tepmehatop/Lathe-cnc-controller-stm32/src/README.md

# src

Точка входа прошивки STM32 — `setup()` и `loop()` в `Core/e2/e2_core.cpp`
(основной скетч 7e2). Состав сборки задан в `platformio.ini` (`build_src_filter`).
