tepmehatop/Lathe-cnc-controller-stm32/hardware/shield/README.md

# Шилд ELS под STM32F4DISCOVERY

**Rev 2 — компактный, как Shield3.0 под Mega.** Плата 96×126 мм. Discovery вставляется сверху в гнёзда лицом
вверх (USB ST-LINK — к верхнему краю): кнопки, светодиоды и оба USB остаются видны и доступны. Мелочь — SMD 0805
и SOT-23 — под Discovery (зазор ≈ 8 мм), разъёмы — штыревые 2.54 мм с защёлкой (KF2510 / Molex KK-254) по всем
четырём краям (сверху — сброс и резервные), переключатель режимов — коробка IDC 2×5 (подписи M1…M8, как на экране). На шелкографии у мелочи — номинал
(«1k», «10k», «3904»), у разъёмов — назначение каждого вывода. Схемотехника — как у шилда автора 7e2, с поправками
на 3.3-вольтовый STM32 (см. `design.py`).

Плата, вид сверху

## Состояние

| Что | Готово |
|---|---|
| Схема KiCad (`els_shield.kicad_sch`, PDF — `els_shield_schematic.pdf`) | да, ERC — 0 ошибок |
| Список деталей (`bom.md`, `bom.csv`) | да |
| Плата: 96×126 мм, размещение, земля с двух сторон, подписи | да |
| Дорожки | да — KiCad MCP (`autoroute`, Freerouting 2.1.0, GND тоже дорожками), полигоны земли + переходы |
| Проверка | DRC — **0 нарушений, 0 неразведённых**; сверка со схемой — цепи 1:1; поштырьково — [CHECK.md](CHECK.md), 0 замечаний |
| Gerber-файлы для заказа | `els_shield_gerbers.zip` (медь, маска, шелкография с двух сторон, контур, сверловка) |

Перед заказом обязательно:
1. Сверить расстояние между гнёздами J1/J2 с вашей платой Discovery (по чертежу UM1472 — 53.34 мм между
   крайними рядами), лучше всего — распечатать слой F.Cu в масштабе 1:1 и приложить плату.
2. Проверить снизу Discovery: под ней на шилде — SMD-детали высотой до 1.5 мм (C8 1206 — до 1.8 мм).

## Как собрать и развести

Всё генерируется из `design.py` — единого описания деталей и цепей. Цепи выводов STM32 берутся из
`Core/e2/e2_pins.h`, поэтому шилд всегда совпадает с прошивкой.

1. Схема, BOM, размещение (KiCad 10, macOS: `/Applications/KiCad`): `bash hardware/shield/build.sh`.
2. Трассировка — KiCad MCP: `open_project` → `autoroute` (Freerouting 2.1.0 под Java 21; 3–5 попыток, берётся
   лучшая; если какая-то цепь осталась — `autoroute` ещё раз поверх, он доведёт только недостающее).
3. `$KPY hardware/shield/fix_zones.py` — полигоны земли с двух сторон, связность земли, дубликаты и хвосты
   дорожек, заливка (`$KPY` — Python KiCad: `/Applications/KiCad/KiCad.app/Contents/Frameworks/Python.framework/Versions/Current/bin/python3`).
4. MCP `add_gnd_stitching_vias` (сетка 6 мм) → `save_board` → `fix_zones.py` ещё раз (переходы с малым зазором
   и на выводах разъёмов — прочь).
5. `$KPY hardware/shield/widen_power.py` — дорожки +5V до 1.0 мм там, где позволяет DRC.
   Затем `$KPY hardware/shield/fix_holes.py` — у крепёжных отверстий только земля (ручная перекладка трёх дорожек,
   см. «Что проверено»); после новой трассировки координаты в нём нужно сверить заново.
6. Проверка: MCP `run_drc` (и со сверкой схемы), `$KPY hardware/shield/verify.py` → CHECK.md; файлы —
   MCP `export_gerbers` + `export_drill` в `gerbers/`, архив `els_shield_gerbers.zip`.

Размещение генерируется заново из `design.py` — после него трассировку нужно повторить.

**Разъёмы верхнего края (J24–J27) добавлены 2026-11-12 в уже разведённую плату, старая разводка не менялась:**
`$KPY add_reserve.py` (детали и подписи из `design.py`) → `$KPY route_reserve.py prep <снимок платы до добавления>`
(старые дорожки закреплены, полигоны сняты, `build/res2.dsn`) → Freerouting 2.1
(`java -jar freerouting.jar -de build/res2.dsn -do build/res2.ses -mp 100 -mt 1`) → `$KPY merge_ses.py build/res2.ses`
(в плату — только новые дорожки, без земли) → `$KPY fix_reserve.py`, `route_grid.py` + `add_path.py` (что Freerouting
не довёл), `$KPY fix_reserve2.py`, `$KPY fix_silk_top.py`. Новые цепи — класс Reserve (дорожка 0.2 мм, переход 0.6/0.3).
При полной перегенерации платы из `design.py` эти шаги нужно повторить заново.

## Что проверено и что знать при сборке

Резервные разъёмы (2026-11-12): исходные 1425 дорожек и переходов на месте (сверка по геометрии со снимком до
добавления), ни одна старая деталь не сдвинута, у старых площадок цепь появилась только у 6 ранее пустых выводов J1;
новые цепи прослежены от площадки до площадки; DRC — 0 нарушений, 0 неразведённых; ERC — 0; сверка со схемой — без
цепи только неиспользуемые выводы Discovery; CHECK.md — 0 замечаний. PD12 и PD14 не выведены: внутренний ряд P1, путь
к ним — около 150 мм с 9–10 переходами через плотную середину платы.

Проверено вручную перед заказом (2026-11-12), по первоисточникам — не по отчётам скриптов:
- Гнёзда J1/J2 — по рис. 10 UM1472: все 100 выводов P1/P2 по именам, 53.34 мм между крайними рядами, ряды выровнены,
  нечётные выводы — левый столбец, Discovery лицом вверх без зеркаления.
- Каждый вывод гнёзд → цепь → функция прошивки (e2_pins.h) и логика входов — по коду автора 7e2 (Menu.ino: шаблоны
  Mode/Submode/Joy/Buttons/Limit/Hand) и схеме ELS_V7: совпадает, включая порядок M1…M8 и подрежимов (у автора на
  схеме A13/A15 подписаны наоборот — верно по коду).
- Каждая деталь: номинал, корпус, обе площадки и куда они идут (33 подтяжки, 7 ключей с 1k/10k, 4 × 220, 100, 6 × 470,
  C1–C8, D1 — катод к Discovery). Цоколёвка MMBT3904 SOT-23: 1 Б, 2 Э, 3 К.
- Медь каждой цепи — путь от площадки до каждой другой площадки по дорожкам и переходам: все 87 цепей замкнуты,
  земля — все 50 площадок даже без полигонов. Шелкография — каждая из 87 подписей против своей площадки и цепи.
- Ключ вилки J7 — к краю платы, со стороны ряда 1-3-5-7-9; жила шлейфа N = вывод N = режим M N.
- Механика: разъёмы и вилка J7 не попадают под Discovery (она занимает x 15…81, y 11…108 мм).
- Найдено и исправлено: у отверстия H3 дорожка и переход DRO_RX были в 2.4 мм от центра (под головкой винта —
  металлическая стойка могла замкнуть линию на корпус), у H2 — LED_LEFT_K/LED_RIGHT_K в 3.3–3.9 мм (под шайбой).
  Переложены (fix_holes.py): ближайшая сигнальная медь теперь в 4.8 мм и дальше; рядом с отверстиями — только земля.

Проверено ранее (2026-11-08):
- Каждый контакт каждого разъёма: подпись на плате → медь → деталь → гнездо Discovery → вывод STM32 → функция
  прошивки ([CHECK.md](CHECK.md), из разведённой платы). Все выводы прошивки выведены, лишних нет.
- Таблица гнёзд P1/P2 — по UM1472 (табл. 5): все 81 сигнальный вывод совпадают; геометрия — по рис. 10:
  53.34 мм между крайними рядами, вывод 1 — сверху слева, нечётные — левый столбец.
- Что висит на выводах на самой Discovery (UM1472, схемы): PA4, PC7, PC10, PC12, PB6 — аудио-ЦАП (держится в
  сбросе, PD4 = 0); PC4 — к микрофону через R49, **не установлен**; PE3 — выбор акселерометра (PA5–PA7 не
  используются); PB9 — подтяжка 4.7 кОм; PA0 — кнопка USER. Мешающих нет.

Знать:
- **Питание.** Блок 5 В — на J3 «ПИТАНИЕ 5В», от 2 А (с дисплеем 10.1" — 3 А). Discovery питается от него через
  диод D1: USB ST-LINK без блока питания питает только Discovery, но не дисплей и не остальное (выводы 5V/3V
  Discovery — не больше 100 мА наружу, UM1472 п. 4.3). +3V шилда — от Discovery: подтяжки и светодиоды — до 60 мА.
- **Светодиоды упоров** — красные, жёлтые или зелёные (от 3.3 В через 220 Ом). Синие и белые светить не будут.
- **Драйверы моторов** — «+» входов на +5 В (контакты PUL+/DIR+/ENA+), «−» — на ключи. В прошивке
  `DRIVER_SIGNALS_DIRECT 0` (по умолчанию).
- **Блок DRO** — выход TTL (как у автора 7e2). Если у блока RS-232 (±12 В) — нужен преобразователь (MAX3232).
- **LCD2004 по I2C** — у модуля свои подтяжки к 5 В; работает, но лучше снять их с модуля (на Discovery есть
  свои к 3 В).
- **Отладочный порт J21:** TX (PA9) на Discovery соединён с VBUS micro-USB и конденсатором 4.7 мкФ (C49) —
  передача от STM32 на 115200 не работает, приём (PA10) работает. Для работы станка порт не нужен.
- **Пайка земли:** выводы GND разъёмов подключены к полигонам сплошь — паяльник от 40 Вт.

## Что на плате

Схемы подключения каждого разъёма (провод → клемма модуля), список покупок и порядок пайки —
[docs/assembly](../../docs/assembly/README.md).

| Разъём | Что подключать |
|---|---|
| J3 ПИТАНИЕ 5В | блок питания 5 В (от 2 А, с дисплеем 10.1" — 3 А) — питает всё; Discovery — через диод D1 |
| J4 ЭНКОДЕР | энкодер шпинделя: +5 В, GND, A, B (подтяжка 1k к 3V и 1 нФ — на плате) |
| J5 / J6 ДРАЙВЕР Z / X | входы драйверов PUL±, DIR±, ENA± (NPN-ключи 2N3904 на плате) |
| J7 РЕЖИМ | галетный переключатель 8 положений: вывод N коробки IDC 2×5 — режим M N (1 = M1 … 8 = M8), 9 и 10 — общий GND |
| J8 ПОДРЕЖИМ | Внутренний / Ручной / Наружный, общий — GND |
| J9 КНОПКИ | Влево, Вправо, Вверх, Вниз, Выбор, общий — GND |
| J10 ДЖОЙСТИК | 4 направления + ускоренный ход, общий — GND |
| J11 УПОРЫ, J12 СВЕТОДИОДЫ | кнопки упоров; светодиоды — анод на +3V, катод на клемму (220 Ом на плате) |
| J13 РГИ, J14 РГИ ПЕРЕКЛ. | маховичок (+5 В, GND, A, B; 10 нФ на плате) и переключатели оси и масштаба |
| J15 ЗУММЕР | активный зуммер 5 В: «+» на +5V, «−» на клемму «−» |
| J16 ТАХОМЕТР | выход импульса на оборот (3.3 В через 100 Ом) |
| J17 ПОДАЧА | переменный резистор 10k: крайние — +3V и GND, средний — СР |
| J18 LCD2004 | I2C-модуль LCD: GND, +5V, SDA, SCL |
| J19 ДИСПЛЕЙ | сенсорный дисплей ESP32: GND, +5V, TX (к RX дисплея), RX (к TX дисплея) |
| J20 DRO | блок DRO HS800-2: GND, RX (к TX блока) |
| J21 ОТЛАДКА | USB-UART для монитора порта: GND, TX, RX |
| J22 / J23 ЛИНЕЙКА Z / X | линейки напрямую: +5V, GND, A, B, REQ (470 Ом последовательно); схемы сопряжения — `docs/scales` |
| J24 СБРОС | кнопка сброса на панель: RST (NRST, P1-6) и GND — параллельно RESET Discovery. Не на аварийный «грибок» |
| J25 ДАТЧИК (РЕЗЕРВ) | на будущее — щуп / датчик привязки: +5V, GND, ВХ (PA2, подтяжка 1k к 3V и 10 нФ). Прошивка пока не использует |
| J26 РЕЗЕРВ ВЫХОДЫ PD13 PD15 | +5V, GND, D13, D15 — выходы 3.3 В через 220 Ом (модули реле); на Discovery — LD3, LD6 |
| J27 РЕЗЕРВ PA5 PA7 | +3V, GND, A5, A7 — вход/выход через 470 Ом (АЦП; на PA5 — ЦАП) |

Настройки прошивки под этот шилд — значения по умолчанию в `Core/els_config.h`:
`DRIVER_SIGNALS_DIRECT 0`, `BEEPER_ON_LEVEL 1`.

## Особенности

- Под гнёзда J1/J2 взято посадочное место **штыревого** разъёма 2×25: у гнезда из библиотеки KiCad ряды
  зеркальные (вывод 2 слева от вывода 1), а Discovery вставляется лицом вверх, и её вывод 2 справа.
  Паяется обычное гнездо 2×25.
- Вывод PD4 (сброс аудиочипа платы) наружу не выводится. PA2 — вход датчика J25: блок DRO читается только на
  приём, прошивка после запуска USART2 возвращает PA2 во вход (`Drivers/drv_dro.cpp`).
- Синяя кнопка USER на Discovery сидит на том же PA0, что «Упор задний», но упор она не ставит: USER подаёт на
  PA0 «1» (через 330 Ом к 3 В), а кнопка упора срабатывает от «0». Нажатие USER ничего не делает и ничему не мешает.
