tepmehatop/Lathe-cnc-controller-stm32/hardware/shield/CHECK.md

# Проверка шилда по контактам

Сгенерировано `verify.py` из разведённой платы `els_shield.kicad_pcb`: подпись — текст шелкографии у контакта,
путь — по меди через детали шилда, вывод Discovery — по таблице UM1472 (табл. 5, рис. 10).

**Замечаний: 0**

## Разъёмы

| Разъём | Конт. | Подпись | Цепь | Через | Discovery | STM32 | Прошивка |
|---|---|---|---|---|---|---|---|
| J3 ПИТАНИЕ 5В | 1 | +5V | +5V | питание / земля |  |  |  |
|  | 2 | GND | GND | питание / земля |  |  |  |
| J4 ЭНКОДЕР | 1 | +5V | +5V | питание / земля |  |  |  |
|  | 2 | GND | GND | питание / земля |  |  |  |
|  | 3 | A | ENC_A | напрямую | P1-11 | PA1 | ENC_A: (21, INT0 + T5/47) канал A — прерывание по обоим фронтам |
|  | 4 | B | ENC_B | напрямую | P2-43 | PA8 | ENC_B: (20) канал B |
| J5 ДРАЙВЕР Z | 1 | PUL+ | +5V | питание / земля |  |  |  |
|  | 2 | PUL- | Z_PUL_N | Q1 (3904) → R2 (1k) | P1-27 | PE9 | Z_STEP: (49) |
|  | 3 | DIR+ | +5V | питание / земля |  |  |  |
|  | 4 | DIR- | Z_DIR_N | Q2 (3904) → R4 (1k) | P1-28 | PE10 | Z_DIR: (43) |
|  | 5 | ENA+ | +5V | питание / земля |  |  |  |
|  | 6 | ENA- | Z_ENA_N | Q3 (3904) → R6 (1k) | P1-29 | PE11 | Z_ENA: (45) |
| J6 ДРАЙВЕР X | 1 | PUL+ | +5V | питание / земля |  |  |  |
|  | 2 | PUL- | X_PUL_N | Q4 (3904) → R8 (1k) | P1-31 | PE13 | X_STEP: (48) |
|  | 3 | DIR+ | +5V | питание / земля |  |  |  |
|  | 4 | DIR- | X_DIR_N | Q5 (3904) → R10 (1k) | P1-32 | PE14 | X_DIR: (44) |
|  | 5 | ENA+ | +5V | питание / земля |  |  |  |
|  | 6 | ENA- | X_ENA_N | Q6 (3904) → R12 (1k) | P1-33 | PE15 | X_ENA: (46) |
| J7 РЕЖИМ | 1 | M1 | MODE_FEED | напрямую | P2-36 | PD0 | MODE_FEED: (30) Синхронная подача |
|  | 2 | M2 | MODE_AFEED | напрямую | P2-33 | PD1 | MODE_AFEED: (31) Асинхронная подача |
|  | 3 | M3 | MODE_THREAD | напрямую | P2-30 | PD6 | MODE_THREAD: (34) Резьба |
|  | 4 | M4 | MODE_CONE_L | напрямую | P2-34 | PD2 | MODE_CONE_L: (32) Конус < |
|  | 5 | M5 | MODE_CONE_R | напрямую | P2-31 | PD3 | MODE_CONE_R: (33) Конус > |
|  | 6 | M6 | MODE_SPHERE | напрямую | P2-27 | PD7 | MODE_SPHERE: (35) Шар |
|  | 7 | M7 | MODE_DIVIDER | напрямую | P1-42 | PD10 | MODE_DIVIDER: (36) Делилка |
|  | 8 | M8 | MODE_RESERVE | напрямую | P1-43 | PD11 | MODE_RESERVE: (37) Резерв |
|  | 9 | GND | GND | питание / земля |  |  |  |
|  | 10 | GND | GND | питание / земля |  |  |  |
| J8 ПОДРЕЖИМ | 1 | ВНУТ | SUB_INT | напрямую | P2-45 | PC8 | SUB_INT: (A13) Внутренний |
|  | 2 | РУЧ | SUB_MAN | напрямую | P2-46 | PC9 | SUB_MAN: (A14) Ручной |
|  | 3 | НАР | SUB_EXT | напрямую | P2-38 | PC11 | SUB_EXT: (A15) Наружный |
|  | 4 | GND | GND | питание / земля |  |  |  |
| J9 КНОПКИ | 1 | ЛЕВ | BTN_LEFT | напрямую | P1-37 | PB13 | BTN_LEFT: (A0) |
|  | 2 | ПРАВ | BTN_RIGHT | напрямую | P1-38 | PB14 | BTN_RIGHT: (A1) |
|  | 3 | ВВЕРХ | BTN_UP | напрямую | P1-36 | PB12 | BTN_UP: (A2) |
|  | 4 | ВНИЗ | BTN_DOWN | напрямую | P1-41 | PD9 | BTN_DOWN: (A3) |
|  | 5 | ВЫБ | BTN_SELECT | напрямую | P1-39 | PB15 | BTN_SELECT: (A4) |
|  | 6 | GND | GND | питание / земля |  |  |  |
| J10 ДЖОЙСТИК | 1 | ЛЕВ | JOY_LEFT | напрямую | P1-22 | PB0 | JOY_LEFT: (A8) |
|  | 2 | ПРАВ | JOY_RIGHT | напрямую | P1-21 | PB1 | JOY_RIGHT: (A9) |
|  | 3 | ВВЕРХ | JOY_UP | напрямую | P2-16 | PE3 | JOY_UP: (A10) не PB2: это BOOT1, на плате стянут к GND — читался «нажат» |
|  | 4 | ВНИЗ | JOY_DOWN | напрямую | P2-20 | PB9 | JOY_DOWN: (A11) на плате подтяжка 4.7 кОм к 3.3 В — не мешает |
|  | 5 | БЫСТР | JOY_RAPID | напрямую | P2-19 | PB8 | JOY_RAPID: (A12) кнопка ускоренного хода |
|  | 6 | GND | GND | питание / земля |  |  |  |
| J11 УПОРЫ | 1 | ЛЕВ | LIM_LEFT | напрямую | P1-19 | PC5 | LIM_LEFT: (28) |
|  | 2 | ПРАВ | LIM_RIGHT | напрямую | P1-20 | PC4 | LIM_RIGHT: (26) |
|  | 3 | ПЕРЕД | LIM_FRONT | напрямую | P1-10 | PC2 | LIM_FRONT: (24) |
|  | 4 | ЗАД | LIM_REAR | напрямую | P1-12 | PA0 | LIM_REAR: (22) на плате — кнопка USER с RC-фильтром: для кнопки упора годится |
|  | 5 | GND | GND | питание / земля |  |  |  |
| J12 СВЕТОДИОДЫ | 1 | +3V | +3V | питание / земля |  |  |  |
|  | 2 | ЛЕВ | LED_LEFT_K | R16 (220) | P2-11 | PE6 | LED_LEFT: (29) светодиод горит при низком уровне |
|  | 3 | ПРАВ | LED_RIGHT_K | R17 (220) | P2-14 | PE5 | LED_RIGHT: (27) |
|  | 4 | ПЕРЕД | LED_FRONT_K | R18 (220) | P2-13 | PE4 | LED_FRONT: (25) |
|  | 5 | ЗАД | LED_REAR_K | R19 (220) | P2-15 | PE2 | LED_REAR: (23) |
| J13 РГИ | 1 | +5V | +5V | питание / земля |  |  |  |
|  | 2 | GND | GND | питание / земля |  |  |  |
|  | 3 | A | HAND_A | напрямую | P1-25 | PE7 | HAND_A: (19, INT2) канал A — прерывание по обоим фронтам |
|  | 4 | B | HAND_B | напрямую | P2-12 | PC13 | HAND_B: (18) канал B |
| J14 РГИ ПЕРЕКЛ. | 1 | Z | HAND_AXIS_Z | напрямую | P2-37 | PC10 | HAND_AXIS_Z: (2)  переключатель оси РГИ: Z |
|  | 2 | X | HAND_AXIS_X | напрямую | P2-35 | PC12 | HAND_AXIS_X: (3)  переключатель оси РГИ: X |
|  | 3 | x1 | HAND_X1 | напрямую | P1-16 | PA4 | HAND_X1: (14) масштаб x1 |
|  | 4 | x10 | HAND_X10 | напрямую | P1-40 | PD8 | HAND_X10: (15) масштаб x10 |
|  | 5 | GND | GND | питание / земля |  |  |  |
| J15 ЗУММЕР | 1 | +5V | +5V | питание / земля |  |  |  |
|  | 2 | - | BEEP_N | Q7 (3904) → R14 (1k) | P1-30 | PE12 | BEEPER: (16) зуммер; уровень звука — BEEPER_ON_LEVEL (на шилде NPN-ключ: звук при 1) |
| J16 ТАХОМЕТР | 1 | +5V | +5V | питание / земля |  |  |  |
|  | 2 | GND | GND | питание / земля |  |  |  |
|  | 3 | ИМП | TACHO_OUT | R20 (100) | P1-26 | PE8 | TACHO: (42) импульс на оборот шпинделя |
| J17 ПОДАЧА | 1 | +3V | +3V | питание / земля |  |  |  |
|  | 2 | СР | FEED_POT | напрямую | P1-7 | PC1 | FEED_POT: (A7) ADC123_IN11 |
|  | 3 | GND | GND | питание / земля |  |  |  |
| J18 LCD2004 | 1 | GND | GND | питание / земля |  |  |  |
|  | 2 | +5V | +5V | питание / земля |  |  |  |
|  | 3 | SDA | LCD_SDA | напрямую | P2-24 | PB7 | LCD_SDA: I2C1 SDA |
|  | 4 | SCL | LCD_SCL | напрямую | P2-23 | PB6 | LCD_SCL: I2C1 SCL — LCD2004 по I2C (запасной дисплей) |
| J19 ДИСПЛЕЙ | 1 | GND | GND | питание / земля |  |  |  |
|  | 2 | +5V | +5V | питание / земля |  |  |  |
|  | 3 | TX | DISP_TX | напрямую | P1-34 | PB10 | DISP_TX: USART3 TX → дисплей ESP32 (RX) |
|  | 4 | RX | DISP_RX | напрямую | P1-35 | PB11 | DISP_RX: USART3 RX ← дисплей ESP32 (TX) |
| J20 DRO | 1 | GND | GND | питание / земля |  |  |  |
|  | 2 | RX | DRO_RX | напрямую | P1-13 | PA3 | DRO_RX: USART2 RX ← блок DRO HS800-2 (TX) |
| J21 ОТЛАДКА | 1 | GND | GND | питание / земля |  |  |  |
|  | 2 | TX | DBG_TX | напрямую | P2-44 | PA9 | DBG_TX: USART1 TX — отладочный порт (Serial) |
|  | 3 | RX | DBG_RX | напрямую | P2-41 | PA10 | DBG_RX: USART1 RX |
| J22 ЛИНЕЙКА Z | 1 | +5V | +5V | питание / земля |  |  |  |
|  | 2 | GND | GND | питание / земля |  |  |  |
|  | 3 | A | SCALE_Z_A_T | R21 (470) | P2-40 | PA15 | SCALE_Z_A: линейка напрямую (els_config.h) |
|  | 4 | B | SCALE_Z_B_T | R22 (470) | P2-28 | PB3 | SCALE_Z_B: линейка напрямую (els_config.h) |
|  | 5 | REQ | SCALE_Z_REQ_T | R23 (470) | P2-47 | PC6 | SCALE_Z_REQ: линейка напрямую (els_config.h) |
| J23 ЛИНЕЙКА X | 1 | +5V | +5V | питание / земля |  |  |  |
|  | 2 | GND | GND | питание / земля |  |  |  |
|  | 3 | A | SCALE_X_A_T | R24 (470) | P2-25 | PB4 | SCALE_X_A: линейка напрямую (els_config.h) |
|  | 4 | B | SCALE_X_B_T | R25 (470) | P2-26 | PB5 | SCALE_X_B: линейка напрямую (els_config.h) |
|  | 5 | REQ | SCALE_X_REQ_T | R26 (470) | P2-48 | PC7 | SCALE_X_REQ: линейка напрямую (els_config.h) |
| J24 СБРОС | 1 | RST | NRST | напрямую | P1-6 | NRST | сброс платы (кнопка на панель, параллельно RESET Discovery) |
|  | 2 | GND | GND | питание / земля |  |  |  |
| J25 ДАТЧИК (РЕЗЕРВ) | 1 | +5V | +5V | питание / земля |  |  |  |
|  | 2 | GND | GND | питание / земля |  |  |  |
|  | 3 | ВХ | PROBE | напрямую | P1-14 | PA2 | PROBE: J25 «ДАТЧИК (РЕЗЕРВ)»: щуп / датчик привязки, подтяжка 1k к 3V. |
| J26 РЕЗЕРВ ВЫХОДЫ PD13 PD15 | 1 | +5V | +5V | питание / земля |  |  |  |
|  | 2 | GND | GND | питание / земля |  |  |  |
|  | 3 | D13 | RES_OUT2_T | R28 (220) | P1-45 | PD13 | RES_OUT2: J26 «РЕЗЕРВ ВЫХОДЫ» D13 через 220 Ом; на Discovery — LD3 оранжевый (TIM4 CH2 — ШИМ) |
|  | 4 | D15 | RES_OUT4_T | R30 (220) | P1-47 | PD15 | RES_OUT4: J26 D15 через 220 Ом; на Discovery — LD6 синий (TIM4 CH4 — ШИМ) |
| J27 РЕЗЕРВ PA5 PA7 | 1 | +3V | +3V | питание / земля |  |  |  |
|  | 2 | GND | GND | питание / земля |  |  |  |
|  | 3 | A5 | RES_IO1_T | R31 (470) | P1-15 | PA5 | RES_IO1: J27 «РЕЗЕРВ ВХ/ВЫХ» через 470 Ом; АЦП, ЦАП2; на плате — SCK акселерометра |
|  | 4 | A7 | RES_IO2_T | R32 (470) | P1-17 | PA7 | RES_IO2: ... АЦП; на плате — MOSI акселерометра (оба — входы акселерометра, не мешают) |

## Питание

| Цепь | Дорожек | Ширина мин–макс, мм | Подключено |
|---|---|---|---|
| GND | 136 | 0.60–0.60 | C1, C2, C3, C4, C5, C6, C7, C8, C9, J1, J2, J3, J4, J7, J8, J9, J10, J11, J13, J14, J16, J17, J18, J19, J20, J21, J22, J23, J24, J25, J26, J27, Q1, Q2, Q3, Q4, Q5, Q6, Q7, R3, R5, R7, R9, R11, R13, R15 |
| +5V | 70 | 0.60–1.00 | C6, C8, D1, J3, J4, J5, J6, J13, J15, J16, J18, J19, J22, J23, J25, J26 |
| +3V | 115 | 0.60–0.60 | C7, J2, J12, J17, J27, R101, R102, R103, R104, R105, R106, R107, R108, R109, R110, R111, R112, R113, R114, R115, R116, R117, R118, R119, R120, R121, R122, R123, R124, R125, R126, R127, R128, R129, R130, R131, R132, R133, R134 |
| +5V_DISCO | 3 | 0.60–1.00 | D1, J2 |
