tepmehatop/Lathe-cnc-controller-stm32/BACKLOG.md

# Беклог — ELS STM32 7e2 V4.0

Список запланированных функций и задач, не вошедших в текущую миграцию.

---

## [BACKLOG-001] GCode: Токарный станок как ЧПУ через WiFi — СДЕЛАНО на новом ядре (2026-11-07)
**Сделано:** исполнитель на STM32 (`Core/e2/e2_gcode.inc`): режим M8 «G-КОД», G0/G1/G2/G3(I K / R)/G7/G8/G20/G21/
G28/G90/G91/G94; X — диаметр по умолчанию; координаты — экранные (нули оператора), цели — по шагам от опорной
точки; X и Z одновременно (Брезенхэм), разгон/торможение, компенсация люфта, упоры, стоп — джойстик или <GCODE:STOP>.
Дисплей: M8 — «G-КОД» (строка, процент, позиции), ожидание ответа 10 мин, «Стоп» шлёт STOP. Пользователю —
docs/GCODE.md. Симуляция test_gcode; стенд tools/gcode_hil.py — G0/G1/G91/G2/G3/G28 в цель до микрона, стоп.
По ходу найдено: окно приёма СТОП было из нулей (короткая команда не находилась); направление линейки портилось
скачком DRO на стоящей оси (ложное «не совпадает», стало вечным) — исправлено.
2026-11-07: G98/G99/G95 (подача на оборот — по оборотам), G50 S/G96/G97, O-номер; страница обращалась на :8080 —
исправлено; «G-КОД» на экране — квадратики (шрифт основного поля без кириллицы) — исправлено. Стенд: файл владельца
history.nc через Wi-Fi целиком (загрузка, старт, 15 строк) — каретка точно в последнем кадре. Примеры — gcode_sample/.
2026-11-08: опорная точка заново в начале каждой программы («%») и при смене режима — все расширения подряд
OK; ошибка на экране — окно по размеру текста, висит до OK; ячейка «ВЫПОЛНЕНО» (процент / номер строки ошибки).
2026-11-08: циклы G71/G70 (разворачивает дисплей, gcode_cycles.cpp), G28 U0 W0 — на месте, U/W — приращения;
шахматная пешка (pawn.nc, pawn_g71.nc) — стенд «Готово», каретка в точке старта; страница рисует все проходы.
Не сделано: G32/G76 (резьба), компенсация радиуса резца; визуализация на экране дисплея и подсказка резцов — идея
владельца (веб-страница уже рисует траекторию с курсором строки).

**Приоритет:** Высокий  
**Компонент:** ESP32-S3 (JC4827W543) + STM32F407

### Описание

Реализовать работу токарного станка с GCode-программами по аналогии с 3D-принтером.
Пользователь с компьютера в локальной сети заходит на веб-страницу ESP32, управляет файлами GCode и запускает резку.

### Ссылки для изучения

- Пример реализации (WiFi + веб-интерфейс + GCode): https://github.com/kachurovskiy/nanoels/blob/main/h5/h5.ino
- Генератор GCode для токарного станка: https://github.com/kachurovskiy/lathecode

### Что нужно изучить в nanoels/h5.ino

1. Подключение к WiFi (STA режим, точка доступа или клиент)
2. Веб-сервер внутри ESP32 — локальная страница в браузере
3. Файловая система (SPIFFS/LittleFS) для хранения GCode файлов
4. Парсер GCode (G0/G1 линейное перемещение, G2/G3 дуга, M-команды)
5. Как ESP32 передаёт команды движения в основной контроллер

### Требования к веб-интерфейсу (ESP32 HTTP-сервер)

- **Список файлов** — отображение всех загруженных `.gcode` файлов
- **Загрузка** — upload файла с компьютера (multipart POST)
- **Просмотр** — отображение содержимого GCode в браузере
- **Редактирование** — встроенный текстовый редактор GCode
- **Визуализация** — 2D-траектория резца (SVG или Canvas)
- **Удаление** — удаление файла
- **Запуск** — старт выполнения GCode программы
- **Стоп/Пауза** — аварийная остановка

### Требования к выполнению GCode (ESP32 → STM32)

- ESP32 парсит GCode построчно
- Каждая строка преобразуется в команду перемещения (ось X/Y, скорость)
- Команда передаётся в STM32 по UART (USART3, протокол `<CMD:value>`)
- STM32 выполняет перемещение через шаговые двигатели
- ESP32 ждёт подтверждения (`<OK>`) перед следующей строкой
- Учёт нуля (G54 Work Coordinate System) — пользователь задаёт нулевую точку

### Поддерживаемые GCode команды (минимум)

| Команда | Описание |
|---|---|
| G0 Xn Zn | Быстрое перемещение |
| G1 Xn Zn Fn | Рабочая подача |
| G4 Pn | Пауза (мс) |
| G28 | Переход в домашнюю позицию |
| M0 | Программная остановка |
| M2/M30 | Конец программы |

### Расширение протокола ESP32 ↔ STM32

Новые команды для STM32 (дополнение к существующему протоколу):

```
<GCODE:G1 X10.5 Z-25.0 F100>   — выполнить строку GCode
<GCODE_STOP>                    — аварийная остановка
<GCODE_PAUSE>                   — пауза
<GCODE_RESUME>                  — продолжить
```

Новые ответы STM32 → ESP32:
```
<OK>           — строка выполнена, готов к следующей
<ERR:reason>   — ошибка выполнения
<POS:x,z>      — текущая позиция (периодически)
```

### Этапы реализации

1. **ESP32:** Изучить h5.ino — WiFi + AsyncWebServer + SPIFFS
2. **ESP32:** Файловый менеджер GCode (upload/list/delete/view)
3. **ESP32:** Парсер GCode (G0, G1, G4, M0, M2, M30)
4. **ESP32:** Веб-визуализатор траектории (Canvas 2D)
5. **STM32:** Обработка команды `<GCODE:...>` в drv_display.cpp
6. **STM32:** Прямое управление степперами из GCode (минуя ELS логику)
7. **Интеграция:** Handshake OK/ERR между ESP32 и STM32
8. **Тест:** Простая программа (проточка цилиндра) от начала до конца

### Зависимости

- Завершение миграции STM32 (этапы 1-9 из MIGRATION_PLAN.md)
- Протокол ESP32↔STM32 (этап 23-24 из MIGRATION_PLAN.md)
- WiFi SSID/пароль — хранить в SPIFFS (config.json), настройка через AP-mode при первом запуске

---

*Добавлено: 2026-04-10*

---

# Дорожная карта: дисплеи, DRO, конфигурация сборки

*Добавлено: 2026-10-26*

## [BACKLOG-010] Поддержка трёх дисплеев

**Приоритет:** Высокий
**Компонент:** ESP32 (прошивки дисплеев) + STM32 (конфиг)

Итоговая система должна работать с тремя вариантами дисплея с **одинаковым функционалом**
(разная только раскладка/масштаб UI):

| Дисплей | Размер | Модуль | Статус |
|---|---|---|---|
| JC4827W543 (ESP32-S3) | 4.3" 480×272 | есть | работает, нужны доработки ([BACKLOG-012]) |
| JC8012P4A1C (ESP32-P4) | 10.1" 1280×800 | есть | **в работе** ([BACKLOG-011]) |
| 7" (модель не выбрана) | 7" | нет на руках | **не делаем**, только закладываем архитектуру |

- Общий код UI/UART/GCode/WiFi — один (`ELS_Display/src/`), дисплей-специфичное — в драйверах и
  в описании раскладки (layout) под каждое разрешение.
- Архитектура должна позволять добавить 7" новым env в `platformio.ini` + layout-файлом,
  без правок общего кода.

## [BACKLOG-011] 10.1" JC8012P4A1C — довести до рабочего состояния (ТЕКУЩАЯ ЗАДАЧА)

**Приоритет:** Наивысший
**Ветка:** `feat/jc8012p4a1c`

Сделано: MIPI-DSI (JD9365) + тач GSL3680, нативный LVGL 1280×800 с поворотом CCW в flush,
подсветка PWM, скриншот по USB CDC, WiFi-инфо по тапу.

Сделано 2026-10-31 (подробно — history.md):
- [x] Пропорциональный UI 1280×800 (UX/UY/US + шрифты ×8/3), все экраны/оверлеи/барабаны
- [x] UART до STM32 — CN2 = GPIO38/37, данные идут
- [x] Скорость: частичная перерисовка, 10–40 мс на кадр (было ~860 мс)
- [x] Зависание: память LVGL в PSRAM; WiFi/HTTP в отдельной задаче (не блокирует UI)
- [x] Прогоны: run_all_tests (326), TEST_CASES.md (215), UI-сценарии касаниями — со скриншотами

Осталось:
- [~] WiFi через ESP32-C6: слейв esp_hosted 2.1.10 (C6) vs хост 2.12.3 (P4) — первая попытка STA после старта почти всегда
      «пустая»; обход 2026-11-07: поиск сетей перед подключением и повтор через 10 с — 5/5 перезагрузок подключается (26 с).
      Обновить C6 до версии под хост (2.12.x) через esp_hosted_slave_ota — владелец разрешил; отдельной задачей, с откатом
      2026-11-08: владелец — обновление C6 и проверку Wi-Fi 4.3" (5 перезагрузок) отложить в самый конец.
- [~] Точность тача по всей площади экрана (углы, края) — проверить пальцем. 2026-11-12: экран проверки
      `<TOUCHTEST:1>` по USB — 9 мишеней, каждое касание: промах dx/dy в пикселях и «сырые» координаты драйвера
      в лог ([TOUCHTEST]). Ждём касаний владельца; по промахам — поправка в my_touchpad_read, если нужна.
- [~] Отдельная раскладка под большой экран (больше информации). 2026-11-12, первый шаг: на 10.1" и 7" в M1/M2
      (подэкран 1) на свободной плитке — «УПОРЫ»: координаты упоров Z и X (запоминаются в момент установки) и длина
      между упорами Z. Что ещё показывать на большом экране — решение владельца.
- [ ] Обновить устаревшие ожидания в TEST_CASES.md (M8 → «РЕЗЕРВ», «К-ТРУБ» латиницей,
      «8/?», поле `pass` → `row4_val`); дописать команды в 14 кейсов без ввода
      (TC-053, 183, 192–201, 205, 215); предусловия текстом → команды
- [x] AFEED/afeed_mm int16 → при >32767 показывался −32768: на дисплее поле int32 (2026-11-12)
- [ ] Регресс на реальном 4.3" (подключить, прогнать те же раннеры)

## [BACKLOG-012] 4.3" JC4827W543 — доработки

**Приоритет:** Средний (после 10.1")

- [ ] Собрать список текущих недочётов на 4.3" (уточнить у пользователя / по скриншотам)
- [ ] Регресс-проверка 4.3" после каждой правки общего кода UI под 10.1"

## [BACKLOG-013] Выбор дисплея в конфиге STM32 + варианты прошивки дисплея — СДЕЛАНО (2026-11-01)

- [x] `ELS_DISPLAY_TYPE` в `Core/els_config.h`: `DISPLAY_TYPE_NONE` / `_4_3` / `_10_1`
      (`_7_0` зарезервирован, при выборе — ошибка сборки)
- [x] Прошивка дисплея — свой env на размер: `jc4827w543`, `jc8012p4a1c`
- [x] Дисплей при старте шлёт `<DISP:43|101>`, STM32 при включении шлёт `<PING>`;
      при несовпадении — строка в отладочный порт и алерт на дисплее
- [ ] 7" — когда появится дисплей: env + шрифты (масштабирование UI уже универсальное)

## [BACKLOG-014] Источник координат: блок DRO / линейки напрямую / шаги мотора

Документация для пользователей: `docs/scales/README.md` (типы линеек, схемы, настройка).

Сделано (2026-11-01):
- [x] `ELS_POS_SOURCE`: `POS_SOURCE_DRO_UART` / `POS_SOURCE_SCALES` / `POS_SOURCE_STEPS`
      (режим «по шагам» раньше только заявлялся — давал 0)
- [x] Линейки по осям (`SCALE_Z_*`, `SCALE_X_*`): квадратура TTL/RS-422 (стекло, магнит) —
      аппаратно TIM2/TIM3; Sylvac 48 бит, BIN6, iGaging 21 бит, Mitutoyo Digimatic;
      ось без линейки — по шагам мотора
- [x] Разбор протоколов — `Drivers/scale_protocols.*`, юнит-тесты на ПК (`tools/run_unit_tests.sh`)
- [x] Схемы сопряжения (SVG) для каждого типа, распиновка PA15/PB3, PB4/PB5, PE4/PE5
- [x] Симулятор Mega эмулирует все типы линеек (команды по USB), HIL-тест `tools/scales_hil_test.py`
- [x] Матрица сборок всех вариантов конфига — `tools/build_matrix.sh`
- [x] Команда `SCALES` в отладочном порту — диагностика для отчётов с форума

Осталось:
- [ ] Проверить квадратуру на реальной магнитной линейке (у автора)
- [ ] HIL квадратуры/протоколов на симуляторе — нужна проводка Mega → STM32 (см. шапку симулятора)
- [ ] Ёмкостные 1.5 В: схема с «+» на корпусе — проверка сообществом
- [ ] Разные разрешения: 1 мкм и 10 мкм проверить на линейках пользователей

## [BACKLOG-015] Физические кнопки дублируют тачскрин — ТАБЛИЦА И ДУБЛИ СДЕЛАНЫ (2026-11-07)
`docs/CONTROLS.md` — что делается на экране и чем на станке. Добавлены дубли: категория резьбы — ▲/▼ с кнопкой
ускоренного хода (e2_thread_cat_step); ввод диаметра ◀/▶ в «Ввод * Сброс осей» — теперь и при линейках напрямую
(e2_diam_from_keys). Ноль осей — «Сброс» автора (работает при любом источнике с 2026-11-06). Без физического
аналога (решение): ввод числа в ось Y/X (у 7e2 нет ввода чисел) и раздел НАСТРОЙКИ (разовая настройка).
Симуляция: test_physical_dupes.

**Приоритет:** Высокий (постоянное требование)

Физические кнопки, джойстик, переключатели режимов/подрежимов и ручной энкодер остаются.
Каждое действие на тачскрине должно иметь физический аналог, и наоборот; состояние
синхронизируется в обе стороны (кнопка на станке → обновление экрана, тап → STM32).

- [x] Таблица соответствия «кнопка тачскрина ↔ физическая кнопка» для всех экранов — docs/CONTROLS.md
- [x] THR_CAT (смена категории резьбы) реализован на STM32 для тача — нужен физический аналог: ▲ ▼ с кнопкой ускоренного хода
- [x] Проверить на 10.1" и 4.3", что новые экранные элементы не появились без физического дубля (новые с 2026-11-08 —
      только отображение: ОСТАЛОСЬ, подсказка о нуле). Ввод ⌀ в G-КОД — только с экрана: подэкрана «Ввод * Сброс
      осей» в M8 нет; кнопками ноль ставится в другом режиме, он общий

## [BACKLOG-016] Защита персональных данных в репозитории

**Приоритет:** Постоянное правило

- Перед каждым коммитом: `tools/check_pii.sh` (staged-файлы, бинарники, прошивки, скрытые файлы)
- `wifi_config.h`, `CLAUDE.md`, `.claude/`, результаты тестов со скриншотами — в `.gitignore`;
  для WiFi — шаблон `ELS_Display/include/wifi_config.example.h`
- [x] **Закрыто владельцем (2026-11-06): не делаем.** В истории git остались ранее закоммиченные `wifi_config.h` (SSID/пароли) и
      `CLAUDE.md` (локальный путь). Нужна очистка истории (`git filter-repo`) + force-push —
      только с подтверждения владельца. Пароль WiFi сменить.

---

## [BACKLOG-017] Ядро 7e2 дословно на STM32 — СДЕЛАНО в коде (2026-11-02), ждёт проверки на железе
- Прежний порт был упрощённой переделкой (см. `docs/PORT_AUDIT.md`); ядро 7e2 перенесено дословно,
  аппаратный слой `Core/e2/e2_hal.*`, симуляция `tools/run_e2_sim.sh` (172 проверки).
- Осталось: прошить и проверить на плате (тесты дисплея `run_all_tests.py`, `run_test_cases.py`,
  `ui_tap_tests.py`, HIL с эмулятором), добавить в эмулятор Mega энкодер шпинделя для HIL резьб и подач.
- Решить: исправлять ли недобор синхронной подачи у 7e2 (6–10 %, `PORT_AUDIT.md` п. 6).
- GCode с дисплея на новом ядре не исполняется (ответ «не поддерживается») — переделать (BACKLOG-001).

## [BACKLOG-018] Документация по сборке и подключению — СДЕЛАНО (2026-11-02)
- `docs/index.html` (наглядно) и `docs/README.md` (кратко), схемы по блокам, карта разъёмов, макетка,
  эмулятор; генераторы `tools/docs_gen/`.

## [BACKLOG-019] Шилд под Discovery (KiCad) — rev 2 РАЗВЕДЁН (2026-11-08), ждёт примерки и заказа
2026-11-08: rev 2 по образцу Shield3.0 владельца — 96×126 мм, Discovery сверху, SMD 0805/SOT-23 под ней, разъёмы
KF2510 по краям, IDC под режимы; трассировка KiCad MCP + Freerouting 2.1.0; DRC 0, сверка со схемой 1:1; Gerber —
hardware/shield/els_shield_gerbers.zip. Перед заказом: распечатать F.Cu 1:1 и приложить Discovery.
- Сейчас в `hardware/shield/`: схема (ERC 0), BOM, черновое размещение 180×146 мм — **слишком большое**.
- Требование владельца: шилд компактный; схему и разводку делать в KiCad через MCP-сервер
  https://github.com/mixelpixx/KiCAD-MCP-Server (подключить, затем схема → размещение → трассировка).
- Freerouting не использовать (пробный запуск 2026-11-02 упал без результата).
- Перед заказом: DRC 0, 0 непроведённых, проверка ориентации клеммников по 3D, примерка гнёзд 1:1, Gerber.

## [BACKLOG-020] Синхронная подача в 7e2 на 6–10 % меньше заданной — ИСПРАВЛЕНО (2026-11-06)
**Решение владельца:** исправить. `FEED_EXACT 1` (els_config.h): из делителя вычитается лишний период таймера
(Feed.ino, Cone.ino). Симуляция: 0.25 мм/об — 100.000 шагов/об (было 90), 0.10 — 39.17 из 40 (округление
целого периода, было 37.5); матрица автоциклов 443/443. `FEED_EXACT 0` — как у автора.
**Что это.** В режиме «Синхронная подача» мотор каретки делает шаг через определённое число
импульсов энкодера шпинделя. Автор вычисляет это число как `Feed_Divisor = 1800 / (шагов на мм × подача) / 2 + 0.5`
(округление), а таймер Mega срабатывает не через `Feed_Divisor`, а через `Feed_Divisor + 1` импульсов
(так устроен режим CTC: счёт от 0 до значения включительно). Лишний импульс в каждом периоде делает
шаги реже, чем задано.

**Насколько.** При винте 2 мм, 800 шагов/об, энкодере 1800 линий:
| Задано, мм/об | Фактически, мм/об | Разница |
|---|---|---|
| 0.10 | 0.094 | −6 % |
| 0.20 | 0.18 | −10 % |
| 0.25 | 0.225 | −10 % |
Мелкие подачи страдают меньше, крупные — больше (там делитель маленький, и +1 весомее).

**На что влияет.** Только на скорость синхронной подачи (сколько мм проходит резец за оборот) — то есть
на шероховатость и время прохода. На размер детали **не влияет**: где остановиться, решают упоры и
координаты. На **резьбу не влияет** — резьба считается другим, точным способом (проверено симуляцией).
Асинхронная подача и ускоренные ходы считаются точно.

**Варианты.** а) оставить как у автора (так работает и Mega); б) исправить одной строкой
(`OCR5A = Feed_Divisor − 1` или формулу без «+1 периода») — подача станет равна заданной.
Перенос сейчас сделан «как у автора». Решение — за владельцем.

## [BACKLOG-021] Механика станка в конфиге — НЕ РЕШЕНО (решим при установке на станок)
- Сейчас в `Core/els_config.h` значения автора 7e2: энкодер 1800 линий, винт Z 2 мм, винт X 1 мм,
  200 шагов × микрошаг 4, синхронная подача 0.01–0.25 мм/об, асинхронная 10–400 мм/мин.
- В старом порту STM32 было иначе: винт X 1.25 мм, подача 0.05–2.00 мм/об и др. (`docs/PORT_AUDIT.md` п. 7).
- Сейчас сборка на столе без станка — значения не важны. При установке на станок: вписать реальные
  винты, микрошаг, энкодер; при другой механике пересчитать таблицы резьб/конусов
  (`python3 tools/gen_e2_tables.py --write`, прошивка сама напомнит).

## [BACKLOG-022] Упоры ставятся только при физическом переключателе подрежима в «Ручной» — СДЕЛАНО (2026-11-05)
**Решение владельца:** проверять выбранный подрежим. `LIMITS_BY_SELECTED_SUBMODE 1` (els_config.h): кнопка упора
работает, если «Ручной» на переключателе ИЛИ выбран на экране; во «Внутр./Наруж.» упор по-прежнему не
переставить. `0` — как у автора. Проверка в симуляции: test_limit_no_switch.

**Что это.** В прошивке 7e2 кнопка упора (Левый/Правый/Передний/Задний) срабатывает, только если
**физический** переключатель подрежимов стоит в положении «Ручной». Прошивка проверяет не выбранный
подрежим, а напряжение на трёх проводах переключателя: должно быть «Внутренний = 1, Ручной = 0,
Наружный = 1» (`Submode_Read == B10100000` в Menu.ino). Задумка автора — нельзя переставить упор,
пока станок в автоцикле.

**Почему это важно.** Если переключателя подрежимов нет (стенд на столе, управление только с экрана),
все три провода «висят» на подтяжке → «1, 1, 1» — прошивка считает, что переключатель не в «Ручном»,
и **упоры не ставятся вообще**: ни кнопками, ни с экрана (команды EMUL:STOP_* вызывают ту же функцию).
Подрежим, выбранный на экране, тут не помогает.

**Обход сейчас.** Соединить вывод «Ручной» (PC9) с GND — прошивка «увидит» переключатель в «Ручном».
При этом с экрана подрежимы «Внутренний»/«Наружный» всё равно включаются (они читаются отдельно).

**Варианты.** а) оставить как у автора + перемычка PC9–GND на стенде; б) проверять выбранный подрежим
(`Sub_Mode_* == Man`), а не провода — тогда работает и с экрана, и с переключателем; в) режим
«переключателя нет» в конфиге. Решение — за владельцем.

## [BACKLOG-023] Экранный джойстик нового дисплея — переработать — НЕ НАЧАТО
Замечено при съёмке руководства (2026-11-08): кнопки «UP / DOWN» на экранном джойстике — по-английски.
С 2026-11-06 открывается тапом по ⚡ в шапке (двойной тап по ПОЗИЦИИ X теперь обнуляет ось).
**Найдено на стенде 2026-11-12:** при механическом джойстике в нейтрали экранная стрелка сдвигает каретку
лишь на ~0.2 мм — `Menu()` каждый проход видит физическую нейтраль и вызывает `Joy_NoPressed()`. Экранный
джойстик держит движение, только пока его команды повторяются; переделать вместе с видом (см. BACKLOG-038).
Сейчас оверлей открывается двойным касанием плитки «ПОЗИЦИЯ X», выглядит и управляется неудобно
(замечание владельца 2026-11-03). Переработать вид и способ вызова. Он же — способ запустить автоцикл
с экрана (см. BACKLOG-024).

## [BACKLOG-024] Запуск автоцикла с экрана — РЕШЕНО: как у автора («пока держишь»), 2026-11-03
**Как в 7e2.** Подрежим «Внутренний»/«Наружный», упоры стоят, суппорт в исходной точке → цикл идёт, пока
**джойстик удерживается** в сторону реза (обычно «влево»); отпустили — движение остановилось
(«мёртвая рука», безопасность). Отдельной кнопки «Старт» у автора нет. С экрана то же делает экранный
джойстик (стрелка — пуск, «СТОП» — останов), но он неудобен (BACKLOG-023).
**Предложения владельца:** удержание «ОК» 5 с или три нажатия «ОК» (демо-режим с тройного «ОК» убран 2026-11-13 — жест свободен).
Решить вместе с переработкой джойстика: что считать «отпусканием» для экранного пуска.

## [BACKLOG-025] Линейки в автоциклах — СДЕЛАНО: люфт, доводка X, контроль пропуска шагов (2026-11-07)
`Core/e2/e2_scalefix.inc`, включено по умолчанию (SCALE_FIX_X 1, STEP_LOSS_CHECK 1, допуск 150 мкм), экран
«ЛИНЕЙКИ» — переключатели. Без линеек/DRO не действует.
- Доводка X: ноль цикла по линейке, после врезания X доезжает физическими шагами (счётчик ядра не меняется).
  Симуляция (DRO-заглушка = каретка с люфтом, 50 Гц): недорез 0.000–0.001 мм при люфте 0.1/0.2 мм без компенсации
  и любой стороне подвода. Стенд (Mega следует за моторами, люфт X 0.1): без доводки 200 из 300 мкм, с доводкой 299.
- Контроль шагов: на остановках шаги против линейки; разворот — по направлению выданных шагов; без заданного
  люфта отрезки с разворотом не сверяются (иначе ложные срабатывания). Стенд: Mega теряет 200 шагов (dx200) —
  «ПРОПУСК ШАГОВ X: 0.24 ММ», джойстик заблокирован до отпускания; в цикле с люфтом 0.1 без компенсации ложных нет.
- Найдено и исправлено по ходу: опорная точка до первого пакета DRO (масштаб ×2 → «линейка не совпадает»),
  чтение линейки после доводки прерывалось удерживаемым джойстиком (старое показание), малые поправки назад
  выбирали люфт и сбивали ход (доводка — только в сторону врезания), разворот по счётчику ловил округление ядра.
- Направление линейки — по ходу > 2 мм от любой остановки; до этого — «ДОВОДКА X НЕ ГОТОВА».
- Тесты: `test_steploss`, проверка в `backlash_case` (SIM_BACKLASH), `tools/fix_hil.py`; эмулятор Mega: dz/dx<N>.

**Сделано:** компенсация люфта `BACKLASH_Z_UM` / `BACKLASH_X_UM` (els_config.h, 0 — как у автора). На первом
шаге после смены направления позиция мотора сдвигается на люфт — ядро само делает лишние шаги со своим
разгоном (в резьбе — в такт шпинделю), счётчики = положение каретки. Проверено моделью люфта: недорез 0.000
при подводе к нулю с любой стороны; матрица 29 автоциклов с люфтом X 0.1 / Z 0.2 мм — 428/428.
Важно: значение должно быть измеренным — компенсация больше реального люфта = перерез на разницу; первое
движение оси после включения не компенсируется (сторона выбора люфта неизвестна).
**Дальше:** люфт с экрана (настройки), замер по линейке, контроль пропуска шагов, доводка по линейке.

**Как в 7e2.** Все движения и автоциклы — по счёту шагов моторов (`Motor_Z_Pos`, `Motor_X_Pos`).
Блок DRO / линейки только показываются на экране (`Size_*_mm`) и в управлении не участвуют.
Компенсации люфта нет; есть только отскок `REBOUND_X/Z` (больше люфта винта), чтобы резец гарантированно
отходил от детали. Внутри цикла каждый проход подаётся с одной стороны, поэтому люфт выбирается одинаково
и проходы между собой точны; абсолютный размер оператор подгоняет по замеру.
**Что можно добавить (новая функция, не 7e2):**
- замер люфта по линейке (шаги мотора против линейки при смене направления) и компенсация в конфиге;
- контроль пропуска шагов: расхождение «шаги ↔ линейка» больше допуска — останов и сообщение;
- врезание X по линейке (довести до координаты по факту) перед каждым проходом подачи/конуса.
Синхронизация резьбы со шпинделем остаётся по шагам: линейки слишком медленные (50 Гц, 5–10 мкм).
Решить с владельцем до установки на станок WM210F600.

**Проверено моделью люфта (SIM_BACKLASH=1, 2026-11-04).** Подача 3 × ⌀1.00 и резьба 1.25, люфт 0.10 и 0.20 мм:
ноль взят движением К детали — недорез 0.001 мм (шаг мотора), люфт внутри цикла взаимно вычитается
(каждое врезание — после отскока, в одну сторону); ноль взят движением ОТ детали — недорез ровно на люфт
(0.099 / 0.199 мм). Вывод: у автора точность держится на приёме «подводить к нулю со стороны резания»,
прошивка его не обеспечивает. Решения: (1) люфт BACKLASH_X/Z в конфиге/на экране, перед стартом цикла
прошивка сама выбирает люфт подводом со стороны резания; (2) замер люфта по линейке; (3) «запас» —
сколько не доезжать (задаёт пользователь); (4) с квадратурными линейками — контроль и доводка по факту.
**Скорость линеек:** квадратура напрямую в STM32 — аппаратный счётчик, читается в любой момент (мкс);
блок HS800 — пакеты 50 Гц (реальную частоту блока измерить на железе); Sylvac/BIN6/iGaging ~50 Гц,
Digimatic — единицы Гц. Для коррекции резьбы по факту (ошибка шага винта, пропуск шагов) годится
только квадратура.

## [BACKLOG-026] Стенд: эмулятор DRO следует за моторами — СДЕЛАНО, проверено на железе (2026-11-06)
`tools/follow_hil.py`: Mega насчитывает столько же шагов, сколько STM32 (±2 — ядро после остановки округляет
счётчик до полного шага без импульсов), DRO на STM32 = позиция Mega; люфт X 100 мкм на Mega — каретка отстаёт
на 100 мкм; компенсация 100 мкм с экрана (CFG_SET) — каретка точно там, где счётчик STM32.
Режим эмулятора `f1`, люфт `lz/lx<мкм>`, нм/шаг `kz/kx`, обнуление `o` (Simulator/dro_simulator).

Сейчас на стенде позиции Y/X на экране — от эмулятора Mega (качание или фиксированные), моторы ими
не управляют, поэтому во время цикла цифры не связаны с движением. Предложение: STEP/DIR STM32
(PE9/PE10 — Z, PE13/PE14 — X) завести на Mega (прерывания D2/D3 + D4/D5, через 1 кОм), эмулятор
считает шаги, добавляет заданный люфт и выдаёт DRO/линейки — экран показывает реальное движение,
а стенд проверяет люфт и BACKLOG-025.

## [BACKLOG-027] Без линеек по умолчанию; ноль и ввод осей без блока DRO — СДЕЛАНО, проверено на железе (2026-11-06)
Железо (10.1", прошивка без линеек): двойной тап — ноль Y и X, клавиатура — X −12.50, ⌀ 40.00, после ввода оси
считают дальше (X −4.49 → ⌀ −9.00); прошивка с DRO — подсказка «ОСИ ЗАДАЮТСЯ НА БЛОКЕ DRO»; ⚡ — джойстик.
**Решение владельца:** исходная 7e2 — для станков без линеек и DRO, поэтому по умолчанию сборка без них.
- `ELS_POS_SOURCE` по умолчанию `POS_SOURCE_STEPS`; env `stm32f407_dro` (блок DRO) и `stm32f407_scales`
  (линейки напрямую). Стенд с эмулятором Mega — `stm32f407_dro`. СДЕЛАНО.
- Найдено: при линейках напрямую «Сброс» автора (обнуляет счётчик шагов X_pos/Z_pos) на показания не
  влиял — ось не обнулялась. Теперь у линеек своё смещение; «Сброс» и команда экрана `AXIS:<Z|X|D>:<мкм>`
  работают при любом источнике, кроме блока DRO (там оси задаются на блоке, экрану шлётся `AXIS_EDIT:0`).
  Диаметр — отдельный ноль, как MX_pos у автора. Симуляция: test_axis_set во всех трёх вариантах. СДЕЛАНО.
- Экран: двойной тап по ПОЗИЦИИ Y / X — ноль, долгое нажатие на Y / X / ⌀ — клавиатура (знак, 0.001 мм).
  Жесты — там, где плитки показывают оси (rows_show_axes). Прежние скрытые двойные тапы убраны: категория
  резьбы — плиткой ТИП, категории конусов — барабаном, экранный джойстик — тап по ⚡ в шапке. Набор числа
  проверен на компьютере (11/11); на железе — когда платы вернутся. СДЕЛАНО, ждёт проверки на железе.

## [BACKLOG-028] Настройки станка во флеше, правятся с экрана — МЕХАНИКА СДЕЛАНА, проверено на железе (2026-11-06)
Железо: окно «МЕХАНИКА СТАНКА» — винт Z 1.50 сохранён, «ИЗ КОНФИГА» вернул els_config.h; настройки во флеше
переживают сброс STM32 и перепрошивку через ST-Link (pio upload); компенсация люфта с экрана работает (026).
**Другая механика — разобрано (2026-11-07).** «Упоры не ставятся» при энкодере 3600 / микрошаге 8 — тест: ядро ставит
левый упор не ближе тормозного пути ускоренного хода ((MIN_RAPID − MAX_RAPID) × REPEAt × 2 шагов = 3.8 мм), а
ускоренный ход ограничен частотой шагов — при микрошаге 8 вдвое медленнее в мм/с, и тест не доезжал. Тесты стали
учитывать механику (отъезд по расстоянию, допуски подачи от целого периода, РГИ — до полного шага, ход
многозаходной — по винту, тайм-аут × микрошаг). Найдена и исправлена ошибка ядра: сдвиг старта следующего захода
многозаходной резьбы считался через TENS — целое «шагов на 0.01 мм»; при винте 1.5 мм второй заход смещался на
1.41 мм вместо 1.50 (E2_THREAD_START_SHIFT, точно и до полного шага). С механикой автора (800/200 = 4) не видно.
Механики 1800/200×4/1.5/1.25 и 3600/200×8/2/1: симуляция 179/179, матрица 428/428 каждая.
Важно для настройки: при микрошаге 8 ускоренные ходы вдвое медленнее, чем при 4 (свойство ядра автора).
Сделано: e2_mech.h — имена из els_config.h переопределены на поля e2_mech (текст ядра не меняется);
e2_mech_apply() — проверки как static_assert автора + делители таблиц (byte, ≥ 1), пересчёт таблиц по
формулам gen_e2_tables.py (при механике автора — его таблицы байт в байт), разгон, люфт; флеш — сектор 11
(e2_store.cpp), метка/версия/контрольная сумма; экран: ⚠ двойной тап → «МЕХАНИКА СТАНКА», клавиатура,
СОХРАНИТЬ (CFG_SET; только на стоящем станке), ИЗ КОНФИГА (CFG_DEFAULT, держать). Симуляция: пересчёт =
таблицы автора, отказ на неверных значениях, флеш, протокол; на двух других механиках весь набор падает
ровно так же, как сборка с той же механикой в els_config.h (тесты рассчитаны под механику автора).
Источник координат и линейки — тоже настройки (2026-11-06): оба драйвера в прошивке всегда, ⚠ → НАСТРОЙКИ →
ЛИНЕЙКИ, сохранение POS_SET → флеш (запись v2, v1 читается) → перезапуск STM32. Железо: DRO → линейки (квадратура
от Mega) → DRO с экрана. Одна прошивка STM32 подходит для всех вариантов.
Дальше: проверить на железе — сохранение во флеш, переживает ли
перепрошивку; ядро автора на механике с энкодером 3600 / микрошагом 8 — в симуляции не ставятся упоры
и не идут автоциклы (так же и при сборке с этой механикой) — разобрать, тест это или ядро.
Шаг винтов, шагов на оборот, микрошаг, энкодер, люфт, тип линеек — сейчас задаются при сборке, поэтому
готовая прошивка подходит только станку с теми же параметрами. Перенести в настройки (флеш STM32), значения
из els_config.h — как исходные. Нужно для релизов (030) и калибровки (029). Таблицы резьб/конусов зависят
от механики (gen_e2_tables.py) — придётся считать на STM32.

## [BACKLOG-029] Калибровка шагов и люфта по линейкам — СДЕЛАНО, проверено на стенде (2026-11-06)
**По индикатору / штангенциркулю — СДЕЛАНО (2026-11-07):** вкладка «ПО ИНДИКАТОРУ», мастер: CAL_STEP фазы 1 (выбрать
люфт −1/+1 мм), 2 (вперёд на ход), 3 (назад); показания вводит оператор, шаг винта = винт × показание / ход, люфт =
показание после возврата. Стенд (Mega как индикатор, винт X 1.04, люфт 80): «винт 1.039 мм, люфт 80 мкм».
Симуляция: test_cal_step — фаза 2 ровно на ход, ось возвращается на место, счётчики не меняются.
e2_calib.inc: ось 3 раза +1 мм, +L, −L, −1 мм (возврат на место); шаг винта — по ходу без разворота, люфт — по
обоим разворотам; компенсация на время калибровки выключена; прервать — джойстиком или СТОП. Экран: «МЕХАНИКА
СТАНКА» → «КАЛИБРОВКА», ПРИМЕНИТЬ → CFG_SET. Стенд: Mega с «неточным» винтом и люфтом — Y задано 1.92 мм /
100 мкм → найдено 1.920 / 100; X 1.04 / 80 → 1.040 / 81. Ограничение: шаг винта в ядре — 0.01 мм, применяется
округлённый.
Идея владельца, как калибровка на 3D-принтере. Пользователь отводит суппорт в безопасное место и подтверждает
пробег (например, 50 мм по Z, 20 мм по X; размеры станка не нужны). Станок ездит туда-обратно, сравнивает
шаги с линейкой: реальный шаг винта (с ошибкой передачи), люфт (шаги на развороте до сдвига линейки),
направление и разрешение линейки. Без линеек — по индикатору/штангенциркулю (пользователь вводит замер).
Калибровка вибраций (input shaping) не нужна: тяжёлый суппорт, низкие скорости. Проверка — на стенде Mega
с заданным люфтом и «неточным винтом». Зависит от 028.

## [BACKLOG-030] Релизы на GitHub (Actions) — СДЕЛАНО, первый релиз v0.1.0 (2026-11-06)
`tools/make_release.sh` → dist/: `els-stm32-dro.bin`, `els-display-<env>.bin` (загрузчик + разделы +
программа, с 0x0), SHA256SUMS. `.github/workflows/release.yml`: тег v* — релиз с этими файлами и
docs/RELEASE.md; вручную — только сборка. В релизе Wi-Fi — только шаблон (ELS_RELEASE), локальный
wifi_config.h в файлы не попадает.
**Решение владельца:** пока под его станок (WM210F600, блок DRO HS800-2, линейки); другие пользователи
впишут свои параметры (els_config.h) или дождутся 028. По тегу: STM32 (без линеек / DRO / линейки),
дисплеи 4.3" и 10.1".

## [BACKLOG-031] Визуализация программы на экране дисплея и подсказка резцов — ИДЕЯ ВЛАДЕЛЬЦА (2026-11-07), В БЭКЛОГ
- На экране 10.1": контур детали, траектория, точка резца, двигается по ходу программы (линии — один раз, двигать
  только точку; память есть — PSRAM 32 МБ). На 4.3" — упрощённо.
- Подсказка резцов по признакам программы: наружная/внутренняя обработка, подрезка торца, врезания по X
  (канавка — по ширине), дуги и фаски, номера T и комментарии — вида «проходной упорный, отрезной ≥ 3 мм».
- Веб-страница уже рисует траекторию (переделана 2026-11-07: вид станка, размеры, курсор строки, код с подсветкой).

## [BACKLOG-032] Руководство пользователя (User Manual) — ПЕРВАЯ ВЕРСИЯ (2026-11-08)
Сделано: docs/manual/README.md — оси, пульт, экран (34 снимка с дисплея 10.1" со стрелками-номерами), ноль, упоры
и автоцикл, все режимы, примеры (проточка ⌀30→⌀28 на 50 мм, резьба M20×1.5 длиной 80 мм), настройки, все
сообщения и ошибки (снимки + что значит + что делать), частые вопросы. Снимки — tools/docs_gen/manual_shots.py
(стенд), стрелки и маски имени сети — annotate.py. Осталось: примеры для конуса и шара шаг за шагом, снимки
автоцикла в работе, 4.3". 2026-11-13: сделаны — пример конуса 1:10 и шара ⌀20 по шагам, снимки цикла с
стенда (tools/docs_gen/cycle_shots.py), заметка про 4.3" и 7".
Просьба владельца: чтобы понял школьник или любой, кто не в теме.
- По каждому разделу и режиму (M1–M8, подрежимы, упоры, джойстик, ввод осей, настройки, калибровка, Wi-Fi, G-код):
  что это, когда нужно, как пользоваться — по шагам, со снимками экрана и стрелками на снимках «куда жать».
- Примеры задач от начала до конца, например: «нужно нарезать резьбу длиной 80 мм с шагом 1.50 — для этого …»;
  проточка до диаметра, конус, торец, сфера, делилка, G-код (пешка).
- Все сообщения об ошибках — снимок каждого и FAQ: что значит, почему появилось, как исправить.
- Снимки — с реального дисплея (UIDUMP/скрин по USB), стрелки и подписи — поверх (генератор в tools/).
- Формат — HTML-страница в docs/ (как index.html) + краткий MD; ссылки из README.

## [BACKLOG-033] Наглядная схема подключения по каждому выводу и список покупок — ПЕРВАЯ ВЕРСИЯ (2026-11-08)
Сделано: docs/assembly/README.md — список покупок (электроника, шилд, разъёмы и провода, станок, пульт,
инструмент), заказ и пайка шилда по шагам с проверками, карта разъёмов шилда, схема на каждый разъём
(«вывод шилда → провод → клемма модуля», цвета, номера; генератор tools/docs_gen/shield_docs.py из design.py
и платы KiCad), первое включение по одному блоку. В docs/wiring/pins.md — колонка «Шилд».
Сделано (2026-11-12): docs/wiring.html — интерактивная схема на замену удалённым pinout.html/schematic.html
(генератор tools/docs_gen/wiring_html.py): Discovery со всеми 100 выводами, модули со значками «как выглядят»,
провод от каждой ноги к клемме, детали шилда на линии, подсветка цепи, поиск, масштаб; карта шилда; таблица.
Просьба владельца: сейчас скудно, нужно, чтобы понял школьник.
- Вернуть и улучшить визуальные страницы, как были docs/pinout.html и docs/schematic.html (коммиты 8ce1d85,
  9478be2). Удалены 2026-11-02 (a6f2c75): выводы портов F/G, которых нет у STM32F407VG на Discovery, — делать
  заново по актуальной карте Core/e2/e2_pins.h (генератор tools/docs_gen).
- Каждый модуль — картинкой (плата Discovery, драйверы, энкодер, джойстик, кнопки, переключатели, дисплеи,
  блок DRO / линейки, питание), провод от каждой ноги к каждому выводу, цвета, подписи, номера контактов.
- Список покупок (BOM): что нужно, сколько штук, модель/артикул, замены — «STM32F407 Discovery — 1 шт.,
  джойстик … — 1 шт.» и т. д.; что обязательно, что по желанию.
- Порядок сборки по шагам и проверка каждого шага (монитор входов, эмулятор на Mega).

## [BACKLOG-034] Резцы в G-коде: смена по T, подсказка, выбор резца — ПРЕДЛОЖЕНИЕ (2026-11-08)
Вопрос владельца: смена инструментов, рекомендация резца или пользователь сам выбирает, а программа подстраивается.
- Шаг 1 (просто, как M600 у 3D-принтера): T в программе сменился (T0101 → T0202) — пауза, на дисплее и странице
  «ПОСТАВЬТЕ РЕЗЕЦ T02 (комментарий из программы)», после смены — заново коснуться торца и диаметра (вылет резца
  другой), «Продолжить». Смены резца станок сам не делает.
- Шаг 2 (BACKLOG-031): разбор программы — подсказка резца: поднутрения под углом → пластина 80° (CNMG) / 55°
  (DNMG) / 35° (VBMT); канавки — отрезной/канавочный по ширине; внутренняя обработка — расточной; резьба — резьбовой.
  Пешка pawn.nc — один резец, пластина 35° (поднутрения 45°).
- Шаг 3 (большой): «пользователь выбирает резец — программа подстраивается» — это генератор траектории (CAM): на
  странице задаётся контур детали и резец, проходы строит станок (как lathecode). Тогда же — компенсация радиуса
  при вершине резца (G41/G42).

## [BACKLOG-035] Щуп для нуля: касание резцом — ПРЕДЛОЖЕНИЕ (2026-11-08)
Идея владельца: провод на резец, «ПОЛУЧИТЬ НОЛЬ ТОРЕЦ / ДИАМЕТР» — резец сам подъезжает до касания.
- Станок весь железный (резец, деталь, станина замкнуты) — прямое касание не ловится. Варианты из практики
  (LinuxCNC, hobby-machinist): изолированный резцедержатель (прокладка и втулка на шпильке из текстолита) и провод
  на него; или пластина-щуп — кусок фольгированного стеклотекстолита: медь к резцу (провод на вход), стеклотекстолит
  к детали; касание резца с медью замыкает вход на массу станка; толщину пластины вычесть.
- Z (торец): пластину прижать к торцу, резец в 2–5 мм правее, «НОЛЬ ТОРЕЦ» — медленно (≈20 мм/мин) к патрону до
  касания, Z = толщина пластины, отвод 1 мм. Полностью автоматически.
- X (диаметр): касание даёт положение поверхности, но не диаметр — его всё равно меряют штангенциркулем
  (с другой стороны оси резец не дотянется). Касание + ввод ⌀ — точнее «на глаз».
- Вход STM32: свободная нога с подтяжкой, RC-фильтр, масса — станина. Касание — как концевик у 3D-принтера
  (быстро до касания, отвод, второе касание медленно).
- «Прощупать по длине, как стол 3D-принтера» (конусность заготовки, биение) — можно тем же щупом, но для токарки
  обычно не нужно; позже, если будет смысл.
- 2026-11-12: на шилде под щуп уже есть разъём J25 «ДАТЧИК (РЕЗЕРВ)»: +5V, GND, вход PA2 (подтяжка 1k к 3V, 10 нФ;
  EXTI2, захват TIM2/TIM5). Прошивка его пока не использует (E2_PIN_PROBE).

## [BACKLOG-036] Резервные разъёмы шилда — проверить на стенде и дать функции — ОТКРЫТО (2026-11-12)
- [x] На стенде: блок DRO читается после правки `drv_dro.cpp` (PA2 после `DROSerial.begin()` — вход, не выход TX):
  `scales_hil_test.py --mode hs800` — 6/6 (2026-11-12).
- J26 РЕЗЕРВ ВЫХОДЫ (PD13, PD15): кандидаты — шпиндель M3/M5 и охлаждение M8/M9 из G-кода (модули реле 3.3 В).
- J27 РЕЗЕРВ (PA5 АЦП/ЦАП, PA7 АЦП) и J25 ДАТЧИК (PA2) — по задачам (BACKLOG-035 щуп).

## [BACKLOG-037] 7" JC1060P470 — прошивка по описаниям, ждём отзывов — ОТКРЫТО (2026-11-12)
У владельца дисплея нет (покупать не планирует), прошивку просят на форуме. Решение владельца 2026-11-12:
«как получится на основе 10.1», вылизывать по отзывам пользователей.
- [x] env `jc1060p470` (старая панель), `jc1060p470_v2` (метка «V2»), `jc1060p470_v3` (V2 + ESP32-P4 rev 3.x),
  все три — в релизе (`tools/make_release.sh`). Драйвер JD9165 (Espressif), таблицы панелей — из ESPHome,
  тач GT911 — опрос по I2C, шрифты ×32/15, картинка и тач перевёрнуты на 180° (`P7_ROT180`).
- [x] STM32: тип 70 разрешён; в релизной сборке несовпадение типа дисплея — только строка в порт, без алерта
  (OK алерта шлёт ALERT_OK → `Switch_Man()`).
- [ ] Отзывы: включается ли экран (V1/V2/V3), тач (адрес 0x5D/0x14, направление), UART на разъёме, Wi-Fi C6.
- [ ] 10.1": новые партии JC8012P4A1C тоже могут прийти с ESP32-P4 rev 3.x — тогда нужен env на `esp32-p4_r3`.

## [BACKLOG-038] Физические органы управления и экран — кто главный — СДЕЛАНО (2026-11-12)
Вопрос владельца: галетник в «5», на экране выбрали «2» — что верно? Разбор на стенде (2026-11-12):
- Галетники режима и подрежима у автора срабатывают **по повороту** (фронт), а не по положению. Экран тоже
  переключает сразу. Итог — «кто последний, тот и прав»: экран выбрал «2» → режим 2, пока галетник не повернут;
  повернули галетник → его положение. Галетник, стоящий на месте, экран не перебивает. Проверено: Конус > на
  галетнике → «2» с экрана → через 1.5 с режим всё ещё 2 → поворот на «Резьбу» → режим 3.
- [x] **Исправлено:** галетник при движении от джойстика не действует (у автора `!Joy_Z_flag && !Joy_X_flag`),
  а экран менял режим/подрежим и во время подачи. Теперь M1..M8/S1..S3 с экрана при движении — отказ (длинный
  сигнал), дисплею возвращается текущий режим (проверено: экран показал «АСИНХРОН», STM32 Mode=2).
- Упоры: кнопки и экран переключают один и тот же флаг, светодиоды по флагу — конфликта нет. Кнопки упоров
  разрешены при галетнике подрежима в «Ручной» или выбранном «Ручном» (LIMITS_BY_SELECTED_SUBMODE).
- Ось и множитель РГИ — только переключателями, на экране их нет — конфликта нет.
- Джойстик: механический главнее — его нейтраль останавливает экранное движение (BACKLOG-023).
- [x] Решение владельца (2026-11-12): оставить «кто последний». STM32 шлёт положение галетников `<SEL:режим,подрежим>`
  (0 — не подключён или между положениями), дисплей при расхождении показывает на месте подрежима янтарное
  «галетник: РЕЗЬБА» / «галетник: Наружная» (подрежим — только в M1–M6). Проверено на стенде 10.1": галетник
  Резьба/Ручной → экран M2 → «галетник: РЕЗЬБА»; M3 — надпись пропала; галетник в «Наружный» без упоров — ядро
  осталось в «Ручном», надпись «галетник: Наружная». Руководство — раздел 3 и частые вопросы.

## [BACKLOG-039] Инструкция под Windows: готовая прошивка и своя сборка — ПЕРВАЯ ВЕРСИЯ (2026-11-12)
`docs/windows/README.md` (запрос владельца: пользователи форума далеки от электроники). Подготовка Windows (кабели,
драйвер ST-Link через STM32CubeProgrammer, Диспетчер устройств), путь А — файлы с Releases, STM32CubeProgrammer и
esptool-js в браузере, настройки на экране и что без пересборки не поменять; путь Б — кириллица в имени
пользователя (PLATFORMIO_CORE_DIR), VS Code + PlatformIO, ZIP в C:\els, env, сборка/прошивка; 9 примеров настроек
els_config.h / wifi_config.h; раздел про три 7".
- Картинки — `tools/docs_gen/windows_shots.py`: окна Windows/VS Code/CubeProgrammer/GitHub нарисованы (снять на
  macOS нельзя, подписано на картинке), код — настоящие строки файлов, esptool-js — настоящие снимки страницы.
- Найдено и исправлено: из свежей копии исходников прошивка дисплея не собиралась — нет `wifi_config.h`
  (в .gitignore); теперь без него берётся шаблон.
- [ ] Заменить схемы окон настоящими снимками с Windows (если кто-то с форума пришлёт).
- [ ] Ссылка на репозиторий в тексте не указана (логин владельца — персональные данные): «ссылка — в теме на
  форуме» и относительная ссылка на Releases.
