tepmehatop/Lathe-cnc-controller-stm32/docs/PORT_AUDIT.md

# Аудит порта: оригинал 7e2 (Arduino Mega) → STM32F407

Эталон: проект `7e2_dro_integration` (Arduino Mega 2560, «Электронная гитара 7e2 V3.3»,
chipmaker.ru) + исходная схема автора `Diagram ELS_V7.jpg`.
Дата аудита: 2026-11-02.

## 1. Главный вывод

Порт STM32 до этого аудита **не являлся переносом ядра управления движением**, а был
упрощённой переделкой. Отметки «Готово» в `MIGRATION_PLAN.md` для этапов 12, 15–19 не
соответствовали действительности.

| Функция | Оригинал | Порт STM32 (до аудита) | Последствие |
|---|---|---|---|
| Резьба | шаги генерируются в прерывании от **каждого фронта энкодера** шпинделя (дробный делитель Ks/Km), старт прохода — по нулевой метке энкодера (Enc_Pos == 0) | частота шагов вычисляется по измеренным оборотам с гистерезисом 3 %, привязки к углу шпинделя нет | многопроходная резьба невозможна — каждый проход в другом месте |
| Синхронная подача | счётчик Timer5 тактируется энкодером (вход T5), разгон/торможение OCR5A±1 на шаг | частота по оборотам, без разгона | пропуск шагов на разгоне, подача «плывёт» с оборотами |
| Конус | X ведомая от Z (Cs/Cm) в тех же прерываниях, с разгоном | Bresenham в одном TIM1, без разгона | — |
| Две оси | независимые таймеры 2/3/4/5 + INT0 | один TIM1 на обе оси, общая частота | оси не могут одновременно идти с разной скоростью |
| Автоциклы Int/Ext (проходы, съём Ap, отскок, натяг, чистовые проходы) | Feed.ino, aFeed.ino, Thread.ino, Cone.ino, Sphere.ino | не перенесены (кроме упрощённого шара) | автоциклов нет |
| Упоры (лимиты) | торможение с замедлением до упора (Limit_Pos − разгон) | резкая остановка по позиции | удар/пропуск шагов |
| Ускоренные ходы | Timer2, разгон MIN→MAX_RAPID_MOTION | фиксированная частота | — |
| РГИ (ручной энкодер) | Timer3, разгон/торможение, масштаб x1/x10, обнуление | MoveSteps фиксированной частотой | — |
| Тахометр (выход) | импульс на оборот | не перенесён | — |
| Переменник подачи (АЦП) | работает | выключен | — |

## 2. Решение

Ядро перенесено **дословно**: файлы автора лежат в `Core/e2/orig/` и подключаются без
изменений; основной скетч (`e2_core.cpp`) — их копия, где заменено только то, что касается
железа AVR (каждое место помечено `[STM32]`). Аппаратный слой — `Core/e2/e2_hal.*`,
карта выводов — `Core/e2/e2_pins.h`, все настройки станка — `Core/els_config.h`.
Старый упрощённый порт (`els_control`, `els_menu`, `drv_stepper` и др.) удалён.
Новые возможности (дисплей ESP32, линейки напрямую, LCD2004 по I2C) подключены поверх ядра.

## 3. Соответствие аппаратуры

| Оригинал (AVR) | Назначение | STM32 |
|---|---|---|
| INT0 (pin 21, любой фронт канала A) | энкодер шпинделя ×2 → резьба | EXTI, оба фронта канала A |
| Timer5, внешний такт T5 (pin 47) | энкодер ×1 → синхронная подача | программный счётчик фронтов A в том же прерывании |
| Timer2, 500 кГц, CTC | ускоренные ходы | TIM6, 500 кГц, ARR = OCR2A |
| Timer3, 250 кГц, CTC | РГИ | TIM7, 250 кГц, ARR = OCR3A |
| Timer4, 250 кГц, CTC | асинхронная подача | TIM12, 250 кГц, ARR = OCR4A |
| Timer1, 40 мс | опрос клавиатуры (Menu) | micros() в loop, период 40.06 мс |
| INT2 (pin 19) | РГИ | EXTI на PE7 |

Запись в ARR действует сразу (предзагрузка ARPE выключена) — как запись OCRnA на AVR.

Все прерывания движения — **одного приоритета** (не вытесняют друг друга), как на AVR.

## 4. Что изменено относительно оригинала

| Место | Оригинал | STM32 | Почему |
|---|---|---|---|
| `Spindle()` (Spindle_On.ino) | «шпиндель стоит» — раз в 750 проходов `loop()` (~1 с) | раз в 1000 мс по `millis()` | `loop()` на STM32 в десятки раз быстрее |
| Timer1 → `Menu()` | флаг таймера каждые 40 мс | `micros()`, 40.06 мс | — |
| `TIMSK0 = 0` в `setup()` | выключал Timer0 (и `millis()`) | не выполняется | `millis()` нужен для дисплея и LCD |
| LCD2004 | библиотека LCDI2C_Multilingual, вывод сразу | теневой буфер, на I2C только изменения, ≤ 2 мс за проход `loop()` | `Print()` перерисовывает экран каждые 40 мс — прямой вывод занимал бы почти весь цикл |
| Дисплей ESP32 | SoftwareSerial, копия каждой строки в Serial | USART3, ожидание места в буфере ≤ 10 мс, копия в Serial выключена (`E2_DISP_TX_ECHO`) | полная отправка (~30 строк) тормозила цикл |
| Команды дисплея | — | добавлены `DISP` (сверка типа дисплея), `GCODE` (ответ «не поддерживается»), `RPM`, `LCD2004` (для автотестов) | в 7e2 этого не было |
| DRO HS800 | DRO_HS800.ino на Serial2 | `Drivers/drv_dro` (USART2, PA3); формулы пересчёта в `loop()` — авторские | — |
| Линейки напрямую | — | `Drivers/drv_scales` → те же `dro_pos_x/y` | новая возможность |
| Переменник подачи | всегда | `USE_FEED_POT` в `els_config.h`; без него стартовая подача — середина диапазона | неподключённый вход «плавает» — подача скакала бы сама |
| Импульс STEP | длительность паузы = время кода между снятием и установкой импульса в одном прерывании (на конусе 45° — несколько мкс на Mega) | уровень на STEP держится не меньше `STEP_PULSE_MIN_US` (3 мкс, счётчик тактов DWT) | STM32 в 10 раз быстрее: без защиты пауза 0.1 мкс — драйвер теряет шаги |
| Таблицы резьб/конусов | рассчитаны под энкодер 1800, винты 2 и 1 мм, 800 шаг/об | те же; при другой механике сборка останавливается, `tools/gen_e2_tables.py --write` пересчитывает | иначе смена винта в конфиге молча давала бы неверные резьбы |
| Сборка | AVR: `int` 16 бит, `char` со знаком, `double` = `float` | `-fsigned-char`, `-fsingle-precision-constant`; `int` 32 бит | значения в коде автора укладываются в 16 бит, переполнений не найдено |

## 5. Проверка без платы (симуляция)

`bash tools/run_e2_sim.sh` собирает на компьютере настоящие `e2_core.cpp` (скетч 7e2),
`e2_hal.cpp` и `e2_lcd.cpp`; регистры GPIO и таймеров — в памяти, время — виртуальное.
Симулятор крутит энкодер шпинделя (квадратура A/B, 1800 линий), РГИ, отсчитывает периоды
TIM6/TIM7/TIM12 и вызывает те же обработчики, что прерывания на плате. Шаги считаются по
фронтам на выводах STEP.

| Проверка | Результат |
|---|---|
| Резьбы 1.00 / 1.25 / 1.75 / 0.20 / 2.50 мм, 18 tpi | шагов на оборот ровно по делителю таблицы (400 / 500 / 700 / 80 / 1000 / 564.4) |
| Повторный проход резьбы | первый шаг на той же линии энкодера (14 и 14) — попадание в нитку |
| Синхронная подача | совпадает с расчётом 7e2 (см. п. 6) |
| Асинхронная подача 100 и 400 мм/мин | 668.5 и 2717.5 шаг/с — как у 7e2 |
| Ускоренный ход | разгон до 4902 шаг/с (735 мм/мин), остановка после отпускания |
| РГИ x1, 25 щелчков | +100 шагов и точный возврат |
| Упор слева | подача остановилась ровно на упоре |
| Режимы M1–M8 и подрежимы с дисплея | `Mode` и строка LCD2004 верные; «Внутр.» без упоров запрещён, как у автора |
| Автоцикл «Наружная резьба» 1.5 мм | 16 проходов (14 + 2 чистовых), все с одной линии энкодера, суппорт вернулся в исходную точку, на LCD «ОПЕРАЦИЯ ЗАВЕРШЕНА» |
| Автоцикл «Наружная подача» | 3 прохода, врезание ровно по 0.1 мм на радиус (80 шагов) |
| Ось X, обратное вращение шпинделя, РГИ x10 по X | движение, возврат, 10 щелчков = 400 шагов |
| Конусы 45°, 30°, 1:10, Морзе 0 | уклон X/Z по таблице (точность ±4 шага) |
| Шар R 5 мм | 21 врезание; профиль по окружности с авторской поправкой `Excess_Lag` (±2 шага) |
| Делилка | угол шпинделя и требуемый угол метки на дисплей |
| Импульс STEP | Z ≥ 27 мкс, X ≥ 3.02 мкс (без защиты — 0.1 мкс) |

## 6. Особенности оригинала (не ошибки переноса)

- **Синхронная подача меньше заданной на 6–10 %.** `Feed_Divisor = 225 / Feed_mm + 0.5`,
  а Timer5 в режиме CTC срабатывает раз в `OCR5A + 1` линий: 0.10 мм/об даёт 0.094,
  0.25 — 0.225 мм/об. Так же работает и Mega (вход T5 — перемычка с пина 21, канал A).
  **Исправлено по решению владельца (2026-11-06):** `FEED_EXACT 1` в els_config.h вычитает лишний
  период — подача равна заданной с точностью до округления периода (0.10 → 0.098, 0.25 → 0.250);
  `FEED_EXACT 0` — как у автора.
- Резьба, асинхронная подача и ускоренные ходы считаются точно.

## 7. Расхождения настроек со старым портом

Старый порт STM32 использовал другие значения, чем оригинал. Сейчас в `els_config.h` —
значения автора 7e2. Если станок отличается — поменять там:

| Параметр | 7e2 (сейчас) | старый порт |
|---|---|---|
| `SCREW_X` (шаг винта X) | 100 (1 мм) | 125 (1.25 мм) |
| `MIN_FEED` / `MAX_FEED` | 1 / 25 (0.01–0.25 мм/об) | 5 / 200 |
| `MIN_aFEED` / `MAX_aFEED` | 10 / 400 мм/мин | 15 / 300 (в других единицах) |
| `LIN_X` | 200 | 5 |

## 8. Ещё не проверено

- На плате: прошивка собрана, но STM32 и дисплеи в момент работы не были подключены.
- В симуляции добавлены (2026-11-02): автоциклы «Внутренний» (резьба, подача), асинхронный и конусный автоцикл,
  2-заходная резьба, тахометр — всего 172 проверки. Не симулированы: конусная резьба (CThr).
- Полная сверка по пунктам — [CHECKLIST_7e2.md](CHECKLIST_7e2.md).
- Упоры ставятся кнопками только когда переключатель подрежима стоит в «Ручной»
  (`Submode_Read == B10100000`, так у автора). Без физического переключателя вход «Ручной»
  (PC9) нужно соединить с GND, иначе упоры (и с дисплея — EMUL:STOP_*) не ставятся.
