tepmehatop/Lathe-cnc-controller-stm32/docs/CHECKLIST_7e2.md

# Чеклист: всё, что есть в прошивке 7e2, и что из этого есть на STM32

Эталон — прошивка 7e2 для Arduino Mega (`7e2_Mod_LCD4.3_v1.3`, ветки `main` и
`feature/hs800-dro-integration` репозитория 7e2_Mod_4.3-inch-LCD-TFT), её схема `Diagram ELS_V7.jpg` и
инструкция автора. Сверено 2026-11-02.

**Как проверено** (последний столбец):
- **код** — код автора подключён без изменений (`Core/e2/orig/*.ino`) или перенесён дословно в `e2_core.cpp`;
- **сим** — проверено симуляцией на компьютере (`bash tools/run_e2_sim.sh`, 172 проверки), там настоящий код
  ядра и аппаратного слоя, энкодер и таймеры в виртуальном времени;
- **авто** — автоматическая сверка исходников (функции, настройки, переменные, таблицы);
- **железо** — нужна проверка на плате (зависит от реальных проводов, кнопок, моторов).

## 0. Итог автоматической сверки исходников

| Что сверялось | Оригинал | На STM32 | Как |
|---|---|---|---|
| Ветки оригинала на GitHub | `main`, `feature/hs800-dro-integration` | логика во всех ветках одинакова; наша копия = ветка с DRO; в `main` нет пары команд дисплея, которые у нас есть | авто |
| Функции | 124 | 119 на месте; 5 функций `DRO_HS800.ino` заменены драйвером `Drivers/drv_dro` (то же: CRC16, проверка пакета, X/Y, кнопки) | авто (сборка без оптимизации, таблица символов) |
| Настройки `#define` | 152 | все: параметры — в `els_config.h`, макросы портов и таймеров — в `e2_hal.h`, флаги регистра GPIOR0 — переменные | авто |
| Глобальные переменные | 163 | все 163, начальные значения те же | авто |
| Таблица резьб | 67 (метрика 20, дюйм 27, G 10, K 10) | та же, без изменений | авто + сим (6 резьб) |
| Таблица конусов | 63 (углы, Морзе KM0–KM6, конусности 1:4…3:25) | та же | авто + сим (4 конуса) |
| Основной скетч | — | отличия только в обращениях к железу, каждое помечено `[STM32]` | авто (дифф) |

## 1. Режимы и подрежимы

| Режим (переключатель) | Ручной | Внутренний (автоцикл) | Наружный (автоцикл) | Проверено |
|---|---|---|---|---|
| 1 Синхронная подача | Feed_Left/Right/Front/Rear, ускоренно Rapid_Feed_* | Feed_Int_Left/Right/Front/Rear | Feed_Ext_Left/Right/Front/Rear | код; сим: подача Z/X, автоцикл наружный (3 прохода) и внутренний (2 прохода) |
| 2 Асинхронная подача | aFeed_Left/Right/Front/Rear | aFeed_Int_* | aFeed_Ext_* | код; сим: 100 и 400 мм/мин, автоцикл наружный |
| 3 Резьба | Thread_Left/Right/Front/Rear | Thread_Int_Left/Right | Thread_Ext_Left/Right | код; сим: 6 резьб, повтор прохода в нитку, внутренний и наружный автоцикл, 2 захода, обратное вращение |
| 4 Конус < | Cone_Left/Right (X ведомая), ускоренно Rapid_Cone_* | Cone_Int_* | Cone_Ext_* | код; сим: уклон 45°, 30°, 1:10, Морзе 0; автоцикл наружный |
| 5 Конус > | то же | то же | то же | код |
| 6 Шар | Feed_*, Rapid_Feed_* | — | Sphere_Ext_Left (Sphere_Ext_Right — пустая у автора) | код; сим: шар R 5 мм, 21 врезание, профиль по окружности |
| 7 Делилка | угол шпинделя, кнопка «Выбор» обнуляет угол | — | — | код; сим: угол и требуемый угол метки |
| 8 Резерв | пусто у автора | — | — | код |
| Подрежим: Внутренний / Ручной / Наружный | Switch_Int / Switch_Man / Switch_Ext, проверка упоров и исходной позиции | | | код; сим |
| Многозаходная резьба (Ph, до 90) | старт каждого захода сдвинут на шаг резьбы | | | сим: 2 захода — ход 2×шаг, старты по Z через 600 шагов |
| Конусная резьба (CThr, в режимах конуса, меню 2) | | | | код; железо |
| Чистовые проходы (PASS_FINISH + Pass_Fin, до 9) | | | | сим (14 + 2 прохода) |
| Добавка проходов к табличным (Thr_Pass_Summ) | | | | код |
| Глубина врезания резьбы — по 60° профилю, √-распределение | | | | код; сим (число проходов) |
| Отскок (REBOUND_X/Z), натяг (TENSION_Z), отскок Z вкл/выкл (OTSKOK_Z) | | | | код |
| Компенсация набегающих микрошагов в шаре (Excess_Lag) | | | | сим (профиль с поправкой ±2 шага) |

## 2. Расчёты и движение

| Что | У автора | На STM32 | Проверено |
|---|---|---|---|
| Резьба: шаг мотора по каждому фронту энкодера, дробный делитель Ks/Km | INT0, любой фронт канала A | EXTI на PA1 | сим: шагов на оборот ровно по таблице |
| Старт резьбы с нулевой метки энкодера (попадание в нитку) | Enc_Pos == 0 | то же | сим: повторный проход с той же линии |
| Разгон резьбы (THRD_ACCEL, REPEAt) | | код | сим |
| Синхронная подача: Timer5 от энкодера (вход T5), OCR5A ± 1 — разгон/торможение | Timer5 + перемычка 21–47 | программный счётчик фронтов в том же прерывании | сим: как у Mega (см. BACKLOG-020 про −6…10 %) |
| Асинхронная подача: Timer4, 250 кГц | | TIM12, 250 кГц | сим: 668.5 и 2717.5 шаг/с |
| Ускоренные ходы: Timer2, 500 кГц, разгон MIN→MAX_RAPID_MOTION | | TIM6, 500 кГц | сим: 4902 шаг/с, плавная остановка |
| РГИ: Timer3, 250 кГц, разгон/торможение, x1 / x10 | INT2 + Timer3 | EXTI PE7 + TIM7 | сим: x1 по Z (100 шагов), x10 по X (400 шагов), точный возврат |
| Упоры: торможение до упора (Limit_Pos − Brake_Compens) | | код | сим: остановка ровно на упоре |
| Конус: X ведомая от Z (Cs/Cm) в тех же прерываниях | | код | сим |
| Тахометр: импульс на оборот шпинделя | вывод 42 | PE8 | сим: 20 импульсов на 20 оборотов |
| Угол шпинделя, требуемый угол метки делилки | | код | сим |
| Пересчёт шагов в мм (без DRO) | | код | код |
| Координаты от блока DRO HS800-2, знаки как у автора | Serial2 | USART2 PA3, `drv_dro` | ранее HIL с эмулятором; железо |
| Переменник подачи (АЦП, 16 отсчётов, мёртвая зона ±4) | A7 | PC1; включается `USE_FEED_POT` | код; железо |
| Округление позиции до целого шага при остановке джойстика | | код | сим |
| Порядок прерываний: не вытесняют друг друга | AVR | одинаковый приоритет | код |
| Длительность импульса STEP | время кода прерывания | не меньше 3 мкс (защита добавлена) | сим: Z ≥ 27 мкс, X ≥ 3.02 мкс |

## 3. Органы управления

| Что | У автора | На STM32 | Проверено |
|---|---|---|---|
| Переключатель режимов, 8 положений, проверка каждые 40 мс, писк | выводы 30–37 | PD0–PD3, PD6, PD7, PD10, PD11 | сим; железо |
| Переключатель подрежимов, 3 положения | A13/A14/A15 (по коду) | PC8 / PC9 / PC11 | сим; железо |
| Джойстик 4 направления, запрет движения без нейтрали при старте | A8–A11 | PB0, PB1, PE3, PB9 | сим; железо |
| Кнопка ускоренного хода (и «быстрее» для кнопок меню) | A12 | PB8 | сим |
| Кнопки меню Влево/Вправо/Вверх/Вниз/Выбор, автоповтор (DELAY_ENTER_KEYCYCLE) | A0–A4 | PB13, PB14, PB12, PD9, PB15 | код; железо |
| Кнопки упоров (только в подрежиме «Ручной», BACKLOG-022) | 22, 24, 26, 28 | PA0, PC2, PC4, PC5 | сим; железо |
| Светодиоды упоров, мигание (BLINC_TIME) | 23, 25, 27, 29 | PE2, PE4, PE5, PE6 | код; железо |
| «Волна» светодиодов при включении (2.4 с) | | код | железо |
| РГИ: каналы A/B | 19, 18 | PE7, PC13 | сим |
| РГИ: переключатель оси Z / выкл / X | 2, 3 | PC10, PC12 | сим |
| РГИ: масштаб x1 / x10 | 14, 15 | PA4, PD8 | сим |
| Зуммер: короткий / двойной / длинный / «завершено» | 16 | PE12 (через NPN-ключ, `BEEPER_ON_LEVEL`) | код; железо |
| Тачскрин дублирует кнопки и переключатели | | протокол дисплея | ранее автотесты дисплея; повторить на железе |

## 4. Меню (кнопки по режимам)

Экран переключается кнопкой «Выбор» (SelectMenu 1 → 2 → 3). Все обработчики — код автора без изменений (`Menu.ino`).

| Режим | Меню 1 | Меню 2 | Меню 3 |
|---|---|---|---|
| Синхронная | ▲▼ съём Ap (±0.02, с ускоренным ±0.10), ◀▶ число проходов | ▲ обнулить X, ▼ обнулить Z, ◀▶ линейка диаметра | ▲▼ натяг Z, ◀▶ отскок Z вкл/выкл |
| Асинхронная | ▲▼ съём Ap (±0.01 / ±0.05), ◀▶ проходы | ▲▼ число делений, ◀▶ текущая метка | ▲▼ обнуление осей, ◀▶ линейка |
| Резьба | ▲▼ шаг резьбы (по таблице), ◀▶ число проходов | ▲▼ число заходов Ph, ◀▶ чистовые проходы | ▲▼ обнуление осей, ◀▶ линейка |
| Конус < / > | ▲▼ съём, ◀▶ проходы | ◀▶ угол/конусность, ▲▼ конусная резьба вкл/выкл | ▲▼ обнуление осей, ◀▶ линейка |
| Шар | ▲▼ радиус шара, ◀▶ радиус ножки | ▲▼ ширина резца, ◀▶ шаг по Z | ▲▼ обнуление осей, ◀▶ линейка |
| Делилка | «Выбор» — обнулить угол | | |

Проверено: код; сим — смена режимов, подрежимов, шага резьбы, радиуса шара, конуса, делений с дисплея.

## 5. Индикация

| Что | У автора | На STM32 | Проверено |
|---|---|---|---|
| LCD2004 по I2C, русские буквы, свои значки (стрелки, °, ⌀) | библиотека LCDI2C | свой драйвер с теневым буфером, на I2C — только изменения | сим (содержимое экрана); железо |
| Все экраны Print(): 74 строки текста в 6 режимах × 3 меню | | код | сим частично; железо |
| Сообщения: «Установите джойстик в нейтральное», «Установите упоры!», «Установите суппорт в исходную позицию», «Операция завершена!» | | код | сим (упоры, завершено) |
| Заставка «www.chipmaker.ru … 7e2 V3.3» | | код | сим |
| Подписи осей на LCD — «Y» (версия с DRO) | в `main`-ветке — «Z» | как в версии с DRO | — |

## 6. Связь

| Что | У автора | На STM32 | Проверено |
|---|---|---|---|
| Протокол дисплея ESP32: 33 команды STM32 → дисплей (+ ERR, добавлен) (MODE, SUBMODE, FEED, AFEED, THREAD…, POS_Z/X, PASS, ALERT, LIMITS, ANGLE и др.) | SoftwareSerial / Serial3 | USART3 PB10/PB11, отправка без блокировки | сим (начальное состояние, режимы); ранее автотесты дисплея |
| Протокол дисплея: 44 команды дисплей → STM32 (KEY, M1–M8, S1–S3, AP:, FEED:, THREAD_STEP:, CONE:, DIVN:, JOY:*, EMUL:* …) | | без изменений | сим (FEED, AFEED, THREAD_STEP, CONE, PH, DIVN, DIVM, SPHERE, BAR, M1–M8, S1–S3, ALERT_OK) |
| Периодически: позиция и угол каждые 250 мс, PING каждые 10 с | | код | сим |
| Добавлено: DISP (сверка типа дисплея), RPM, LCD2004 (строка для автотестов), GCODE → «не поддерживается» | — | `[STM32]` | сим (LCD2004) |
| Отладочный порт: 41 команда (JL…JN, BU…BS, RAP/RAN, M1–M8, S1–S3, LL…LB, HZ/HX/HN, SC1/SC10, INFO, HELP, SEND, DINIT, DPING, AL1–AL4) | Serial | USART1 PA9/PA10, без изменений | код |
| Тестовые пресеты PT:1…PT:55 | | без изменений | код |
| Блок DRO HS800-2 | Serial2, 57600 | USART2 PA3, 57600 | ранее HIL с эмулятором |

## 7. Настройки (все — в `Core/els_config.h`)

ENC_LINE_PER_REV, MOTOR_Z/X_STEP_PER_REV, SCREW_Z/X, McSTEP_Z/X, REBOUND_X/Z, THRD_ACCEL, FEED_ACCEL,
MIN/MAX_FEED, MIN/MAX_aFEED, Excess_Lag, PASS_FINISH, MAX/MIN_RAPID_MOTION, REPEAt, HC_SCALE_1/10,
HC_START_SPEED_1/10, HC_MAX_SPEED_1/10, HC_X_DIR, HC_Z_DIR, LIN_X, BT_X, BLINC_TIME, BLINC_ON_OFF —
**все 32 параметра автора, те же имена и значения**. Проверки корректности автора (static_assert для
подач) сохранены. Внутренние константы (DELAY_ENTER_KEYCYCLE, ENC_TICK, LINEIKA, TENS, Limit_Pos_Max/Min,
таблицы) — в `e2_core.cpp`, как у автора.

Добавлено: источник координат, тип дисплея, адрес LCD, линейки, скорости связи, способ подключения
драйверов, длительность импульса STEP, полярность зуммера, переменник подачи, монитор входов.

## 8. Что сделано иначе, чем у автора (и почему)

| Что | Почему |
|---|---|
| «Шпиндель вращается» — по таймеру 1 с, а не по счёту проходов `loop()` | `loop()` на STM32 в десятки раз быстрее |
| Опрос клавиатуры — по `micros()` (40.06 мс), а не флаг Timer1 | нет AVR-таймера; период тот же |
| `millis()` не выключается (у автора `TIMSK0 = 0`) | нужен дисплею и LCD |
| LCD через теневой буфер | прямой вывод занимал бы почти весь цикл |
| Защита длительности импульса STEP | на конусе 45° пауза была бы 0.1 мкс |
| Без переменника подачи (`USE_FEED_POT 0`) стартовая подача — середина диапазона | висящий вход АЦП менял бы подачу сам |
| Таблицы резьб привязаны к механике (сборка не пройдёт при другой) | иначе смена винта молча портила бы резьбы |
| Кнопки упоров работают и при «Ручном», выбранном на экране (`LIMITS_BY_SELECTED_SUBMODE`, BACKLOG-022) | у автора нужен физический переключатель подрежима; во «Внутр./Наруж.» упор по-прежнему не переставить |
| Компенсация люфта винтов `BACKLASH_Z_UM` / `BACKLASH_X_UM` (0 — как у автора, BACKLOG-025) | у автора нет: ноль, взятый движением от детали, давал недорез на величину люфта |
| Значения, которые автор шлёт дисплею только целиком, уходят по изменению (`Display_Watch`) | иначе после кнопок пульта новый дисплей показывал устаревшее |
| Сообщения на новом дисплее горят, пока поднят флаг ядра | как надписи на LCD2004 |

## 9. Не решено (в BACKLOG.md)

- BACKLOG-020 — синхронная подача на 6–10 % меньше заданной (так у автора).
- BACKLOG-021 — механика станка в конфиге.
- GCode с дисплея на новом ядре не исполняется (у автора его не было; был в старом порту STM32) — BACKLOG-001.
- Сохранение настроек во Flash: у автора нет, в старом порту STM32 было — сейчас нет.

## 10. Что проверить на железе (по порядку)

1. Каждый вход — монитором входов (`IO_MONITOR`, отладочный порт 115200): режимы, подрежимы, 5 кнопок,
   джойстик, ускоренный ход, 4 упора, РГИ (A/B, ось, масштаб).
2. «Волна» светодиодов при включении, мигание светодиодов упоров, зуммер.
3. LCD2004: заставка, экраны всех режимов и меню.
4. Дисплей: автотесты `tools/run_all_tests.py`, `tools/run_test_cases.py`, `tools/ui_tap_tests.py`.
5. Блок DRO через эмулятор Mega (`tools/scales_hil_test.py`).
6. Энкодер шпинделя рукой — направление, обороты; затем моторы без нагрузки: подача, резьба, ускоренный ход.
