tepmehatop/Lathe-cnc-controller-stm32/docs/shield_recommendations.md

# Рекомендации по шилду и компонентам
## ELS STM32F4DISCOVERY Shield

---

## 1. Общие принципы

### Уровни логики
- STM32F407 работает на **3.3В**
- Периферия (драйверы моторов, энкодеры) часто работает на **5В**
- **НЕЛЬЗЯ** подавать 5В на пины STM32 напрямую — выгорит
- Решение: резисторные делители или 5В-tolerant пины STM32 (помечены FT в datasheet)

### STM32F407 — FT (5V tolerant) пины
Пины PE, PD, PB (кроме PB3), PA (кроме PA5) — **5V tolerant**.
Остальные: только 3.3В!

---

## 2. Защитные резисторы на выходах (OUTPUT)

Устанавливать **последовательно** в каждую выходную линию.

| Применение | Номинал | Назначение |
|---|---|---|
| STEP/DIR/EN к драйверам моторов | **100 Ом** | Защита от КЗ, фильтрация EMI |
| UART TX к ESP32 | **33 Ом** | Согласование импеданса |
| Тахометр выход | **470 Ом** | Токоограничение |
| Beeper (зуммер) | **100 Ом** | Защита таймера |
| LED выходы | **470 Ом** | Токоограничение LED (15мА при 3.3В) |
| Общий выход GPIO | **33-100 Ом** | Минимальная защита |

**Размещение:** максимально близко к пину МК (до 5мм).

---

## 3. Подтягивающие резисторы (PULLUP) на входах (INPUT)

### I2C (LCD2004)
```
3.3V ──┬── 4.7кОм ──── SCL (PB6)
       └── 4.7кОм ──── SDA (PB7)
```
- Номинал: **4.7 кОм** при 400кГц, **2.2 кОм** при 1МГц
- К **3.3В** (не к 5В! LCD2004 работает от 5В но I2C на 3.3В через PCF8574)

### Энкодеры (шпиндель, ручной)
```
3.3V ── 4.7кОм ── PA0 (Enc A)
3.3V ── 4.7кОм ── PA1 (Enc B)
```
- Номинал: **4.7 кОм**
- Если энкодер с открытым коллектором: обязательно
- Если Push-Pull выход: можно не ставить (использовать внутренние STM32)

### Кнопки меню, лимиты, джойстик
```
3.3V ── 10кОм ── PGx (кнопка) ──── GND (кнопка)
```
- Номинал: **10 кОм** — медленные сигналы, можно большой номинал
- Или использовать внутренние PULLUP STM32 (40-50кОм встроенные)
- Рекомендуется внешние 10кОм для надёжности в условиях помех станка

### Переключатели Mode (8 позиций), Submode
```
3.3V ── 1кОм ── PGx ── SW ── GND
```
- Номинал: **1 кОм** (оригинальный код Arduino требовал именно 1кОм внешних)
- Критично: без этих резисторов при открытом SW пин "висит в воздухе"

---

## 4. Развязывающие конденсаторы (Decoupling)

### На питании шилда
Размещать максимально близко к разъёмам питания.

| Место | Ёмкость | Тип |
|---|---|---|
| 3.3В шина (основная) | **100 мкФ** электролит + **100 нФ** керамика | Bulk + HF filter |
| 5В шина (если есть) | **100 мкФ** + **100 нФ** | То же |
| Каждый IC на шилде | **100 нФ** керамика | Максимально близко к VCC пину |

### Типовая схема развязки для каждого разъёма питания
```
VCC ──┬── [100 мкФ/16В] ── GND    (электролит, bulk)
      └── [100 нФ/50В]  ── GND    (керамика X7R, высокочастотный)
```

---

## 5. Защита входов (ESD)

### TVS диоды на длинных кабелях (> 30см)
Для пинов к которым подключены длинные провода (лимиты, кнопки на станке):
- **PRTR5V0U2X** (SOT363) — двунаправленный TVS, 5.5В, 2 линии
- Или просто RC фильтр: **100 Ом** + **10 нФ** на каждую линию

### RC фильтр для подавления дребезга кнопок
```
Кнопка ── 100 Ом ── STM32 pin
                 └── 10 нФ ── GND
```
- Постоянная времени: 100Ом × 10нФ = 1 мкс (отлично для дребезга)
- Программный дебаунс в коде: дополнительно 5-20мс

---

## 6. Транзисторный ключ для зуммера

STM32 не может напрямую驱动ить зуммер 5В. Нужен ключ:

```
PD12 ── 1кОм ── база BC547 (NPN)
                коллектор ── зуммер ── 5В
                эмиттер  ── GND
```

Или использовать 3.3В зуммер напрямую через 100Ом.

---

## 7. Уровни сигналов — 5В → 3.3В конвертеры

### UART (DRO HS800-2)
HS800-2 работает на 3.3В (STM32F030 на плате).
**Конвертер не нужен.**

### ESP32-S3
ESP32-S3 работает на 3.3В.
**Конвертер не нужен.**

### Драйверы шаговых моторов (5В логика)
STEP/DIR/EN от STM32 (3.3В) → драйвер (5В вход).
- Большинство драйверов (A4988, DRV8825, TMC2208) принимают 3.3В сигналы
- Если нет: буфер **74HCT245** (3.3В вход, 5В выход)

### Энкодер шпинделя (5В питание)
Если энкодер с Push-Pull выходом на 5В → на пин STM32:
- STM32 пины PA0, PA1 — FT (5V tolerant), без конвертера
- Для других пинов: делитель **4.7кОм / 10кОм**

---

## 8. Питание шилда

### Схема питания
```
Внешнее 12В (блок питания станка)
    │
    ├── DC-DC 5В (LM2596 или 78M05): → питание драйверов, 5В периферии
    │       │
    └── DC-DC 3.3В (AMS1117-3.3 или LDO): → STM32F4DISCOVERY 3.3В вход
                                              → I2C pullups
                                              → логика входов
```

### Важно
- **Не запитывать STM32 от USB и от внешнего питания одновременно** без развязывающего диода
- STM32F4DISCOVERY потребляет до **500мА** в максимуме
- Общий GND для всех источников питания обязателен

---

## 9. Рекомендуемый BOM (Bill of Materials) для шилда

| Компонент | Номинал | Кол-во | Назначение |
|---|---|---|---|
| Резистор 33 Ом | 0805 | 4 | UART TX защита |
| Резистор 100 Ом | 0805 | 10 | Step/Dir/En, Beeper |
| Резистор 470 Ом | 0805 | 6 | LED лимиты, Tacho |
| Резистор 1 кОм | 0805 | 12 | Mode/Submode SW pullup |
| Резистор 4.7 кОм | 0805 | 6 | I2C pullup, Encoder |
| Резистор 10 кОм | 0805 | 12 | Кнопки pullup |
| Конденсатор 10 нФ | 0805 | 10 | RC фильтр кнопок |
| Конденсатор 100 нФ | 0805 | 15 | Развязка питания |
| Конденсатор 100 мкФ 16В | TS (сквозной) | 4 | Bulk питание |
| BC547 NPN транзистор | TO-92 | 1 | Зуммер |
| AMS1117-3.3 | SOT-223 | 1 | LDO 3.3В |
| DC-DC 5В модуль | LM2596 модуль | 1 | 5В питание |
| Разъёмы | 2.54мм, 2 ряда | по схеме | Подключение периферии |

---

## 10. Рекомендации по разводке PCB

1. **Полигон GND** под всей платой (copper pour GND)
2. Силовые линии (питание моторов): ширина дорожки ≥ **1мм**
3. Сигнальные линии: ширина ≥ **0.25мм**
4. **Звёздная топология GND** — силовой GND и сигнальный GND соединять в одной точке
5. Развязывающие конденсаторы: размещать **до 5мм** от VCC пина IC
6. Кварц (если будет внешний): защитный полигон GND вокруг
7. STEP/DIR линии: держать подальше от UART и I2C (помехи от ШИМ)
