tepmehatop/Lathe-cnc-controller-stm32/docs/pinout.html

# ELS — Электронная Гитара Токарного Станка STM32F4DISCOVERY (STM32F407VGT6) — Схема подключения v1.0

⚡ Полная схема (визуальная)

📦 Блок-диаграмма

🔲 Пины МК (Chip View)

📋 Таблица пинов

＋ Увеличить － Уменьшить ⌂ Сбросить 100% ⚠ Предварительная схема — пины уточняются при разводке шилда. Актуальные значения: Core/els_config.h

UART

I2C

Шаговые моторы

Энкодеры

Кнопки/Джойстик

Лимиты/LED

Прочее

UART

I2C

Шаговые моторы

Энкодеры

Кнопки / Джойстик

Лимиты / LED

Прочее

### 🔌 DRO HS800-2

Протокол: UART 57600/8N1
Пакет: 29 байт, CRC16/MODBUS
TX → PA3 (USART2 RX)
GND → GND
Уровни: 3.3В (совместим)

### 🖥 LCD2004 (старый дисплей)

Протокол: I2C @ 400кГц
Адрес: 0x27 (PCF8574)
SDA → PB7 (I2C1)
SCL → PB6 (I2C1)
VCC: 5В, GND: GND

### 🔄 Энкодер шпинделя

1800 линий/оборот
Ch A → PA0 (TIM5_CH1 / EXTI0)
Ch B → PA1 (TIM5_CH2 / EXTI1)
VCC: 5В, GND: GND
Режим: счётчик таймера или EXTI

### 🎛 Ручной энкодер (100 линий)

Ch A → PC2 (EXTI2)
Ch B → PC3 (EXTI3)
Ось Z/X → PD0, PD1
Шаг ×1/×10 → PD2, PD3
Подтяжка: внутренняя PULLUP

### 🕹 Джойстик + Rapid

Влево → PC4
Вправо → PC5
Вверх → PC6
Вниз → PC7
Rapid → PC8
Активный уровень: LOW (подтяжка PULLUP)

## STM32F407VGT6

STM32F4DISCOVERY

🔧 168 МГц Cortex-M4F
💾 1 MB Flash / 192 KB RAM
⚡ FPU (float без задержек)
📡 6× UART + DMA
🔗 2× I2C
⏱ 14× 16/32-bit Timers
🔌 2× CAN (запас)
📺 USB OTG FS/HS
─────────────────
🔴 Занято на плате:
PA0 — USER BTN ⚠
PD12-15 — LEDs ⚠
PB3 — SWO debug
PA13/PA14 — SWD

⚠ Пины могут быть переназначены
под разводку шилда

### 📺 ESP32-S3 JC4827W543 (новый дисплей)

Протокол: UART 115200/8N1
TX → PE0 (UART8 TX)
RX ← PE1 (UART8 RX)
ESP32 GPIO44 (RX) ← PE0
ESP32 GPIO43 (TX) → PE1
DMA: обновление без блокировки CPU

### ⚙ Мотор Y (продольная)

Драйвер: шаговый (Step/Dir/En)
STEP → PE9 (TIM1_CH1)
DIR → PE10
EN → PE11
Таймер TIM1, DMA для импульсов

### ⚙ Мотор X (поперечная)

Драйвер: шаговый (Step/Dir/En)
STEP → PE13 (TIM1_CH3)
DIR → PE14
EN → PE15
Таймер TIM1, общий с Y

### 🛑 Лимитные выключатели + LED

BTN Left → PF0 | LED Left → PF1
BTN Right → PF2 | LED Right → PF3
BTN Front → PF4 | LED Front → PF5
BTN Rear → PF6 | LED Rear → PF7
Кнопки: PULLUP, активный LOW
LED: открытый коллектор, 470Ом

### 🔘 Кнопки меню + Переключатели

BTN Left/Right/Up/Down → PG0-PG3
BTN Select → PG4
Submode SW (3 pos) → PG5, PG6, PG7
Mode SW (8 pos) → PG8-PG15
Tacho out → PE8
Beeper → PD12 (TIM4_CH1)

⚠ Примечание: Данная схема — предварительная. Пины будут уточнены при разработке шилда. Все назначения вынесены в Core/els_config.h — достаточно изменить один файл. | Питание 3.3В для сигналов. Для 5В-периферии (LCD2004, драйверы) — уровень питания через шилд.

Стиль STM32CubeMX: Показаны ключевые назначенные пины. Наведи мышь на пин для описания. Красные пины — занято онбордом DISCOVERY. Серые — не используются в проекте.

⚠ Предварительно: Пины будут уточнены. Все значения задаются в Core/els_config.h. Колонка "Mega" — исходный пин Arduino Mega для сравнения.

STM32 Пин ↕ | Функция ↕ | Описание | Направление | Mega (было) | Категория
PA3 | USART2_RX | DRO HS800-2 приём | INPUT | Pin17 RX2 | UART
PE0 | UART8_TX | ESP32-S3 отправка (DMA) | OUTPUT | Pin51 SW-TX | UART
PE1 | UART8_RX | ESP32-S3 приём (DMA) | INPUT | Pin52 SW-RX | UART
PA9 | USART1_TX | Debug / Serial Monitor | OUTPUT | Pin1 TX0 | UART
PA10 | USART1_RX | Debug / Serial Monitor | INPUT | Pin0 RX0 | UART
PB6 | I2C1_SCL | LCD2004 тактирование | OUTPUT OD | Pin21 SCL | I2C
PB7 | I2C1_SDA | LCD2004 данные | BIDIR OD | Pin20 SDA | I2C
PA0 | TIM5_CH1 | Энкодер шпинделя Ch A (1800 лин) | INPUT | Pin21 INT0 | Энкодер
PA1 | TIM5_CH2 | Энкодер шпинделя Ch B | INPUT | Pin20 INT1 | Энкодер
PC2 | EXTI2 | Ручной энкодер Ch A | INPUT PU | Pin19 PD2 | Энкодер
PC3 | EXTI3 | Ручной энкодер Ch B | INPUT PU | Pin18 PD3 | Энкодер
PD0 | GPIO_IN | Ручной энкодер: ось Z/X sw1 | INPUT PU | Pin58 PE4 | Энкодер
PD1 | GPIO_IN | Ручной энкодер: ось Z/X sw2 | INPUT PU | Pin59 PE5 | Энкодер
PD2 | GPIO_IN | Шаг ×1 (Scale Switch) | INPUT PU | Pin15 PJ0 | Энкодер
PD3 | GPIO_IN | Шаг ×10 (Scale Switch) | INPUT PU | Pin14 PJ1 | Энкодер
PE9 | TIM1_CH1 | Мотор Y (продольная) STEP | OUTPUT | Pin49 PL0 | Мотор
PE10 | GPIO_OUT | Мотор Y DIR (CW/CCW) | OUTPUT | Pin43 PL6 | Мотор
PE11 | GPIO_OUT | Мотор Y ENABLE | OUTPUT | Pin45 PL4 | Мотор
PE13 | TIM1_CH3 | Мотор X (поперечная) STEP | OUTPUT | Pin48 PL1 | Мотор
PE14 | GPIO_OUT | Мотор X DIR | OUTPUT | Pin44 PL5 | Мотор
PE15 | GPIO_OUT | Мотор X ENABLE | OUTPUT | Pin46 PL3 | Мотор
PC4 | GPIO_IN | Джойстик Влево | INPUT PU | A8 PK0 | Кнопки
PC5 | GPIO_IN | Джойстик Вправо | INPUT PU | A9 PK1 | Кнопки
PC6 | GPIO_IN | Джойстик Вверх | INPUT PU | A10 PK2 | Кнопки
PC7 | GPIO_IN | Джойстик Вниз | INPUT PU | A11 PK3 | Кнопки
PC8 | GPIO_IN | Кнопка Rapid | INPUT PU | A12 PK4 | Кнопки
PG0 | GPIO_IN | Кнопка меню Влево | INPUT PU | A0 PF0 | Кнопки
PG1 | GPIO_IN | Кнопка меню Вправо | INPUT PU | A1 PF1 | Кнопки
PG2 | GPIO_IN | Кнопка меню Вверх | INPUT PU | A2 PF2 | Кнопки
PG3 | GPIO_IN | Кнопка меню Вниз | INPUT PU | A3 PF3 | Кнопки
PG4 | GPIO_IN | Кнопка Select | INPUT PU | A4 PF4 | Кнопки
PG5 | GPIO_IN | Submode SW: Внутренний | INPUT PU | A13 PK5 | Кнопки
PG6 | GPIO_IN | Submode SW: Ручной | INPUT PU | A14 PK6 | Кнопки
PG7 | GPIO_IN | Submode SW: Наружный | INPUT PU | A15 PK7 | Кнопки
PG8 | GPIO_IN | Mode SW: бит 0 (Mode_Feed) | INPUT PU | PC0 Pin37 | Кнопки
PG9 | GPIO_IN | Mode SW: бит 1 | INPUT PU | PC1 Pin36 | Кнопки
PG10 | GPIO_IN | Mode SW: бит 2 | INPUT PU | PC2 Pin35 | Кнопки
PG11 | GPIO_IN | Mode SW: бит 3 | INPUT PU | PC3 Pin34 | Кнопки
PG12 | GPIO_IN | Mode SW: бит 4 | INPUT PU | PC4 Pin33 | Кнопки
PG13 | GPIO_IN | Mode SW: бит 5 | INPUT PU | PC5 Pin32 | Кнопки
PG14 | GPIO_IN | Mode SW: бит 6 | INPUT PU | PC6 Pin31 | Кнопки
PG15 | GPIO_IN | Mode SW: бит 7 | INPUT PU | PC7 Pin30 | Кнопки
PF0 | GPIO_IN | Лимит BTN Влево | INPUT PU | Pin22 PA0 | Лимиты
PF1 | GPIO_OUT | Лимит LED Влево | OUTPUT | Pin29 PA7 | Лимиты
PF2 | GPIO_IN | Лимит BTN Вправо | INPUT PU | Pin24 PA2 | Лимиты
PF3 | GPIO_OUT | Лимит LED Вправо | OUTPUT | Pin27 PA5 | Лимиты
PF4 | GPIO_IN | Лимит BTN Вперёд | INPUT PU | Pin26 PA4 | Лимиты
PF5 | GPIO_OUT | Лимит LED Вперёд | OUTPUT | Pin25 PA3 | Лимиты
PF6 | GPIO_IN | Лимит BTN Назад | INPUT PU | Pin28 PA6 | Лимиты
PF7 | GPIO_OUT | Лимит LED Назад | OUTPUT | Pin23 PA1 | Лимиты
PE8 | GPIO_OUT | Тахометр выход | OUTPUT | Pin42 PL7 | Прочее
PD12 | TIM4_CH1 | Зуммер (PWM тон) | OUTPUT | Pin16 PH1 | Прочее

Всего пинов: 45 | PU = Pull-Up | OD = Open-Drain
