tepmehatop/Lathe-cnc-controller-stm32/docs/img/screen_joystick.jpg

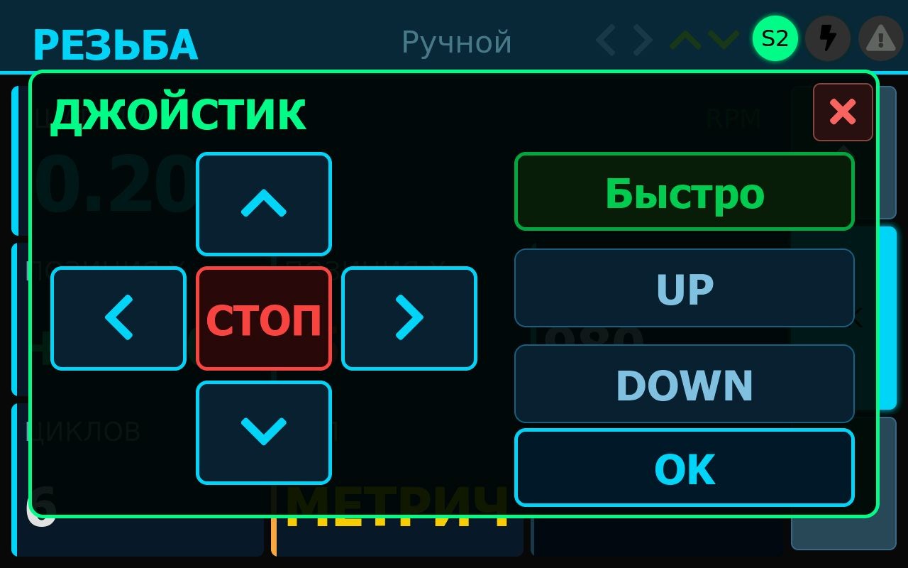
docs/img/screen_joystick.jpg
