tepmehatop/Lathe-cnc-controller-stm32/docs/img/screen_modes.jpg

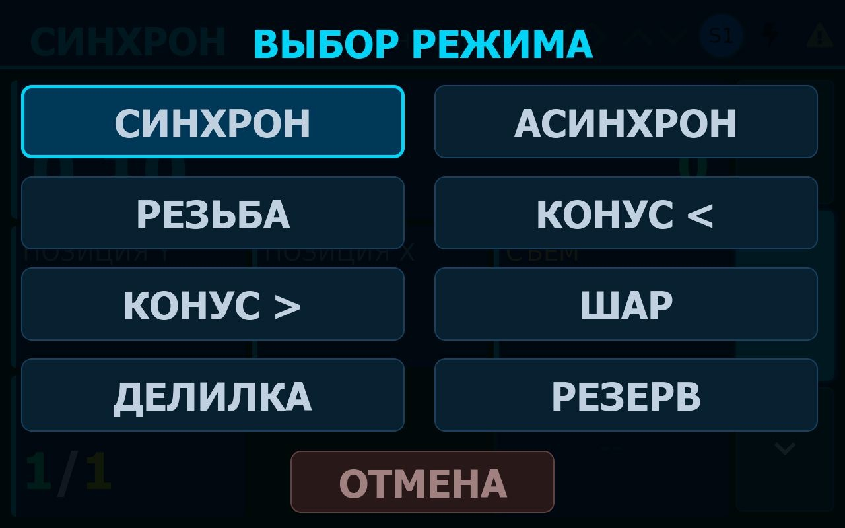
docs/img/screen_modes.jpg
