tepmehatop/Lathe-cnc-controller-stm32/hardware/shield/bom.md

# Список деталей шилда

Сгенерировано `gen_bom.py` из `design.py`.

| Кол-во | Деталь | Номинал | Позиции |
|---|---|---|---|
| 4 | Вилка 2 конт., шаг 2.54 мм, прямая, с защёлкой (KF2510-2P / Molex KK-254) + ответная часть |  | J3 J15 J20 J24 |
| 4 | Вилка 3 конт., шаг 2.54 мм, прямая, с защёлкой (KF2510-3P / Molex KK-254) + ответная часть |  | J16 J17 J21 J25 |
| 7 | Вилка 4 конт., шаг 2.54 мм, прямая, с защёлкой (KF2510-4P / Molex KK-254) + ответная часть |  | J4 J8 J13 J18 J19 J26 J27 |
| 5 | Вилка 5 конт., шаг 2.54 мм, прямая, с защёлкой (KF2510-5P / Molex KK-254) + ответная часть |  | J11 J12 J14 J22 J23 |
| 4 | Вилка 6 конт., шаг 2.54 мм, прямая, с защёлкой (KF2510-6P / Molex KK-254) + ответная часть |  | J5 J6 J9 J10 |
| 1 | Вилка IDC 2×5 в корпусе (box header), шаг 2.54 мм, прямая |  | J7 |
| 1 | Гнездо (female) 2×25, шаг 2.54 мм, прямое — под Discovery | Discovery P1 | J1 |
| 1 | Гнездо (female) 2×25, шаг 2.54 мм, прямое — под Discovery | Discovery P2 | J2 |
| 1 | Диод Шоттки SOD-123, 1 А 40 В (B5819W или 1N5819W); полоска на корпусе — катод | B5819W | D1 |
| 3 | Конденсатор керамический SMD 0805, X7R, 16 В и выше | 100nF | C5 C6 C7 |
| 3 | Конденсатор керамический SMD 0805, X7R, 16 В и выше | 10nF | C3 C4 C9 |
| 2 | Конденсатор керамический SMD 0805, X7R, 16 В и выше | 1nF | C1 C2 |
| 1 | Конденсатор керамический SMD 1206, X5R | 22uF 10V | C8 |
| 1 | Резистор SMD 0805, 5 % | 100 | R20 |
| 7 | Резистор SMD 0805, 5 % | 10k | R3 R5 R7 R9 R11 R13 R15 |
| 41 | Резистор SMD 0805, 5 % | 1k | R101 R102 R103 R104 R105 R106 R107 R108 R109 R110 R111 R112 R113 R114 R115 R116 R117 R118 R119 R120 R121 R122 R123 R124 R125 R126 R127 R128 R129 R130 R131 R132 R133 R2 R4 R6 R8 R10 R12 R14 R134 |
| 6 | Резистор SMD 0805, 5 % | 220 | R16 R17 R18 R19 R28 R30 |
| 8 | Резистор SMD 0805, 5 % | 470 | R21 R22 R23 R24 R25 R26 R31 R32 |
| 7 | Транзистор NPN SMD SOT-23 (MMBT3904, маркировка 1A; аналог MMBT2222A) | MMBT3904 | Q1 Q2 Q3 Q4 Q5 Q6 Q7 |
