tepmehatop/Lathe-cnc-controller-stm32/docs/wiring/pins.md

# Выводы STM32F4DISCOVERY — что куда подключать

Сгенерировано из `Core/e2/e2_pins.h` и `Core/els_config.h` скриптом `tools/docs_gen/wiring_svg.py`.
Карта разъёмов — [discovery_pinout.svg](discovery_pinout.svg). «Mega» — вывод в оригинальной схеме 7e2.

Колонка «Шилд» — разъём и вывод на шилде ([docs/assembly](../assembly/README.md)); PA2 и PD4 на шилде
наружу не выводятся.

| Что подключить | Вывод STM32 | Штырёк на плате | Шилд | Mega (7e2) | Как |
|---|---|---|---|---|---|
| Энкодер шпинделя, канал A | **PA1** | P1-11 | J4-3 A | 21, INT0 + T5/47 | подтяжка 1k к 3V; см. схему энкодера |
| Энкодер шпинделя, канал B | **PA8** | P2-43 | J4-4 B | 20 | подтяжка 1k к 3V; см. схему энкодера |
| Драйвер Z (каретка): STEP | **PE9** | P1-27 | J5-2 PUL- | 49 | через NPN-ключ, см. схему драйверов |
| Драйвер Z: DIR | **PE10** | P1-28 | J5-4 DIR- | 43 | через NPN-ключ, см. схему драйверов |
| Драйвер Z: ENA | **PE11** | P1-29 | J5-6 ENA- | 45 | через NPN-ключ, см. схему драйверов |
| Драйвер X (суппорт): STEP | **PE13** | P1-31 | J6-2 PUL- | 48 | через NPN-ключ, см. схему драйверов |
| Драйвер X: DIR | **PE14** | P1-32 | J6-4 DIR- | 44 | через NPN-ключ, см. схему драйверов |
| Драйвер X: ENA | **PE15** | P1-33 | J6-6 ENA- | 46 | через NPN-ключ, см. схему драйверов |
| РГИ, канал A | **PE7** | P1-25 | J13-3 A | 19, INT2 | подтяжка 1k к 3V (+10 нФ на A и B) |
| РГИ, канал B | **PC13** | P2-12 | J13-4 B | 18 | подтяжка 1k к 3V (+10 нФ на A и B) |
| РГИ: переключатель оси — Z | **PC10** | P2-37 | J14-1 Z | 2 | подтяжка 1k к 3V (+10 нФ на A и B) |
| РГИ: переключатель оси — X | **PC12** | P2-35 | J14-2 X | 3 | подтяжка 1k к 3V (+10 нФ на A и B) |
| РГИ: масштаб ×1 | **PA4** | P1-16 | J14-3 x1 | 14 | подтяжка 1k к 3V (+10 нФ на A и B) |
| РГИ: масштаб ×10 | **PD8** | P1-40 | J14-4 x10 | 15 | подтяжка 1k к 3V (+10 нФ на A и B) |
| Режим: Синхронная подача | **PD0** | P2-36 | J7-1 M1 | 30 | контакт переключателя на GND, подтяжка 1k к 3V |
| Режим: Асинхронная подача | **PD1** | P2-33 | J7-2 M2 | 31 | контакт переключателя на GND, подтяжка 1k к 3V |
| Режим: Конус < | **PD2** | P2-34 | J7-4 M4 | 32 | контакт переключателя на GND, подтяжка 1k к 3V |
| Режим: Конус > | **PD3** | P2-31 | J7-5 M5 | 33 | контакт переключателя на GND, подтяжка 1k к 3V |
| Режим: Резьба | **PD6** | P2-30 | J7-3 M3 | 34 | контакт переключателя на GND, подтяжка 1k к 3V |
| Режим: Шар | **PD7** | P2-27 | J7-6 M6 | 35 | контакт переключателя на GND, подтяжка 1k к 3V |
| Режим: Делилка | **PD10** | P1-42 | J7-7 M7 | 36 | контакт переключателя на GND, подтяжка 1k к 3V |
| Режим: Резерв | **PD11** | P1-43 | J7-8 M8 | 37 | контакт переключателя на GND, подтяжка 1k к 3V |
| Подрежим: Внутренний | **PC8** | P2-45 | J8-1 ВНУТ | A13 | контакт переключателя на GND, подтяжка 1k к 3V |
| Подрежим: Ручной | **PC9** | P2-46 | J8-2 РУЧ | A14 | контакт переключателя на GND, подтяжка 1k к 3V |
| Подрежим: Наружный | **PC11** | P2-38 | J8-3 НАР | A15 | контакт переключателя на GND, подтяжка 1k к 3V |
| Кнопка меню Влево | **PB13** | P1-37 | J9-1 ЛЕВ | A0 | кнопка на GND, подтяжка 1k к 3V |
| Кнопка меню Вправо | **PB14** | P1-38 | J9-2 ПРАВ | A1 | кнопка на GND, подтяжка 1k к 3V |
| Кнопка меню Вверх | **PB12** | P1-36 | J9-3 ВВЕРХ | A2 | кнопка на GND, подтяжка 1k к 3V |
| Кнопка меню Вниз | **PD9** | P1-41 | J9-4 ВНИЗ | A3 | кнопка на GND, подтяжка 1k к 3V |
| Кнопка меню Выбор | **PB15** | P1-39 | J9-5 ВЫБ | A4 | кнопка на GND, подтяжка 1k к 3V |
| Джойстик Влево | **PB0** | P1-22 | J10-1 ЛЕВ | A8 | контакт на GND, подтяжка 1k к 3V |
| Джойстик Вправо | **PB1** | P1-21 | J10-2 ПРАВ | A9 | контакт на GND, подтяжка 1k к 3V |
| Джойстик Вверх (на себя) | **PE3** | P2-16 | J10-3 ВВЕРХ | A10 | контакт на GND, подтяжка 1k к 3V |
| Джойстик Вниз (от себя) | **PB9** | P2-20 | J10-4 ВНИЗ | A11 | контакт на GND, подтяжка 1k к 3V |
| Кнопка ускоренного хода | **PB8** | P2-19 | J10-5 БЫСТР | A12 | контакт на GND, подтяжка 1k к 3V |
| Кнопка упора Левый | **PC5** | P1-19 | J11-1 ЛЕВ | 28 | кнопка на GND / светодиод от 3V через 220 Ом |
| Кнопка упора Правый | **PC4** | P1-20 | J11-2 ПРАВ | 26 | кнопка на GND / светодиод от 3V через 220 Ом |
| Кнопка упора Передний | **PC2** | P1-10 | J11-3 ПЕРЕД | 24 | кнопка на GND / светодиод от 3V через 220 Ом |
| Кнопка упора Задний | **PA0** | P1-12 | J11-4 ЗАД | 22 | кнопка на GND / светодиод от 3V через 220 Ом |
| Светодиод упора Левый | **PE6** | P2-11 | J12-2 ЛЕВ | 29 | кнопка на GND / светодиод от 3V через 220 Ом |
| Светодиод упора Правый | **PE5** | P2-14 | J12-3 ПРАВ | 27 | кнопка на GND / светодиод от 3V через 220 Ом |
| Светодиод упора Передний | **PE4** | P2-13 | J12-4 ПЕРЕД | 25 | кнопка на GND / светодиод от 3V через 220 Ом |
| Светодиод упора Задний | **PE2** | P2-15 | J12-5 ЗАД | 23 | кнопка на GND / светодиод от 3V через 220 Ом |
| Тахометр (выход: импульс на оборот) | **PE8** | P1-26 | J16-3 ИМП | 42 | см. схему |
| Зуммер | **PE12** | P1-30 | J15-2 - | 16 | см. схему |
| Переменный резистор подачи (средний вывод) | **PC1** | P1-7 | J17-2 СР | A7 | см. схему |
| LCD2004 (I2C): SCL | **PB6** | P2-23 | J18-4 SCL |  | см. схему связи |
| LCD2004 (I2C): SDA | **PB7** | P2-24 | J18-3 SDA |  | см. схему связи |
| Дисплей ESP32: TX STM32 → RX дисплея | **PB10** | P1-34 | J19-3 TX |  | см. схему связи |
| Дисплей ESP32: RX STM32 ← TX дисплея | **PB11** | P1-35 | J19-4 RX |  | см. схему связи |
| Блок DRO HS800-2: его TX → сюда | **PA3** | P1-13 | J20-2 RX |  | см. схему связи |
| Отладочный порт (USB-UART): TX | **PA9** | P2-44 | J21-2 TX |  | см. схему связи |
| Отладочный порт (USB-UART): RX | **PA10** | P2-41 | J21-3 RX |  | см. схему связи |
| — (служебный: держит аудиочип платы выключенным) | **PD4** | P2-32 | — |  | см. схему связи |
| Линейка Z: A / такт | **PA15** | P2-40 | J22-3 A |  | см. docs/scales |
| Линейка Z: B / данные | **PB3** | P2-28 | J22-4 B |  | см. docs/scales |
| Линейка Z: REQ (Digimatic) | **PC6** | P2-47 | J22-5 REQ |  | см. docs/scales |
| Линейка X: A / такт | **PB4** | P2-25 | J23-3 A |  | см. docs/scales |
| Линейка X: B / данные | **PB5** | P2-26 | J23-4 B |  | см. docs/scales |
| Линейка X: REQ (Digimatic) | **PC7** | P2-48 | J23-5 REQ |  | см. docs/scales |
| Датчик / щуп (резерв) | **PA2** | P1-14 | J25-3 ВХ |  | резерв: датчик — подтяжка 1k и 10 нФ, выходы — 220 Ом, вход/выход — 470 Ом |
| Резервный выход PD13 (на Discovery — LD3) | **PD13** | P1-45 | J26-3 D13 |  | резерв: датчик — подтяжка 1k и 10 нФ, выходы — 220 Ом, вход/выход — 470 Ом |
| Резервный выход PD15 (на Discovery — LD6) | **PD15** | P1-47 | J26-4 D15 |  | резерв: датчик — подтяжка 1k и 10 нФ, выходы — 220 Ом, вход/выход — 470 Ом |
| Резервный вход/выход 1 (АЦП, ЦАП) | **PA5** | P1-15 | J27-3 A5 |  | резерв: датчик — подтяжка 1k и 10 нФ, выходы — 220 Ом, вход/выход — 470 Ом |
| Резервный вход/выход 2 (АЦП) | **PA7** | P1-17 | J27-4 A7 |  | резерв: датчик — подтяжка 1k и 10 нФ, выходы — 220 Ом, вход/выход — 470 Ом |

Питание: **3V** (P2-5, P2-6) — для подтяжек и светодиодов (до 100 мА); **5V** (P2-3, P2-4) — вход 5 В
для платы, когда она не питается по USB; **GND** — P1-1, P1-2, P1-5, P1-23, P1-49, P1-50, P2-1, P2-2, P2-49, P2-50.
