tepmehatop/Lathe-cnc-controller-stm32/docs/wiring.html

# Схема подключения

STM32F4DISCOVERY · шилд rev 2 · данные из прошивки и платы KiCad

＋− ВписатьКолесо — масштаб, перетаскивание — сдвиг. Наведите на вывод, провод или клемму — подсветится вся цепь; клик — закрепить.

Плата — вид сверху, как стоит на шилде: P1 слева, P2 справа, вывод 1 — квадратный, вверху слева. На линии — детали, которые уже стоят на шилде («1k↑3V» — подтяжка 1 кОм к 3 В). Серые выводы — питание или свободные. Под клеммой модуля — разъём и вывод шилда.

Шилд сверху, Discovery снята. Наведите на вывод разъёма — куда он идёт на Discovery и к какой клемме модуля. Квадратный вывод — первый.

Сигнал | STM32 | Discovery | Шилд | Модуль: клемма | Детали на шилде | Mega (7e2)
Энкодер шпинделя, канал A | PA1 | P1-11 | J4-3 A | Энкодер шпинделя: A — чёрный | 1k↑3V · 1 нФ | 21, INT0 + T5/47
Энкодер шпинделя, канал B | PA8 | P2-43 | J4-4 B | Энкодер шпинделя: B — белый | 1k↑3V · 1 нФ | 20
Драйвер Z (каретка): STEP | PE9 | P1-27 | J5-2 PUL- | Драйвер мотора Z: PUL− | ключ NPN | 49
Драйвер Z: DIR | PE10 | P1-28 | J5-4 DIR- | Драйвер мотора Z: DIR− | ключ NPN | 43
Драйвер Z: ENA | PE11 | P1-29 | J5-6 ENA- | Драйвер мотора Z: ENA− | ключ NPN | 45
Драйвер X (суппорт): STEP | PE13 | P1-31 | J6-2 PUL- | Драйвер мотора X: PUL− | ключ NPN | 48
Драйвер X: DIR | PE14 | P1-32 | J6-4 DIR- | Драйвер мотора X: DIR− | ключ NPN | 44
Драйвер X: ENA | PE15 | P1-33 | J6-6 ENA- | Драйвер мотора X: ENA− | ключ NPN | 46
РГИ, канал A | PE7 | P1-25 | J13-3 A | Маховичок РГИ: A | 1k↑3V · 10 нФ | 19, INT2
РГИ, канал B | PC13 | P2-12 | J13-4 B | Маховичок РГИ: B | 1k↑3V · 10 нФ | 18
РГИ: переключатель оси — Z | PC10 | P2-37 | J14-1 Z | Переключатели РГИ: ось Z | 1k↑3V | 2
РГИ: переключатель оси — X | PC12 | P2-35 | J14-2 X | Переключатели РГИ: ось X | 1k↑3V | 3
РГИ: масштаб ×1 | PA4 | P1-16 | J14-3 x1 | Переключатели РГИ: ×1 | 1k↑3V | 14
РГИ: масштаб ×10 | PD8 | P1-40 | J14-4 x10 | Переключатели РГИ: ×10 | 1k↑3V | 15
Режим: Синхронная подача | PD0 | P2-36 | J7-1 M1 | Галетник режимов: M1 синхр. подача | 1k↑3V | 30
Режим: Асинхронная подача | PD1 | P2-33 | J7-2 M2 | Галетник режимов: M2 асинхр. подача | 1k↑3V | 31
Режим: Резьба | PD6 | P2-30 | J7-3 M3 | Галетник режимов: M3 резьба | 1k↑3V | 34
Режим: Конус < | PD2 | P2-34 | J7-4 M4 | Галетник режимов: M4 конус < | 1k↑3V | 32
Режим: Конус > | PD3 | P2-31 | J7-5 M5 | Галетник режимов: M5 конус > | 1k↑3V | 33
Режим: Шар | PD7 | P2-27 | J7-6 M6 | Галетник режимов: M6 шар | 1k↑3V | 35
Режим: Делилка | PD10 | P1-42 | J7-7 M7 | Галетник режимов: M7 делилка | 1k↑3V | 36
Режим: Резерв | PD11 | P1-43 | J7-8 M8 | Галетник режимов: M8 G-код | 1k↑3V | 37
Подрежим: Внутренний | PC8 | P2-45 | J8-1 ВНУТ | Переключатель подрежимов: Внутренний | 1k↑3V | A13
Подрежим: Ручной | PC9 | P2-46 | J8-2 РУЧ | Переключатель подрежимов: Ручной | 1k↑3V | A14
Подрежим: Наружный | PC11 | P2-38 | J8-3 НАР | Переключатель подрежимов: Наружный | 1k↑3V | A15
Кнопка меню Влево | PB13 | P1-37 | J9-1 ЛЕВ | Кнопки меню: Влево | 1k↑3V | A0
Кнопка меню Вправо | PB14 | P1-38 | J9-2 ПРАВ | Кнопки меню: Вправо | 1k↑3V | A1
Кнопка меню Вверх | PB12 | P1-36 | J9-3 ВВЕРХ | Кнопки меню: Вверх | 1k↑3V | A2
Кнопка меню Вниз | PD9 | P1-41 | J9-4 ВНИЗ | Кнопки меню: Вниз | 1k↑3V | A3
Кнопка меню Выбор | PB15 | P1-39 | J9-5 ВЫБ | Кнопки меню: Выбор | 1k↑3V | A4
Джойстик Влево | PB0 | P1-22 | J10-1 ЛЕВ | Джойстик: Влево (к патрону) | 1k↑3V | A8
Джойстик Вправо | PB1 | P1-21 | J10-2 ПРАВ | Джойстик: Вправо | 1k↑3V | A9
Джойстик Вверх (на себя) | PE3 | P2-16 | J10-3 ВВЕРХ | Джойстик: Вверх — на себя | 1k↑3V | A10
Джойстик Вниз (от себя) | PB9 | P2-20 | J10-4 ВНИЗ | Джойстик: Вниз — от себя | 1k↑3V | A11
Кнопка ускоренного хода | PB8 | P2-19 | J10-5 БЫСТР | Джойстик: Ускоренный ход | 1k↑3V | A12
Кнопка упора Левый | PC5 | P1-19 | J11-1 ЛЕВ | Кнопки упоров: Левый | 1k↑3V | 28
Кнопка упора Правый | PC4 | P1-20 | J11-2 ПРАВ | Кнопки упоров: Правый | 1k↑3V | 26
Кнопка упора Передний | PC2 | P1-10 | J11-3 ПЕРЕД | Кнопки упоров: Передний | 1k↑3V | 24
Кнопка упора Задний | PA0 | P1-12 | J11-4 ЗАД | Кнопки упоров: Задний | 1k↑3V | 22
Светодиод упора Левый | PE6 | P2-11 | J12-2 ЛЕВ | Светодиоды упоров: Левый — катод | 220 Ом | 29
Светодиод упора Правый | PE5 | P2-14 | J12-3 ПРАВ | Светодиоды упоров: Правый — катод | 220 Ом | 27
Светодиод упора Передний | PE4 | P2-13 | J12-4 ПЕРЕД | Светодиоды упоров: Передний — катод | 220 Ом | 25
Светодиод упора Задний | PE2 | P2-15 | J12-5 ЗАД | Светодиоды упоров: Задний — катод | 220 Ом | 23
Зуммер | PE12 | P1-30 | J15-2 - | Зуммер: «−» | ключ NPN | 16
Тахометр (выход: импульс на оборот) | PE8 | P1-26 | J16-3 ИМП | Тахометр: вход импульса | 100 Ом | 42
Переменный резистор подачи (средний вывод) | PC1 | P1-7 | J17-2 СР | Переменник подачи: средний вывод | 100 нФ | A7
— (служебный: держит аудиочип платы выключенным) | PD4 | P2-32 | —
LCD2004 (I2C): SDA | PB7 | P2-24 | J18-3 SDA | LCD2004 + I2C: SDA
LCD2004 (I2C): SCL | PB6 | P2-23 | J18-4 SCL | LCD2004 + I2C: SCL
Дисплей ESP32: TX STM32 → RX дисплея | PB10 | P1-34 | J19-3 TX | Сенсорный дисплей: RXD (CN2-3)
Дисплей ESP32: RX STM32 ← TX дисплея | PB11 | P1-35 | J19-4 RX | Сенсорный дисплей: TXD (CN2-2)
Блок DRO HS800-2: его TX → сюда | PA3 | P1-13 | J20-2 RX | Блок DRO HS800-2: TX блока
Отладочный порт (USB-UART): TX | PA9 | P2-44 | J21-2 TX | USB-UART: RXD адаптера
Отладочный порт (USB-UART): RX | PA10 | P2-41 | J21-3 RX | USB-UART: TXD адаптера
Линейка Z: A / такт | PA15 | P2-40 | J22-3 A | Линейка Z: A / CLK | 470 Ом
Линейка Z: B / данные | PB3 | P2-28 | J22-4 B | Линейка Z: B / DATA | 470 Ом
Линейка Z: REQ (Digimatic) | PC6 | P2-47 | J22-5 REQ | Линейка Z: REQ (Digimatic) | 470 Ом
Линейка X: A / такт | PB4 | P2-25 | J23-3 A | Линейка X: A / CLK | 470 Ом
Линейка X: B / данные | PB5 | P2-26 | J23-4 B | Линейка X: B / DATA | 470 Ом
Линейка X: REQ (Digimatic) | PC7 | P2-48 | J23-5 REQ | Линейка X: REQ (Digimatic) | 470 Ом
Датчик / щуп (резерв) | PA2 | P1-14 | J25-3 ВХ | Датчик / щуп (РЕЗЕРВ): вход (контакт или NPN на GND) | 1k↑3V · 10 нФ
Резервный выход PD13 (на Discovery — LD3) | PD13 | P1-45 | J26-3 D13 | РЕЗЕРВ: выходы: D13 | 220 Ом
Резервный выход PD15 (на Discovery — LD6) | PD15 | P1-47 | J26-4 D15 | РЕЗЕРВ: выходы: D15 | 220 Ом
Резервный вход/выход 1 (АЦП, ЦАП) | PA5 | P1-15 | J27-3 A5 | РЕЗЕРВ: вход/выход: A5 | 470 Ом
Резервный вход/выход 2 (АЦП) | PA7 | P1-17 | J27-4 A7 | РЕЗЕРВ: вход/выход: A7 | 470 Ом
