tepmehatop/Lathe-cnc-controller-stm32/docs/manual/img/joystick.jpg

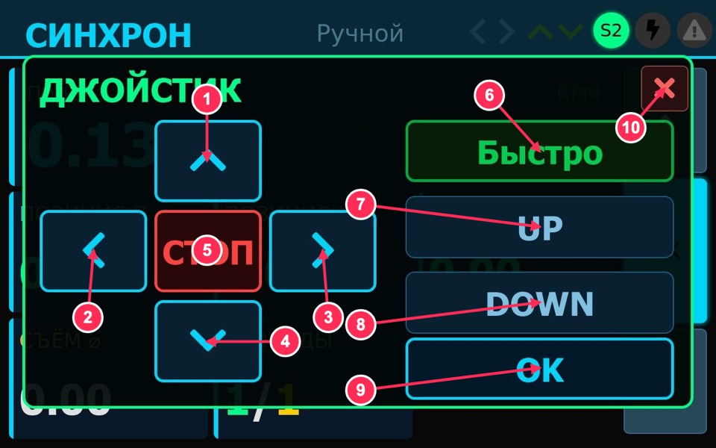
docs/manual/img/joystick.jpg
