tepmehatop/Lathe-cnc-controller-stm32/docs/img/calibration_run.jpg

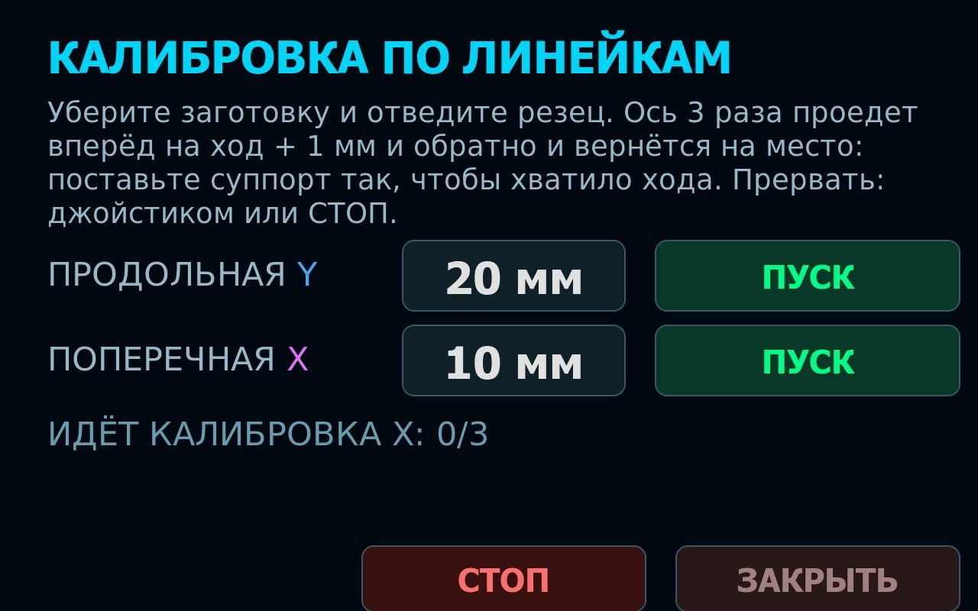
docs/img/calibration_run.jpg
