tepmehatop/Lathe-cnc-controller-stm32/history.md

# История разработки

Журнал ведётся перед и после каждой сессии разработки: что сделано, что дальше, какие проблемы.
Задачи и требования — в [BACKLOG.md](BACKLOG.md).

---

## 2026-10-26 — Аудит проекта, дорожная карта

### Состояние на начало
- Ветка `feat/jc8012p4a1c`. STM32F407: режимы ELS, UART-протокол с ESP32, DRO HS800-2 по UART,
  LCD2004, GCode через WiFi дисплея — работает (тесты категории C: 100/100, апрель 2026).
- 4.3" JC4827W543 — работает, нужны доработки.
- 10.1" JC8012P4A1C — дисплей, тач, подсветка, поворот, скриншоты по USB работают; UI — это
  растянутая раскладка 4.3" (мелкие шрифты, пустые области, иконки статуса не на месте);
  UART-пины до STM32 не подтверждены по схеме.

### Сделано
- В `BACKLOG.md` добавлены задачи BACKLOG-010…016: три дисплея, доводка 10.1", выбор дисплея
  и источника координат (DRO UART / линейки напрямую) в конфиге, дублирование тача физическими
  кнопками, правило защиты ПД.
- Найдено: `wifi_config.h` (SSID и пароли WiFi) и `CLAUDE.md` были закоммичены и запушены.
  Убраны из отслеживания (локальные копии остались), добавлены в `.gitignore`;
  создан шаблон `wifi_config.example.h`.
- Добавлен `tools/check_pii.sh` — проверка staged-изменений на персональные данные.

### Проблемы / ждёт решения
- Очистка истории git от старых `wifi_config.h`/`CLAUDE.md` требует force-push — ждёт
  подтверждения владельца. Рекомендуется сменить пароль WiFi.
- Платы (STM32, дисплеи) в момент сессии не были подключены по USB.

### Дальше
- BACKLOG-011: собственный layout 1280×800, проверка всех экранов на железе со скриншотами.

---

## 2026-10-31 — 10.1" JC8012P4A1C: скорость, связь со STM32, пропорциональный UI, тесты

### Состояние на начало
- 10.1" «очень тормозит»: каждое нажатие — секунды до реакции.
- Данные от STM32 (симулятор DRO) на 10.1" не приходят.
- Периодически всплывает и пропадает окно WiFi.
- UI 10.1" — растянутая раскладка 4.3" с мелкими шрифтами; масштаб SCALE_* испортил и 4.3".

### Сделано
- **UART до STM32**: разъём CN2 модуля = UART0 → RX GPIO38 / TX GPIO37 (было 16/17 —
  это линии SDIO до WiFi-чипа ESP32-C6). Данные POS_Z/POS_X пошли.
- **Скорость**: вместо full_refresh 1280×800 в PSRAM + поворот всего кадра + копии 2 МБ —
  частичная перерисовка (буфер 64 строки во внутренней SRAM), поворот области сразу
  во framebuffer панели. Кадр: 864 мс → 10–40 мс.
- **WiFi-окно**: алерт только при смене IP (раньше — каждые ~90 с в цикле STA→AP),
  убран блокирующий delay(2000) из цикла UI.
- **Пропорциональный UI**: единая база 480×272, макросы UX/UY/US (на 4.3" тождественны —
  эталон не меняется). Все экраны, оверлеи, барабаны, джойстик, меню — пропорционально.
  Шрифты 10.1" сгенерированы ×8/3 под теми же именами (tools/gen_p4_fonts.sh).
- **Зависание экрана** во время длинного прогона: пул памяти LVGL 48 КБ (свободно ~11 КБ)
  исчерпывался на больших полупрозрачных слоях 10.1" → LV_ASSERT → `while(1)`.
  Память LVGL на P4 перенесена в PSRAM; assert теперь паникует с backtrace и перезагрузкой.
- **Тест-инфраструктура в прошивке дисплея** (общая для 4.3"/10.1"): [STATE], [LCD2004],
  `<BTN:x>`, `<TAP:x,y>`, `<UIDUMP>`, `<RXMUTE:0|1>`, инъекция `<CMD:v>`; скриншот одной
  операцией (раньше JPEG ломали вклинивающиеся логи).
- Новые раннеры: `tools/run_test_cases.py` (TEST_CASES.md, 215 кейсов, сверка текстов
  виджетов + скриншоты), `tools/ui_tap_tests.py` (UI-сценарии касаниями).
- Протокольные тесты `run_all_tests.py` на 10.1": 322/326 с первого раза, 4 упавших
  при повторе прошли (тайминг живых данных STM32) → 326/326.

- **WiFi не блокирует UI**: WiFi/HTTP в отдельной задаче FreeRTOS (переход STA→AP с
  неработающим C6 останавливал loop на секунды, терялись команды и касания); запросы
  run/stop/pause и алерт передаются в loop(). USB RX-буфер 4 КБ.
- **Ошибки, найденные тестами и исправленные** (общий код — касается и 4.3"):
  THR_CAT не обрабатывался на STM32 (смена категории резьбы двойным тапом не работала);
  стрелки джойстика и ✕ рисовались пустыми квадратами (символы в Tahoma);
  двойной тап в M3 открывал барабан вместо меню типа резьбы; выбор типа резьбы открывал
  барабан на старом шаге; дубли значений на краях барабана; «ОТМЕНА» наезжала на «K-труб»;
  алерт «Режим невозможен» не снимался при смене подрежима/режима;
  алерт про джойстик обрезался (третья строка).
- **Итоговая регрессия на 10.1"**: A/B/C 326/326; TEST_CASES.md — 95 PASS, 110 VISUAL
  (все просмотрены по скриншотам), 10 FAIL — устаревшие ожидания спецификации или
  предусловия текстом (THR_CAT, TC-055, TC-078 проверены вручную — работают);
  UI-сценарии касаниями 21/21; зависаний и паник — 0.

### Проблемы / открыто
- WiFi через ESP32-C6: связь P4↔C6 есть (C6 отвечает, ~12 мс после старта), сеть роутера видна
  (RSSI ≈ −48), но после WiFi.begin C6 не делает ни одной попытки подключения. Версии:
  хост esp_hosted 2.12.3 (P4), слейв 2.1.10 (C6, заводской) — вероятная несовместимость RPC
  настройки STA. Решение: обновить C6 до 2.12.x через esp_hosted_slave_ota (ждёт согласия).
  Диагностика в лог: версии, скан, причина отключения.
- AFEED > 32767 показывается как −32768 (int16) — на практике aFeed ≤ ~400, низкий приоритет.
- 14 кейсов TEST_CASES.md без команд во вводе (только текст) — дописать команды в спецификацию.
- В TEST_CASES.md устаревшие ожидания (M8 → «РЕЗЕРВ», «К-ТРУБ» кириллицей и т.п.) —
  обновить спецификацию.
- 4.3" не подключён — регресс 4.3" проверен только сборкой (макросы тождественны).

---

## 2026-11-01 — BACKLOG-013 (выбор дисплея в конфиге) и BACKLOG-014 (линейки напрямую)

### План
- BACKLOG-013: `ELS_DISPLAY_TYPE` в els_config.h (нет / 4.3" / 10.1", 7" — зарезервирован);
  дисплей при старте сообщает свой тип, STM32 предупреждает о несовпадении.
- BACKLOG-014: источник координат `ELS_POS_SOURCE` (DRO по UART / линейки напрямую / шаги
  мотора); типы линеек по каждой оси: квадратура TTL/RS422 (стекло, магнит), ёмкостные
  Sylvac 48 бит, BIN6 24 бит, iGaging 21 бит, Mitutoyo Digimatic. Декодеры протоколов —
  отдельный модуль с юнит-тестами на ПК; симулятор Arduino Mega — эмуляция всех типов
  линеек; документация со схемами сопряжения для форума.

### Сделано
- BACKLOG-013: `ELS_DISPLAY_TYPE`, сверка типа дисплея (`<DISP:…>`), проверено на железе:
  конфиг 4.3" + дисплей 10.1" → алерт; конфиг 10.1" → алерта нет.
- BACKLOG-014: `ELS_POS_SOURCE`, драйвер `drv_scales` (5 типов линеек), режим по шагам,
  `scale_protocols` + 38 юнит-проверок, симулятор с эмуляцией линеек, HIL-тест,
  `docs/scales/README.md` со схемами (исследование: TouchDRO, ShumaTech, Caliper2PC, Digimatic).
- Найдена и исправлена давняя ошибка: `Serial` (отладка) на Discovery по умолчанию — USART2,
  тот же порт, что у блока DRO. Любая печать в Serial роняла STM32 в HardFault (вызов
  нулевого tx_callback) — проявилось при перезагрузке дисплея. Serial перенесён на USART1
  (PA9/PA10), как и задумано в els_config.h. Диагностика — через ST-Link/openocd (PC, CFSR).
- Исправлено: без ESP32-дисплея прошивка STM32 не линковалась (нет заглушки SendGCodeAck).
- Матрица сборок (11 вариантов) — без ошибок и предупреждений; HIL HS800 — 6/6.

### Проблемы / открыто
- Квадратура и протоколы проверены юнит-тестами и сборкой; на железе — ждут проводки
  симулятора к STM32 и реальных линеек (магнитные у автора).

---

## 2026-11-02 — Сверка с оригиналом 7e2, перенос ядра дословно

### План
- Сравнить порт с исходным проектом 7e2 (код, схема `Diagram ELS_V7.jpg`, документ автора):
  режимы, расчёты, управление, кнопки. Все настройки — в конфиг. Схемы подключения, макетка
  без шилда, шилд под заказ. Документация (HTML + MD) для неподготовленного читателя.

### Сделано
- Аудит (`docs/PORT_AUDIT.md`): прежний порт был упрощённой переделкой — резьба без привязки
  к углу шпинделя, подачи без разгона, одна частота шагов на обе оси, нет автоциклов,
  ускоренных ходов, РГИ с разгоном, плавной остановки у упоров, тахометра, переменника.
- Ядро 7e2 перенесено дословно: `Core/e2/orig/*.ino` подключаются без изменений,
  основной скетч — копия с заменой только AVR-специфики (`[STM32]`). Аппаратный слой
  `e2_hal`: INT0/Timer5 → EXTI на PA1 + программный счётчик фронтов, Timer2/3/4 → TIM6/7/12,
  INT2 → EXTI PE7, равные приоритеты прерываний. LCD2004 остаётся на I2C (теневой буфер).
- Карта выводов `Core/e2/e2_pins.h` — только свободные пины Discovery (у LQFP100 нет
  портов F/G, на которых были кнопки и упоры в старом конфиге); собранные на стенде линии
  (дисплей PB10/PB11, LCD PB6/PB7, отладка PA9/PA10, DRO PA3, линейки) не тронуты.
- `Core/els_config.h` — единый файл настроек: что подключено, механика (имена и значения 7e2),
  подачи, РГИ, линейки, связь, переменник. Старый порт удалён.
- Симуляция на компьютере (`tools/run_e2_sim.sh`): настоящие ядро и аппаратный слой,
  энкодер, таймеры — 69 проверок OK (резьбы точно по таблице, повторный проход в ту же
  нитку, подачи, ускоренный ход, РГИ, упор, режимы с дисплея).
- Эмулятор DRO на Mega: знаки приведены к оригиналу (дисплей показывает то же, что блок DRO).

### Проблемы / открыто
- Платы не были подключены по USB — прошивка нового ядра на STM32 и тесты на железе впереди.
- Синхронная подача у 7e2 на 6–10 % меньше заданной (особенность формулы автора) — ждёт
  решения владельца.
- Значения `SCREW_X`, диапазоны подач в конфиге — авторские; старый порт имел другие.
- Дальше: симуляция конусов, шара, делилки, автоциклов; схемы подключения, макетка, шилд,
  документация.

### Сделано (продолжение 2026-11-02)
- Защита длительности импульса STEP (≥ 3 мкс, DWT): в 7e2 на конусе импульс X снимается и ставится
  в одном прерывании — на STM32 пауза была бы 0.1 мкс. Подтверждено симуляцией.
- Таблицы резьб/конусов привязаны к механике (static_assert), `tools/gen_e2_tables.py` пересчитывает
  (воспроизводит все 67 резьб автора точно).
- Настройки `DRIVER_SIGNALS_DIRECT` (драйверы через ключ или напрямую), `BEEPER_ON_LEVEL`,
  `IO_MONITOR` (монитор входов для макетки), `USE_FEED_POT`. Аудиочип Discovery держится в сбросе.
- Симуляция: автоциклы резьбы и подачи, ось X, конусы, шар, делилка, РГИ x10, обратное вращение —
  106 проверок OK; исправлен откат виртуального времени после delay() внутри loop().
- REQ Digimatic перенесён на PC6/PC7 (PA3 занят блоком DRO и эмулятором).
- Документация: `docs/index.html` + `docs/README.md`, схемы по блокам, карта разъёмов P1/P2, макетка,
  эмулятор; удалены устаревшие pinout/schematic (порты F/G, которых нет у LQFP100).
- Шилд в KiCad: схема (ERC 0, цепи 1:1 с описанием), BOM, размещение. Найдено: у гнезда 2×25 из
  библиотеки KiCad ряды зеркальны относительно Discovery — взято посадочное место штыревого разъёма.

### Проблемы / открыто
- Запуск автотрассировщика Freerouting (скачанный .jar) не разрешён правилами — нужно согласие владельца
  или ручная трассировка.
- Платы по USB не подключены — прошивка нового ядра на железе не проверялась.

---

## 2026-11-02 (вечер) — PR #1 слит в main, сверка с оригиналом по чеклисту

### Сделано
- PR #1 (`feat/jc8012p4a1c`) слит в main; коммит с README перенесён в main; работа продолжается в main.
- Скачаны ветки оригинала с GitHub (`main`, `feature/hs800-dro-integration`): логика одинакова, наша копия =
  ветка с DRO.
- Автосверка: 119 из 124 функций на месте (5 — DRO_HS800.ino, заменён `drv_dro`), все 152 `#define`, все 163
  глобальные переменные с теми же начальными значениями, таблицы резьб (67) и конусов (63) без изменений.
- Симуляция расширена: внутренние автоциклы резьбы и подачи, асинхронный и конусный автоциклы, 2-заходная
  резьба (ход и сдвиг старта на шаг), тахометр — 172 проверки, все OK.
- `docs/CHECKLIST_7e2.md` — полный перечень: режимы, расчёты, органы управления, меню, индикация, связь,
  настройки, отличия, открытые вопросы, порядок проверки на железе.
- BACKLOG-019 (шилд компактный, через KiCad MCP, в конце), 020 (подача), 021 (механика), 022 (упоры).

### Дальше
- Прошивка STM32, Mega (эмулятор), дисплея; проверка на железе по разделу 10 чеклиста.

---

## 2026-11-02 (ночь) — первая прошивка на железе

### Сделано
- Прошиты STM32 (ST-Link), Mega-эмулятор, дисплей 10.1" (ESP32-P4). Связь STM32 ↔ дисплей и Mega → STM32 работает.
- STM32 не отвечал на `<READY>` после загрузки дисплея: ESP32-P4 печатает лог ROM в тот же UART0 (GPIO37/38),
  мусор приклеивался к команде. Исправлено: `'<'` начинает новую команду, буфер ограничен.
- «Джойстик в нейтраль» горел постоянно: PB2 — это BOOT1, на Discovery стянут к GND, вход читался «нажат».
  JOY_UP перенесён на PE3 (P2-16); документация и черновик шилда перегенерированы. Пока ядро считало джойстик
  нажатым, цикл тормозил, и позиция на дисплее обновлялась ~9 раз/с рывками; после исправления — ~53 раза/с.
- Эмулятор DRO качает позицию через ноль (Z −50..+50 мм, X −5..+5 мм) — видны оба знака.
- Мелкие шрифты на 10.1": дисплей был собран из `ELS_Display/platformio.ini` (старое окружение без шрифтов ×8/3).
  Правильная сборка — из корня: `pio run -e jc8012p4a1c`. Перешито, шрифты крупные.
- Проверено через SWD: пакеты DRO 49/с без ошибок, входы в покое читаются правильно.

### Дальше
- Автотесты дисплея на живой связке, проверка органов управления и моторов по разделу 10 чеклиста.

---

## 2026-11-02 (ночь, продолжение) — диаметр, раскладка, стенд сверки дисплеев

### Сделано
- Диаметр (Ø LCD2004) на новом дисплее: STM32 шлёт `DIAM_X` при каждом изменении позиции.
- Раскладка K: в одном ряду ПОЗИЦИЯ Y / ПОЗИЦИЯ X / ДИАМЕТР; параметр режима, счётчик и тип — второй ряд;
  буквы осей окрашены (Y синий, X сиреневый), слово ДИАМЕТР — цветом X.
- `tools/compare_displays.py` — стенд сверки: старый экран читается из памяти STM32 по ST-Link (теневой буфер
  LCD2004), новый — `<UIDUMP>`; касания через дисплей, физические входы — перевод вывода в выход через SWD;
  позиции эмулятора фиксируются (w0/z/x). Первый прогон: 155 из 164 состояний без расхождений.
- Найдено и исправлено (собрано, на железе ещё не проверено):
  - Шар: «Заходов» на новом дисплее +2 вместо +1 и не обновлялся при смене диаметра/ширины резца
    (STM32 теперь шлёт `PASS_SPHR` при изменении).
  - M2 экран меню 3: подпись «УГОЛ °» оставалась от экрана 2 (общий `apply_sm_layout`).
  - «Съём R» (аПодача) / «Съём Ø» (подача, конусы) — на новом было просто «СЪЁМ»: теперь СЪЁМ РАД / СЪЁМ ДИАМ.
  - Конус, экран 2: подсказка LCD «В режиме резьба» при включённой конической резьбе.
- `<UIDUMP>` дополнен плиткой диаметра.

### Дальше
- Прошить STM32 и дисплей, прогнать расширенный сценарий (упоры при удержании SUB_MAN, Внутр./Наруж. во всех
  режимах, сообщение «джойстик в нейтраль»), разобрать отчёт.
- Раскладка I: места под диаметр нет — решить с владельцем.

---

## 2026-11-03 — синхронизация дисплеев, стенд сверки по подписям, матрица автоциклов

### Сделано
- Новый дисплей синхронен с LCD2004: сообщения-флаги ядра гаснут вместе (ALERT по изменению флагов),
  подача после перезапуска STM32, значения из Display_Send_All уходят по изменению (Display_Watch:
  натяг, отскок, заходы шара, угол делилки, проходы, упоры…).
- Экран «Ввод/Сброс осей»: ОСЬ Y / ОСЬ X / ⌀ ДИАМЕТР в ряд без дубля; раскладка I удалена.
- Знак ⌀ в шрифтах (tools/gen_p4_fonts.sh, новый tools/gen_43_fonts.sh): НОЖКА ⌀, ШАР ⌀, СЪЁМ ⌀,
  СЪЁМ R (аподача — на радиус), ⌀ ДИАМЕТР, ВВОД ⌀; опечатка «РЕСЦА»; ОСЛАБЛ. НАТЯГА Y; подсказка делилки
  «СБРОС КНОПКОЙ СЕЛЕКТ»; «Режим невозможен!» шара держится, как на LCD.
- Счётчик проходов как на LCD2004: «осталось/всего» (убывает в цикле).
- tools/compare_displays.py: сверка по подписям (таблица правил LCD → ячейка нового дисплея со значением),
  дубли, строки без правила; упоры ставятся с отгоном кареток и проверкой флагов ядра; Внутр./Наруж. во
  всех режимах. На железе: 305/305 состояний без расхождений.
- Симуляция: матрица 29 автоциклов (SIM_CYCLES=1) — подача, аподача, конусы, резьба (шаги 0.5–3 мм,
  18 tpi, 70 мм, внутренняя, 2 захода, +чистовой): число проходов, врезание по формулам 7e2, выход за
  упоры, доход до упора, счётчик LCD = новый дисплей, «ОПЕРАЦИЯ ЗАВЕРШЕНА», возврат. Все проходят.
  Уточнено по коду автора: аподача — съём на радиус, X в ноль; подача/конус — X остаётся на глубине;
  внутренняя резьба — профиль 0.601·P (наружная 0.613·P).

### Дальше
- Полная сверка на железе после всех правок; автоциклы на железе с «шпинделем» от таймера.
- Барабан шага резьбы открывается не на выбранной категории (замечание владельца).
- Скриншоты 10.1" для README; BACKLOG-023/024 (джойстик, запуск цикла с экрана).

- Барабан шага резьбы листает только текущую категорию (метрич./дюйм./G/K).
- tools/hil_cycles.py — автоциклы на железе: «шпиндель» — TIM5 CH2 на PA1 (вход энкодера) по SWD,
  упоры с отгоном, запуск джойстиком до «ОПЕРАЦИЯ ЗАВЕРШЕНА», каждые 0.5 с — счётчик «осталось» LCD2004 и
  нового дисплея, выход за упоры, возврат. 10/10 циклов без замечаний (подача, аподача, резьба 1.5/1.0,
  2 захода, конусы, шар). «ОПЕРАЦИЯ ЗАВЕРШЕНА» на обоих экранах появляется через 1.7 с после флага —
  BeepComplete() автора играет сигнал через _delay_ms.
- Полная сверка экранов на железе после всех правок: 305/305.
- README: 6 скриншотов 10.1" во время автоциклов вместо прежних трёх.
- Источники координат на железе (tools/scales_hil_test.py, Mega-эмулятор → STM32 → новый дисплей):
  HS800, квадратура, Sylvac 48, BIN6, iGaging 21, Digimatic — 6/6 позиций каждый (±, 0.001, 250 мм).
  Найдено и исправлено в эмуляторе/стенде (STM32 не менялся): квадратура выдавалась с опережением B
  (знак наоборот), стенд не ждал «доезда» квадратуры; iGaging — эмулятор не успевал за тактом 20 мкс
  (опрос digitalRead, 64-битный расчёт кадра на фронте) → приём кадра целиком на прямом чтении порта.

---

## 2026-11-05 — люфт, упоры без переключателя, эмулятор следует за моторами

### Сделано
- BACKLOG-022: кнопки упоров работают при «Ручном», выбранном на экране (LIMITS_BY_SELECTED_SUBMODE 1).
- BACKLOG-025: компенсация люфта BACKLASH_Z_UM / BACKLASH_X_UM — сдвиг позиции на первом шаге после смены
  направления (сдвиг при установке DIR терялся: ядро запоминает ноль стоя на месте). Модель люфта в
  симуляции считает гайку по импульсам STEP; недорез 0.000 при подходе с любой стороны; матрица 29 циклов
  с люфтом X 0.1 / Z 0.2 мм и компенсацией — 428/428; без компенсации — как раньше.
- Эмулятор Mega: режим следования за моторами (f1, люфт lz/lx, нм/шаг kz/kx) — ждёт проводов STEP/DIR.
- Пост для форума (что сделано, отличия от стока, планы).

### Дальше
- Подключить STEP/DIR к Mega, проверить люфт и компенсацию на железе; «ПРОХОДЫ» на железе.

---

## 2026-11-06 — без линеек по умолчанию, ноль и ввод осей

### Решения владельца
- Исходная 7e2 — без линеек и DRO, поэтому по умолчанию сборка без них; варианты с DRO и линейками —
  отдельными env, пользователь выбирает сам.
- Ноль/ввод осей без блока DRO: двойной тап — ноль, долгое нажатие — клавиатура (BACKLOG-027).
- Дальше: настройки станка во флеше с экрана (028), калибровка шагов и люфта по линейкам (029),
  релизы на GitHub — пока под станок владельца (030).

### Сделано
- `ELS_POS_SOURCE` по умолчанию `POS_SOURCE_STEPS`; env `stm32f407_dro`, `stm32f407_scales`. Стенд сверки
  дисплеев читает прошивку из `stm32f407_dro` (ELS_ENV — другой env).
- Найдено: при линейках напрямую «Сброс» осей автора не обнулял показания (обнулял только счётчик шагов).
  Добавлены смещения линеек и `e2_axis_set()`; команда экрана `AXIS:<Z|X|D>:<мкм>`, флаг `AXIS_EDIT`.
- Симуляция: test_axis_set — по шагам 177/177, линейки 177/177, DRO 175/175 (с DRO оси с экрана не меняются).
- Экран: двойной тап по ПОЗИЦИИ Y / X — ноль, долгое нажатие на Y / X / ⌀ — клавиатура (команда AXIS:).
  С блоком DRO (AXIS_EDIT:0) — подсказка «ОСИ ЗАДАЮТСЯ НА БЛОКЕ DRO». Экранный джойстик — тап по ⚡.
  Обе прошивки дисплеев собираются; разбор набора числа проверен на компьютере 11/11. На железе не
  проверено — платы не подключены.
- Релизы: tools/make_release.sh (STM32 с DRO + оба дисплея одним файлом с 0x0, SHA256SUMS), workflow
  .github/workflows/release.yml (тег v* — релиз; вручную — только сборка), docs/RELEASE.md — что внутри и
  как прошить. Wi-Fi в релизе — только шаблон (ELS_RELEASE). Локально собирается.
- CI: ststm32 закреплена на 19.5.0 — свежая 20.0.0 (STM32duino 3.0, ArduinoCore-API) ядро 7e2 не собирает
  («Print is ambiguous», HardwareSerial(int,int)). Переход на 3.0 — отдельной задачей, если понадобится.
- BACKLOG-028: механика станка во флеше STM32 и с экрана. e2_mech.h переопределяет ENC_LINE_PER_REV, SCREW_*,
  McSTEP_*, MOTOR_*_STEP_PER_REV, BACKLASH_*_UM на поля e2_mech — текст ядра автора не меняется. Таблицы резьб
  и конусов пересчитываются при старте (при механике автора — его таблицы), проверки — как static_assert автора
  плюс делители таблиц. Флеш — сектор 11. Экран: ⚠ двойной тап → «МЕХАНИКА СТАНКА», общая клавиатура.
  Симуляция: 192/192; матрица автоциклов 443/443 (и с компенсацией люфта); люфт — недорез 0.000.
  Сверка с эталоном: механики 1800/200×4/1.5/1.25 и 3600/200×8/2/1 — провалы тестов те же, что у сборки с
  этой механикой в els_config.h (тесты под механику автора). На железе не проверено.
- CI релиза зелёный (артефакт els-main ~2 МБ).
- Железо (провода STEP/DIR → Mega подключены): tools/follow_hil.py — шаги Z/X совпадают (±2 — округление ядра
  до полного шага), люфт 100 мкм на Mega виден, компенсация с экрана его убирает. Настройки во флеше переживают
  сброс и перепрошивку. Экран 10.1": двойной тап — ноль, клавиатура (X, ⌀), окно «МЕХАНИКА СТАНКА», ⚡ — джойстик;
  с прошивкой DRO — подсказка. Исправлено: подсказка Wi-Fi от первого тапа по ⚠ висела поверх настроек, фон
  окна настроек просвечивал. <TAP:x,y,мс> — долгое нажатие в тестах (по Y база = px × 272/800).
- Регресс на железе после всех правок (прошивка DRO): сверка экранов 305/305; автоциклы 9/10 — «подача внутр.»
  в полном прогоне не пошла (упоры встали на 8.0 мм вместо 11.5, проходы не начались за 240 с); отдельно — 2/2
  без замечаний. Похоже на сбой расстановки упоров в hil_cycles.py после предыдущего цикла — следить.
- BACKLOG-029 калибровка по линейкам: на стенде найдены заданные на Mega винт и люфт (Y 1.920/100, X 1.040/81),
  ПРИМЕНИТЬ и СТОП работают. Исправлено по замечаниям владельца: «—», «…», «≤» нет в шрифтах экрана (квадратики)
  — заменены; нижние кнопки окон настроек и калибровки подрезала рамка — подняты. Скриншоты в docs/img.
- Первый релиз v0.1.0 (по решению владельца): STM32 с блоком DRO + дисплеи 4.3"/10.1", собран GitHub Actions.

---

## 2026-11-06 (продолжение) — подача, меню настроек, линейки в циклах, G-код

### Решения владельца
- BACKLOG-016 (старые пароли в истории git) — не делаем.
- BACKLOG-020 — исправить недобор синхронной подачи.
- Меню: ⚠ → общий раздел настроек (Wi-Fi к роутеру, механика, калибровка, …), IP точки доступа внизу крупно.
- Делаем: 025 (линейки в циклах), хвосты 028, 029 без линеек, 015, 001 (G-код).

### Сделано
- BACKLOG-020: FEED_EXACT 1 — подача равна заданной (0.25 → 100.000 шагов/об, было 90); 194/194, матрица 443/443.
- Меню: тап по ⚠ → «НАСТРОЙКИ» (МЕХАНИКА, КАЛИБРОВКА, WI-FI, ЛИНЕЙКИ; внизу крупно адрес точки доступа/роутера).
  WI-FI: сеть роутера в NVS дисплея (главнее wifi_config.h), поиск сетей (в режиме точки доступа — AP+STA),
  «забыть». В шаблоне wifi_config сеть роутера пустая — сразу точка доступа.
- BACKLOG-028: источник координат и линейки — настройки STM32 (запись v2), выбор на экране, перезапуск. На железе:
  DRO → линейки (квадратура от Mega) → DRO. Найдено и исправлено: в tahoma 40 нет букв (адрес — 28), «ЗАБЫТЬ»
  поверх клавиатуры. Скриншот экрана Wi-Fi со списком сетей в репозиторий не кладу (названия сетей владельца).
- BACKLOG-025 (начато): e2_scalefix.inc — доводка X по линейке перед проходом и контроль пропуска шагов; код
  собран, по умолчанию выключен, не проверен (регресс без изменений: 197/195, матрица 446).

### Пауза (по просьбе владельца) — дальше по порядку
1. 025: модель в симуляторе, переключатели на экране «ЛИНЕЙКИ», стенд Mega, затем включить по умолчанию.
2. 028 хвост: энкодер 3600 / микрошаг 8 — в симуляции не ставятся упоры: тест или ядро.
3. 029: калибровка без линеек (индикатор / штангенциркуль, ввод замера).
4. 015: таблица «экран ↔ физическая кнопка», дубли для новых экранных функций.
5. 001: G-код через Wi-Fi на новом ядре.
6. Перед следующим релизом: сверка экранов и автоциклы на железе.

---

## 2026-11-07 — линейки в автоциклах (BACKLOG-025)

### Сделано
- Симулятор: DRO-заглушка показывает каретку (люфт, пропущенные шаги), 50 Гц; время идёт в delayMicroseconds
  блокирующих ходов. Доводка X: недорез 0.000–0.001 мм без компенсации люфта; пропуск шагов ловится.
- Стенд: доводка 299 из 300 мкм (без неё 200 — люфт 0.1); пропуск 200 шагов (новая команда эмулятора dx200)
  ловится, блок снимается отпусканием джойстика; ложных срабатываний в цикле нет.
- Экран «ЛИНЕЙКИ»: переключатели ДОВОДКА X / КОНТРОЛЬ ШАГОВ (POS — 12 чисел). Включено по умолчанию.
- Регресс: симуляция 197/197/199 (шаги/линейки/DRO), матрица 446 ×3, сборки 11/11.
- BACKLOG-028 хвост: «упоры не ставятся при микрошаге 8» — тест (ускоренный ход вдвое медленнее в мм/с, ядро
  требует тормозной путь 3.8 мм между упорами). Тесты учитывают механику. Найдена ошибка ядра: сдвиг второго
  захода резьбы через целое TENS (винт 1.5 мм — 1.41 вместо 1.50 мм) — исправлено. Две другие механики: 179/179,
  матрица 428/428.
- BACKLOG-029 по индикатору: вкладка «ПО ИНДИКАТОРУ», мастер (люфт → обнулить → ход → показание → возврат →
  показание). Стенд: винт 1.039 / люфт 80 при заданных 1.04 / 80. Симуляция 202/204 (шаги/DRO).
- BACKLOG-028 хвост и 015: docs/CONTROLS.md; физические дубли — категория резьбы (▲/▼ + ускоренный ход), ввод
  диаметра кнопками при линейках напрямую. Симуляция: шаги 203, линейки 204.
- Железо: категория резьбы кнопками — у автора удержанная кнопка повторяется (0.25 с — три категории);
  категория не чаще раза в 0.6 с. Стенд: 20 → 47 → 20 → 0, без ускоренного ▲ — 1.
- BACKLOG-001 G-код: исполнитель на STM32 (M8 «G-КОД»), стенд — цели до микрона, стоп; docs/GCODE.md.
  Найдено и исправлено: окно приёма СТОП из нулей; скачок DRO портил направление линейки (ложное «не совпадает»).
  Регресс: симуляция 212/205/206, матрица 446 ×2, сборки 11/11, стенд follow/fix/gcode — OK.
- Регресс на железе перед релизом: сверка экранов 305/305; автоциклы — сначала 2/10: Mega после теста G-кода
  осталась в «качании», DRO не связан с моторами — контроль шагов справедливо останавливал циклы. hil_cycles.py
  теперь ставит Mega «следует за моторами» (как настоящий DRO) — 10/10 без замечаний.
- По замечаниям владельца: веб-страница G-кода обращалась на :8080 (сервер на 80) — относительные адреса; «G-КОД»
  — квадратики (tahoma 40 без кириллицы) — 28 в M8; ошибка в ячейке «СТРОКА» не помещалась — в сообщение;
  Fanuc-кадры (G99/G98/G50 S/G96/G97/O). Wi-Fi 10.1": после перезагрузки к роутеру не подключался — первая
  попытка через C6 «пустая»; поиск сетей перед подключением + повтор через 10 с: 5/5 перезагрузок, 26 с.
  Стенд: history.nc через Wi-Fi целиком — каретка точно в последнем кадре (Z100, ⌀100). Примеры gcode_sample/.

### Пауза 2026-11-07 (вечер) — итоги дня
**Сделано (всё в git, проверено на стенде, если не сказано иначе):**
- 025 линейки в автоциклах: доводка X 299/300 мкм при люфте 0.1; пропуск шагов ловится; включено по умолчанию.
- 028: другая механика — тесты учитывают механику; ошибка ядра со сдвигом захода многозаходной резьбы исправлена.
- 029: калибровка по индикатору (стенд: винт 1.039 / люфт 80 при заданных 1.04 / 80).
- 015: CONTROLS.md, категория резьбы ▲/▼ + ускоренный ход, диаметр кнопками при линейках.
- 001 G-код: исполнитель на STM32 (M8 «G-КОД»), Fanuc-кадры (G99/G98/G50 S/G96/G97/O); файл владельца history.nc
  через Wi-Fi целиком — каретка точно в последнем кадре; примеры gcode_sample/; веб-страница переделана.
- Регресс на железе: сверка экранов 305/305, автоциклы 10/10 (Mega «следует за моторами»).

**Замечания владельца (сегодня) и что с ними:**
- Квадратики в M8 — шрифт основного поля без кириллицы → исправлено.
- Ошибка сети на странице G-кода (:8080) → исправлено (адреса относительные).
- Wi-Fi нестабилен на 10.1" и 4.3" («рандом») → 10.1": поиск сетей + повтор через 10 с, 5/5 перезагрузок. 4.3" — не
  проверено (не подключён).
- Длинное непонятное сообщение про шпиндель (fanuc_g99 без вращения) → «Строка 7: ШПИНДЕЛЬ СТОИТ: G99/G95 - ПОДАЧА НА
  ОБОРОТ, ВКЛЮЧИТЕ ШПИНДЕЛЬ»; буфер ошибки 80 → 200 байт (кириллица обрезалась). Скрин экрана при ошибке и при 100 % —
  СДЕЛАТЬ (просьба владельца).
- Веб-визуализация нечитаема → страница переделана (вид станка, размеры, легенда, дуги, курсор, код с подсветкой);
  на железе страница прошита, снимок с реального дисплея — СДЕЛАТЬ.
- «Проверить все расширения» → .nc прошёл через Wi-Fi; .gcode/.ngc/.tap/.txt — загрузка и «Готово» есть, но каретка не
  двинулась: повторные прогоны подряд — РАЗОБРАТЬ (тест или исполнитель: опорная точка G-кода / M8 / «Готово» прошлой
  программы).
- Обновление ESP32-C6 — разрешено владельцем; целевая версия под хост 2.12.x; отдельной задачей.
- Визуализация на экране и подсказка резцов — BACKLOG-031.

**Найдено мной по ходу (исправлено):** окно приёма СТОП из нулей; скачок DRO портил направление линейки (ложное
«не совпадает»); чтение линейки после доводки прерывалось джойстиком; разворот по округлению счётчика; повтор
удержанной кнопки проскакивал категории резьбы; тест автоциклов не включал Mega «следует за моторами».

**Дальше:** разобрать прогоны расширений подряд; снимки экрана при «Готово» и при ошибке; снимок страницы с дисплея;
Wi-Fi на 4.3" (5 перезагрузок); затем релиз v0.2.0 (по согласию владельца).

## 2026-11-08 — G-код: экран в конце программы и при ошибке, все расширения

### Сделано
- Прогоны расширений подряд: причина — опорная точка G-кода не сбрасывалась между программами (выход из M8, подвод,
  обнуление на DRO — новая программа шла со сдвигом). Дисплей шлёт «%» перед первой строкой, смена режима сбрасывает
  точку. Стенд: .nc .gcode .ngc .tap .txt подряд через Wi-Fi — каретка точно в цели (коммит 1113d24).
- Снимки в конце программы и при ошибке (просьба владельца). По ним найдено и исправлено:
  - окно ошибки — фиксированной высоты, длинный текст обрезался и наезжал на OK → высота по тексту;
  - окно ошибки закрывалось само через 5 с (и могло — по ALERT:0 от STM32) → ошибка G-кода висит до OK
    (снимается и сменой режима);
  - «ОШИБКА» и «10 100%» не помещались в ячейку → в ячейке «ВЫПОЛНЕНО» — процент, при ошибке — номер строки «N7»;
  - сообщение про шпиндель короче: «ВКЛЮЧИТЕ ШПИНДЕЛЬ (G99 - ПОДАЧА НА ОБОРОТ)».
- Веб-страница при ошибке и при «Готово» — читается (причина ошибки полностью, строка подсвечена, путь выполненного).
- tools/gcode_wifi_hil.py: --shot / --web — снимки дисплея и страницы в конце; --rpm 0 — шпиндель стоит.
- Стенд: chamfer_arc.nc и fanuc_g99.nc (600 об/мин) — «Готово», каретка точно в последнем кадре; fanuc_g99.nc без
  шпинделя — ошибка в строке 7, окно держится. Снимки — docs/img/gcode_done.jpg, gcode_error.jpg (в GCODE.md).
- Предупреждение компилятора в main.cpp (enum | enum) — убрано.

### Дальше
Wi-Fi на 4.3" (5 перезагрузок, когда подключат); обновление ESP32-C6; релиз v0.2.0 — по согласию владельца.

## 2026-11-08 (продолжение) — шахматная пешка: циклы G71/G70

### Сделано
- Владелец: Wi-Fi 4.3" (5 перезагрузок) и обновление ESP32-C6 — отложены в самый конец.
- В бэклог: BACKLOG-032 — руководство пользователя (каждый режим со снимками и стрелками, примеры задач, все ошибки
  со снимками и FAQ); BACKLOG-033 — наглядная схема подключения по каждому выводу и список покупок. Старые
  docs/pinout.html и schematic.html удалены 2026-11-02 (a6f2c75): там были выводы портов F/G, которых нет у
  STM32F407VG на Discovery, — делать заново по e2_pins.h.
- Программа пешки от владельца (Fanuc, G71/G70, G28 U0 W0) — у нас этого не было. Сделано:
  - ELS_Display/src/gcode_cycles.cpp — разворот G71 (черновая слоями + получистовой с припуском, возврат в точку
    старта; шейки и поднутрения — резец заходит сверху) и G70 (чистовой по контуру) в G0/G1/G2/G3. Разворачивает
    дисплей: STM32 видит строки по одной, а циклу нужен весь контур. Исполнитель пишет копию /.run.nc
    («номер строки<TAB>кадр») — экран и страница показывают строку исходной программы.
  - Веб-страница: /api/plan — рисует все проходы, как их выполнит станок; закраска и резец — по кадру
    развёрнутой программы (step в /api/exec); ошибка цикла видна до запуска.
  - STM32: G28 U0 W0 — на месте (референтной точки у станка нет; ехать в ноль детали опасно); U/W — приращения.
  - Примеры: gcode_sample/pawn_g71.nc (программа владельца как есть), pawn.nc (моя: шар, шейка, воротник,
    расширение, основание — заготовка ⌀28).
  - tests/gcode_cycles/run.sh: все примеры, проверка «резец не заходит в деталь» (и что она ловит врезание),
    развёрнутые программы — через симулятор STM32: 124 и 78 строк, 0 ошибок. Регресс симуляции 213/213.
- Стенд (Wi-Fi, Mega следует за моторами, шпиндель 600 об/мин): pawn.nc и pawn_g71.nc — «Готово», каретка точно в
  точке старта (Z2, ⌀30 / ⌀32); страница закрашивает пройденные проходы и показывает резец по ходу обдирки.

## 2026-11-08 (вечер) — ноль детали, оси Z/X, время программы

### Замечания владельца
1. Непонятно, куда подводить резец для нуля — показать перед стартом.
2. Путаница осей: на странице Z, на дисплее Y — привести к одному, нарисовать оси станка.
3. Показывать оставшееся время и расчётное время программы после загрузки. Резцы — смена/подсказка/выбор?
4. Щуп для нуля (касание резцом, как концевик у ЧПУ и 3D-принтера) — узнать, как делают.

### Сделано
- Оси: продольная — **Z** везде на дисплее (было Y, как у автора 7e2 и на блоке DRO), X — поперечная; так в G-коде
  и по ISO 841. docs/img/lathe_zero.svg — рисунок станка с осями и точками касания; разделы «Оси» (CONTROLS.md)
  и «Ноль детали» (GCODE.md). LCD2004 автора не трогали (там Y); сверка экранов сопоставляет LCD «Y» с экраном «Z».
- M8: ячейка X — **диаметр** («⌀ ДИАМЕТР X», как X в программе; раньше показывала радиус: ⌀40 → «20.00»), долгое
  нажатие — ввод диаметра заготовки. Подсказка на экране: «НОЛЬ Z: ТОРЕЦ / ⌀ X: КАСАНИЕ И ВВОД ⌀».
- Веб-страница: «Старт» открывает окно «Перед стартом» — рисунок, шаги с числами программы (⌀ точки старта, вылет
  из патрона, точка старта, резцы T, шпиндель), «Всё сделано — Старт». Ссылка …/#start=файл открывает окно сразу.
- Время: модель исполнителя STM32 (gcode_cycles.cpp GCodeTime_Lines: ускоренный ход, подача/на оборот, дуги
  отрезками, разгон, обмен строками) по механике из настроек STM32 и текущим оборотам (стоит — 600). Страница —
  «Время ≈ 6 мин 22 с» сразу после выбора файла (/api/info), во время работы «осталось ≈ …» (eta в /api/exec),
  дисплей — ячейка «ОСТАЛОСЬ м:сс»; процент — по времени, а не по байтам файла. Прогноз поправляется по факту.
  Стенд: chamfer_arc — расчёт 27 с, факт 27 с; pawn.nc — 383 / 384 с, прогноз на 25/50/75 % — ошибка ≤ 3 с.
- Найдено и исправлено: разгон в G-коде растягивался на каждый короткий отрезок дуги (0.1 мм = 80 шагов < 400
  шагов разгона) — дуги шли в 3–4 раза медленнее подачи. Разгон теперь только выше 1000 шагов/с: подача и дуги — с
  заданной скоростью. Симуляция 213/213, циклы — OK.
- Найдено: оценка брала «последние ненулевые» обороты — после остановки шпинделя бывает выброс (1500) → берутся
  текущие.
- В бэклог: BACKLOG-034 (резцы: пауза на смену по T, подсказка по контуру, выбор резца → генератор траектории) и
  BACKLOG-035 (щуп для нуля: изолированный резцедержатель или пластина из фольгированного стеклотекстолита).
- M8: имя файла без «G-КОД:» и с многоточием — длинное наезжало на подсказку о нуле.
- Регресс: сверка экранов 305/305 (шаблоны ячеек Y → Z), симуляция 213/213, tests/gcode_cycles OK, сборки
  10.1" и 4.3" — OK. Снимки docs/img: gcode_done.jpg, gcode_error.jpg (новые подписи), gcode_prestart.jpg.

## 2026-11-08 (ночь) — G-КОД с теми же ячейками, что везде

- По просьбе владельца M8 приведён к общему виду: ПОЗИЦИЯ Z, ПОЗИЦИЯ X, плитка «⌀ ДИАМЕТР» на обычном месте,
  ВЫПОЛНЕНО, ОСТАЛОСЬ. X программы берётся из плитки «⌀ ДИАМЕТР» (STM32: e2_gc_disp_mm — половина DIAM_X),
  «ПОЗИЦИЯ X» на программу не влияет. Ноль — как в обычной работе: Z у торца, касание диаметра и ввод ⌀.
  Окно «Перед стартом», подсказка на экране и GCODE.md — под это.
- Симуляция 215/215 (новая проверка: X = 7, ⌀ = 20 → G0 X20 на месте, G0 X30 — +5 по радиусу), стенд —
  chamfer_arc в цель, 26 с при расчёте 27.
- PlatformIO не мог доставить Python-пакеты (сеть теряла пакеты) — прошивка с PLATFORMIO_OFFLINE=1.
- Владелец ставит KiCad 10 (KiCad MCP требует 9+); обновление ESP32-C6 — делаем (решение владельца).

## 2026-11-08 (ночь) — шилд rev 2 (BACKLOG-019), KiCad MCP

- Установлены KiCad 10.0.8 (владелец) и KiCad MCP-сервер (.tools/, в git не попадает; подключён к проекту локально).
- По образцу Shield3.0 владельца (Mega, 100×53 мм, штыревые разъёмы 2.54 с защёлкой): rev 2 — плата 96×126 мм
  (было 180×146), Discovery сверху в гнёздах (видны кнопки, светодиоды, оба USB), мелочь SMD 0805 и MMBT3904
  (SOT-23) под Discovery — каждая деталь ближе к своим выводам, разъёмы KK-254/KF2510 по трём краям со стороны
  «своих» выводов P1/P2, режимы — IDC 2×5 с подписями M1…M8; на шелкографии — номиналы мелочи и назначение
  каждого вывода. BOM — понятные названия «что покупать». ERC 0, DRC 0 (кроме неразведённых связей).
- Трассировка: в KiCad нет своего автотрассировщика, autoroute MCP — это Freerouting; скачивание jar
  заблокировано защитой — ждёт решения владельца.
- Владелец разрешил Freerouting: v2.1.0 (под Java 21; 2.2+ требует Java 25) в .tools/. Трассировка через KiCad MCP
  autoroute (3 попытки, лучшая — 86 цепей), переходы к земле — add_gnd_stitching_vias. Земля доведена скриптом
  fix_zones.py: расстановщик MCP проверяет зазор не по всем формам (переходы ближе 0.25 мм — удалить), тепловые
  связки у тесных разъёмов «голодали» (подключение сплошное), оторванные куски верхней земли — переход в каждый
  (у C3 — переход 0.6 с короткой дорожкой). Нашёл и исправил ошибку в своей проверке: путь дорожки верхнего
  слоя сверялся и с нижним слоем. Обход SWIG KiCad 10: GetEffectiveShape() портит обёртки — своя геометрия.
- Итог: DRC 0 нарушений и 0 неразведённых; сверка со схемой — цепи 1:1 (предупреждения — только префикс «/» и
  сокращённые номиналы на шелкографии). Gerber + сверловка — hardware/shield/els_shield_gerbers.zip.

## 2026-11-08 (вечер) — шилд: полная перепроверка перед заказом

Просьба владельца: досконально проверить каждую ножку, каждый модуль, сравнить со старым Shield3.0, ничего не
забыть — после заказа не исправить.
- Старый Shield3.0 (Gerber владельца): 100×53, разъёмы 2.54 с защёлкой, IDC под режимы, RESET, перемычка,
  компаратор LM2903, подстроечники контраста (параллельный LCD). Нам из этого нужно: аналог перемычки питания
  (см. ниже); RESET — на Discovery; контраст — на I2C-модуле LCD; компаратор прошивкой не используется.
- UM1472 (руководство ST, копия с GitHub — сайт ST недоступен): таблица P1/P2 — все 81 сигнал совпадают с design.py;
  рис. 10 — геометрия гнёзд совпадает; схемы платы — что висит на наших выводах: PC4 → микрофон через R49 —
  не установлен; аудио-ЦАП в сбросе; PE3 — CS акселерометра (PA5–7 не используем) — мешающих нет.
- Найдено и исправлено:
  - Питание: +5V шилда было соединено с выводом 5V Discovery напрямую — от USB ST-LINK без блока питания дисплей,
    LCD и энкодеры питались бы через диод Discovery (наружу — до 100 мА). Добавлен D1 (Шоттки B5819W):
    блок → Discovery, но не наоборот.
  - J7 режимы: выводы шли в порядке пинов Mega (3 = конус, 5 = резьба) — теперь вывод N = режим M N, легенда
    «1 M1 … 8 M8 9 GND 10 GND».
  - +5V (дисплей до 1.5 А): дорожки 1.0 мм где помещается (widen_power.py), остальное 0.6.
  - Земля: полигоны оставляли эмиттеры ключей на оторванных кусках — GND теперь разводится дорожками, полигоны
    после; fix_zones.py — граф связности земли, дубликаты и хвосты Freerouting, переходы на выводах разъёмов.
  - Корпус D1 (SOD-123) заходил на гнездо J2 — зона у гнёзд шире.
- Найдено, на плату не влияет: отладочный TX PA9 на Discovery сидит на VBUS с 4.7 мкФ (C49) — передача на 115200
  не работает (приём работает); в README шилда.
- verify.py → CHECK.md: каждый контакт — подпись на плате, медь, детали, гнездо, STM32, функция прошивки:
  0 замечаний. DRC 0, сверка со схемой — цепи 1:1. Gerber — els_shield_gerbers.zip.

## 2026-11-08 (поздний вечер) — руководство пользователя (BACKLOG-032)

- docs/manual/README.md: оси, пульт, экран, ноль, упоры и автоцикл, все режимы, примеры (проточка ⌀30→⌀28,
  резьба M20×1.5 длиной 80 мм — порядок по коду автора и тестам автоциклов), настройки, все сообщения с FAQ.
- Снимки — с дисплея 10.1" на стенде (tools/docs_gen/manual_shots.py: режимы и подэкраны командами дисплея,
  проверка по переменным STM32, сообщения тем же протоколом), стрелки-номера и маски имени сети — annotate.py.
  Исходники снимков (с именем сети) — не в git.
- Найдено при съёмке и исправлено: окно сообщения из 3 строк — третья уходила под OK (высота по переносу строк).
  Замечено: «UP/DOWN» на экранном джойстике (в BACKLOG-023).
- Урок: экраны настроек — закрывать известными кнопками (экран «ЛИНЕЙКИ» не отмечен в UIDUMP; случайные касания
  попадали в «ПУСК» калибровки — спас шпиндель, который крутился). Ничего не сохранилось (STM32 не перезагружался).

## 2026-11-08 (ночь) — руководство: G-код по шагам, калибровка по шагам; начало BACKLOG-033

- Замечания владельца к руководству: нет инструкции с веб-снимками по запуску G-кода; калибровка без пошаговой
  инструкции для линеек, блока DRO и без них.
- M8 в руководстве — от файла до детали в 6 шагов: страница с выбранным файлом, окно «Перед стартом», ход
  программы (страница и экран), готово/ошибка. Снимки страницы — tools/docs_gen/web_shots.py (headless Chrome,
  ход — прогон pawn_g71.nc на стенде через gcode_wifi_hil.py), имя сети в шапке — маска.
- Калибровка — три способа по шагам (А линейки, Б блок DRO: X в радиусе, мм; В индикатор: натяг, ход меньше хода
  индикатора, пример расчёта). Снимки сняты на стенде по-настоящему: Mega следует за моторами с люфтом 80 мкм —
  калибровка показала винт 2.000, люфт 80 мкм. «ПРИМЕНИТЬ» не нажималось.
- Дисплей: веб-ссылка `#file=имя` — открыть файл без окна старта; окно калибровки писало ось «Y» — теперь «Z».
- annotate.py: снимки любого размера (PNG веб-страницы), ширина результата до 960.
- BACKLOG-033, первая версия: docs/assembly/README.md — что купить (по группам, с тем, что искать), заказ шилда на
  JLCPCB, пайка по порядку и проверки мультиметром, карта разъёмов (по координатам из els_shield.kicad_pcb),
  11 схем «разъём шилда → провод → модуль» (tools/docs_gen/shield_docs.py, подписи — из design.TERMINALS),
  первое включение по блокам. Кабель дисплея 10.1" — по схеме CN2 (1 VIN, 2 TXD, 3 RXD, 4 GND): TX/RX
  перекрёстные. pins.md — колонка «Шилд»; раздел шилда в docs/index.html обновлён (был про rev 1).
- Заметка: docs/README.md, раздел 7 советует «монитор входов» через USB-UART на PA9 — на Discovery TX PA9 сидит на
  VBUS с 4.7 мкФ; проверить на стенде, работает ли передача, и поправить текст.

## 2026-11-08 — релиз v0.2.0 (по решению владельца)

- docs/RELEASE.md — «Что нового в v0.2.0»: G-код по Wi-Fi, НАСТРОЙКИ и калибровка, линейки в автоциклах,
  исправления ядра, документация (руководство, сборка), шилд rev 2. Локальная сборка make_release.sh — успешно,
  в файлах дисплея нет данных Wi-Fi. Тег v0.2.0 → GitHub Actions собирает и публикует релиз.
- Дальше: BACKLOG-011 (касания у краёв, раскладка 10.1", TEST_CASES.md, aFeed > 32767, двойной тап), проверка TX PA9
  для монитора входов; в конце — Wi-Fi 4.3" 5 перезагрузок и обновление ESP32-C6.

## 2026-11-12 — интерактивная схема подключения docs/wiring.html (BACKLOG-033)

- Просьба владельца: вернуть удалённую HTML-схему (pinout.html/schematic.html, удалены 2026-11-02 в a6f2c75 — там были
  выводы портов F/G, которых нет у STM32F407VG на Discovery). Изучены старые страницы: canvas, плата в центре,
  модули по бокам, детали на линиях, pan/zoom, вкладки (блок-схема, выводы МК, таблица).
- Сделано заново, из настоящих данных: tools/docs_gen/wiring_html.py → docs/wiring.html (одна страница, без интернета):
  «Полная схема» — Discovery сверху со всеми 100 выводами P1/P2, 20 модулей со значками «как выглядят», провод от
  каждой ноги к клемме, детали шилда на линии (из design.PARTS), подпись разъёма шилда у клеммы; наведение/клик —
  подсветка цепи и подсказка (STM32, Discovery, шилд, модуль, детали, вывод у автора на Mega); поиск; масштаб
  колесом и пальцами. «Шилд» — плата с разъёмами по KiCad, подписи выводов, наведение — куда идёт.
  «Таблица» — 61 сигнал, клик — показать на схеме. Проверено headless Chrome: подсветка, поиск, масштаб, без ошибок JS.
- Ссылки: README, docs/README, docs/index.html (раздел 5), docs/assembly. build_docs.py собирает страницу.

## 2026-11-12 — ручная перепроверка шилда перед заказом

- Просьба владельца: без доверия к своим скриптам проверки — по каждому выводу, детали, дорожке, сверить со старым
  Shield3.0, схемой автора ELS_V7, кодом 7e2 и проектом 7e2_Mod.
- По первоисточникам: UM1472 рис. 10 (все 100 выводов P1/P2, 53.34 мм, без зеркаления) и схемы рис. 13–16 (что
  висит на выводах на самой Discovery); код автора Menu.ino — битовые шаблоны режимов, подрежимов, кнопок,
  джойстика, упоров, РГИ → совпадают с e2_hal.h и порядком на разъёмах; каждая деталь и её площадки; путь меди
  каждой цепи от площадки до площадки (87 цепей, земля — 50 площадок без полигонов); шелкография — 87 подписей;
  ключ J7; механика (разъёмы не под Discovery).
- Найдено и исправлено: медь у крепёжных отверстий — DRO_RX (дорожка и открытый переход в 2.4 мм от центра H3,
  под головкой винта) и LED_LEFT_K/LED_RIGHT_K (3.3–3.9 мм от H2, под шайбой). Переложены (fix_holes.py, две попытки
  отклонил DRC — зазор 0.10 мм и замыкание с LED_FRONT_K — третья чистая): сигнальная медь теперь ≥ 4.8 мм от
  центров. DRC — 0 нарушений, 0 неразведённых; Gerber и сверловка пересобраны.
- Документация: USER на Discovery не ставит задний упор (подаёт «1», упор — от «0»); ENA драйвера — у автора ток =
  «включено», у многих DM542/TB6600 наоборот (проверка при первом включении); комментарий зуммера в e2_pins.h.

## 2026-11-12 — шилд: сброс и резервные разъёмы (J24–J27), не трогая разводку

- Вопрос владельца про LM293 старого шилда: по документу автора («Эл._гитара.docx», «Принтерный диск», «Формирователь
  сигнала») — компаратор для самодельного энкодера шпинделя на диске от принтера, не датчик резца. В схеме ELS_V7 —
  на входах энкодера 20/21.
- Добавлено по просьбе: верхний край — J24 СБРОС (NRST, P1-6), J25 ДАТЧИК (РЕЗЕРВ) (PA2 + подтяжка + 10 нФ),
  J26 РЕЗЕРВ ВЫХОДЫ PD13 PD15 (220 Ом), J27 РЕЗЕРВ PA5 PA7 (470 Ом). Свободные выводы Discovery выбраны по UM1472:
  PC14/15, PH0/1 не подведены к P2 без перепайки; PE0/1, PA6 — выходы акселерометра; PC3 — микрофон; PC0, PD5 — OTG.
- Как, не трогая проверенную плату: детали — в разведённую плату (add_reserve.py), старые 1425 дорожек закреплены,
  Freerouting 2.1 (класс Reserve: 0.2 мм, переход 0.6/0.3; через MCP зависал — запуск вручную, 100 проходов, 1 поток),
  в плату — только новые дорожки (merge_ses.py, без земли — иначе трассировщик соединял сшивающие переходы), оставшееся —
  своим волновым трассировщиком по картам меди (route_grid.py). PD12/PD14 (внутренний ряд P1) — путь ~150 мм с 9–10
  переходами: не выведены, J26 — 4 контакта. Прошивка: PA2 после старта USART2 — вход (drv_dro.cpp), E2_PIN_DRO_TX
  убран, резервные выводы описаны в e2_pins.h.
- Проверки: старые дорожки, детали и цепи площадок — без изменений (сверка со снимком); DRC 0 / 0 неразведённых; ERC 0;
  сверка со схемой — без цепи только неиспользуемые выводы; CHECK.md — 0 замечаний (verify.py: суффиксы _T/_OUT только
  в конце имени, NRST — сброс). Шелкография: «РЕЗЕРВ» на резервных разъёмах, подписи выводов узким шрифтом 0.6×0.8.
- Не проверено на стенде (отключён): чтение блока DRO после правки PA2 — BACKLOG-036.

## 2026-11-12 — DRO на стенде, 7" JC1060P470, режим с экрана во время движения
- Стенд: блок DRO после правки PA2 читается 6/6 (BACKLOG-036).
- 7" Guition JC1060P470 (по решению владельца — «как получится на основе 10.1», без железа): три прошивки —
  старая панель / «V2» / «V2» на ESP32-P4 rev 3; драйвер JD9165, таблицы панелей из ESPHome, тач GT911,
  поворот 180°, шрифты ×32/15 (`ELS_Display_P7/`, gen_p4_fonts.sh с NUM/DEN). В релизе пять файлов дисплеев.
  STM32 принимает тип 70; в релизе несовпадение типа — без алерта. Сборки 4.3"/10.1"/7"×3 и релиз — собираются.
- Конфликты галетник ↔ экран (вопрос владельца, BACKLOG-038): «кто последний, тот и прав»; найдено и исправлено —
  экран менял режим во время подачи (галетник в это время не действует). Найдено: экранный джойстик при
  механическом в нейтрали сдвигает лишь ~0.2 мм (BACKLOG-023).
- Инструкция под Windows `docs/windows/README.md` (BACKLOG-039): готовая прошивка (STM32CubeProgrammer, esptool-js)
  и своя сборка (VS Code + PlatformIO), 9 примеров настроек, 7". Картинки — windows_shots.py. Исправлено: сборка
  дисплея без локального wifi_config.h.

## 2026-11-12 — галетник и экран: подсказка о расхождении; подача M2 больше 32767
- BACKLOG-038, решение владельца — «кто последний, тот и прав». STM32 шлёт положение галетников `<SEL:m,s>`
  (Display_Watch и Display_Send_All), дисплей показывает на месте подрежима янтарное «галетник: …», если галетник
  стоит не там, где режим/подрежим. Проверено на стенде 10.1" (OpenOCD замыкает входы галетника): 8 шагов, снимки.
  Руководство: раздел 3 и частые вопросы.
- AFEED на дисплее — int32 (было int16: свыше 32767 показывалось −32768).
- Монитор входов через ST-Link `tools/io_monitor.py`: на Discovery TX PA9 сидит на VBUS USB OTG с 4.7 мкФ (C49),
  строки [IO] через USB-UART могут не доходить. Скрипт читает IDR входов по SWD (список и названия — из e2_core.cpp
  и e2_pins.h), щелчки РГИ и обороты/угол/направление шпинделя — по символам firmware.elf. Проверено на стенде:
  замыкание PD6 «Режим: Резьба» и отпускание, шпиндель 120 об/мин (эмуляция TIM5). docs/README §7 и index.html.
- 10.1" (BACKLOG-011):
  - TEST_CASES.md: прогон всех 215 кейсов на стенде — 36 падений, почти все устаревшие ожидания (проходы теперь
    «осталось/всего», как «Циклов» на LCD2004; «--» вместо «--/--»; подэкран 3 — ось Z в первой плитке; M8 «G-КОД»;
    K латиницей; AFEED 33024 — исправлено). 14 кейсов без команд переписаны на команды (TC-053, 183, 192–201, 205, 215).
    Раннер: `<TAP:x,y>`, `<WAIT:мс>`, `--only` списком, `<UIRESET>` перед каждым кейсом. Перепрогон 51 кейса — все PASS.
  - Найдено и исправлено: правка по таймауту 5 с при открытом барабане снимала подсветку, а барабан оставался висеть
    поверх экрана; теперь таймаут ждёт закрытия барабана. Поиск шага резьбы по имени — без учёта пробелов.
  - Проверка тача `<TOUCHTEST:1>`: 9 мишеней, промах и «сырые» координаты в лог — нужен палец владельца.
  - Большой экран (10.1", 7"): плитка «УПОРЫ» в M1/M2 — координаты упоров и длина между ними. Снимок на стенде.

## 2026-11-13 — руководство: конус и шар по шагам, снимки автоцикла
- docs/manual: пример наружного конуса 1:10 (M5, 8 проходов по 0.50) и шара ⌀20 с ножкой ⌀8 — по коду автора
  (Cone.ino: старт на правом упоре, врезание Съём/2, в «Конус >» резец на проходе влево уходит от оси;
  Sphere.ino: старт на правом и заднем упорах, врезания со сдвигом по Z, левая/правая кромка резца до/после
  экватора). Снимки цикла в работе — tools/docs_gen/cycle_shots.py на стенде. Заметка про 4.3" и 7".
  «Проходы» в описании экрана — «осталось / всего» (было «текущий / всего»).
- Стенд: шар вставал на 2-м проходе с «ПРОПУСК ШАГОВ Z: 1.00 ММ» — знак линейки Z ядро выучило неверным, пока
  эмулятор после перезапуска Mega «качался» (не связан с моторами); знак учится раз за включение. После сброса
  STM32 с Mega в режиме «следует за моторами» — цикл идёт. На станке знак — от настоящей линейки.

## 2026-11-13 — релиз v0.3.0 (по решению владельца)
- Перед тегом: автоциклы на стенде 10/10 (Mega «следует за моторами»), локальная сборка релиза — 6 прошивок
  (STM32 DRO, 4.3", 10.1", 7" ×3). docs/RELEASE.md — «Что нового в v0.3.0».
- Инструкция под Windows (вопрос владельца): «Чем готовая прошивка может не подойти» — явно, что механика, калибровка
  и источник координат задаются на экране и сохраняются во флеше STM32 (переживают выключение и перепрошивку,
  проверено в BACKLOG-028); в шагах STM32CubeProgrammer — не ставить Full chip erase.

## 2026-11-13 — демо-режим дисплея убран (по просьбе владельца)
- Тройное нажатие «ОК» запускало 30-секундное демо с выдуманными значениями и алертами — работало плохо и могло
  включиться случайно при быстрых нажатиях «ОК» (например, в делилке). Код демо удалён из `main.cpp`
  (вызов, функции, переменные). Собраны 10.1", 4.3", 7"; на 10.1" тройной «ОК» — экран остаётся в режиме, «DEMO» в
  логе нет. Тест-режим со сценариями (5× «▲» вне правки) пока оставлен.
