tepmehatop/Lathe-cnc-controller-stm32/hardware/shield/els_shield_schematic.pdf

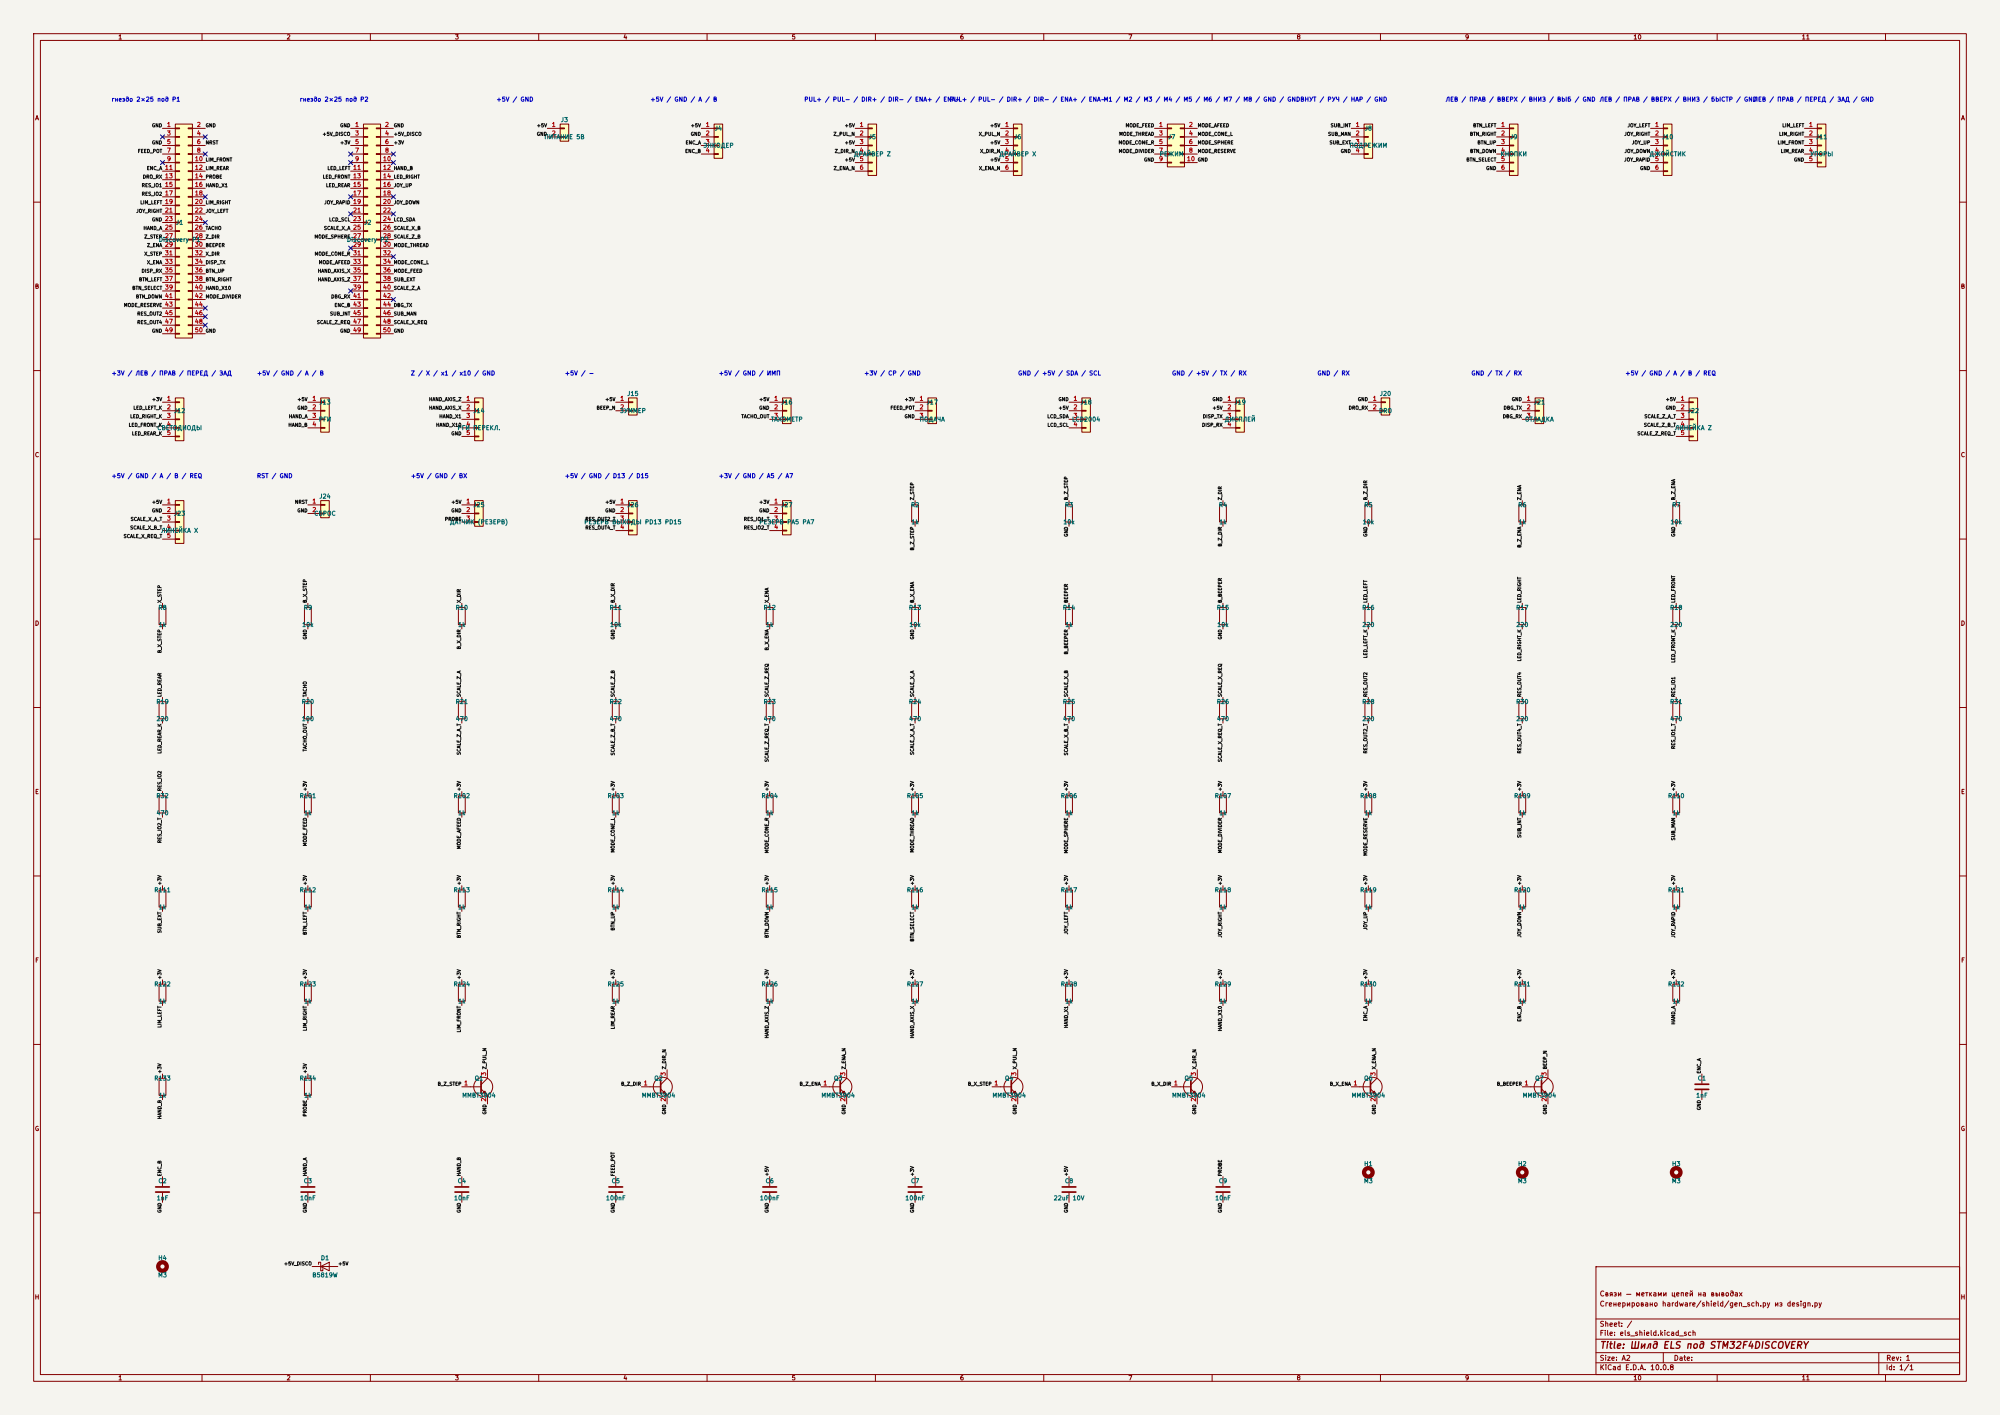
[picture p61: page 1]

гнездо 2×25 под P1 +3V / ЛЕВ / ПРАВ / ПЕРЕД / ЗАД +5V / GND / A / B / REQ

Связи — метками цепей на выводах
Сгенерировано hardware/shield/gen_sch.py из design.py

Sheet: /
File: els_shield.kicad_sch
Title: Шилд ELS под STM32F4DISCOVERY

Size: A2 | Rev: 1
KiCad E.D.A. 10.0.8 | Id: 1/1
