tepmehatop/Lathe-cnc-controller-stm32/hardware/shield/els_shield.kicad_pcb

## KiCad design hardware/shield/els_shield.kicad_pcb (2026-11-12)

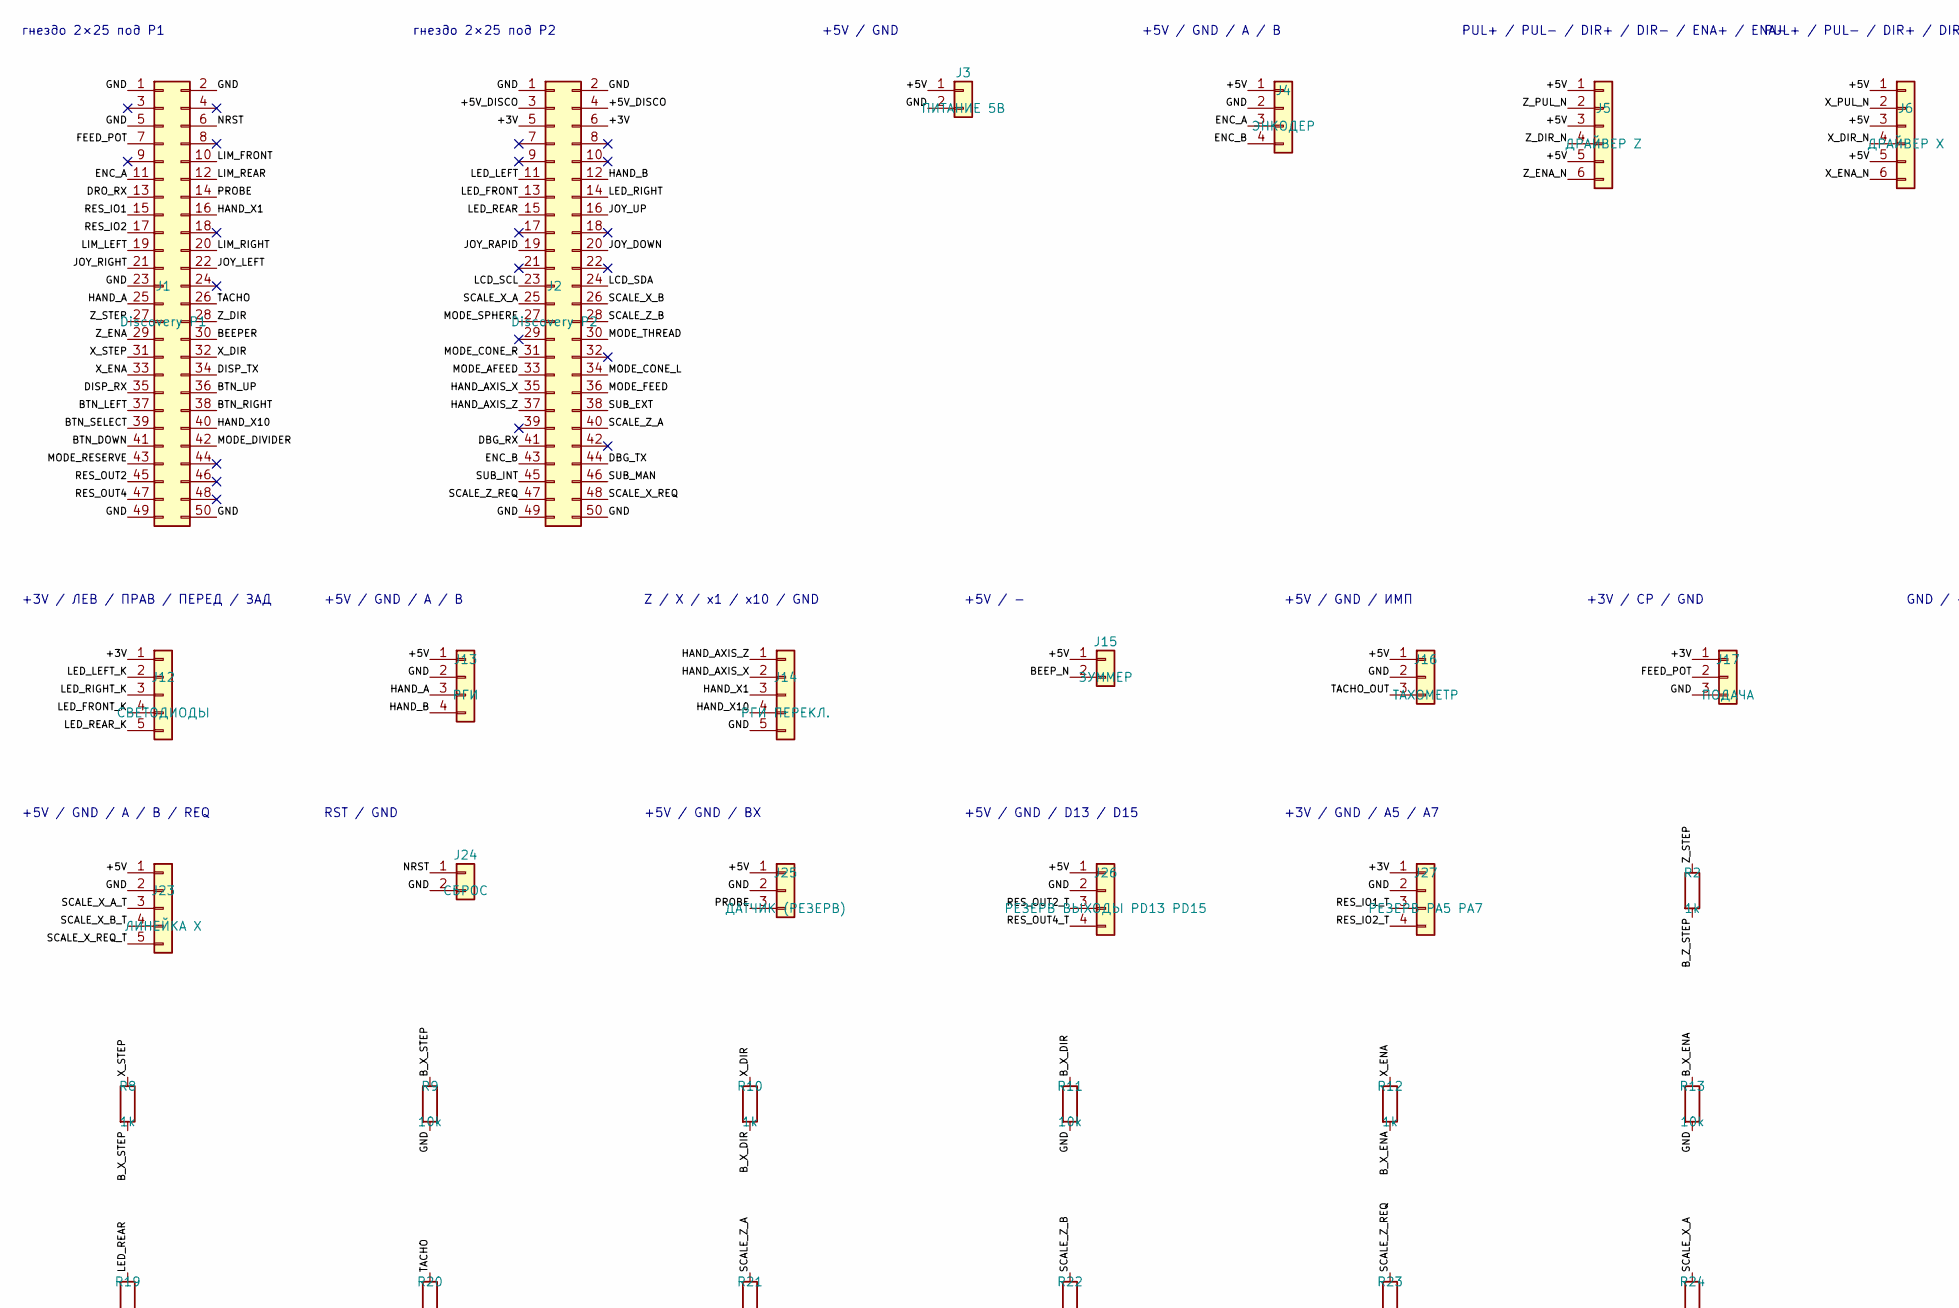
[picture p62: schematic els_shield.kicad_sch, Шилд ELS под STM32F4DISCOVERY, part in row 1, column 1]

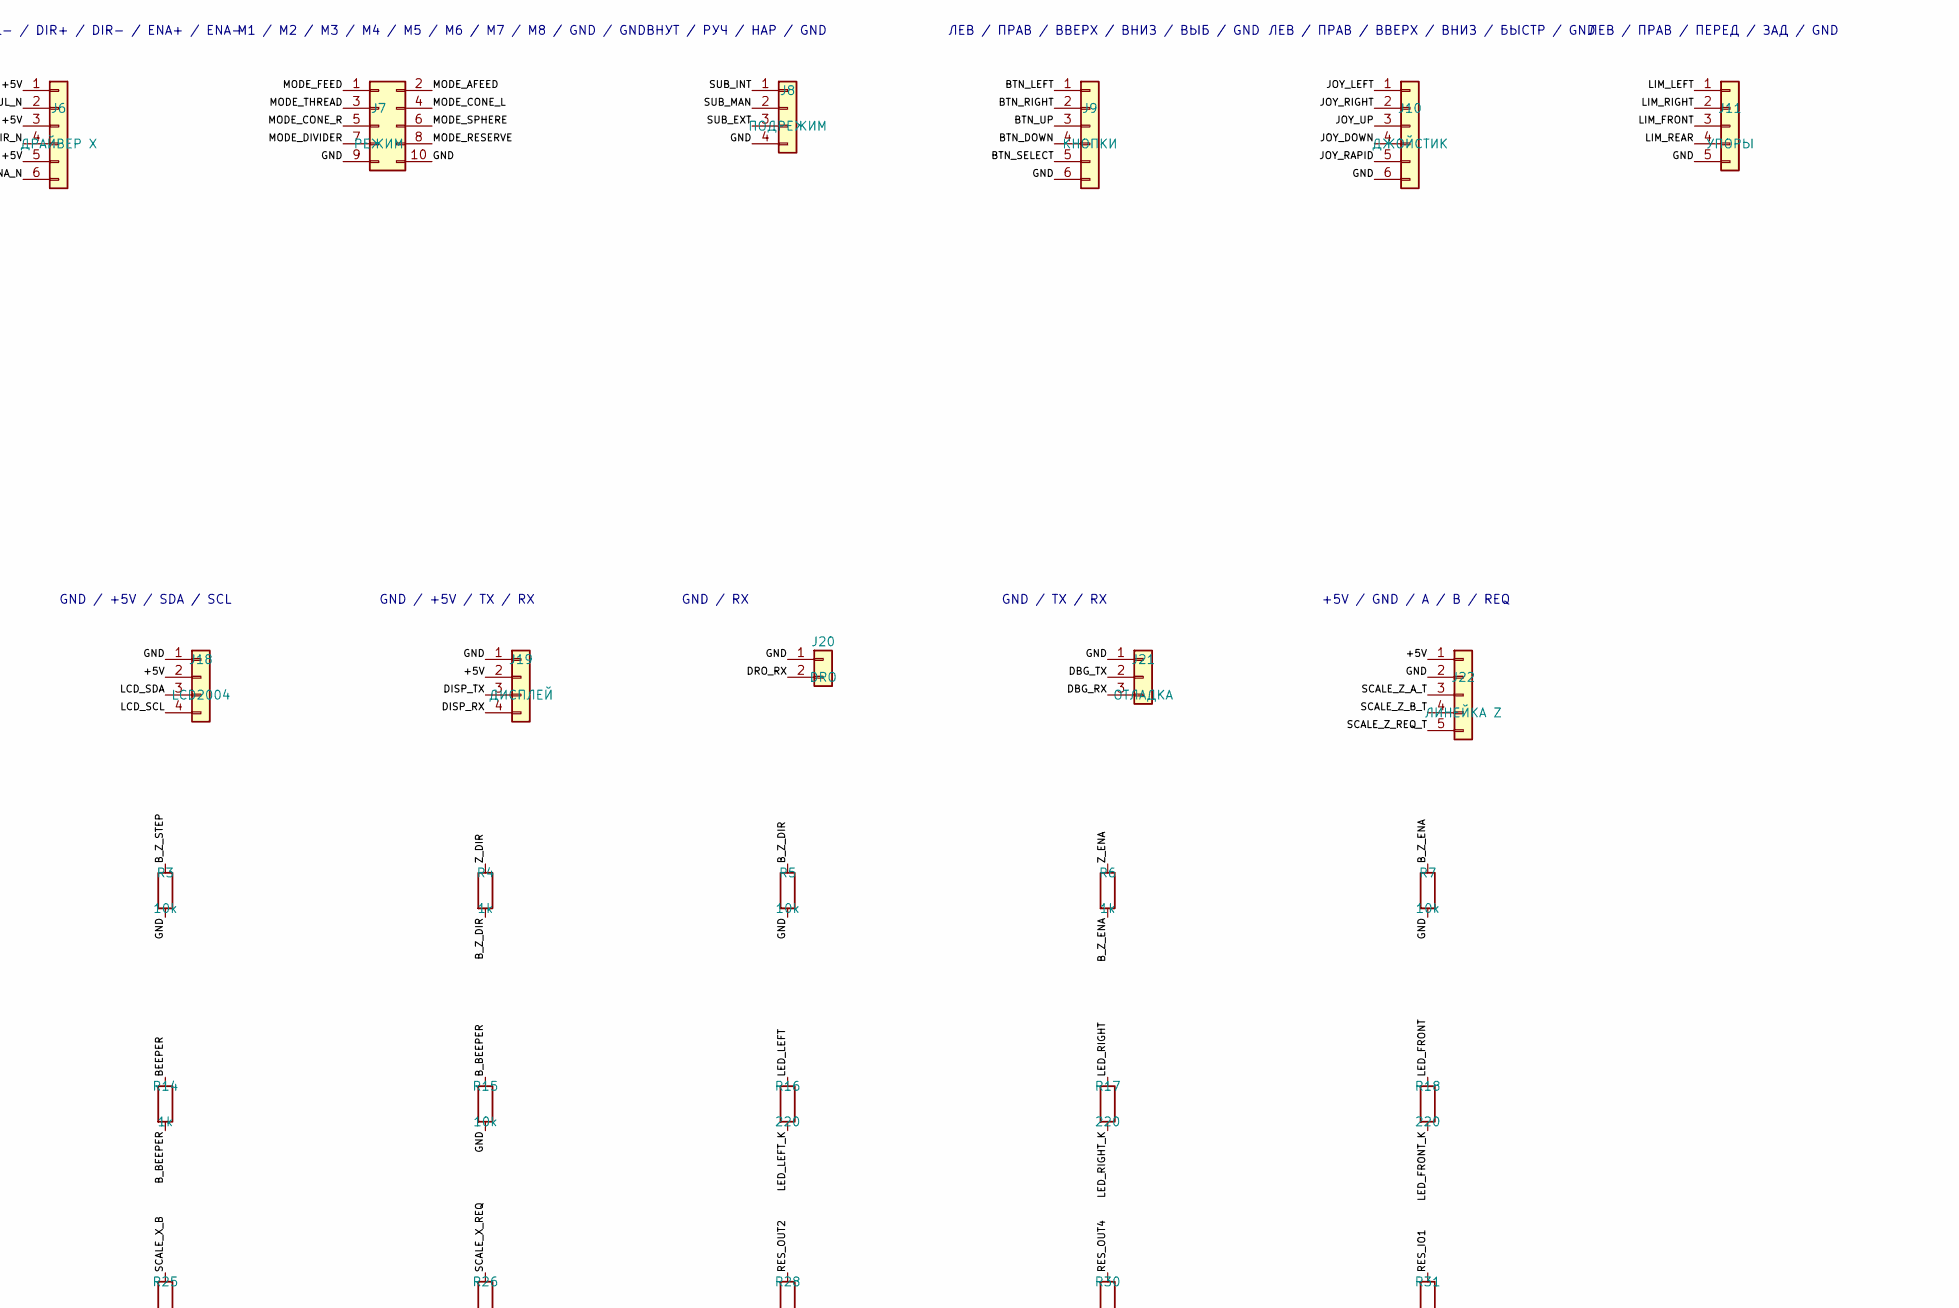
[picture p63: schematic els_shield.kicad_sch, Шилд ELS под STM32F4DISCOVERY, part in row 1, column 2]

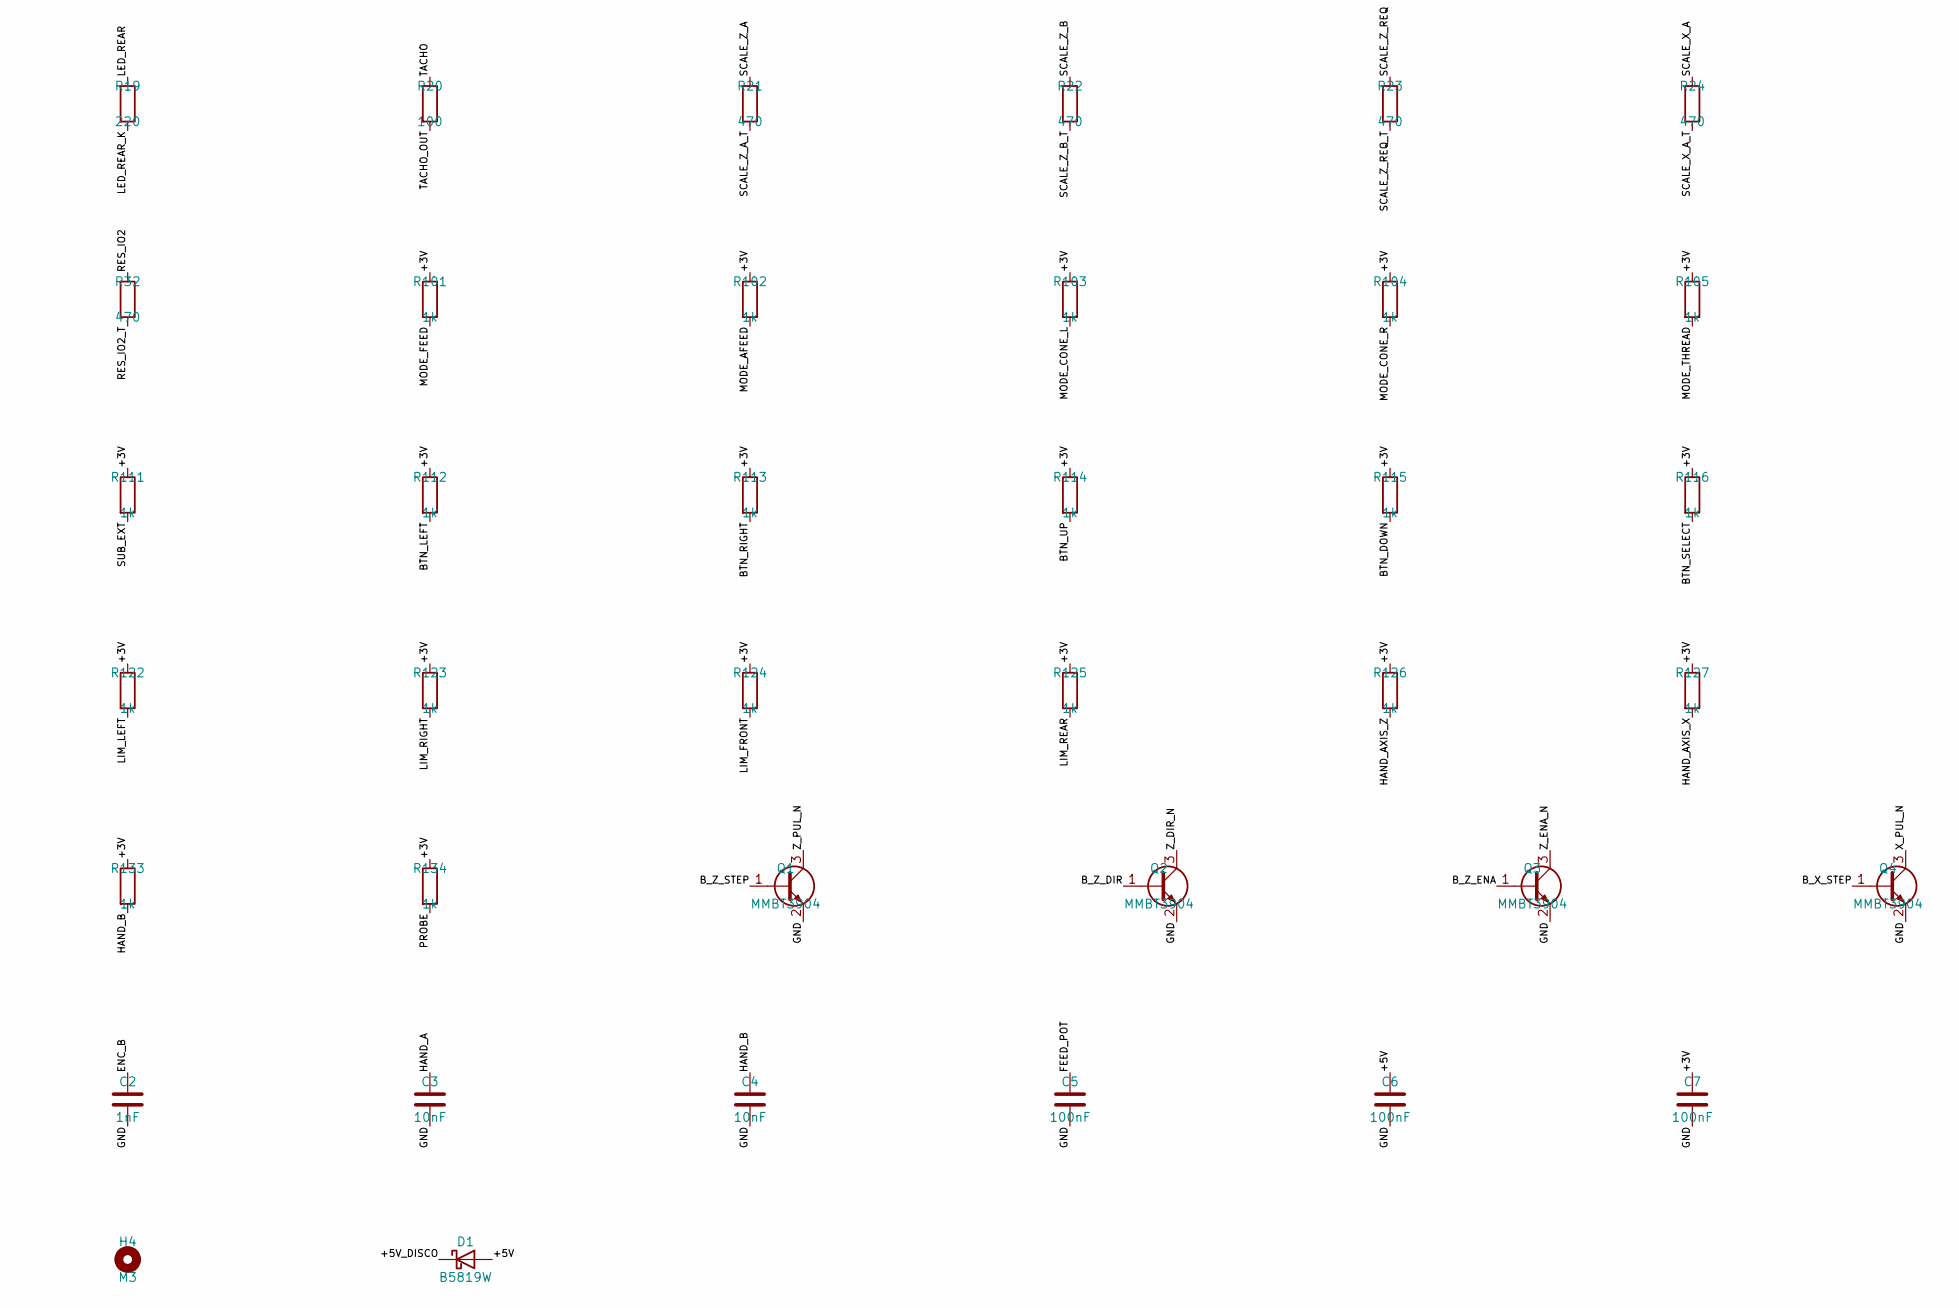
[picture p64: schematic els_shield.kicad_sch, Шилд ELS под STM32F4DISCOVERY, part in row 2, column 1]

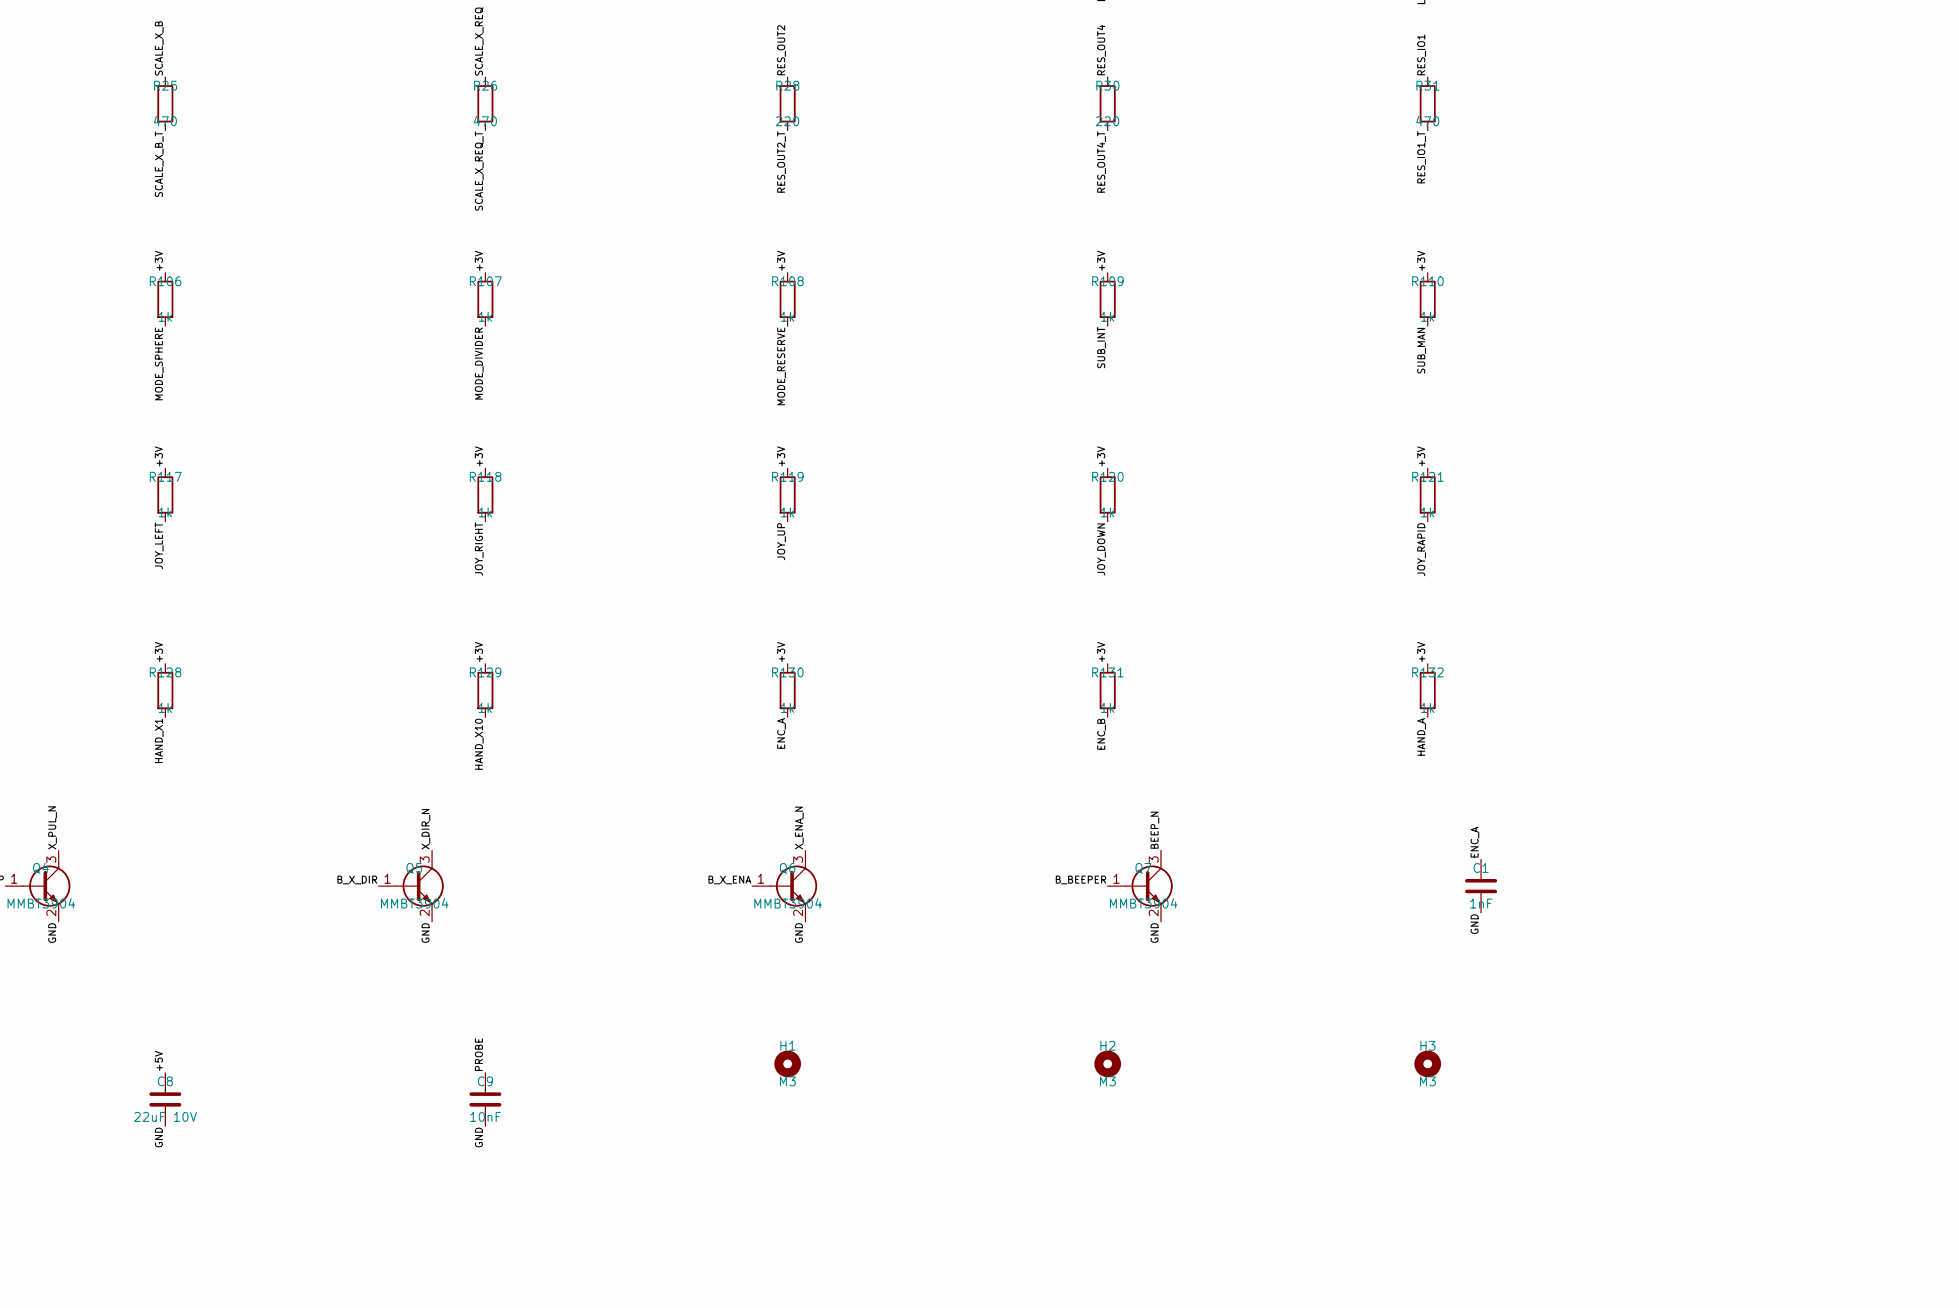
[picture p65: schematic els_shield.kicad_sch, Шилд ELS под STM32F4DISCOVERY, part in row 2, column 2]

Parts:
C1, C2: 1nF; C_0805_2012Metric
C3, C4, C9: 10nF; C_0805_2012Metric
C5, C6, C7: 100nF; C_0805_2012Metric
C8: 22uF 10V; C_1206_3216Metric
D1: B5819W; D_SOD-123
H1, H2, H3, H4: M3; MountingHole_3.2mm_M3
J1: Discovery P1; PinHeader_2x25_P2.54mm_Vertical
J2: Discovery P2; PinHeader_2x25_P2.54mm_Vertical
J3: ПИТАНИЕ 5В; Molex_KK-254_AE-6410-02A_1x02_P2.54mm_Vertical
J4: ЭНКОДЕР; Molex_KK-254_AE-6410-04A_1x04_P2.54mm_Vertical
J5: ДРАЙВЕР Z; Molex_KK-254_AE-6410-06A_1x06_P2.54mm_Vertical
J6: ДРАЙВЕР X; Molex_KK-254_AE-6410-06A_1x06_P2.54mm_Vertical
J7: РЕЖИМ; IDC-Header_2x05_P2.54mm_Vertical
J8: ПОДРЕЖИМ; Molex_KK-254_AE-6410-04A_1x04_P2.54mm_Vertical
J9: КНОПКИ; Molex_KK-254_AE-6410-06A_1x06_P2.54mm_Vertical
J10: ДЖОЙСТИК; Molex_KK-254_AE-6410-06A_1x06_P2.54mm_Vertical
J11: УПОРЫ; Molex_KK-254_AE-6410-05A_1x05_P2.54mm_Vertical
J12: СВЕТОДИОДЫ; Molex_KK-254_AE-6410-05A_1x05_P2.54mm_Vertical
J13: РГИ; Molex_KK-254_AE-6410-04A_1x04_P2.54mm_Vertical
J14: РГИ ПЕРЕКЛ.; Molex_KK-254_AE-6410-05A_1x05_P2.54mm_Vertical
J15: ЗУММЕР; Molex_KK-254_AE-6410-02A_1x02_P2.54mm_Vertical
J16: ТАХОМЕТР; Molex_KK-254_AE-6410-03A_1x03_P2.54mm_Vertical
J17: ПОДАЧА; Molex_KK-254_AE-6410-03A_1x03_P2.54mm_Vertical
J18: LCD2004; Molex_KK-254_AE-6410-04A_1x04_P2.54mm_Vertical
J19: ДИСПЛЕЙ; Molex_KK-254_AE-6410-04A_1x04_P2.54mm_Vertical
J20: DRO; Molex_KK-254_AE-6410-02A_1x02_P2.54mm_Vertical
J21: ОТЛАДКА; Molex_KK-254_AE-6410-03A_1x03_P2.54mm_Vertical
J22: ЛИНЕЙКА Z; Molex_KK-254_AE-6410-05A_1x05_P2.54mm_Vertical
J23: ЛИНЕЙКА X; Molex_KK-254_AE-6410-05A_1x05_P2.54mm_Vertical
J24: СБРОС; Molex_KK-254_AE-6410-02A_1x02_P2.54mm_Vertical
J25: ДАТЧИК (РЕЗЕРВ); Molex_KK-254_AE-6410-03A_1x03_P2.54mm_Vertical
J26: РЕЗЕРВ ВЫХОДЫ PD13 PD15; Molex_KK-254_AE-6410-04A_1x04_P2.54mm_Vertical
J27: РЕЗЕРВ PA5 PA7; Molex_KK-254_AE-6410-04A_1x04_P2.54mm_Vertical
Q1, Q2, Q3, Q4, Q5, Q6, Q7: MMBT3904; SOT-23
R2, R4, R6, R8, R10, R12, R14, R101, R102, R103, R104, R105, R106, R107, R108, R109, R110, R111, R112, R113, R114, R115, R116, R117, R118, R119, R120, R121, R122, R123, R124, R125, R126, R127, R128, R129, R130, R131, R132, R133, R134: 1k; R_0805_2012Metric
R3, R5, R7, R9, R11, R13, R15: 10k; R_0805_2012Metric
R16, R17, R18, R19, R28, R30: 220; R_0805_2012Metric
R20: 100; R_0805_2012Metric
R21, R22, R23, R24, R25, R26, R31, R32: 470; R_0805_2012Metric

Connections:
+3V: C7.1, J2.5, J2.6, J12.1, J17.1, J27.1, R101.1, R102.1, R103.1, R104.1, R105.1, R106.1, R107.1, R108.1, R109.1, R110.1, R111.1, R112.1, R113.1, R114.1, R115.1, R116.1, R117.1, R118.1, R119.1, R120.1, R121.1, R122.1, R123.1, R124.1, R125.1, R126.1, R127.1, R128.1, R129.1, R130.1, R131.1, R132.1, R133.1, R134.1
+5V: C6.1, C8.1, D1.2 (A), J3.1, J4.1, J5.1, J5.3, J5.5, J6.1, J6.3, J6.5, J13.1, J15.1, J16.1, J18.2, J19.2, J22.1, J23.1, J25.1, J26.1
+5V_DISCO: D1.1 (K), J2.3, J2.4
BEEPER: J1.30, R14.1
BEEP_N: J15.2, Q7.3 (C)
BTN_DOWN: J1.41, J9.4, R115.2
BTN_LEFT: J1.37, J9.1, R112.2
BTN_RIGHT: J1.38, J9.2, R113.2
BTN_SELECT: J1.39, J9.5, R116.2
BTN_UP: J1.36, J9.3, R114.2
B_BEEPER: Q7.1 (B), R14.2, R15.1
B_X_DIR: Q5.1 (B), R10.2, R11.1
B_X_ENA: Q6.1 (B), R12.2, R13.1
B_X_STEP: Q4.1 (B), R8.2, R9.1
B_Z_DIR: Q2.1 (B), R4.2, R5.1
B_Z_ENA: Q3.1 (B), R6.2, R7.1
B_Z_STEP: Q1.1 (B), R2.2, R3.1
DBG_RX: J2.41, J21.3
DBG_TX: J2.44, J21.2
DISP_RX: J1.35, J19.4
DISP_TX: J1.34, J19.3
DRO_RX: J1.13, J20.2
ENC_A: C1.1, J1.11, J4.3, R130.2
ENC_B: C2.1, J2.43, J4.4, R131.2
FEED_POT: C5.1, J1.7, J17.2
GND: C1.2, C2.2, C3.2, C4.2, C5.2, C6.2, C7.2, C8.2, C9.2, J1.1, J1.2, J1.5, J1.23, J1.49, J1.50, J2.1, J2.2, J2.49, J2.50, J3.2, J4.2, J7.9, J7.10, J8.4, J9.6, J10.6, J11.5, J13.2, J14.5, J16.2, J17.3, J18.1, J19.1, J20.1, J21.1, J22.2, J23.2, J24.2, J25.2, J26.2, J27.2, Q1.2 (E), Q2.2 (E), Q3.2 (E), Q4.2 (E), Q5.2 (E), Q6.2 (E), Q7.2 (E), R3.2, R5.2, R7.2, R9.2, R11.2, R13.2, R15.2
HAND_A: C3.1, J1.25, J13.3, R132.2
HAND_AXIS_X: J2.35, J14.2, R127.2
HAND_AXIS_Z: J2.37, J14.1, R126.2
HAND_B: C4.1, J2.12, J13.4, R133.2
HAND_X1: J1.16, J14.3, R128.2
HAND_X10: J1.40, J14.4, R129.2
JOY_DOWN: J2.20, J10.4, R120.2
JOY_LEFT: J1.22, J10.1, R117.2
JOY_RAPID: J2.19, J10.5, R121.2
JOY_RIGHT: J1.21, J10.2, R118.2
JOY_UP: J2.16, J10.3, R119.2
LCD_SCL: J2.23, J18.4
LCD_SDA: J2.24, J18.3
LED_FRONT: J2.13, R18.1
LED_FRONT_K: J12.4, R18.2
LED_LEFT: J2.11, R16.1
LED_LEFT_K: J12.2, R16.2
LED_REAR: J2.15, R19.1
LED_REAR_K: J12.5, R19.2
LED_RIGHT: J2.14, R17.1
LED_RIGHT_K: J12.3, R17.2
LIM_FRONT: J1.10, J11.3, R124.2
LIM_LEFT: J1.19, J11.1, R122.2
LIM_REAR: J1.12, J11.4, R125.2
LIM_RIGHT: J1.20, J11.2, R123.2
MODE_AFEED: J2.33, J7.2, R102.2
MODE_CONE_L: J2.34, J7.4, R103.2
MODE_CONE_R: J2.31, J7.5, R104.2
MODE_DIVIDER: J1.42, J7.7, R107.2
MODE_FEED: J2.36, J7.1, R101.2
MODE_RESERVE: J1.43, J7.8, R108.2
MODE_SPHERE: J2.27, J7.6, R106.2
MODE_THREAD: J2.30, J7.3, R105.2
NRST: J1.6, J24.1
PROBE: C9.1, J1.14, J25.3, R134.2
RES_IO1: J1.15, R31.1
RES_IO1_T: J27.3, R31.2
RES_IO2: J1.17, R32.1
RES_IO2_T: J27.4, R32.2
RES_OUT2: J1.45, R28.1
RES_OUT2_T: J26.3, R28.2
RES_OUT4: J1.47, R30.1
RES_OUT4_T: J26.4, R30.2
SCALE_X_A: J2.25, R24.1
SCALE_X_A_T: J23.3, R24.2
SCALE_X_B: J2.26, R25.1
SCALE_X_B_T: J23.4, R25.2
SCALE_X_REQ: J2.48, R26.1
SCALE_X_REQ_T: J23.5, R26.2
SCALE_Z_A: J2.40, R21.1
SCALE_Z_A_T: J22.3, R21.2
SCALE_Z_B: J2.28, R22.1
SCALE_Z_B_T: J22.4, R22.2
SCALE_Z_REQ: J2.47, R23.1
SCALE_Z_REQ_T: J22.5, R23.2
SUB_EXT: J2.38, J8.3, R111.2
SUB_INT: J2.45, J8.1, R109.2
SUB_MAN: J2.46, J8.2, R110.2
TACHO: J1.26, R20.1
TACHO_OUT: J16.3, R20.2
X_DIR: J1.32, R10.1
X_DIR_N: J6.4, Q5.3 (C)
X_ENA: J1.33, R12.1
X_ENA_N: J6.6, Q6.3 (C)
X_PUL_N: J6.2, Q4.3 (C)
X_STEP: J1.31, R8.1
Z_DIR: J1.28, R4.1
Z_DIR_N: J5.4, Q2.3 (C)
Z_ENA: J1.29, R6.1
Z_ENA_N: J5.6, Q3.3 (C)
Z_PUL_N: J5.2, Q1.3 (C)
Z_STEP: J1.27, R2.1

Notes on the sheet:
гнездо 2×25 под P1
гнездо 2×25 под P2
+5V / GND
+5V / GND / A / B
PUL+ / PUL- / DIR+ / DIR- / ENA+ / ENA-
M1 / M2 / M3 / M4 / M5 / M6 / M7 / M8 / GND / GND
ВНУТ / РУЧ / НАР / GND
ЛЕВ / ПРАВ / ВВЕРХ / ВНИЗ / ВЫБ / GND
ЛЕВ / ПРАВ / ВВЕРХ / ВНИЗ / БЫСТР / GND
ЛЕВ / ПРАВ / ПЕРЕД / ЗАД / GND
+3V / ЛЕВ / ПРАВ / ПЕРЕД / ЗАД
Z / X / x1 / x10 / GND
+5V / -
+5V / GND / ИМП
+3V / СР / GND
GND / +5V / SDA / SCL
GND / +5V / TX / RX
GND / RX
GND / TX / RX
+5V / GND / A / B / REQ
RST / GND
+5V / GND / ВХ
+5V / GND / D13 / D15
+3V / GND / A5 / A7

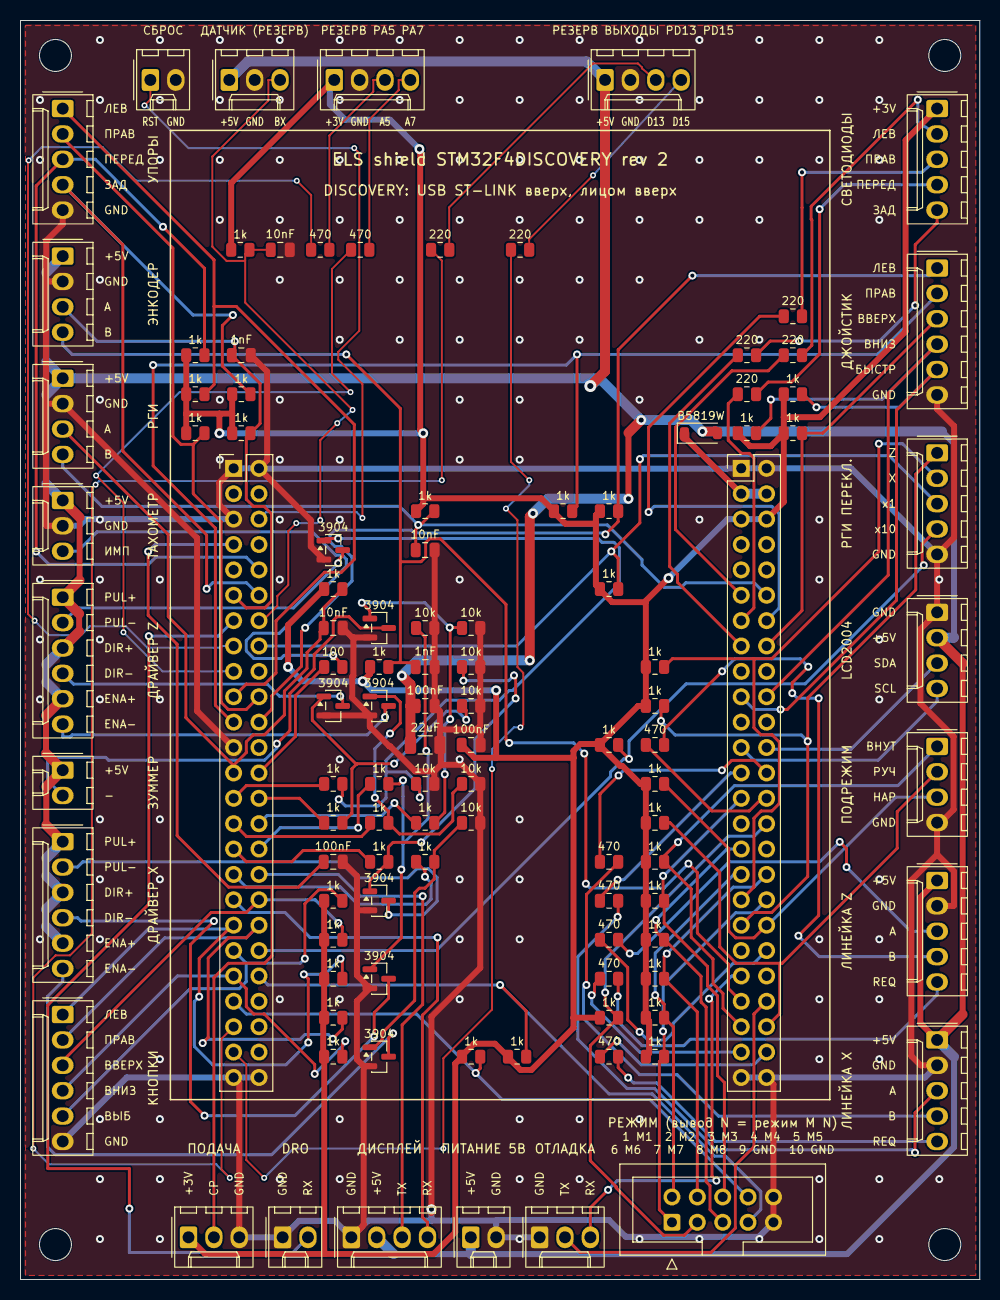
[picture p66: board els_shield.kicad_pcb from above]

Board: 2 copper layers, 96.0 x 126.0 mm, 111 parts (0 on the bottom side), 98 nets.
