tepmehatop/Lathe-cnc-controller-stm32/ELS_Display/src/main.cpp

/**
 * @file main.cpp
 * @brief ELS Display - Main firmware for ESP32/ESP32-S3/ESP32-P4
 *
 * Supports:
 * - ESP32-2432S024 (2.4" 320x240)   - ILI9341 via TFT_eSPI
 * - JC4827W543     (4.3" 480x272)   - NV3041A via Arduino_GFX, ESP32-S3
 * - JC8012P4A1C    (10.1" 800x1280) - JD9365 via MIPI-DSI, ESP32-P4
 * - JC1060P470     (7" 1024x600)    - JD9165 via MIPI-DSI + GT911, ESP32-P4 (ELS_Display_P7)
 *
 * Выбор дисплея: -DJC4827W543_DISPLAY=1 или -DJC8012P4A1C_DISPLAY=1 в platformio.ini
 */

#include <Arduino.h>
#include <lvgl.h>
#include "display_config.h"
#include "uart_protocol.h"
#include "gcode_wifi.h"
#include "gcode_exec.h"

// ============================================================================
// USB CDC Screenshot — общий код для jc4827w543 и jc8012p4a1c
// ============================================================================
#ifdef DISPLAY_JC1060P470
#include "display_config_p7.h"
#endif
#if defined(DISPLAY_JC4827W543) || defined(DISPLAY_JC8012P4A1C) || defined(DISPLAY_JC1060P470)

// stb JPEG encoder (single-header)
#define STBI_WRITE_NO_STDIO
#define STB_IMAGE_WRITE_IMPLEMENTATION
#include "stb_image_write.h"

// PSRAM framebuffer — RGB565 (заполняется в my_disp_flush)
static uint16_t* screen_fb = nullptr;

// JPEG буфер в PSRAM
static uint8_t*  jpeg_buf  = nullptr;
static uint32_t  jpeg_size = 0;
static uint32_t  jpeg_cap  = 0;

// Семафоры: capture task ↔ loop() task
static SemaphoreHandle_t sem_requested = nullptr;
static SemaphoreHandle_t sem_done      = nullptr;

// stb callback — дописывает данные в jpeg_buf
static void jpeg_write_cb(void* /*ctx*/, void* data, int size) {
    if (!jpeg_buf || jpeg_size + (uint32_t)size > jpeg_cap) return;
    memcpy(jpeg_buf + jpeg_size, data, (size_t)size);
    jpeg_size += (uint32_t)size;
}

// Конвертирует screen_fb RGB565 → JPEG в jpeg_buf
static void do_capture() {
    if (!screen_fb || !jpeg_buf) { jpeg_size = 0; return; }
#ifdef DISPLAY_JC8012P4A1C
    const int W = 800;   // физ. ширина (flush после sw_rotate даёт физ. координаты 800×1280)
    const int H = 1280;  // физ. высота
#elif defined(DISPLAY_JC1060P470)
    const int W = P7_LCD_H_RES, H = P7_LCD_V_RES;   // 1024×600; при P7_ROT180 кадр в fb перевёрнут
#else
    const int W = SCREEN_WIDTH, H = SCREEN_HEIGHT;
#endif
    uint8_t* rgb = (uint8_t*)heap_caps_malloc((size_t)W * H * 3, MALLOC_CAP_SPIRAM);
    if (!rgb) { jpeg_size = 0; Serial.println("JPEG: ps_malloc rgb failed"); return; }
    for (int y = 0; y < H; y++) {
        const uint16_t* src = screen_fb + y * W;
        uint8_t*        dst = rgb + y * W * 3;
        for (int x = 0; x < W; x++) {
#if defined(DISPLAY_JC1060P470) && P7_ROT180
            uint16_t px = screen_fb[(uint32_t)(H - 1 - y) * W + (W - 1 - x)];   // скриншот — как видно на экране
            (void)src;
#else
            uint16_t px = src[x];
#endif
            dst[x*3+0] = (uint8_t)(((px >> 11) & 0x1F) << 3);
            dst[x*3+1] = (uint8_t)(((px >>  5) & 0x3F) << 2);
            dst[x*3+2] = (uint8_t)( (px        & 0x1F) << 3);
        }
    }
    jpeg_size = 0;
    stbi_write_jpg_to_func(jpeg_write_cb, nullptr, W, H, 3, rgb, 80);
    free(rgb);
    Serial.printf("JPEG ready: %u bytes\n", jpeg_size);
}

// FreeRTOS задача с большим стеком (32KB) — ждёт запрос, кодирует JPEG
static void capture_task_fn(void* /*pvParameters*/) {
    while (true) {
        if (sem_requested && xSemaphoreTake(sem_requested, portMAX_DELAY) == pdTRUE) {
            do_capture();
            if (sem_done) xSemaphoreGive(sem_done);
        }
    }
}

#endif // DISPLAY_JC4827W543 || DISPLAY_JC8012P4A1C

// ============================================================================
// jc4827w543 only: WiFi + HTTP screenshot server
// ============================================================================
#ifdef DISPLAY_JC4827W543
#include <WiFi.h>
#include <esp_http_server.h>

static esp_err_t screenshot_handler(httpd_req_t* req) {
    if (!screen_fb || !jpeg_buf || !sem_requested || !sem_done) {
        httpd_resp_send_err(req, HTTPD_500_INTERNAL_SERVER_ERROR, "Not ready");
        return ESP_FAIL;
    }
    xSemaphoreGive(sem_requested);
    if (xSemaphoreTake(sem_done, pdMS_TO_TICKS(5000)) != pdTRUE) {
        httpd_resp_send_err(req, HTTPD_500_INTERNAL_SERVER_ERROR, "Capture timeout");
        return ESP_FAIL;
    }
    if (jpeg_size == 0) {
        httpd_resp_send_err(req, HTTPD_500_INTERNAL_SERVER_ERROR, "Capture failed");
        return ESP_FAIL;
    }
    httpd_resp_set_type(req, "image/jpeg");
    httpd_resp_set_hdr(req, "Cache-Control", "no-cache");
    const size_t CHUNK = 4096;
    esp_err_t ret = ESP_OK;
    size_t sent = 0;
    while (sent < jpeg_size && ret == ESP_OK) {
        size_t chunk = jpeg_size - sent;
        if (chunk > CHUNK) chunk = CHUNK;
        ret = httpd_resp_send_chunk(req, (const char*)jpeg_buf + sent, (ssize_t)chunk);
        if (ret == ESP_OK) sent += chunk;
    }
    if (ret == ESP_OK) httpd_resp_send_chunk(req, nullptr, 0);
    return ret;
}

static void handle_screenshot_server() { }
#endif // DISPLAY_JC4827W543

// Шрифты DejaVu с кириллицей
LV_FONT_DECLARE(font_dejavu_12);
LV_FONT_DECLARE(font_dejavu_14);
LV_FONT_DECLARE(font_dejavu_16);
LV_FONT_DECLARE(font_dejavu_22);
LV_FONT_DECLARE(font_dejavu_36);
LV_FONT_DECLARE(font_dejavu_48);

// Tahoma Bold — основной шрифт UI
LV_FONT_DECLARE(font_tahoma_bold_16);  // кириллица+latin, для row6 SM-индикатора
LV_FONT_DECLARE(font_tahoma_bold_22);  // кириллица+latin, для заголовков и подписей
LV_FONT_DECLARE(font_tahoma_bold_28);  // цифры (digit range only, 0x2B..0x3A)
LV_FONT_DECLARE(font_tahoma_bold_40);  // цифры + latin G,K,t,p,i — для тега типа резьбы и rpm_val
LV_FONT_DECLARE(font_tahoma_bold_48);  // цифры, для rpm_val (=дизайн: secondary 48px)
LV_FONT_DECLARE(font_tahoma_bold_50);  // цифры, tight glow-слой для "1650" (+2px)
LV_FONT_DECLARE(font_tahoma_bold_56);  // цифры (запасной)
LV_FONT_DECLARE(font_tahoma_bold_64);  // цифры (запасной)
LV_FONT_DECLARE(font_tahoma_bold_72);  // цифры, основной шрифт "1.50" (=дизайн: 72px)
LV_FONT_DECLARE(font_tahoma_bold_74);  // цифры, tight glow-слой для "1.50" (+2px)
LV_FONT_DECLARE(font_tahoma_bold_84);  // цифры (запасной)
// Остальные жирные (для демо-экрана)
LV_FONT_DECLARE(font_arial_bold_40);
LV_FONT_DECLARE(font_arial_bold_56);
LV_FONT_DECLARE(font_din_alt_40);
LV_FONT_DECLARE(font_din_alt_56);
LV_FONT_DECLARE(font_din_cond_40);
LV_FONT_DECLARE(font_din_cond_56);

// ============================================================================
// Display-specific includes
// ============================================================================

#ifdef DISPLAY_JC4827W543
    // JC4827W543: ESP32-S3 + NV3041A (QSPI) + GT911 Touch
    #include <Arduino_GFX_Library.h>
    #include <TouchLib.h>

    Arduino_DataBus *bus = new Arduino_ESP32QSPI(
        45 /* CS */, 47 /* SCK */, 21 /* D0 */, 48 /* D1 */, 40 /* D2 */, 39 /* D3 */
    );
    Arduino_GFX *gfx = new Arduino_NV3041A(bus, GFX_NOT_DEFINED, 0, true /* IPS */);
    TouchLib touch(Wire, TOUCH_SDA, TOUCH_SCL, GT911_SLAVE_ADDRESS1, TOUCH_RST);

#elif defined(DISPLAY_JC8012P4A1C)
    // JC8012P4A1C: ESP32-P4 + JD9365 (MIPI-DSI 2-lane) + GSL3680 Touch
    // Физически 800x1280 (портрет), логически 1280x800 через LVGL поворот 90°
    #include "display_config_p4.h"
    #include "jd9365_lcd.h"
    #include "gsl3680_touch.h"

    static jd9365_lcd   p4_lcd(P4_LCD_RST);
    static gsl3680_touch p4_touch(P4_TP_SDA, P4_TP_SCL, P4_TP_RST, P4_TP_INT);
    // Буфер частичной отрисовки LVGL (P4_DRAW_BUF_LINES строк, внутренняя SRAM)
    static lv_color_t* p4_buf0 = nullptr;

#elif defined(DISPLAY_JC1060P470)
    // JC1060P470: ESP32-P4 + JD9165 (MIPI-DSI 2-lane) 1024×600 + GT911 Touch — логика как у 10.1",
    // но панель уже ландшафтная (только переворот на 180°, P7_ROT180)
    #include "display_config_p7.h"
    #include "jd9165_lcd.h"
    #include "gt911_touch.h"

    static jd9165_lcd  p7_lcd(P7_LCD_RST, P7_LCD_BL);
    static gt911_touch p7_touch(P7_TP_SDA, P7_TP_SCL, P7_TP_RST, P7_TP_INT);
    static lv_color_t* p4_buf0 = nullptr;   // буфер частичной отрисовки (имя общее с 10.1")

#else
    // ESP32-2432S024: ESP32 + ILI9341 (SPI) + XPT2046 Touch
    #include <TFT_eSPI.h>
    TFT_eSPI tft = TFT_eSPI();
#endif

// ============================================================================
// Global objects
// ============================================================================

UartProtocol uart_protocol;

static lv_disp_draw_buf_t draw_buf;
static lv_color_t buf1[SCREEN_WIDTH * 32];

// Current design (3 or 8)
uint8_t current_design = 8;  // Dark Theme Pro

// ============================================================================
// LVGL Display Driver
// ============================================================================

void IRAM_ATTR my_disp_flush(lv_disp_drv_t *disp, const lv_area_t *area, lv_color_t *color_p)
{
    uint32_t w = (area->x2 - area->x1 + 1);
    uint32_t h = (area->y2 - area->y1 + 1);

#ifdef DISPLAY_JC4827W543
    gfx->draw16bitRGBBitmap(area->x1, area->y1, (uint16_t *)&color_p->full, w, h);
    if (screen_fb) {
        uint16_t* src = (uint16_t*)&color_p->full;
        for (uint32_t row = 0; row < h; row++) {
            uint16_t* dst = screen_fb + (area->y1 + row) * SCREEN_WIDTH + area->x1;
            memcpy(dst, src + row * w, w * 2);
        }
    }
#elif defined(DISPLAY_JC8012P4A1C)
    // P4: частичная перерисовка. LVGL-область (1280×800) поворачивается прямо во
    // framebuffer панели (800×1280): fb[row=1279-lx][col=ly] = LVGL(lx,ly).
    // Колонки x1..x2 ложатся в непрерывный блок строк fb → один cache writeback,
    // lcd_draw_bitmap с указателем внутрь fb ничего не копирует.
    if (screen_fb) {
        const uint16_t* src = (const uint16_t*)&color_p->full;
        for (int lx = area->x1; lx <= area->x2; lx++) {
            uint16_t* dst = screen_fb + (uint32_t)(P4_LCD_V_RES - 1 - lx) * P4_LCD_H_RES + area->y1;
            const uint16_t* s = src + (lx - area->x1);
            for (uint32_t j = 0; j < h; j++) dst[j] = s[j * w];
        }
        int row0 = P4_LCD_V_RES - 1 - area->x2;
        int row1 = P4_LCD_V_RES - 1 - area->x1;
        p4_lcd.lcd_draw_bitmap(0, row0, P4_LCD_H_RES, row1 + 1,
                               screen_fb + (uint32_t)row0 * P4_LCD_H_RES);
    }
#elif defined(DISPLAY_JC1060P470)
    // 7": область LVGL → framebuffer панели (1024×600), при P7_ROT180 — с переворотом на 180°
    if (screen_fb) {
        const uint16_t* src = (const uint16_t*)&color_p->full;
#if P7_ROT180
        for (uint32_t j = 0; j < h; j++) {
            uint16_t* dst = screen_fb + (uint32_t)(P7_LCD_V_RES - 1 - (area->y1 + j)) * P7_LCD_H_RES
                          + (P7_LCD_H_RES - 1 - area->x1);
            const uint16_t* s = src + j * w;
            for (uint32_t i = 0; i < w; i++) *(dst - i) = s[i];
        }
        int row0 = P7_LCD_V_RES - 1 - area->y2;
        int row1 = P7_LCD_V_RES - 1 - area->y1;
#else
        for (uint32_t j = 0; j < h; j++)
            memcpy(screen_fb + (uint32_t)(area->y1 + j) * P7_LCD_H_RES + area->x1, src + j * w, w * 2);
        int row0 = area->y1, row1 = area->y2;
#endif
        p7_lcd.lcd_draw_bitmap(0, row0, P7_LCD_H_RES, row1 + 1, screen_fb + (uint32_t)row0 * P7_LCD_H_RES);
    }
#else
    tft.startWrite();
    tft.setAddrWindow(area->x1, area->y1, w, h);
    tft.pushColors((uint16_t *)&color_p->full, w * h, true);
    tft.endWrite();
#endif

    lv_disp_flush_ready(disp);
}

// ============================================================================
// LVGL Touch Driver
// ============================================================================

// Имитация касания для автотестов (<TAP:x,y> или <TAP:x,y,мс> по USB): нажатие держится 120 мс
// или заданное время (долгое нажатие — от 400 мс)
static struct { bool active; lv_coord_t x, y; uint32_t until_ms; } g_sim_tap = {};
static int g_touch_raw_x = -1, g_touch_raw_y = -1;   // последнее «сырое» касание драйвера (проверка тача)
static void sim_tap(int x, int y, int ms = 120)
{
    g_sim_tap.x = (lv_coord_t)x;
    g_sim_tap.y = (lv_coord_t)y;
    g_sim_tap.until_ms = millis() + ms;
    g_sim_tap.active = true;
}

void my_touchpad_read(lv_indev_drv_t *indev_driver, lv_indev_data_t *data)
{
    if (g_sim_tap.active) {
        data->point.x = g_sim_tap.x;
        data->point.y = g_sim_tap.y;
        if ((int32_t)(millis() - g_sim_tap.until_ms) < 0) {
            data->state = LV_INDEV_STATE_PR;
        } else {
            data->state = LV_INDEV_STATE_REL;
            g_sim_tap.active = false;
        }
        return;
    }
#ifdef DISPLAY_JC4827W543
    if (touch.read()) {
        TP_Point p = touch.getPoint(0);
        g_touch_raw_x = p.x; g_touch_raw_y = p.y;
        data->point.x = p.x;
        data->point.y = p.y;
        data->state = LV_INDEV_STATE_PR;
    } else {
        data->state = LV_INDEV_STATE_REL;
    }
#elif defined(DISPLAY_JC8012P4A1C)
    // GSL3680 Touch: mirror_x/y в конфиге → tx=799-raw_x, ty=1279-raw_y
    // Flush=rotation270CW: LVGL(lx,ly) → физ.(1279-lx, ly); обратно: lx=raw_y, ly=raw_x
    // С mirror: lx=1279-ty=raw_y, ly=799-tx=raw_x
    uint16_t tx = 0, ty = 0;
    bool pressed = p4_touch.getTouch(&tx, &ty);
    if (pressed) {
        g_touch_raw_x = tx; g_touch_raw_y = ty;
        data->state = LV_INDEV_STATE_PR;
        data->point.x = (lv_coord_t)(P4_LCD_V_RES - 1 - ty);
        data->point.y = (lv_coord_t)(P4_LCD_H_RES - 1 - tx);
    } else {
        data->state = LV_INDEV_STATE_REL;
    }
#elif defined(DISPLAY_JC1060P470)
    uint16_t tx = 0, ty = 0;
    if (p7_touch.getTouch(&tx, &ty)) {
        g_touch_raw_x = tx; g_touch_raw_y = ty;
        data->state = LV_INDEV_STATE_PR;
#if P7_ROT180
        data->point.x = (lv_coord_t)(P7_LCD_H_RES - 1 - tx);
        data->point.y = (lv_coord_t)(P7_LCD_V_RES - 1 - ty);
#else
        data->point.x = (lv_coord_t)tx;
        data->point.y = (lv_coord_t)ty;
#endif
    } else {
        data->state = LV_INDEV_STATE_REL;
    }
#else
    data->state = LV_INDEV_STATE_REL;
#endif
}

// ============================================================================
// FONT DEMO SCREEN — показывает 4 жирных шрифта для выбора
// Строки: 1=Arial Bold, 2=DIN Alternate, 3=DIN Condensed, 4=Tahoma Bold
// ============================================================================

#if !defined(DISPLAY_JC8012P4A1C) && !defined(DISPLAY_JC1060P470)  // демо-шрифты (Arial/DIN/Tahoma 56) для 10.1" не генерируются
lv_obj_t* create_font_demo_screen()
{
    struct FontRow { const char* name; const lv_font_t* font56; const lv_font_t* font40; };
    static const FontRow rows[] = {
        {"1. Arial\nBold",    &font_arial_bold_56, &font_arial_bold_40},
        {"2. DIN Alt\nBold",  &font_din_alt_56,    &font_din_alt_40},
        {"3. DIN Cond\nBold", &font_din_cond_56,   &font_din_cond_40},
        {"4. Tahoma\nBold",   &font_tahoma_bold_56,&font_tahoma_bold_40},
    };

    lv_obj_t* screen = lv_obj_create(NULL);
    lv_obj_set_style_bg_color(screen, lv_color_hex(0x050508), 0);
    lv_obj_clear_flag(screen, LV_OBJ_FLAG_SCROLLABLE);

    // Заголовок
    lv_obj_t* hdr = lv_label_create(screen);
    lv_obj_set_pos(hdr, UX(8), UY(3));
    lv_obj_set_style_text_color(hdr, lv_color_hex(0x00d4ff), 0);
    lv_obj_set_style_text_font(hdr, &font_dejavu_12, 0);
    lv_label_set_text(hdr, "FONT DEMO  [cyan=1.50 @ 56px]  [green=1650 @ 40px]");

    uint32_t bg_clr[] = {0x0d1a2a, 0x080e18, 0x0d1a2a, 0x080e18};
    int row_h = 62;

    for (int i = 0; i < 4; i++) {
        int y = 19 + i * row_h;

        // Фон строки
        lv_obj_t* row_bg = lv_obj_create(screen);
        lv_obj_set_size(row_bg, SCREEN_WIDTH, row_h);
        lv_obj_set_pos(row_bg, 0, y);
        lv_obj_set_style_bg_color(row_bg, lv_color_hex(bg_clr[i]), 0);
        lv_obj_set_style_radius(row_bg, 0, 0);
        lv_obj_set_style_border_side(row_bg, LV_BORDER_SIDE_BOTTOM, 0);
        lv_obj_set_style_border_color(row_bg, lv_color_hex(0x1a3040), 0);
        lv_obj_set_style_border_width(row_bg, US(1), 0);
        lv_obj_set_style_pad_all(row_bg, 0, 0);
        lv_obj_clear_flag(row_bg, LV_OBJ_FLAG_SCROLLABLE);

        // Название шрифта
        lv_obj_t* name_lbl = lv_label_create(row_bg);
        lv_obj_set_pos(name_lbl, UX(5), UY(8));
        lv_obj_set_style_text_color(name_lbl, lv_color_hex(0x5a8a9a), 0);
        lv_obj_set_style_text_font(name_lbl, &font_dejavu_12, 0);
        lv_label_set_text(name_lbl, rows[i].name);

        // "1.50" — большой шрифт 56px
        lv_obj_t* val_56 = lv_label_create(row_bg);
        lv_obj_set_pos(val_56, UX(115), UY(2));
        lv_obj_set_style_text_color(val_56, lv_color_hex(0x00d4ff), 0);
        lv_obj_set_style_text_font(val_56, rows[i].font56, 0);
        lv_label_set_text(val_56, "1.50");

        // "1650" — средний шрифт 40px
        lv_obj_t* val_40 = lv_label_create(row_bg);
        lv_obj_set_pos(val_40, UX(310), UY(10));
        lv_obj_set_style_text_color(val_40, lv_color_hex(0x00ff88), 0);
        lv_obj_set_style_text_font(val_40, rows[i].font40, 0);
        lv_label_set_text(val_40, "1650");
    }

    lv_scr_load(screen);
    return screen;
}
#endif  // !DISPLAY_JC8012P4A1C

// ============================================================================
// Хранит указатели на все динамически обновляемые виджеты UI
// Заполняется в create_dark_pro_ui(), используется в update_ui_values()
// ============================================================================
struct UIHandles {
    // Левая панель — основные значения
    lv_obj_t* primary_val;        // Большое значение cyan ("1.50")
    lv_obj_t* primary_val_glow;   // Glow-слой под primary_val
    lv_obj_t* primary_unit;       // Подпись ("ШАГ ММ") — тап в M3 → THR_CAT
    lv_obj_t* thread_tag;         // Тег типа резьбы рядом с числом ("tpi","G","K")
    lv_obj_t* secondary_val;      // Большое значение green ("1650")
    lv_obj_t* secondary_val_glow; // Glow-слой под secondary_val
    lv_obj_t* secondary_unit;     // Подпись ("RPM")
    lv_obj_t* diam_unit;          // Подпись "ДИАМЕТР" (Ø на LCD2004)
    lv_obj_t* diam_val;           // Диаметр заготовки, мм
    lv_obj_t* diam_box;           // Ячейка ДИАМЕТР (скрыта в делилке/резерве)
    lv_obj_t* rpm_bar;            // Прогресс-бар оборотов

    // Statusbar
    lv_obj_t* mode_lbl;           // "M3 - РЕЗЬБА"
    lv_obj_t* submode_lbl;        // "Наружная" / "Внутренняя" / "Ручная"
    lv_obj_t* sel_lbl;            // «галетник: РЕЗЬБА» — галетник стоит не там, где режим (BACKLOG-038)
    lv_obj_t* thr_cat_lbl;        // Индикатор категории резьбы ("ДЮЙМ"/"G-ТРУБ") вверху

    // Правая панель — 3 строки (title + value)
    lv_obj_t* row1_title;
    lv_obj_t* row1_val;
    lv_obj_t* row2_title;
    lv_obj_t* row2_val;
    lv_obj_t* row3_title;
    lv_obj_t* row3_val;

    // Редактирование параметра (tap на primary value)
    lv_obj_t* edit_arrow_left;    // ▲ слева от большого значения — виден в edit mode
    lv_obj_t* edit_arrow_right;   // ▼ справа от большого значения — виден в edit mode

    // Меню выбора режима (overlay, скрыт по умолчанию)
    lv_obj_t* mode_menu;          // Контейнер-оверлей
    lv_obj_t* mode_btns[8];       // Кнопки M1..M8 (индекс 0=M1..7=M8)

    // Меню быстрого выбора типа резьбы (M3, double-tap, скрыт по умолчанию)
    lv_obj_t* thr_type_menu;

    // Индикаторы лимитов в statusbar — 4 стрелки (← → ↑ ↓)
    lv_obj_t* lim_L;  // Левый (Z-)  ←
    lv_obj_t* lim_R;  // Правый (Z+) →
    lv_obj_t* lim_F;  // Передний (X+) ↑
    lv_obj_t* lim_B;  // Задний (X-)   ↓

    // Статусные иконки-кружки (правый угол statusbar)
    lv_obj_t* s2_bg;    // фон кружка подрежима (S1/S2/S3)
    lv_obj_t* s2_lbl;   // текст внутри ("S1"/"S2"/"S3")
    lv_obj_t* pwr_bg;   // фон кружка мотора Z
    lv_obj_t* warn_bg;  // фон кружка алерта

    // Алерт-оверлей — всплывающее уведомление поверх экрана
    lv_obj_t* alert_box;          // Контейнер алерта (hidden по умолчанию)
    lv_obj_t* alert_msg;          // Текст алерта

    // Phase-2 тестовый режим — полоска вверху экрана (hidden по умолчанию)
    lv_obj_t* test_bar;           // Фоновый прямоугольник (красный)
    lv_obj_t* test_lbl;           // Текст "[N/23] M1/S1 описание"

    // Контейнеры строк правой панели (для подсветки при sub-edit)
    lv_obj_t* row1_box;
    lv_obj_t* row2_box;
    lv_obj_t* row3_box;

    // Строка 4 правой панели (ПРОХОДЫ/ЗАХОДОВ/ЦИКЛОВ — read-only)
    lv_obj_t* row4_title;
    lv_obj_t* row4_val;
    lv_obj_t* row4_box;

    // Ячейка типа резьбы (Layout K: spare1 в M3; Layout I: nullptr)
    lv_obj_t* thr_type_box;
    lv_obj_t* thr_type_title;
    lv_obj_t* thr_type_val;

    // Spare2 (col2 bottom): индикатор текущего SelectMenu (SM)
    lv_obj_t* sm_row6;

    // Джойстик-оверлей (US-013) — управление осями через тачскрин
    lv_obj_t* joystick_overlay;    // Контейнер-оверлей
    lv_obj_t* joy_rapid_btn;       // Кнопка БЫСТРО (подсвечивается когда активна)
    lv_obj_t* joy_rapid_lbl;       // Текст кнопки БЫСТРО

    // Контейнеры для двух вариантов компоновки (K и I)
    lv_obj_t* k_content;           // Панель компоновки K

    // Настройки
    lv_obj_t* settings_menu;       // Меню настроек (оверлей)

    // Блок для жёлтой рамки в режиме редактирования primary value
    // В K — featured cell box; в I — cell[0] box; nullptr → border на самом label (compat)
    lv_obj_t* primary_edit_box;
};

static UIHandles g_ui = {};
static bool s_sphere_alert = false;   // показан алерт "Режим невозможен!" (M6 + внутренний подрежим)

// ============================================================================
// Виджеты компоновки K; apply_layout_widgets() копирует их в поля g_ui.*
// ============================================================================
struct LayoutWidgets {
    lv_obj_t* primary_val;
    lv_obj_t* primary_val_glow;
    lv_obj_t* primary_unit;
    lv_obj_t* thread_tag;
    lv_obj_t* secondary_val;
    lv_obj_t* secondary_val_glow;
    lv_obj_t* secondary_unit;
    lv_obj_t* diam_unit; lv_obj_t* diam_val; lv_obj_t* diam_box;
    lv_obj_t* rpm_bar;
    lv_obj_t* row1_title; lv_obj_t* row1_val; lv_obj_t* row1_box;
    lv_obj_t* row2_title; lv_obj_t* row2_val; lv_obj_t* row2_box;
    lv_obj_t* row3_title; lv_obj_t* row3_val; lv_obj_t* row3_box;
    lv_obj_t* row4_title; lv_obj_t* row4_val; lv_obj_t* row4_box;
    lv_obj_t* thr_type_box; lv_obj_t* thr_type_title; lv_obj_t* thr_type_val;
    lv_obj_t* edit_arrow_left;
    lv_obj_t* edit_arrow_right;
    lv_obj_t* primary_edit_box;  // box to highlight on primary-value edit
};
// Цвета осей в заголовках (recolor LVGL): Y — каретка (по ГОСТ это Z, синий), X — поперечная.
// Красный/зелёный не берём — ими показан знак значения.
#define AXIS_Z      "#4da6ff Z#"   // продольная (вдоль оси шпинделя) — Z, как в G-коде и ISO; на LCD2004 автора и блоке DRO — Y
#define AXIS_X      "#e070ff X#"
#define DIAM_SIGN   "\xE2\x8C\x80"   // ⌀ (U+2300, есть в шрифтах подписей: tools/gen_p4_fonts.sh, gen_43_fonts.sh)
#define TITLE_DIAM  "#e070ff " DIAM_SIGN " \xD0\x94\xD0\x98\xD0\x90\xD0\x9C\xD0\x95\xD0\xA2\xD0\xA0#"   // ⌀ ДИАМЕТР — цветом оси X
static LayoutWidgets g_wk = {};   // K layout widgets

// Копирует виджеты из src в поля g_ui.*
static void apply_layout_widgets(const LayoutWidgets& w) {
    g_ui.primary_val       = w.primary_val;
    g_ui.primary_val_glow  = w.primary_val_glow;
    g_ui.primary_unit      = w.primary_unit;
    g_ui.thread_tag        = w.thread_tag;
    g_ui.secondary_val     = w.secondary_val;
    g_ui.secondary_val_glow= w.secondary_val_glow;
    g_ui.secondary_unit    = w.secondary_unit;
    g_ui.diam_unit         = w.diam_unit;
    g_ui.diam_val          = w.diam_val;
    g_ui.diam_box          = w.diam_box;
    g_ui.rpm_bar           = w.rpm_bar;
    g_ui.row1_title        = w.row1_title;
    g_ui.row1_val          = w.row1_val;
    g_ui.row1_box          = w.row1_box;
    g_ui.row2_title        = w.row2_title;
    g_ui.row2_val          = w.row2_val;
    g_ui.row2_box          = w.row2_box;
    g_ui.row3_title        = w.row3_title;
    g_ui.row3_val          = w.row3_val;
    g_ui.row3_box          = w.row3_box;
    g_ui.row4_title        = w.row4_title;
    g_ui.row4_val          = w.row4_val;
    g_ui.row4_box          = w.row4_box;
    g_ui.thr_type_box      = w.thr_type_box;
    g_ui.thr_type_title    = w.thr_type_title;
    g_ui.thr_type_val      = w.thr_type_val;
    g_ui.edit_arrow_left   = w.edit_arrow_left;
    g_ui.edit_arrow_right  = w.edit_arrow_right;
    g_ui.primary_edit_box  = w.primary_edit_box;
}

// ============================================================================
// Свечение текста: рендерим тот же текст glow_font-ом (на 2px крупнее main font)
// с высокой прозрачностью ЗА основным текстом. glow_font=nullptr → без свечения.
//
// ДИНАМИЧЕСКИЕ ОБНОВЛЕНИЯ: при смене значения нужно обновлять ОБЕ метки:
//   lv_label_set_text(main_lbl, new_val);
//   if (glow_lbl) lv_label_set_text(glow_lbl, new_val);
// Для этого glow_out != nullptr возвращает указатель на glow-слой.
// ============================================================================
static lv_obj_t* make_glow_label(lv_obj_t* parent,
                                  const lv_font_t* font,
                                  const lv_font_t* glow_font,
                                  lv_color_t color,
                                  const char* text,
                                  lv_align_t align,
                                  lv_coord_t x, lv_coord_t y,
                                  lv_coord_t glow_y_adj = 0,
                                  lv_opa_t glow_opa = LV_OPA_80,
                                  lv_obj_t** glow_out = nullptr)
{
    if (glow_font) {
        lv_obj_t* glow = lv_label_create(parent);
        lv_obj_set_style_text_color(glow, color, 0);
        lv_obj_set_style_text_font(glow, glow_font, 0);
        lv_obj_set_style_opa(glow, glow_opa, 0);
        lv_label_set_text(glow, text);
        lv_obj_align(glow, align, x, y - glow_y_adj);
        if (glow_out) *glow_out = glow;
    }
    lv_obj_t* lbl = lv_label_create(parent);
    lv_obj_set_style_text_color(lbl, color, 0);
    lv_obj_set_style_text_font(lbl, font, 0);
    lv_label_set_text(lbl, text);
    lv_obj_align(lbl, align, x, y);
    return lbl;
}

// UTF-8 строки режимов и подрежимов — file scope, видны во всём файле
static const char* const MODE_STRS[] = {
    "",
    "\xD0\xA1\xD0\x98\xD0\x9D\xD0\xA5\xD0\xA0\xD0\x9E\xD0\x9D",          // СИНХРОН
    "\xD0\x90\xD0\xA1\xD0\x98\xD0\x9D\xD0\xA5\xD0\xA0\xD0\x9E\xD0\x9D", // АСИНХРОН
    "\xD0\xA0\xD0\x95\xD0\x97\xD0\xAC\xD0\x91\xD0\x90",                  // РЕЗЬБА
    "\xD0\x9A\xD0\x9E\xD0\x9D\xD0\xA3\xD0\xA1 <",                        // КОНУС <
    "\xD0\x9A\xD0\x9E\xD0\x9D\xD0\xA3\xD0\xA1 >",                        // КОНУС >
    "\xD0\xA8\xD0\x90\xD0\xA0",                                            // ШАР
    "\xD0\x94\xD0\x95\xD0\x9B\xD0\x98\xD0\x9B\xD0\x9A\xD0\x90",          // ДЕЛИЛКА
    "G-\xD0\x9A\xD0\x9E\xD0\x94",                                  // G-КОД (M8; у автора — «Резерв», BACKLOG-001)
};

static const char* const SUBMODE_STRS[] = {
    "",
    "\xD0\x92\xD0\xBD\xD1\x83\xD1\x82\xD1\x80\xD0\xB5\xD0\xBD\xD0\xBD\xD1\x8F\xD1\x8F",  // Внутренняя
    "\xD0\xA0\xD1\x83\xD1\x87\xD0\xBD\xD0\xBE\xD0\xB9",                                    // Ручной
    "\xD0\x9D\xD0\xB0\xD1\x80\xD1\x83\xD0\xB6\xD0\xBD\xD0\xB0\xD1\x8F",                  // Наружная
};

// ============================================================================
// Таблица конусов — индексы должны совпадать с массивом в прошивке Arduino!
// ============================================================================
// Зеркало Cone_Info[].Cone_Print из Arduino (63 записи, \5 заменён на °)
// [0]=45°, [1]=30°, [2..44]=1°..44° (без 30°), [45..51]=KM0..KM6, [52..62]=1:4..3:25
static const char* const CONE_NAMES[] = {
    "45\xC2\xB0",  // [0]  45°
    "30\xC2\xB0",  // [1]  30°
    " 1\xC2\xB0",  // [2]   1°
    " 2\xC2\xB0",  // [3]   2°
    " 3\xC2\xB0",  // [4]   3°
    " 4\xC2\xB0",  // [5]   4°
    " 5\xC2\xB0",  // [6]   5°
    " 6\xC2\xB0",  // [7]   6°
    " 7\xC2\xB0",  // [8]   7°
    " 8\xC2\xB0",  // [9]   8°
    " 9\xC2\xB0",  // [10]  9°
    "10\xC2\xB0",  // [11] 10°
    "11\xC2\xB0",  // [12] 11°
    "12\xC2\xB0",  // [13] 12°
    "13\xC2\xB0",  // [14] 13°
    "14\xC2\xB0",  // [15] 14°
    "15\xC2\xB0",  // [16] 15°
    "16\xC2\xB0",  // [17] 16°
    "17\xC2\xB0",  // [18] 17°
    "18\xC2\xB0",  // [19] 18°
    "19\xC2\xB0",  // [20] 19°
    "20\xC2\xB0",  // [21] 20°
    "21\xC2\xB0",  // [22] 21°
    "22\xC2\xB0",  // [23] 22°
    "23\xC2\xB0",  // [24] 23°
    "24\xC2\xB0",  // [25] 24°
    "25\xC2\xB0",  // [26] 25°
    "26\xC2\xB0",  // [27] 26°
    "27\xC2\xB0",  // [28] 27°
    "28\xC2\xB0",  // [29] 28°
    "29\xC2\xB0",  // [30] 29°
    "31\xC2\xB0",  // [31] 31°
    "32\xC2\xB0",  // [32] 32°
    "33\xC2\xB0",  // [33] 33°
    "34\xC2\xB0",  // [34] 34°
    "35\xC2\xB0",  // [35] 35°
    "36\xC2\xB0",  // [36] 36°
    "37\xC2\xB0",  // [37] 37°
    "38\xC2\xB0",  // [38] 38°
    "39\xC2\xB0",  // [39] 39°
    "40\xC2\xB0",  // [40] 40°
    "41\xC2\xB0",  // [41] 41°
    "42\xC2\xB0",  // [42] 42°
    "43\xC2\xB0",  // [43] 43°
    "44\xC2\xB0",  // [44] 44°
    "KM0",          // [45] Конус Морзе 0
    "KM1",          // [46] Конус Морзе 1
    "KM2",          // [47] Конус Морзе 2
    "KM3",          // [48] Конус Морзе 3
    "KM4",          // [49] Конус Морзе 4
    "KM5",          // [50] Конус Морзе 5
    "KM6",          // [51] Конус Морзе 6
    "1:4",          // [52]
    "1:5",          // [53]
    "1:7",          // [54]
    "1:10",         // [55]
    "1:16",         // [56]
    "1:20",         // [57]
    "1:24",         // [58]
    "1:30",         // [59]
    "1:50",         // [60]
    "7:64",         // [61]
    "3:25",         // [62]
};
static const int CONE_COUNT = (int)(sizeof(CONE_NAMES) / sizeof(CONE_NAMES[0]));

// ============================================================================
// Таблица шагов резьбы — зеркало Thread_Info[] из Arduino-прошивки
// Используется для локальной навигации в edit mode (без ожидания ответа Arduino)
// mm_x100 = Step * 100 (округлённо), label = Thread_Print[7]
// ============================================================================
struct ThreadEntry { int16_t mm_x100; const char* label; };
static const ThreadEntry s_thread_table[] = {
    // Метрическая
    {  20, "0.20mm" }, {  25, "0.25mm" }, {  30, "0.30mm" }, {  35, "0.35mm" },
    {  40, "0.40mm" }, {  45, "0.45mm" }, {  50, "0.50mm" }, {  60, "0.60mm" },
    {  70, "0.70mm" }, {  75, "0.75mm" }, {  80, "0.80mm" }, { 100, "1.00mm" },
    { 125, "1.25mm" }, { 150, "1.50mm" }, { 175, "1.75mm" }, { 200, "2.00mm" },
    { 250, "2.50mm" }, { 300, "3.00mm" }, { 400, "4.00mm" }, { 450, "4.50mm" },
    // Дюймовая
    { 423, " 6tpi " }, { 363, " 7tpi " }, { 318, " 8tpi " }, { 282, " 9tpi " },
    { 254, "10tpi " }, { 231, "11tpi " }, { 212, "12tpi " }, { 195, "13tpi " },
    { 181, "14tpi " }, { 159, "16tpi " }, { 141, "18tpi " }, { 134, "19tpi " },
    { 127, "20tpi " }, { 116, "22tpi " }, { 106, "24tpi " }, {  98, "26tpi " },
    {  94, "27tpi " }, {  91, "28tpi " }, {  79, "32tpi " }, {  64, "40tpi " },
    {  58, "44tpi " }, {  53, "48tpi " }, {  45, "56tpi " }, {  42, "60tpi " },
    {  40, "64tpi " }, {  35, "72tpi " }, {  32, "80tpi " },
    // Трубная G 55°
    {  91, "G 1/16" }, {  91, "G  1/8" }, { 134, "G  1/4" }, { 134, "G  3/8" },
    { 181, "G  1/2" }, { 181, "G  3/4" }, { 231, "G 1   " }, { 231, "G1 1/4" },
    { 231, "G1 1/2" }, { 231, "G 2   " },
    // Трубная K 60°
    {  94, "K 1/16" }, {  94, "K  1/8" }, { 141, "K  1/4" }, { 141, "K  3/8" },
    { 181, "K  1/2" }, { 181, "K  3/4" }, { 221, "K 1   " }, { 221, "K1 1/4" },
    { 221, "K1 1/2" }, { 221, "K 2   " },
};
static const int THREAD_TABLE_SIZE = (int)(sizeof(s_thread_table) / sizeof(s_thread_table[0]));
// Индексы первых записей каждой категории резьбы
static const int THREAD_IDX_METRIC = 0;   // Метрическая: entries 0-19
static const int THREAD_IDX_INCH   = 20;  // Дюймовая: entries 20-46
static const int THREAD_IDX_GPIPE  = 47;  // G-труб: entries 47-56
static const int THREAD_IDX_KPIPE  = 57;  // K-труб: entries 57-66

// Диапазон категории (метрич./дюйм./G/K), в которую входит idx: барабан и ▲/▼ листают только её,
// чтобы после смены типа не попадать на резьбы соседней категории
static void thread_cat_range(int idx, int& lo, int& hi)
{
    if      (idx < THREAD_IDX_INCH)  { lo = THREAD_IDX_METRIC; hi = THREAD_IDX_INCH - 1; }
    else if (idx < THREAD_IDX_GPIPE) { lo = THREAD_IDX_INCH;   hi = THREAD_IDX_GPIPE - 1; }
    else if (idx < THREAD_IDX_KPIPE) { lo = THREAD_IDX_GPIPE;  hi = THREAD_IDX_KPIPE - 1; }
    else                             { lo = THREAD_IDX_KPIPE;  hi = THREAD_TABLE_SIZE - 1; }
}

// ============================================================================
// Состояние режима редактирования основного параметра (тап на большое значение)
// В режиме edit: UP/DOWN → локальная навигация по таблице + <TOUCH:PARAM_UP/DN>
// ============================================================================
struct EditParam {
    bool     active;
    uint32_t last_ms;    // millis() последнего действия → auto-exit через 5с
    int      local_step; // индекс в s_thread_table (для MODE_THREAD)
    int32_t  local_val;  // текущее значение (нативные единицы) для остальных режимов
};
static EditParam g_edit_param = {false, 0, 13, 0};

// ============================================================================
// Состояние редактирования параметра в правой панели (тап на строку)
// Варианты: M1/M2→Ap, M3→Ph, M4/M5→Cone_Step, M7→Total_Tooth/Current_Tooth
// ============================================================================
struct SubEdit {
    bool     active;
    int      row;           // 0=row1, 1=row2, 2=row3, 3=thr_type_box
    uint32_t last_ms;
    // Локальные копии параметров — обновляются при входе + навигации
    int16_t  ap;            // Съём (мм*100, 0..990)
    uint8_t  ph;            // Заходы резьбы (1..8)
    uint8_t  cone_idx;      // Индекс конуса
    uint16_t total_tooth;   // Делилка: делений (1..255)
    uint16_t current_tooth; // Делилка: текущая метка (1..total_tooth)
    int16_t  bar_r;         // ШАР: ножка радиус (мм*100, 0..9900)
    int16_t  sphere_r;      // ШАР: радиус шара (мм*100) — редактируется в thr_type_box
    uint16_t pass_total;    // M1/M2/M4/M5: всего проходов (KEY:LEFT/RIGHT)
    lv_timer_t* exit_timer; // Таймер отложенного выхода из sub_edit (grace period после confirm)
};
static SubEdit g_sub_edit = {false, -1, 0, 0, 1, 0, 1, 1, 0, 1000, 1, nullptr};

// ============================================================================
// Состояние алерта — всплывающее уведомление от Arduino
// ============================================================================
struct AlertState {
    bool     active;
    uint32_t show_ms;  // millis() когда показан → авто-скрытие через 5с
    bool     sticky;   // флаг ошибки ядра: без авто-скрытия, закрывает ALERT:0 от STM32
};
static AlertState g_alert = {false, 0, false};
static bool s_gcode_alert = false;   // ошибка G-кода: закрывает только OK, не ALERT:0 и не таймер

// ============================================================================
// Состояние джойстик-оверлея (US-013)
// ============================================================================
struct JoystickOverlayState {
    bool     active;
    uint32_t last_ms;  // millis() последней активности → авто-скрытие через 30с
    bool     rapid;    // Режим БЫСТРО активен
};
static JoystickOverlayState g_joystick = {false, 0, false};

// ============================================================================
// Универсальный барабан выбора параметра
// 5 меток + swipe + инерция. UART только при OK. Правые кнопки всегда доступны.
// ============================================================================
enum RollerTarget : uint8_t {
    RT_FEED, RT_AFEED, RT_THREAD,        // primary edit (g_edit_param)
    RT_AP, RT_CONE, RT_SPH_R, RT_BAR_R,  // sub-edit (g_sub_edit)
    RT_TOOTH_TOTAL, RT_TOOTH_CUR,         // divider sub-edit
};
struct RollerCfg {
    RollerTarget target;
    int32_t      val_min, val_max, val_step;
    const char*  title;
};
struct RollerState {
    bool        active;
    RollerCfg   cfg;
    lv_obj_t*   backdrop;
    lv_obj_t*   panel;
    lv_obj_t*   labels[5];
    int32_t     pending_val;
    int32_t     entry_val;
    int32_t     touch_accum;
    lv_timer_t* inertia_timer;
    float       velocity;
    float       vel_accum;
};
static RollerState g_roller = {};

// Phase-2: тест-режим (5× быстрый DN вне edit → список сценариев)
static const int TEST_SCENARIO_COUNT = 60;
static bool     g_test_active    = false;
static int      g_test_idx       = 0;
static uint8_t  s_dn_rapid_cnt   = 0;
static uint32_t s_dn_rapid_ms    = 0;

// Forward declarations — нужны lambda-callbacks внутри create_dark_pro_ui
static void create_k_content(lv_obj_t* screen);
static void create_settings_menu(lv_obj_t* screen);
static void handle_up_btn_click();
static void handle_dn_btn_click();
static void handle_ok_btn_click();
static void apply_mode_layout(LatheMode mode);
static void update_ui_values(const LatheData& data);
static void update_thread_type_indicators(const char* label);
static void enter_edit_mode();
static void exit_edit_mode();
static void show_thr_type_menu();
static void jump_to_thread_type(int first_idx);
static void show_alert(const char* message);
static void dismiss_alert();
static void show_joystick_overlay();
static void hide_joystick_overlay();
static void update_limit_indicators(const LimitStatus& lim);
// Большие экраны (10.1", 7"): плитка «УПОРЫ» на свободном месте в M1/M2 — где стоят упоры и длина между ними
#define BIG_SCREEN (SCREEN_WIDTH >= 1024)
static lv_obj_t* s_lim_box = nullptr;
static lv_obj_t* s_lim_val = nullptr;
static void big_limits_update(const LatheData& data);
static void enter_sub_edit(int row);
static void exit_sub_edit();
static void highlight_sub_edit_row(int row, bool on);
static void open_roller(int32_t cur_val, const RollerCfg& cfg);
static void close_roller(bool confirm);
static void roller_update_labels();
static void sub_edit_step(bool up);
static uint8_t get_editable_rows(LatheMode mode);
static void apply_afeed_sm2_layout();
static void apply_feed_sm2_layout();
static void apply_feed_sm3_layout();
static void apply_thread_sm2_layout();
static void apply_cone_sm2_layout();
static void test_start();
static void test_stop();
static void test_apply(int idx);
static LatheMode s_last_mode = (LatheMode)0;
static uint8_t   s_last_select_menu = 0;  // tracks last SelectMenu for M2 layout changes

// ============================================================================
// Обработчики кнопок UP / OK / DN — общие для обоих вариантов компоновки
// ============================================================================

static void handle_up_btn_click()
{
    if (g_test_active) {
        g_test_idx = (g_test_idx + 1) % TEST_SCENARIO_COUNT;
        test_apply(g_test_idx);
        return;
    }
    // Idle: 5× подряд → тест-режим
    if (!g_sub_edit.active && !g_edit_param.active) {
        uint32_t now = millis();
        if (now - s_dn_rapid_ms > 2000) s_dn_rapid_cnt = 0;
        s_dn_rapid_ms = now;
        if (++s_dn_rapid_cnt >= 5) { s_dn_rapid_cnt = 0; test_start(); return; }
    }
    // Roller активен — UP двигает барабан (все режимы и sub-edit)
    if (g_roller.active) {
        if (g_roller.inertia_timer) { lv_timer_del(g_roller.inertia_timer); g_roller.inertia_timer = nullptr; }
        g_roller.velocity    = 0.0f;
        g_roller.pending_val = constrain(g_roller.pending_val + g_roller.cfg.val_step,
                                          g_roller.cfg.val_min, g_roller.cfg.val_max);
        roller_update_labels();
        return;
    }
    if (g_sub_edit.active) {
        sub_edit_step(true);
    } else if (g_edit_param.active) {
        g_edit_param.last_ms = millis();
        char buf[32];
        if (s_last_mode == MODE_THREAD) {
            { int lo, hi; thread_cat_range(g_edit_param.local_step, lo, hi);
              if (g_edit_param.local_step < hi) g_edit_param.local_step++; }
            const char* lbl = s_thread_table[g_edit_param.local_step].label;
            char fbuf[32]; char* fdst = fbuf;
            for (const char* fsrc = lbl; *fsrc && fdst < fbuf + sizeof(fbuf) - 1; fsrc++) {
                uint8_t fc = (uint8_t)*fsrc;
                if (fc == 0x2B || (fc >= 0x2D && fc <= 0x3A)) *fdst++ = *fsrc;
            }
            *fdst = '\0';
            if (fbuf[0] == '\0') snprintf(fbuf, sizeof(fbuf), "--");
            lv_label_set_text(g_ui.primary_val, fbuf);
            if (g_ui.primary_val_glow) lv_label_set_text(g_ui.primary_val_glow, fbuf);
            if (strstr(lbl, "tpi"))
                lv_label_set_text(g_ui.primary_unit, "\xD0\x94\xD0\xAE\xD0\x99\xD0\x9C");
            else if (lbl[0] == 'G')
                lv_label_set_text(g_ui.primary_unit, "G-\xD0\xA2\xD0\xA0\xD0\xA3\xD0\x91");
            else if (lbl[0] == 'K')
                lv_label_set_text(g_ui.primary_unit, "K-\xD0\xA2\xD0\xA0\xD0\xA3\xD0\x91");
            else
                lv_label_set_text(g_ui.primary_unit, "\xD0\xA8\xD0\x90\xD0\x93 \xD0\x9C\xD0\x9C");
            update_thread_type_indicators(lbl);
        } else if (s_last_mode == MODE_AFEED) {
            g_edit_param.local_val = constrain(g_edit_param.local_val + 5, 1, 9999);
            snprintf(buf, sizeof(buf), "%ld", g_edit_param.local_val);
            lv_label_set_text(g_ui.primary_val, buf);
            if (g_ui.primary_val_glow) lv_label_set_text(g_ui.primary_val_glow, buf);
        } else if (s_last_mode == MODE_FEED ||
                   s_last_mode == MODE_CONE_L || s_last_mode == MODE_CONE_R ||
                   s_last_mode == MODE_SPHERE) {
            g_edit_param.local_val = constrain(g_edit_param.local_val + 5, 5, 9999);
            snprintf(buf, sizeof(buf), "%ld.%02ld",
                     g_edit_param.local_val / 100, g_edit_param.local_val % 100);
            lv_label_set_text(g_ui.primary_val, buf);
            if (g_ui.primary_val_glow) lv_label_set_text(g_ui.primary_val_glow, buf);
        }
        if (s_last_mode == MODE_THREAD) {
            char ts[24]; snprintf(ts, sizeof(ts), "THREAD_STEP:%d", (int)g_edit_param.local_step);
            uart_protocol.sendButtonPress(ts);
        } else if (s_last_mode == MODE_FEED || s_last_mode == MODE_SPHERE ||
                   s_last_mode == MODE_CONE_L || s_last_mode == MODE_CONE_R) {
            char fs[24]; snprintf(fs, sizeof(fs), "FEED:%d", (int)g_edit_param.local_val);
            uart_protocol.sendButtonPress(fs);
        } else if (s_last_mode == MODE_AFEED) {
            char fs[24]; snprintf(fs, sizeof(fs), "AFEED:%d", (int)g_edit_param.local_val);
            uart_protocol.sendButtonPress(fs);
        } else {
            uart_protocol.sendButtonPress("KEY:UP");
        }
    }
}

static void handle_dn_btn_click()
{
    if (g_test_active) {
        g_test_idx = (g_test_idx - 1 + TEST_SCENARIO_COUNT) % TEST_SCENARIO_COUNT;
        test_apply(g_test_idx);
        return;
    }
    // Roller активен — DN двигает барабан
    if (g_roller.active) {
        if (g_roller.inertia_timer) { lv_timer_del(g_roller.inertia_timer); g_roller.inertia_timer = nullptr; }
        g_roller.velocity    = 0.0f;
        g_roller.pending_val = constrain(g_roller.pending_val - g_roller.cfg.val_step,
                                          g_roller.cfg.val_min, g_roller.cfg.val_max);
        roller_update_labels();
        return;
    }
    if (g_sub_edit.active) {
        sub_edit_step(false);
    } else if (g_edit_param.active) {
        g_edit_param.last_ms = millis();
        char buf[32];
        if (s_last_mode == MODE_THREAD) {
            { int lo, hi; thread_cat_range(g_edit_param.local_step, lo, hi);
              if (g_edit_param.local_step > lo) g_edit_param.local_step--; }
            const char* lbl = s_thread_table[g_edit_param.local_step].label;
            char fbuf[32]; char* fdst = fbuf;
            for (const char* fsrc = lbl; *fsrc && fdst < fbuf + sizeof(fbuf) - 1; fsrc++) {
                uint8_t fc = (uint8_t)*fsrc;
                if (fc == 0x2B || (fc >= 0x2D && fc <= 0x3A)) *fdst++ = *fsrc;
            }
            *fdst = '\0';
            if (fbuf[0] == '\0') snprintf(fbuf, sizeof(fbuf), "--");
            lv_label_set_text(g_ui.primary_val, fbuf);
            if (g_ui.primary_val_glow) lv_label_set_text(g_ui.primary_val_glow, fbuf);
            if (strstr(lbl, "tpi"))
                lv_label_set_text(g_ui.primary_unit, "\xD0\x94\xD0\xAE\xD0\x99\xD0\x9C");
            else if (lbl[0] == 'G')
                lv_label_set_text(g_ui.primary_unit, "G-\xD0\xA2\xD0\xA0\xD0\xA3\xD0\x91");
            else if (lbl[0] == 'K')
                lv_label_set_text(g_ui.primary_unit, "K-\xD0\xA2\xD0\xA0\xD0\xA3\xD0\x91");
            else
                lv_label_set_text(g_ui.primary_unit, "\xD0\xA8\xD0\x90\xD0\x93 \xD0\x9C\xD0\x9C");
            update_thread_type_indicators(lbl);
        } else if (s_last_mode == MODE_AFEED) {
            g_edit_param.local_val = constrain(g_edit_param.local_val - 5, 1, 9999);
            snprintf(buf, sizeof(buf), "%ld", g_edit_param.local_val);
            lv_label_set_text(g_ui.primary_val, buf);
            if (g_ui.primary_val_glow) lv_label_set_text(g_ui.primary_val_glow, buf);
        } else if (s_last_mode == MODE_FEED ||
                   s_last_mode == MODE_CONE_L || s_last_mode == MODE_CONE_R ||
                   s_last_mode == MODE_SPHERE) {
            g_edit_param.local_val = constrain(g_edit_param.local_val - 5, 5, 9999);
            snprintf(buf, sizeof(buf), "%ld.%02ld",
                     g_edit_param.local_val / 100, g_edit_param.local_val % 100);
            lv_label_set_text(g_ui.primary_val, buf);
            if (g_ui.primary_val_glow) lv_label_set_text(g_ui.primary_val_glow, buf);
        }
        if (s_last_mode == MODE_THREAD) {
            char ts[24]; snprintf(ts, sizeof(ts), "THREAD_STEP:%d", (int)g_edit_param.local_step);
            uart_protocol.sendButtonPress(ts);
        } else if (s_last_mode == MODE_FEED || s_last_mode == MODE_SPHERE ||
                   s_last_mode == MODE_CONE_L || s_last_mode == MODE_CONE_R) {
            char fs[24]; snprintf(fs, sizeof(fs), "FEED:%d", (int)g_edit_param.local_val);
            uart_protocol.sendButtonPress(fs);
        } else if (s_last_mode == MODE_AFEED) {
            char fs[24]; snprintf(fs, sizeof(fs), "AFEED:%d", (int)g_edit_param.local_val);
            uart_protocol.sendButtonPress(fs);
        } else {
            uart_protocol.sendButtonPress("KEY:DN");
        }
    }
}

static void handle_ok_btn_click()
{
    if (g_test_active) { test_stop(); return; }

    if (g_roller.active) {
        RollerTarget tgt = g_roller.cfg.target;
        close_roller(true);  // sub_edit grace period / cleanup handled inside close_roller
        bool is_primary = (tgt == RT_FEED || tgt == RT_AFEED || tgt == RT_THREAD);
        if (is_primary) exit_edit_mode();
        return;
    }
    if (g_sub_edit.active) {
        exit_sub_edit();
    } else if (g_edit_param.active) {
        exit_edit_mode();
    } else if (s_last_mode == MODE_DIVIDER) {
        uart_protocol.sendButtonPress("PARAM_OK");
    }
}

// ============================================================================
// Тап по основному значению (K и I): вход/выход из редактирования.
// В M3 двойной тап открывает меню типа резьбы. Редактирование (барабан) открывается
// с задержкой окна двойного тапа — иначе барабан перекрывает экран и второй тап
// попадает в него, а не в основное значение.
// ============================================================================
static lv_timer_t* s_primary_tap_timer = nullptr;

static void primary_value_tap()
{
    if (s_last_mode == MODE_THREAD && !g_edit_param.active) {
        if (s_primary_tap_timer) {          // второй тап в окне 400 мс
            lv_timer_del(s_primary_tap_timer);
            s_primary_tap_timer = nullptr;
            show_thr_type_menu();
            return;
        }
        s_primary_tap_timer = lv_timer_create([](lv_timer_t* t) {
            s_primary_tap_timer = nullptr;
            lv_timer_del(t);
            enter_edit_mode();
        }, 400, nullptr);
        return;
    }
    if (g_edit_param.active) exit_edit_mode(); else enter_edit_mode();
}

// ============================================================================
// Вспомогательная функция создания ячейки параметра (общий стиль для K и I)
// ============================================================================
struct CellRefs { lv_obj_t* box; lv_obj_t* title; lv_obj_t* val; };

static CellRefs make_param_cell(lv_obj_t* parent, int x, int y, int w, int h,
                                 const char* title_text, bool editable = false,
                                 bool use_recolor = false)
{
    lv_obj_t* box = lv_obj_create(parent);
    lv_obj_set_size(box, w, h);
    lv_obj_set_pos(box, x, y);
    lv_obj_set_style_bg_color(box, lv_color_hex(editable ? 0x120a00 : 0x0a1828), 0);
    lv_obj_set_style_bg_opa(box, LV_OPA_COVER, 0);
    lv_obj_set_style_border_side(box, LV_BORDER_SIDE_LEFT, 0);
    lv_obj_set_style_border_color(box, lv_color_hex(editable ? 0xffaa44 : 0x00d4ff), 0);
    lv_obj_set_style_border_width(box, US(3), 0);
    lv_obj_set_style_radius(box, US(4), 0);
    lv_obj_set_style_pad_all(box, US(4), 0);
    lv_obj_clear_flag(box, LV_OBJ_FLAG_SCROLLABLE);

    // title: small label at top
    lv_obj_t* title = lv_label_create(box);
    lv_obj_set_pos(title, 0, 0);
    lv_obj_set_style_text_font(title, &font_dejavu_14, 0);
    lv_obj_set_style_text_color(title, lv_color_hex(editable ? 0xffaa44 : 0x6a9fb5), 0);
    lv_label_set_recolor(title, true);   // цвет букв осей (AXIS_X / AXIS_Z)
    lv_label_set_text(title, title_text);

    // val: vertically centered in remaining space below title
    // title_h≈16, val_h≈30, content=(h-8), remaining=(h-8-16-30)/2 (метрики шрифтов → US)
    int val_y = US(16) + ((h - US(8) - US(16) - US(30)) >> 1);
    if (val_y < US(16)) val_y = US(16);
    lv_obj_t* val = lv_label_create(box);
    lv_obj_set_pos(val, 0, val_y);
    lv_obj_set_style_text_font(val, &font_tahoma_bold_28, 0);
    lv_obj_set_style_text_color(val, lv_color_hex(0xe0e0e0), 0);
    lv_label_set_text(val, "--");
    if (use_recolor) lv_label_set_recolor(val, true);

    return {box, title, val};
}

// ============================================================================
// Ввод и сброс осей с экрана (BACKLOG-027): двойной тап по ПОЗИЦИИ Y / X — ноль,
// долгое нажатие на Y / X / ⌀ — клавиатура. С блоком DRO STM32 шлёт AXIS_EDIT:0 —
// оси задаются на самом блоке, экран их только показывает.
// ============================================================================
// row1/row2 показывают оси (ПОЗИЦИЯ или ОСЬ Y/X) — по раскладкам apply_*_layout
static bool rows_show_axes()
{
    switch (uart_protocol.getData().select_menu) {
        case 1:  return s_last_mode != MODE_DIVIDER;                 // M8 (G-код) — тоже: ноль перед программой
        case 2:  return s_last_mode == MODE_FEED;
        case 3:  return s_last_mode != MODE_FEED && s_last_mode != MODE_RESERVE;
    }
    return false;
}

static bool axis_edit_allowed()
{
    if (uart_protocol.getData().axis_edit) return true;
    show_alert("\xD0\x9E\xD0\xA1\xD0\x98 \xD0\x97\xD0\x90\xD0\x94\xD0\x90\xD0\xAE\xD0\xA2\xD0\xA1\xD0\xAF "
               "\xD0\x9D\xD0\x90 \xD0\x91\xD0\x9B\xD0\x9E\xD0\x9A\xD0\x95 DRO");   // ОСИ ЗАДАЮТСЯ НА БЛОКЕ DRO
    return false;
}

static void axis_send(char axis, int32_t um)
{
    char cmd[32];
    snprintf(cmd, sizeof(cmd), "AXIS:%c:%ld", axis, (long)um);
    uart_protocol.sendButtonPress(cmd);
}

// Цифровая клавиатура (оси, настройки): значение — целое в единицах 10^-dec
// (мкм при dec = 3, 0.01 мм при dec = 2). Текущее значение видно сразу; первая цифра его заменяет.
typedef void (*NumpadDone)(int32_t v, intptr_t tag);
struct Numpad {
    lv_obj_t* back;       // затемнение на весь экран (nullptr — закрыта)
    lv_obj_t* val;        // набираемое значение
    const char* unit;
    uint8_t dec;          // знаков после точки
    uint8_t int_digits;   // цифр до точки
    bool sign;            // можно минус
    bool fresh;           // показано исходное значение — первая цифра его заменяет
    NumpadDone done;
    intptr_t tag;
    char buf[12];         // "-1234.567"
};
static Numpad g_numpad = {};

static void numpad_close()
{
    if (g_numpad.back) { lv_obj_del(g_numpad.back); g_numpad.back = nullptr; }
}

static void numpad_refresh()
{
    char t[24];
    snprintf(t, sizeof(t), "%s %s", g_numpad.buf[0] ? g_numpad.buf : "0", g_numpad.unit);
    lv_label_set_text(g_numpad.val, t);
    lv_obj_set_style_text_color(g_numpad.val, lv_color_hex(g_numpad.fresh ? 0x6a9fb5 : 0x00ff88), 0);
}

// "-12.3456" → целое в единицах 10^-dec (набор ограничивает число цифр)
static int32_t numpad_value()
{
    const char* p = g_numpad.buf;
    bool neg = (*p == '-'); if (neg) p++;
    int32_t ip = 0, frac = 0; int nf = 0;
    for (; *p && *p != '.'; p++) ip = ip * 10 + (*p - '0');
    if (*p == '.') for (p++; *p && nf < g_numpad.dec; p++, nf++) frac = frac * 10 + (*p - '0');
    for (; nf < g_numpad.dec; nf++) frac *= 10;
    int32_t scale = 1;
    for (int i = 0; i < g_numpad.dec; i++) scale *= 10;
    int32_t v = ip * scale + frac;
    return neg ? -v : v;
}

static void numpad_key(const char* k)
{
    char* b = g_numpad.buf;
    bool edit = !strcmp(k, "<") || !strcmp(k, ".") || (k[0] >= '0' && k[0] <= '9' && !k[1]);
    if (edit && g_numpad.fresh) b[0] = 0;          // первая цифра заменяет исходное значение
    if (edit || !strcmp(k, "+/-")) g_numpad.fresh = false;
    size_t n = strlen(b);
    const char* dot = strchr(b, '.');
    if (!strcmp(k, "<")) { if (n) b[n - 1] = 0; }
    else if (!strcmp(k, "+/-")) {
        if (!g_numpad.sign) return;
        if (b[0] == '-') memmove(b, b + 1, n);
        else if (n + 1 < sizeof(g_numpad.buf)) { memmove(b + 1, b, n + 1); b[0] = '-'; }
    }
    else if (!strcmp(k, ".")) { if (g_numpad.dec && !dot && n + 1 < sizeof(g_numpad.buf)) strcat(b, "."); }
    else if (k[0] >= '0' && k[0] <= '9' && !k[1]) {
        size_t digits = dot ? strlen(dot + 1) : n - (b[0] == '-');
        if (digits < (dot ? g_numpad.dec : g_numpad.int_digits) && n + 1 < sizeof(g_numpad.buf)) { b[n] = k[0]; b[n + 1] = 0; }
    }
    else if (k[0] == '\xD0' && k[1] == '\x92') {   // ВВОД
        bool has_digit = strpbrk(b, "0123456789") != nullptr;
        NumpadDone done = g_numpad.done; intptr_t tag = g_numpad.tag;
        int32_t v = numpad_value();
        numpad_close();
        if (has_digit && done) done(v, tag);
        return;
    }
    else { numpad_close(); return; }               // ОТМЕНА
    numpad_refresh();
}

// init — исходное значение текстом (nullptr — пусто, «0»)
static void numpad_show(const char* title, const char* unit, uint8_t dec, uint8_t int_digits, bool sign,
                        const char* init, NumpadDone done, intptr_t tag)
{
    numpad_close();
    g_numpad.unit = unit; g_numpad.dec = dec; g_numpad.int_digits = int_digits; g_numpad.sign = sign;
    g_numpad.done = done; g_numpad.tag = tag;
    g_numpad.fresh = init != nullptr;
    snprintf(g_numpad.buf, sizeof(g_numpad.buf), "%s", init ? init : "");

    lv_obj_t* back = lv_obj_create(lv_layer_top());
    g_numpad.back = back;
    lv_obj_set_size(back, SCREEN_WIDTH, SCREEN_HEIGHT);
    lv_obj_set_pos(back, 0, 0);
    lv_obj_set_style_bg_color(back, lv_color_hex(0x000000), 0);
    lv_obj_set_style_bg_opa(back, LV_OPA_70, 0);
    lv_obj_set_style_border_width(back, 0, 0);
    lv_obj_set_style_radius(back, 0, 0);
    lv_obj_clear_flag(back, LV_OBJ_FLAG_SCROLLABLE);

    lv_obj_t* panel = lv_obj_create(back);
    lv_obj_set_size(panel, UX(320), UY(256));
    lv_obj_center(panel);
    lv_obj_set_style_bg_color(panel, lv_color_hex(0x0a1622), 0);
    lv_obj_set_style_border_color(panel, lv_color_hex(0x00d4ff), 0);
    lv_obj_set_style_border_width(panel, US(2), 0);
    lv_obj_set_style_radius(panel, US(8), 0);
    lv_obj_set_style_pad_all(panel, US(6), 0);
    lv_obj_clear_flag(panel, LV_OBJ_FLAG_SCROLLABLE);

    lv_obj_t* t = lv_label_create(panel);
    lv_obj_set_style_text_font(t, &font_tahoma_bold_22, 0);
    lv_obj_set_style_text_color(t, lv_color_hex(0x6a9fb5), 0);
    lv_label_set_recolor(t, true);
    lv_label_set_text(t, title);
    lv_obj_align(t, LV_ALIGN_TOP_LEFT, 0, 0);

    g_numpad.val = lv_label_create(panel);
    lv_obj_set_style_text_font(g_numpad.val, &font_tahoma_bold_28, 0);
    lv_obj_align(g_numpad.val, LV_ALIGN_TOP_RIGHT, 0, UY(26));
    numpad_refresh();

    static const char* map[] = {
        "7", "8", "9", "<", "\n",
        "4", "5", "6", "+/-", "\n",
        "1", "2", "3", "0", "\n",
        ".", "\xD0\x9E\xD0\xA2\xD0\x9C\xD0\x95\xD0\x9D\xD0\x90", "\xD0\x92\xD0\x92\xD0\x9E\xD0\x94", ""   // ОТМЕНА, ВВОД
    };
    lv_obj_t* m = lv_btnmatrix_create(panel);
    lv_btnmatrix_set_map(m, map);
    lv_btnmatrix_set_btn_width(m, 13, 2);              // ОТМЕНА
    lv_btnmatrix_set_btn_width(m, 14, 2);              // ВВОД
    if (!sign) lv_btnmatrix_set_btn_ctrl(m, 7, LV_BTNMATRIX_CTRL_DISABLED);    // +/-
    if (!dec)  lv_btnmatrix_set_btn_ctrl(m, 12, LV_BTNMATRIX_CTRL_DISABLED);   // .
    lv_obj_set_size(m, UX(306), UY(184));
    lv_obj_align(m, LV_ALIGN_BOTTOM_MID, 0, 0);
    lv_obj_set_style_text_font(m, &font_tahoma_bold_22, 0);
    lv_obj_set_style_bg_opa(m, LV_OPA_TRANSP, 0);
    lv_obj_set_style_border_width(m, 0, 0);
    lv_obj_set_style_pad_all(m, US(2), 0);
    lv_obj_set_style_pad_gap(m, US(4), 0);
    lv_obj_set_style_bg_color(m, lv_color_hex(0x1a2a3a), LV_PART_ITEMS);
    lv_obj_set_style_text_color(m, lv_color_hex(0xe0e0e0), LV_PART_ITEMS);
    lv_obj_set_style_text_color(m, lv_color_hex(0x3a4a5a), (lv_style_selector_t)LV_PART_ITEMS | LV_STATE_DISABLED);
    lv_obj_add_event_cb(m, [](lv_event_t* e) {
        lv_obj_t* o = lv_event_get_target(e);
        const char* k = lv_btnmatrix_get_btn_text(o, lv_btnmatrix_get_selected_btn(o));
        if (k) numpad_key(k);
    }, LV_EVENT_VALUE_CHANGED, nullptr);
}

static void axis_kb_show(char axis)
{
    numpad_show(axis == 'D' ? TITLE_DIAM
              : axis == 'Z' ? "\xD0\x9F\xD0\x9E\xD0\x97\xD0\x98\xD0\xA6\xD0\x98\xD0\xAF " AXIS_Z
                            : "\xD0\x9F\xD0\x9E\xD0\x97\xD0\x98\xD0\xA6\xD0\x98\xD0\xAF " AXIS_X,
                "\xD0\xBC\xD0\xBC", 3, 4, true, nullptr,                     // мм
                [](int32_t um, intptr_t a) { axis_send((char)a, um); }, axis);
}

// ============================================================================
// Создание панели ВАРИАНТ K: Featured cell + 3×2 grid + вертикальные кнопки
// ============================================================================
static void create_k_content(lv_obj_t* screen)
{
    lv_obj_t* panel = lv_obj_create(screen);
    lv_obj_set_size(panel, SCREEN_WIDTH, SCREEN_HEIGHT - UY(36));
    lv_obj_set_pos(panel, 0, UY(36));
    lv_obj_set_style_bg_color(panel, lv_color_hex(0x0a0a0a), 0);
    lv_obj_set_style_radius(panel, 0, 0);
    lv_obj_set_style_pad_all(panel, 0, 0);
    lv_obj_set_style_border_width(panel, 0, 0);
    lv_obj_clear_flag(panel, LV_OBJ_FLAG_SCROLLABLE);
    g_ui.k_content = panel;

    const int PAD = UX(6), GAP = UX(4);
    const int RIGHT_W = UX(56);
    const int LEFT_W   = SCREEN_WIDTH - 2*PAD - RIGHT_W - GAP;
    const int INNER_H  = (SCREEN_HEIGHT - UY(36)) - 2*PAD;
    const int FEAT_H   = UY(72);
    const int GRID_Y   = PAD + FEAT_H + GAP;
    const int GRID_H   = INNER_H - FEAT_H - GAP;
    const int ROW_H    = (GRID_H - GAP) / 2;
    const int COL_W0   = (LEFT_W - 2*GAP) / 3;
    const int COL_W2   = LEFT_W - 2*COL_W0 - 2*GAP;
    const int RIGHT_X  = PAD + LEFT_W + GAP;
    int col_x[3] = { PAD, PAD + COL_W0 + GAP, PAD + 2*COL_W0 + 2*GAP };

    // ── Featured cell ────────────────────────────────────────────────────────
    lv_obj_t* feat = lv_obj_create(panel);
    lv_obj_set_size(feat, LEFT_W, FEAT_H);
    lv_obj_set_pos(feat, PAD, PAD);
    lv_obj_set_style_bg_color(feat, lv_color_hex(0x0a1828), 0);
    lv_obj_set_style_bg_opa(feat, LV_OPA_COVER, 0);
    lv_obj_set_style_border_side(feat, LV_BORDER_SIDE_LEFT, 0);
    lv_obj_set_style_border_color(feat, lv_color_hex(0x00d4ff), 0);
    lv_obj_set_style_border_width(feat, US(4), 0);
    lv_obj_set_style_radius(feat, US(4), 0);
    lv_obj_set_style_pad_all(feat, 0, 0);
    lv_obj_clear_flag(feat, LV_OBJ_FLAG_SCROLLABLE);
    g_wk.primary_edit_box = feat;

    // Primary title/unit (tappable in M3 for THR_CAT)
    lv_obj_t* p_unit = lv_label_create(feat);
    lv_obj_set_pos(p_unit, UX(8), UY(5));
    lv_obj_set_style_text_font(p_unit, &font_dejavu_14, 0);
    lv_obj_set_style_text_color(p_unit, lv_color_hex(0x6a9fb5), 0);
    lv_label_set_text(p_unit, "\xD0\xA8\xD0\x90\xD0\x93 \xD0\x9C\xD0\x9C");  // ШАГ ММ
    lv_obj_add_flag(p_unit, LV_OBJ_FLAG_CLICKABLE);
    lv_obj_add_event_cb(p_unit, [](lv_event_t*) {
        static uint32_t s_utap = 0; uint32_t now = millis();
        if ((now - s_utap) < 400 && s_last_mode == MODE_THREAD) {
            if (g_edit_param.active) exit_edit_mode();
            uart_protocol.sendButtonPress("THR_CAT");
        }
        s_utap = now;
    }, LV_EVENT_CLICKED, nullptr);
    g_wk.primary_unit = p_unit;

    // Primary value (big, cyan, digit font) — vertically centered below title
    lv_obj_t* p_val = lv_label_create(feat);
    lv_obj_set_pos(p_val, UX(8), UY(28));
    lv_obj_set_style_text_font(p_val, &font_tahoma_bold_40, 0);
    lv_obj_set_style_text_color(p_val, lv_color_hex(0x00d4ff), 0);
    lv_label_set_text(p_val, "1.50");
    g_wk.primary_val      = p_val;
    g_wk.primary_val_glow = nullptr;

    // Thread tag (tpi/G/K — orange, right side, hidden by default)
    lv_obj_t* tag = lv_label_create(feat);
    lv_obj_set_style_text_color(tag, lv_color_hex(0xff8800), 0);
    lv_obj_set_style_text_font(tag, &font_tahoma_bold_28, 0);
    lv_label_set_text(tag, "");
    lv_obj_set_pos(tag, UX(200), UY(18));
    lv_obj_add_flag(tag, LV_OBJ_FLAG_HIDDEN);
    g_wk.thread_tag = tag;

    // Secondary unit label (right side) — same size as param cell titles
    lv_obj_t* s_unit = lv_label_create(feat);
    lv_obj_set_style_text_font(s_unit, &font_dejavu_14, 0);
    lv_obj_set_style_text_color(s_unit, lv_color_hex(0x3a7a5a), 0);
    lv_label_set_text(s_unit, "RPM");
    lv_obj_align(s_unit, LV_ALIGN_TOP_RIGHT, -UX(8), UY(5));
    g_wk.secondary_unit = s_unit;

    // Secondary value (right side) — same font as param cell values, with gap below unit
    lv_obj_t* s_val = lv_label_create(feat);
    lv_obj_set_style_text_font(s_val, &font_tahoma_bold_28, 0);
    lv_obj_set_style_text_color(s_val, lv_color_hex(0x00ff88), 0);
    lv_label_set_text(s_val, "1650");
    lv_label_set_recolor(s_val, true);
    lv_obj_align(s_val, LV_ALIGN_TOP_RIGHT, -UX(8), UY(24));
    g_wk.secondary_val      = s_val;
    g_wk.secondary_val_glow = nullptr;


    // RPM bar — invisible stub (removed per user request; kept for API compat)
    lv_obj_t* rbar = lv_bar_create(feat);
    lv_obj_set_size(rbar, UX(1), UY(1));
    lv_obj_set_style_opa(rbar, LV_OPA_TRANSP, 0);
    lv_bar_set_range(rbar, 0, 3000);
    lv_bar_set_value(rbar, 0, LV_ANIM_OFF);
    g_wk.rpm_bar = rbar;

    // Edit arrows (hidden)
    lv_obj_t* arL = lv_label_create(feat);
    lv_obj_set_style_text_color(arL, lv_color_hex(0xffcc00), 0);
    lv_obj_set_style_text_font(arL, &lv_font_montserrat_20, 0);
    lv_label_set_text(arL, LV_SYMBOL_UP);
    lv_obj_set_pos(arL, UX(8), UY(20));
    lv_obj_add_flag(arL, LV_OBJ_FLAG_HIDDEN);
    g_wk.edit_arrow_left = arL;

    lv_obj_t* arR = lv_label_create(feat);
    lv_obj_set_style_text_color(arR, lv_color_hex(0xffcc00), 0);
    lv_obj_set_style_text_font(arR, &lv_font_montserrat_20, 0);
    lv_label_set_text(arR, LV_SYMBOL_DOWN);
    lv_obj_align(arR, LV_ALIGN_TOP_RIGHT, -UX(8), UY(20));
    lv_obj_add_flag(arR, LV_OBJ_FLAG_HIDDEN);
    g_wk.edit_arrow_right = arR;

    // Transparent tap zone — enter/exit primary edit + double-tap = thread type menu
    lv_obj_t* tap = lv_btn_create(feat);
    lv_obj_set_size(tap, LEFT_W - UX(100), FEAT_H - UY(8));
    lv_obj_set_pos(tap, 0, 0);
    lv_obj_set_style_bg_opa(tap, LV_OPA_TRANSP, 0);
    lv_obj_set_style_border_width(tap, 0, 0);
    lv_obj_set_style_shadow_width(tap, 0, 0);
    lv_obj_add_event_cb(tap, [](lv_event_t*) { primary_value_tap(); }, LV_EVENT_CLICKED, nullptr);

    // ── Grid cells 3×2 ───────────────────────────────────────────────────────
    // Row 1: ПОЗИЦИЯ Z
    {
        auto r = make_param_cell(panel, col_x[0], GRID_Y, COL_W0, ROW_H,
                                  "\xD0\x9F\xD0\x9E\xD0\x97\xD0\x98\xD0\xA6\xD0\x98\xD0\xAF " AXIS_Z);  // ПОЗИЦИЯ Z
        g_wk.row1_box = r.box; g_wk.row1_title = r.title; g_wk.row1_val = r.val;
        lv_label_set_text(r.val, "+125.45");
        lv_obj_set_style_text_color(r.val, lv_color_hex(0x00ff88), 0);
        lv_obj_add_flag(r.box, LV_OBJ_FLAG_CLICKABLE);
        lv_obj_set_user_data(r.box, (void*)(intptr_t)0);
        lv_obj_add_event_cb(r.box, [](lv_event_t* e) {
            static uint32_t s_ztap = 0; uint32_t now = millis();
            bool dbl = (now - s_ztap) < 400; s_ztap = now;
            if (dbl && rows_show_axes()) {             // двойной тап — ноль оси Y
                exit_sub_edit();
                if (axis_edit_allowed()) axis_send('Z', 0);
                return;
            }
            int row = (intptr_t)lv_obj_get_user_data(lv_event_get_target(e));
            if (g_sub_edit.active && g_sub_edit.row == row) exit_sub_edit();
            else { exit_sub_edit(); enter_sub_edit(row); }
        }, LV_EVENT_SHORT_CLICKED, nullptr);
        lv_obj_add_event_cb(r.box, [](lv_event_t*) {   // долгое нажатие — ввод значения Y
            if (rows_show_axes() && axis_edit_allowed()) { exit_sub_edit(); axis_kb_show('Z'); }
        }, LV_EVENT_LONG_PRESSED, nullptr);
    }
    // Row 2: ПОЗИЦИЯ X
    {
        auto r = make_param_cell(panel, col_x[1], GRID_Y, COL_W0, ROW_H,
                                  "\xD0\x9F\xD0\x9E\xD0\x97\xD0\x98\xD0\xA6\xD0\x98\xD0\xAF " AXIS_X);  // ПОЗИЦИЯ X
        g_wk.row2_box = r.box; g_wk.row2_title = r.title; g_wk.row2_val = r.val;
        lv_label_set_text(r.val, "-42.78");
        lv_obj_set_style_text_color(r.val, lv_color_hex(0xff5555), 0);
        lv_obj_add_flag(r.box, LV_OBJ_FLAG_CLICKABLE);
        lv_obj_set_user_data(r.box, (void*)(intptr_t)1);
        lv_obj_add_event_cb(r.box, [](lv_event_t* e) {
            static uint32_t s_xtap = 0; uint32_t now = millis();
            bool dbl = (now - s_xtap) < 400; s_xtap = now;
            if (dbl && rows_show_axes()) {             // двойной тап — ноль оси X
                exit_sub_edit();
                if (axis_edit_allowed()) axis_send('X', 0);
                return;
            }
            int row = (intptr_t)lv_obj_get_user_data(lv_event_get_target(e));
            if (g_sub_edit.active && g_sub_edit.row == row) exit_sub_edit();
            else { exit_sub_edit(); enter_sub_edit(row); }
        }, LV_EVENT_SHORT_CLICKED, nullptr);
        lv_obj_add_event_cb(r.box, [](lv_event_t*) {   // долгое нажатие — ввод значения X
            if (rows_show_axes() && axis_edit_allowed()) { exit_sub_edit(); axis_kb_show('X'); }
        }, LV_EVENT_LONG_PRESSED, nullptr);
    }
    // Row 3: mode-specific param
    {
        auto r = make_param_cell(panel, col_x[0], GRID_Y + ROW_H + GAP, COL_W0, ROW_H,
                                  "\xD0\x9F\xD0\xA0\xD0\x9E\xD0\xA5\xD0\x9E\xD0\x94\xD0\xAB");  // ПРОХОДЫ
        g_wk.row3_box = r.box; g_wk.row3_title = r.title; g_wk.row3_val = r.val;
        lv_obj_add_flag(r.box, LV_OBJ_FLAG_CLICKABLE);
        lv_obj_set_user_data(r.box, (void*)(intptr_t)2);
        lv_obj_add_event_cb(r.box, [](lv_event_t* e) {
            int row = (intptr_t)lv_obj_get_user_data(lv_event_get_target(e));
            if (g_sub_edit.active && g_sub_edit.row == row) exit_sub_edit();
            else { exit_sub_edit(); enter_sub_edit(row); }
        }, LV_EVENT_CLICKED, nullptr);
    }
    // Row 4: secondary count — только отображение (переключение SM перенесено на row6)
    {
        auto r = make_param_cell(panel, col_x[1], GRID_Y + ROW_H + GAP, COL_W0, ROW_H,
                                  "\xD0\x9F\xD0\xA0\xD0\x9E\xD0\xA5\xD0\x9E\xD0\x94\xD0\xAB", false, true);  // ПРОХОДЫ
        g_wk.row4_box = r.box; g_wk.row4_title = r.title; g_wk.row4_val = r.val;
        lv_label_set_recolor(r.val, true);
    }
    // Большой экран: «УПОРЫ» — под плиткой ТИП/СЪЁМ/ШАР, видна, когда та скрыта (M1/M2, подэкран 1)
    if (BIG_SCREEN) {
        auto r = make_param_cell(panel, col_x[2], GRID_Y + ROW_H + GAP, COL_W2, ROW_H,
                                  "\xD0\xA3\xD0\x9F\xD0\x9E\xD0\xA0\xD0\xAB");  // УПОРЫ
        lv_obj_set_style_text_font(r.val, &font_dejavu_14, 0);
        lv_obj_set_style_text_line_space(r.val, US(2), 0);
        lv_obj_set_pos(r.val, 0, US(18));
        lv_label_set_recolor(r.val, true);
        lv_label_set_text(r.val, "");
        lv_obj_add_flag(r.box, LV_OBJ_FLAG_HIDDEN);
        s_lim_box = r.box; s_lim_val = r.val;
    }
    // Spare1 (col2 bottom): tracked thread-type cell — shown in M3 only
    {
        auto r = make_param_cell(panel, col_x[2], GRID_Y + ROW_H + GAP, COL_W2, ROW_H,
                                  "\xD0\xA2\xD0\x98\xD0\x9F");  // ТИП
        g_wk.thr_type_box = r.box; g_wk.thr_type_title = r.title; g_wk.thr_type_val = r.val;
        lv_obj_set_style_border_color(r.box, lv_color_hex(0xffaa44), 0);
        lv_obj_set_style_text_color(r.title, lv_color_hex(0xffaa44), 0);
        lv_obj_set_style_text_color(r.val, lv_color_hex(0xffcc00), 0);
        lv_label_set_text(r.val, "--");
        lv_obj_add_flag(r.box, LV_OBJ_FLAG_HIDDEN);  // hidden until M3/M4/M5
        // Кликабельный — для M4/M5: sub-edit row 3 = СЪЁМ (Ap)
        lv_obj_add_flag(r.box, LV_OBJ_FLAG_CLICKABLE);
        lv_obj_add_event_cb(r.box, [](lv_event_t*) {
            if (s_last_mode == MODE_THREAD) {
                if (g_edit_param.active) exit_edit_mode();
                show_thr_type_menu();
                return;
            }
            if (g_sub_edit.active && g_sub_edit.row == 3) exit_sub_edit();
            else { exit_sub_edit(); enter_sub_edit(3); }
        }, LV_EVENT_CLICKED, nullptr);
    }
    // ДИАМЕТР (Ø на LCD2004) — верх col2, в одном ряду с ПОЗИЦИЯ Y / X; двойной тап → PARAM_OK,
    // долгое нажатие — ввод диаметра (замерили деталь — ввели ⌀)
    {
        auto r = make_param_cell(panel, col_x[2], GRID_Y, COL_W2, ROW_H, TITLE_DIAM);
        g_wk.diam_unit = r.title; g_wk.diam_val = r.val; g_wk.diam_box = r.box;
        lv_label_set_text(r.val, "+0.00");
        lv_obj_add_flag(r.box, LV_OBJ_FLAG_CLICKABLE);
        lv_obj_add_event_cb(r.box, [](lv_event_t*) {
            static uint32_t s_dtap = 0; uint32_t now = millis();
            bool dbl = (now - s_dtap) < 400; s_dtap = now;
            if (dbl) { exit_sub_edit(); uart_protocol.sendButtonPress("PARAM_OK"); }
        }, LV_EVENT_SHORT_CLICKED, nullptr);
        lv_obj_add_event_cb(r.box, [](lv_event_t*) {
            if (axis_edit_allowed()) { exit_sub_edit(); axis_kb_show('D'); }
        }, LV_EVENT_LONG_PRESSED, nullptr);
    }
    // SM-индикатор (название текущего SM, update_sm_row6) — в featured-панели между значением и RPM
    {
        lv_obj_t* dlbl = lv_label_create(feat);
        lv_obj_set_style_text_font(dlbl, &font_tahoma_bold_16, 0);
        lv_obj_set_style_text_color(dlbl, lv_color_hex(0x2a3a4a), 0);
        lv_label_set_long_mode(dlbl, LV_LABEL_LONG_WRAP);
        lv_obj_set_width(dlbl, UX(130));
        lv_obj_set_style_text_align(dlbl, LV_TEXT_ALIGN_CENTER, 0);
        lv_obj_align(dlbl, LV_ALIGN_RIGHT_MID, -UX(100), 0);   // по центру панели при 1–3 строках
        lv_label_set_text(dlbl, "--");
        g_ui.sm_row6 = dlbl;
    }

    // ── Right vertical buttons ────────────────────────────────────────────────
    const int UP_H = UY(64), OK_H = UY(88), DN_H = UY(64);
    lv_obj_t* up_btn = lv_btn_create(panel);
    lv_obj_set_size(up_btn, RIGHT_W, UP_H);
    lv_obj_set_pos(up_btn, RIGHT_X, PAD);
    lv_obj_set_style_bg_color(up_btn, lv_color_hex(0x2a4a5a), 0);
    lv_obj_set_style_border_color(up_btn, lv_color_hex(0x3a6a8a), 0);
    lv_obj_set_style_border_width(up_btn, US(1), 0);
    lv_obj_set_style_radius(up_btn, US(4), 0);
    lv_obj_set_style_shadow_width(up_btn, 0, 0);
    { lv_obj_t* l = lv_label_create(up_btn); lv_obj_center(l); lv_label_set_text(l, LV_SYMBOL_UP); }
    lv_obj_add_event_cb(up_btn, [](lv_event_t*) { handle_up_btn_click(); }, LV_EVENT_CLICKED, nullptr);

    lv_obj_t* ok_btn = lv_btn_create(panel);
    lv_obj_set_size(ok_btn, RIGHT_W, OK_H);
    lv_obj_set_pos(ok_btn, RIGHT_X, PAD + UP_H + GAP);
    lv_obj_set_style_bg_color(ok_btn, lv_color_hex(0x00d4ff), 0);
    lv_obj_set_style_border_color(ok_btn, lv_color_hex(0x00d4ff), 0);
    lv_obj_set_style_border_width(ok_btn, US(1), 0);
    lv_obj_set_style_radius(ok_btn, US(4), 0);
    lv_obj_set_style_shadow_width(ok_btn, US(10), 0);
    lv_obj_set_style_shadow_color(ok_btn, lv_color_hex(0x00d4ff), 0);
    { lv_obj_t* l = lv_label_create(ok_btn); lv_obj_center(l);
      lv_obj_set_style_text_color(l, lv_color_hex(0x000000), 0);
      lv_obj_set_style_text_font(l, &font_dejavu_14, 0);
      lv_label_set_text(l, "OK"); }
    lv_obj_add_event_cb(ok_btn, [](lv_event_t*) { handle_ok_btn_click(); }, LV_EVENT_CLICKED, nullptr);

    lv_obj_t* dn_btn = lv_btn_create(panel);
    lv_obj_set_size(dn_btn, RIGHT_W, DN_H);
    lv_obj_set_pos(dn_btn, RIGHT_X, PAD + UP_H + GAP + OK_H + GAP);
    lv_obj_set_style_bg_color(dn_btn, lv_color_hex(0x2a4a5a), 0);
    lv_obj_set_style_border_color(dn_btn, lv_color_hex(0x3a6a8a), 0);
    lv_obj_set_style_border_width(dn_btn, US(1), 0);
    lv_obj_set_style_radius(dn_btn, US(4), 0);
    lv_obj_set_style_shadow_width(dn_btn, 0, 0);
    { lv_obj_t* l = lv_label_create(dn_btn); lv_obj_center(l); lv_label_set_text(l, LV_SYMBOL_DOWN); }
    lv_obj_add_event_cb(dn_btn, [](lv_event_t*) { handle_dn_btn_click(); }, LV_EVENT_CLICKED, nullptr);
}

// ============================================================================
// Меню настроек — оверлей (double-tap на иконку ⚠ в statusbar).
// Механика станка (BACKLOG-028): значения приходят от STM32 (<CFG:…>), правятся клавиатурой,
// СОХРАНИТЬ — CFG_SET (STM32 проверяет, применяет и пишет во флеш), ИЗ КОНФИГА — CFG_DEFAULT
// (значения из els_config.h). Ответ STM32 (CFG_RES) — в строке статуса.
// ============================================================================
// Индексы в LatheData::cfg: 0 энкодер, 1 шагов Z, 2 микрошаг Z, 3 винт Z (0.01 мм),
// 4 шагов X, 5 микрошаг X, 6 винт X, 7 люфт Z (мкм), 8 люфт X
struct CfgField { const char* name; int8_t idx_z, idx_x; uint8_t dec, digits; const char* unit; };
static const CfgField CFG_FIELDS[] = {
    { "\xD0\xA8\xD0\x90\xD0\x93 \xD0\x92\xD0\x98\xD0\x9D\xD0\xA2\xD0\x90, \xD0\xBC\xD0\xBC", 3, 6, 2, 2, "\xD0\xBC\xD0\xBC" },   // ШАГ ВИНТА, мм
    { "\xD0\xA8\xD0\x90\xD0\x93\xD0\x9E\xD0\x92 \xD0\x9D\xD0\x90 \xD0\x9E\xD0\x91\xD0\x9E\xD0\xA0\xD0\x9E\xD0\xA2", 1, 4, 0, 4, "" },      // ШАГОВ НА ОБОРОТ
    { "\xD0\x9C\xD0\x98\xD0\x9A\xD0\xA0\xD0\x9E\xD0\xA8\xD0\x90\xD0\x93", 2, 5, 0, 3, "" },                                                  // МИКРОШАГ
    { "\xD0\x9B\xD0\xAE\xD0\xA4\xD0\xA2, \xD0\xBC\xD0\xBA\xD0\xBC", 7, 8, 0, 4, "\xD0\xBC\xD0\xBA\xD0\xBC" },                              // ЛЮФТ, мкм
    { "\xD0\xAD\xD0\x9D\xD0\x9A\xD0\x9E\xD0\x94\xD0\x95\xD0\xA0, \xD0\xBB\xD0\xB8\xD0\xBD\xD0\xB8\xD0\xB9", 0, -1, 0, 5, "" },           // ЭНКОДЕР, линий
};
struct CfgUi {
    int32_t   edit[9];       // правка до сохранения
    bool      dirty;         // есть несохранённые правки
    uint8_t   seen_seq;      // последний показанный CFG_RES
    lv_obj_t* val[9];
    lv_obj_t* status;
};
static CfgUi g_cfg = {};

static void cfg_fmt(char* b, size_t n, int idx, int32_t v)
{
    if (idx == 3 || idx == 6) snprintf(b, n, "%ld.%02ld", (long)(v / 100), (long)(v % 100));
    else snprintf(b, n, "%ld", (long)v);
}

static void cfg_set_status(const char* t, uint32_t color)
{
    lv_label_set_text(g_cfg.status, t);
    lv_obj_set_style_text_color(g_cfg.status, lv_color_hex(color), 0);
}

static void cfg_refresh()
{
    const LatheData& d = uart_protocol.getData();
    for (int i = 0; i < 9; i++) {
        if (!g_cfg.val[i]) continue;
        char b[16];
        if (!d.cfg_valid) { lv_label_set_text(g_cfg.val[i], "--"); continue; }
        cfg_fmt(b, sizeof(b), i, g_cfg.edit[i]);
        lv_label_set_text(g_cfg.val[i], b);
        lv_obj_set_style_text_color(g_cfg.val[i], lv_color_hex(g_cfg.edit[i] != d.cfg[i] ? 0xffcc00 : 0xe0e0e0), 0);
    }
}

static void cfg_open()
{
    const LatheData& d = uart_protocol.getData();
    memcpy(g_cfg.edit, d.cfg, sizeof(g_cfg.edit));
    g_cfg.dirty = false;
    g_cfg.seen_seq = d.cfg_res_seq;
    cfg_set_status(d.cfg_valid ? "" : "\xD0\x9D\xD0\x95\xD0\xA2 \xD0\x94\xD0\x90\xD0\x9D\xD0\x9D\xD0\xAB\xD0\xA5 \xD0\x9E\xD0\xA2 STM32",
                   0xff8800);                                            // НЕТ ДАННЫХ ОТ STM32
    cfg_refresh();
    if (g_ui.alert_box && !lv_obj_has_flag(g_ui.alert_box, LV_OBJ_FLAG_HIDDEN))
        dismiss_alert();                                   // подсказка Wi-Fi от первого тапа по ⚠
    lv_obj_clear_flag(g_ui.settings_menu, LV_OBJ_FLAG_HIDDEN);
}

// Раз в 200 мс, пока меню открыто: новые значения от STM32 и ответ на сохранение
static void cfg_tick(lv_timer_t*)
{
    if (!g_ui.settings_menu || lv_obj_has_flag(g_ui.settings_menu, LV_OBJ_FLAG_HIDDEN)) return;
    const LatheData& d = uart_protocol.getData();
    if (d.cfg_res_seq != g_cfg.seen_seq) {
        g_cfg.seen_seq = d.cfg_res_seq;
        bool ok = !strcmp(d.cfg_res, "OK");
        cfg_set_status(ok ? "\xD0\xA1\xD0\x9E\xD0\xA5\xD0\xA0\xD0\x90\xD0\x9D\xD0\x95\xD0\x9D\xD0\x9E" : d.cfg_res,   // СОХРАНЕНО
                       ok ? 0x00ff88 : 0xff5555);
        if (ok) g_cfg.dirty = false;
    }
    if (!g_cfg.dirty && d.cfg_valid) memcpy(g_cfg.edit, d.cfg, sizeof(g_cfg.edit));
    cfg_refresh();
}

static void cfg_send_edit()
{
    if (!uart_protocol.getData().cfg_valid) return;
    const int32_t* v = g_cfg.edit;
    char cmd[96];
    snprintf(cmd, sizeof(cmd), "CFG_SET:%ld,%ld,%ld,%ld,%ld,%ld,%ld,%ld,%ld", (long)v[0], (long)v[1], (long)v[2],
             (long)v[3], (long)v[4], (long)v[5], (long)v[6], (long)v[7], (long)v[8]);
    uart_protocol.sendButtonPress(cmd);
    cfg_set_status("\xD0\xA1\xD0\x9E\xD0\xA5\xD0\xA0\xD0\x90\xD0\x9D\xD0\xAF\xD0\x95\xD0\x9C...", 0x6a9fb5);   // СОХРАНЯЕМ...
}

static lv_obj_t* cfg_button(lv_obj_t* parent, const char* text, uint32_t bg, uint32_t fg)
{
    lv_obj_t* b = lv_btn_create(parent);
    lv_obj_set_style_bg_color(b, lv_color_hex(bg), 0);
    lv_obj_set_style_border_color(b, lv_color_hex(0x3a5a6a), 0);
    lv_obj_set_style_border_width(b, US(1), 0);
    lv_obj_set_style_radius(b, US(6), 0);
    lv_obj_set_style_shadow_width(b, 0, 0);
    lv_obj_t* l = lv_label_create(b);
    lv_obj_center(l);
    lv_obj_set_style_text_font(l, &font_tahoma_bold_16, 0);
    lv_obj_set_style_text_color(l, lv_color_hex(fg), 0);
    lv_label_set_text(l, text);
    return b;
}

// ============================================================================
// Калибровка шага винта и люфта по линейкам (BACKLOG-029): окно из «МЕХАНИКА СТАНКА».
// TOUCH CAL:<Z|X>:<мкм хода> — STM32 проезжает 3 раза туда-обратно и отвечает CAL_RES / CAL_ERR.
// ПРИМЕНИТЬ — шаг винта (округлённый до 0.01 мм, как хранит ядро) и люфт в настройки → CFG_SET.
// ============================================================================
// Два способа: 0 — по линейкам (станок меряет сам), 1 — по индикатору / штангенциркулю (без линеек):
// STM32 по шагам двигает ось (CAL_STEP), показания вводит оператор, результат считает экран.
struct CalUi {
    lv_obj_t* back;
    lv_obj_t* len_lbl[2];     // ход Y / X
    lv_obj_t* status;
    lv_obj_t* apply;
    int32_t   len_mm[2];
    uint8_t   seen_seq;
    lv_obj_t* tab[2];
    lv_obj_t* help;
    lv_obj_t* next;           // ДАЛЕЕ — по индикатору: индикатор обнулён
    int       method;
    int       ist;            // по индикатору: 0 — нет, 1 — люфт выбирается, 2 — ждём «обнулён», 3 — едет на L,
                              // 4 — ввод показания, 5 — возврат, 6 — ввод показания после возврата
    char      iax;
    int32_t   ilen_um, im1_um;
};
static CalUi g_cal = { nullptr, {nullptr, nullptr}, nullptr, nullptr, {20, 10}, 0 };

static void cal_method_refresh();
static void cal_send_step(int phase)
{
    char cmd[40];
    snprintf(cmd, sizeof(cmd), "CAL_STEP:%c:%d:%ld", g_cal.iax, phase, (long)g_cal.ilen_um);
    uart_protocol.sendButtonPress(cmd);
}

static void cfg_send_edit();   // СОХРАНИТЬ из «МЕХАНИКА СТАНКА»

static void cal_close()
{
    if (g_cal.back) { lv_obj_del(g_cal.back); g_cal.back = nullptr; }
}

static void cal_status(const char* t, uint32_t color)
{
    lv_label_set_text(g_cal.status, t);
    lv_obj_set_style_text_color(g_cal.status, lv_color_hex(color), 0);
}

static void cal_len_refresh()
{
    for (int i = 0; i < 2; i++) {
        char b[16]; snprintf(b, sizeof(b), "%ld \xD0\xBC\xD0\xBC", (long)g_cal.len_mm[i]);   // мм
        lv_label_set_text(g_cal.len_lbl[i], b);
    }
}

// Ответы STM32 — раз в 200 мс, пока окно открыто
static void cal_tick(lv_timer_t*)
{
    if (!g_cal.back) return;
    const LatheData& d = uart_protocol.getData();
    if (d.cal_seq == g_cal.seen_seq) return;
    g_cal.seen_seq = d.cal_seq;
    char t[200];
    if (d.cal_state == 4) {                                   // по индикатору: фаза выполнена
        int ph = atoi(d.cal_text);
        if (ph == 1) {
            g_cal.ist = 2;
            cal_status("\xD0\x9E\xD0\xB1\xD0\xBD\xD1\x83\xD0\xBB\xD0\xB8\xD1\x82\xD0\xB5 \xD0\xB8\xD0\xBD\xD0\xB4\xD0\xB8\xD0\xBA\xD0\xB0\xD1\x82\xD0\xBE\xD1\x80 \xD0\xB8 \xD0\xBD\xD0\xB0\xD0\xB6\xD0\xBC\xD0\xB8\xD1\x82\xD0\xB5 \xD0\x94\xD0\x90\xD0\x9B\xD0\x95\xD0\x95", 0xffcc00);
            lv_obj_clear_flag(g_cal.next, LV_OBJ_FLAG_HIDDEN);
        } else if (ph == 2) {
            g_cal.ist = 4;
            numpad_show("\xD0\x9F\xD0\x9E\xD0\x9A\xD0\x90\xD0\x97\xD0\x90\xD0\x9D\xD0\x98\xD0\x95 \xD0\x98\xD0\x9D\xD0\x94\xD0\x98\xD0\x9A\xD0\x90\xD0\xA2\xD0\x9E\xD0\xA0\xD0\x90", "\xD0\xBC\xD0\xBC", 3, 3, false, nullptr, [](int32_t v, intptr_t) {
                g_cal.im1_um = v; g_cal.ist = 5;
                cal_status("\xD0\x92\xD0\xBE\xD0\xB7\xD0\xB2\xD1\x80\xD0\xB0\xD1\x82 \xD0\xBD\xD0\xB0 \xD1\x85\xD0\xBE\xD0\xB4...", 0x6a9fb5);
                cal_send_step(3);
            }, 0);
        } else if (ph == 3) {
            g_cal.ist = 6;
            numpad_show("\xD0\x9F\xD0\x9E\xD0\x9A\xD0\x90\xD0\x97\xD0\x90\xD0\x9D\xD0\x98\xD0\x95 \xD0\x9F\xD0\x9E\xD0\xA1\xD0\x9B\xD0\x95 \xD0\x92\xD0\x9E\xD0\x97\xD0\x92\xD0\xA0\xD0\x90\xD0\xA2\xD0\x90", "\xD0\xBC\xD0\xBC", 3, 2, true, nullptr, [](int32_t v, intptr_t) {
                g_cal.ist = 0;
                const LatheData& d = uart_protocol.getData();
                int zi = g_cal.iax == 'Z';
                int32_t screw_um = d.cfg[zi ? 3 : 6] * 10;              // шаг винта сейчас, мкм
                if (g_cal.ilen_um <= 0 || g_cal.im1_um <= 0) return;
                // проехали L по шагам — индикатор показал m1: реальный шаг винта = шаг × m1 / L
                int32_t screw_new = (int32_t)((int64_t)screw_um * g_cal.im1_um / g_cal.ilen_um);
                uart_protocol.setCalResult(g_cal.iax, screw_new, v < 0 ? -v : v);
            }, 0);
        }
        return;
    }
    if (d.cal_state != 4 && g_cal.ist && d.cal_state == 3) g_cal.ist = 0;
    if (d.cal_state == 1) {
        snprintf(t, sizeof(t), "\xD0\x98\xD0\x94\xD0\x81\xD0\xA2 \xD0\x9A\xD0\x90\xD0\x9B\xD0\x98\xD0\x91\xD0\xA0\xD0\x9E\xD0\x92\xD0\x9A\xD0\x90 %s: %s",   // ИДЁТ КАЛИБРОВКА Z: 1/3
                 d.cal_ax == 'Z' ? "Z" : "X", strchr(d.cal_text, ':') ? strchr(d.cal_text, ':') + 1 : "");
        cal_status(t, 0x6a9fb5);
        lv_obj_add_flag(g_cal.apply, LV_OBJ_FLAG_HIDDEN);
    } else if (d.cal_state == 3) {
        cal_status(d.cal_text, 0xff5555);
    } else if (d.cal_state == 2) {
        int zi = d.cal_ax == 'Z';
        int32_t cfg_screw = d.cfg[zi ? 3 : 6];                 // 0.01 мм
        int32_t new_screw = (d.cal_screw_um + 5) / 10;
        long dev = cfg_screw ? labs((long)d.cal_screw_um - cfg_screw * 10) * 1000 / (cfg_screw * 10) : 0;   // ‰
        snprintf(t, sizeof(t),
                 "%s: \xD0\xB2\xD0\xB8\xD0\xBD\xD1\x82 %ld.%03ld \xD0\xBC\xD0\xBC (\xD0\xB1\xD1\x8B\xD0\xBB\xD0\xBE %ld.%02ld, \xD0\xB1\xD1\x83\xD0\xB4\xD0\xB5\xD1\x82 %ld.%02ld), "
                 "\xD0\xBB\xD1\x8E\xD1\x84\xD1\x82 %ld \xD0\xBC\xD0\xBA\xD0\xBC%s",
                 zi ? "Z" : "X", (long)(d.cal_screw_um / 1000), (long)(d.cal_screw_um % 1000),
                 (long)(cfg_screw / 100), (long)(cfg_screw % 100), (long)(new_screw / 100), (long)(new_screw % 100),
                 (long)d.cal_bl_um,
                 dev > 200 ? "\n\xD0\x9E\xD0\xA2\xD0\x9B\xD0\x98\xD0\xA7\xD0\x90\xD0\x95\xD0\xA2\xD0\xA1\xD0\xAF \xD0\x91\xD0\x9E\xD0\x9B\xD0\x95\xD0\x95 20%: "
                             "\xD0\xBF\xD1\x80\xD0\xBE\xD0\xB2\xD0\xB5\xD1\x80\xD1\x8C\xD1\x82\xD0\xB5 \xD0\xBB\xD0\xB8\xD0\xBD\xD0\xB5\xD0\xB9\xD0\xBA\xD1\x83 "
                             "(\xD0\xB4\xD0\xB8\xD0\xB0\xD0\xBC\xD0\xB5\xD1\x82\xD1\x80/\xD1\x80\xD0\xB0\xD0\xB4\xD0\xB8\xD1\x83\xD1\x81)" : "");
        // «винт 1.920 мм (было 2.00, будет 1.92), люфт 80 мкм»; > 20 % — «отличается более 20%: проверьте линейку (диаметр/радиус)»
        cal_status(t, dev > 200 ? 0xffaa44 : 0x00ff88);
        lv_obj_clear_flag(g_cal.apply, LV_OBJ_FLAG_HIDDEN);
    }
}

static void cal_method_refresh()
{
    for (int i = 0; i < 2; i++) {
        bool on = g_cal.method == i;
        lv_obj_set_style_bg_color(g_cal.tab[i], lv_color_hex(on ? 0x0a3a2a : 0x10202c), 0);
        lv_obj_set_style_text_color(lv_obj_get_child(g_cal.tab[i], 0), lv_color_hex(on ? 0x00ff88 : 0x6a9fb5), 0);
    }
    lv_label_set_text(g_cal.help, g_cal.method ? "\xD0\x98\xD0\xBD\xD0\xB4\xD0\xB8\xD0\xBA\xD0\xB0\xD1\x82\xD0\xBE\xD1\x80 (\xD0\xB8\xD0\xBB\xD0\xB8 \xD1\x88\xD1\x82\xD0\xB0\xD0\xBD\xD0\xB3\xD0\xB5\xD0\xBD\xD1\x86\xD0\xB8\xD1\x80\xD0\xBA\xD1\x83\xD0\xBB\xD1\x8C) \xD1\x83\xD0\xBF\xD0\xBE\xD1\x80\xD0\xBE\xD0\xBC \xD0\xB2 \xD0\xBA\xD0\xB0\xD1\x80\xD0\xB5\xD1\x82\xD0\xBA\xD1\x83 \xD0\xB8\xD0\xBB\xD0\xB8 \xD1\x81\xD1\x83\xD0\xBF\xD0\xBF\xD0\xBE\xD1\x80\xD1\x82. \xD0\x9E\xD1\x81\xD1\x8C \xD0\xB2\xD1\x8B\xD0\xB1\xD0\xB5\xD1\x80\xD0\xB5\xD1\x82 \xD0\xBB\xD1\x8E\xD1\x84\xD1\x82, \xD0\xB2\xD1\x8B \xD0\xBE\xD0\xB1\xD0\xBD\xD1\x83\xD0\xBB\xD0\xB8\xD1\x82\xD0\xB5 \xD0\xB8\xD0\xBD\xD0\xB4\xD0\xB8\xD0\xBA\xD0\xB0\xD1\x82\xD0\xBE\xD1\x80, \xD0\xBE\xD1\x81\xD1\x8C \xD0\xBF\xD1\x80\xD0\xBE\xD0\xB5\xD0\xB4\xD0\xB5\xD1\x82 \xD0\xB2\xD0\xBF\xD0\xB5\xD1\x80\xD1\x91\xD0\xB4 \xD0\xBD\xD0\xB0 \xD1\x85\xD0\xBE\xD0\xB4 \xD0\xB8 \xD0\xB2\xD0\xB5\xD1\x80\xD0\xBD\xD1\x91\xD1\x82\xD1\x81\xD1\x8F: \xD0\xB2\xD0\xB2\xD0\xB5\xD0\xB4\xD0\xB8\xD1\x82\xD0\xB5 \xD0\xBE\xD0\xB1\xD0\xB0 \xD0\xBF\xD0\xBE\xD0\xBA\xD0\xB0\xD0\xB7\xD0\xB0\xD0\xBD\xD0\xB8\xD1\x8F." : "\xD0\xA3\xD0\xB1\xD0\xB5\xD1\x80\xD0\xB8\xD1\x82\xD0\xB5 \xD0\xB7\xD0\xB0\xD0\xB3\xD0\xBE\xD1\x82\xD0\xBE\xD0\xB2\xD0\xBA\xD1\x83 \xD0\xB8 \xD0\xBE\xD1\x82\xD0\xB2\xD0\xB5\xD0\xB4\xD0\xB8\xD1\x82\xD0\xB5 \xD1\x80\xD0\xB5\xD0\xB7\xD0\xB5\xD1\x86. \xD0\x9E\xD1\x81\xD1\x8C 3 \xD1\x80\xD0\xB0\xD0\xB7\xD0\xB0 \xD0\xBF\xD1\x80\xD0\xBE\xD0\xB5\xD0\xB4\xD0\xB5\xD1\x82 \xD0\xB2\xD0\xBF\xD0\xB5\xD1\x80\xD1\x91\xD0\xB4 \xD0\xBD\xD0\xB0 \xD1\x85\xD0\xBE\xD0\xB4 + 1 \xD0\xBC\xD0\xBC \xD0\xB8 \xD0\xBE\xD0\xB1\xD1\x80\xD0\xB0\xD1\x82\xD0\xBD\xD0\xBE \xD0\xB8 \xD0\xB2\xD0\xB5\xD1\x80\xD0\xBD\xD1\x91\xD1\x82\xD1\x81\xD1\x8F \xD0\xBD\xD0\xB0 \xD0\xBC\xD0\xB5\xD1\x81\xD1\x82\xD0\xBE. \xD0\x9F\xD1\x80\xD0\xB5\xD1\x80\xD0\xB2\xD0\xB0\xD1\x82\xD1\x8C: \xD0\xB4\xD0\xB6\xD0\xBE\xD0\xB9\xD1\x81\xD1\x82\xD0\xB8\xD0\xBA\xD0\xBE\xD0\xBC \xD0\xB8\xD0\xBB\xD0\xB8 \xD0\xA1\xD0\xA2\xD0\x9E\xD0\x9F.");
    lv_obj_add_flag(g_cal.next, LV_OBJ_FLAG_HIDDEN);
    lv_obj_add_flag(g_cal.apply, LV_OBJ_FLAG_HIDDEN);
    cal_status("", 0x6a9fb5);
}

static void cal_show()
{
    cal_close();
    g_cal.seen_seq = uart_protocol.getData().cal_seq;
    lv_obj_t* back = lv_obj_create(lv_layer_top());
    g_cal.back = back;
    lv_obj_set_size(back, SCREEN_WIDTH, SCREEN_HEIGHT);
    lv_obj_set_pos(back, 0, 0);
    lv_obj_set_style_bg_color(back, lv_color_hex(0x000814), 0);
    lv_obj_set_style_bg_opa(back, LV_OPA_COVER, 0);
    lv_obj_set_style_border_width(back, 0, 0);
    lv_obj_set_style_radius(back, 0, 0);
    lv_obj_clear_flag(back, LV_OBJ_FLAG_SCROLLABLE);

    lv_obj_t* title = lv_label_create(back);
    lv_obj_set_pos(title, UX(16), UY(6));
    lv_obj_set_style_text_color(title, lv_color_hex(0x00d4ff), 0);
    lv_obj_set_style_text_font(title, &font_tahoma_bold_22, 0);
    lv_label_set_text(title, "\xD0\x9A\xD0\x90\xD0\x9B\xD0\x98\xD0\x91\xD0\xA0\xD0\x9E\xD0\x92\xD0\x9A\xD0\x90");   // КАЛИБРОВКА

    // Способ: ПО ЛИНЕЙКАМ / ПО ИНДИКАТОРУ (без линеек и блока DRO — сразу по индикатору)
    static const char* TABS[2] = { "\xD0\x9F\xD0\x9E \xD0\x9B\xD0\x98\xD0\x9D\xD0\x95\xD0\x99\xD0\x9A\xD0\x90\xD0\x9C", "\xD0\x9F\xD0\x9E \xD0\x98\xD0\x9D\xD0\x94\xD0\x98\xD0\x9A\xD0\x90\xD0\xA2\xD0\x9E\xD0\xA0\xD0\xA3" };
    g_cal.method = uart_protocol.getData().pos_valid && uart_protocol.getData().pos_cfg[0] == 0 ? 1 : 0;
    g_cal.ist = 0;
    for (int i = 0; i < 2; i++) {
        lv_obj_t* b = cfg_button(back, TABS[i], 0x10202c, 0x6a9fb5);
        lv_obj_set_size(b, UX(136), UY(26)); lv_obj_set_pos(b, UX(188) + i * UX(140), UY(4));
        lv_obj_set_style_text_font(lv_obj_get_child(b, 0), &font_dejavu_14, 0);
        g_cal.tab[i] = b;
        lv_obj_add_event_cb(b, [](lv_event_t* e) {
            g_cal.method = (int)(intptr_t)lv_event_get_user_data(e);
            g_cal.ist = 0;
            cal_method_refresh();
        }, LV_EVENT_CLICKED, (void*)(intptr_t)i);
    }

    g_cal.help = lv_label_create(back);
    lv_obj_set_width(g_cal.help, UX(448));
    lv_obj_set_pos(g_cal.help, UX(16), UY(36));
    lv_obj_set_style_text_font(g_cal.help, &font_dejavu_14, 0);
    lv_obj_set_style_text_color(g_cal.help, lv_color_hex(0x9ab8c8), 0);
    lv_label_set_long_mode(g_cal.help, LV_LABEL_LONG_WRAP);

    const char* names[2] = { "\xD0\x9F\xD0\xA0\xD0\x9E\xD0\x94\xD0\x9E\xD0\x9B\xD0\xAC\xD0\x9D\xD0\x90\xD0\xAF " AXIS_Z,   // ПРОДОЛЬНАЯ Y
                             "\xD0\x9F\xD0\x9E\xD0\x9F\xD0\x95\xD0\xA0\xD0\x95\xD0\xA7\xD0\x9D\xD0\x90\xD0\xAF " AXIS_X }; // ПОПЕРЕЧНАЯ X
    for (int i = 0; i < 2; i++) {
        int y = UY(104) + i * UY(36);
        lv_obj_t* n = lv_label_create(back);
        lv_obj_set_style_text_font(n, &font_dejavu_16, 0);
        lv_obj_set_style_text_color(n, lv_color_hex(0x9ab8c8), 0);
        lv_label_set_recolor(n, true);
        lv_label_set_text(n, names[i]);
        lv_obj_set_pos(n, UX(16), y + UY(7));
        // ход — правится клавиатурой
        lv_obj_t* lb = cfg_button(back, "--", 0x10202c, 0xe0e0e0);
        lv_obj_set_size(lb, UX(110), UY(32)); lv_obj_set_pos(lb, UX(190), y);
        g_cal.len_lbl[i] = lv_obj_get_child(lb, 0);
        lv_obj_set_style_text_font(g_cal.len_lbl[i], &font_tahoma_bold_22, 0);
        lv_obj_add_event_cb(lb, [](lv_event_t* e) {
            intptr_t i = (intptr_t)lv_event_get_user_data(e);
            char init[8]; snprintf(init, sizeof(init), "%ld", (long)g_cal.len_mm[i]);
            numpad_show("\xD0\xA5\xD0\x9E\xD0\x94, \xD0\xBC\xD0\xBC", "\xD0\xBC\xD0\xBC", 0, 3, false, init,   // ХОД, мм
                        [](int32_t v, intptr_t i) { g_cal.len_mm[i] = v < 5 ? 5 : v; cal_len_refresh(); }, i);
        }, LV_EVENT_CLICKED, (void*)(intptr_t)i);
        // ПУСК
        lv_obj_t* go = cfg_button(back, "\xD0\x9F\xD0\xA3\xD0\xA1\xD0\x9A", 0x0a3a2a, 0x00ff88);   // ПУСК
        lv_obj_set_size(go, UX(150), UY(32)); lv_obj_set_pos(go, UX(314), y);
        lv_obj_add_event_cb(go, [](lv_event_t* e) {
            intptr_t i = (intptr_t)lv_event_get_user_data(e);
            lv_obj_add_flag(g_cal.apply, LV_OBJ_FLAG_HIDDEN);
            if (g_cal.method == 1) {                            // по индикатору: сначала выбрать люфт
                g_cal.iax = i ? 'X' : 'Z';
                g_cal.ilen_um = g_cal.len_mm[i] * 1000;
                g_cal.ist = 1;
                cal_send_step(1);
                cal_status("\xD0\x92\xD1\x8B\xD0\xB1\xD0\xB8\xD1\x80\xD0\xB0\xD1\x8E \xD0\xBB\xD1\x8E\xD1\x84\xD1\x82...", 0x6a9fb5);
                return;
            }
            char cmd[32];
            snprintf(cmd, sizeof(cmd), "CAL:%c:%ld", i ? 'X' : 'Z', (long)g_cal.len_mm[i] * 1000);
            uart_protocol.sendButtonPress(cmd);
            cal_status("\xD0\x97\xD0\x90\xD0\x9F\xD0\xA3\xD0\xA1\xD0\x9A...", 0x6a9fb5);   // ЗАПУСК...
        }, LV_EVENT_CLICKED, (void*)i);
    }
    cal_len_refresh();

    g_cal.status = lv_label_create(back);
    lv_obj_set_width(g_cal.status, UX(448));
    lv_obj_set_pos(g_cal.status, UX(16), UY(176));
    lv_obj_set_style_text_font(g_cal.status, &font_dejavu_14, 0);
    lv_label_set_long_mode(g_cal.status, LV_LABEL_LONG_WRAP);
    lv_label_set_text(g_cal.status, "");

    const int BY = UY(222), BH = UY(30), BW = UX(140);   // отступ от нижнего края: рамка подрезает
    g_cal.apply = cfg_button(back, "\xD0\x9F\xD0\xA0\xD0\x98\xD0\x9C\xD0\x95\xD0\x9D\xD0\x98\xD0\xA2\xD0\xAC", 0x0a3a2a, 0x00ff88);   // ПРИМЕНИТЬ
    lv_obj_set_size(g_cal.apply, BW, BH); lv_obj_set_pos(g_cal.apply, UX(16), BY);
    lv_obj_add_flag(g_cal.apply, LV_OBJ_FLAG_HIDDEN);
    lv_obj_add_event_cb(g_cal.apply, [](lv_event_t*) {
        const LatheData& d = uart_protocol.getData();
        if (d.cal_state != 2 || !d.cfg_valid) return;
        int zi = d.cal_ax == 'Z';
        memcpy(g_cfg.edit, d.cfg, sizeof(g_cfg.edit));
        g_cfg.edit[zi ? 3 : 6] = (d.cal_screw_um + 5) / 10;      // шаг винта — 0.01 мм
        g_cfg.edit[zi ? 7 : 8] = d.cal_bl_um;                    // люфт
        g_cfg.dirty = true;
        cfg_send_edit();
        cal_close();                                             // ответ — в строке статуса «МЕХАНИКА СТАНКА»
    }, LV_EVENT_CLICKED, nullptr);

    g_cal.next = cfg_button(back, "\xD0\x94\xD0\x90\xD0\x9B\xD0\x95\xD0\x95", 0x0a3a2a, 0x00ff88);
    lv_obj_set_size(g_cal.next, BW, BH); lv_obj_set_pos(g_cal.next, UX(16), BY);
    lv_obj_add_flag(g_cal.next, LV_OBJ_FLAG_HIDDEN);
    lv_obj_add_event_cb(g_cal.next, [](lv_event_t*) {         // индикатор обнулён — ехать на ход
        if (g_cal.ist != 2) return;
        g_cal.ist = 3;
        lv_obj_add_flag(g_cal.next, LV_OBJ_FLAG_HIDDEN);
        cal_status("\xD0\x95\xD0\xB4\xD1\x83 \xD0\xB2\xD0\xBF\xD0\xB5\xD1\x80\xD1\x91\xD0\xB4 \xD0\xBD\xD0\xB0 \xD1\x85\xD0\xBE\xD0\xB4...", 0x6a9fb5);
        cal_send_step(2);
    }, LV_EVENT_CLICKED, nullptr);

    lv_obj_t* stop = cfg_button(back, "\xD0\xA1\xD0\xA2\xD0\x9E\xD0\x9F", 0x3a1010, 0xff7070);   // СТОП
    lv_obj_set_size(stop, BW, BH); lv_obj_set_pos(stop, UX(170), BY);
    lv_obj_add_event_cb(stop, [](lv_event_t*) { uart_protocol.sendButtonPress("CAL_STOP"); }, LV_EVENT_CLICKED, nullptr);

    lv_obj_t* close_btn = cfg_button(back, "\xD0\x97\xD0\x90\xD0\x9A\xD0\xA0\xD0\xAB\xD0\xA2\xD0\xAC", 0x2a1a1a, 0xa08080);   // ЗАКРЫТЬ
    lv_obj_set_size(close_btn, BW, BH); lv_obj_set_pos(close_btn, UX(324), BY);
    lv_obj_add_event_cb(close_btn, [](lv_event_t*) { cal_close(); }, LV_EVENT_CLICKED, nullptr);
    cal_method_refresh();
}

// ============================================================================
// Раздел «НАСТРОЙКИ» (тап по ⚠): механика, калибровка, Wi-Fi; внизу крупно — адрес точки доступа.
// Wi-Fi: сеть роутера задаётся здесь (хранится в памяти дисплея), поиск сетей, «забыть» — только точка доступа.
// ============================================================================
static void cfg_open();
struct HubUi { lv_obj_t* ov; lv_obj_t* info; lv_obj_t* addr; };
static HubUi g_hub = {};

static void hub_refresh()
{
    char b[96];
    const char* ip = GCodeWiFi_GetIP();
    if (!GCodeWiFi_IsAP() && !GCodeWiFi_IsConnected() && GCodeWiFi_GetStaSsid()[0]) {
        snprintf(b, sizeof(b), "%s %s...", "\xD0\x9F\xD0\xBE\xD0\xB4\xD0\xBA\xD0\xBB\xD1\x8E\xD1\x87\xD0\xB5\xD0\xBD\xD0\xB8\xD0\xB5 \xD0\xBA", GCodeWiFi_GetStaSsid());
    } else if (GCodeWiFi_IsAP() || !GCodeWiFi_GetStaSsid()[0]) {
        snprintf(b, sizeof(b), "%s %s   %s %s", "\xD0\xA1\xD0\xB5\xD1\x82\xD1\x8C:", GCodeWiFi_GetApSsid(), "\xD0\xBF\xD0\xB0\xD1\x80\xD0\xBE\xD0\xBB\xD1\x8C:", GCodeWiFi_GetApPass());
    } else {
        snprintf(b, sizeof(b), "%s %s", "\xD0\xA0\xD0\xBE\xD1\x83\xD1\x82\xD0\xB5\xD1\x80:", GCodeWiFi_GetStaSsid());
    }
    lv_label_set_text(g_hub.info, b);
    snprintf(b, sizeof(b), "http://%s", (ip && *ip) ? ip : "...");
    lv_label_set_text(g_hub.addr, b);
}

static void hub_tick(lv_timer_t*)
{
    if (g_hub.ov && !lv_obj_has_flag(g_hub.ov, LV_OBJ_FLAG_HIDDEN)) hub_refresh();
}

static void hub_open()
{
    if (g_ui.alert_box && !lv_obj_has_flag(g_ui.alert_box, LV_OBJ_FLAG_HIDDEN)) dismiss_alert();
    hub_refresh();
    lv_obj_clear_flag(g_hub.ov, LV_OBJ_FLAG_HIDDEN);
}

// ── Wi-Fi: сеть роутера ─────────────────────────────────────────────────────
struct WifiUi { lv_obj_t* back; lv_obj_t* status; lv_obj_t* ssid; lv_obj_t* pass; lv_obj_t* kb; lv_obj_t* list; int shown_scan; };
static WifiUi g_wifi = {};

static void wifi_close()
{
    if (g_wifi.back) { lv_obj_del(g_wifi.back); g_wifi.back = nullptr; }
}

static void wifi_list_fill()
{
    lv_obj_clean(g_wifi.list);
    int n = GCodeWiFi_ScanCount();
    g_wifi.shown_scan = n;
    if (n < 0) { lv_list_add_text(g_wifi.list, "\xD0\x9F\xD0\xBE\xD0\xB8\xD1\x81\xD0\xBA \xD1\x81\xD0\xB5\xD1\x82\xD0\xB5\xD0\xB9..."); return; }
    if (n == 0) { lv_list_add_text(g_wifi.list, "\xD0\xA1\xD0\xB5\xD1\x82\xD0\xB8 \xD0\xBD\xD0\xB5 \xD0\xBD\xD0\xB0\xD0\xB9\xD0\xB4\xD0\xB5\xD0\xBD\xD1\x8B"); return; }
    for (int i = 0; i < n; i++) {
        lv_obj_t* b = lv_list_add_btn(g_wifi.list, nullptr, GCodeWiFi_ScanSsid(i));
        lv_obj_set_style_text_font(b, &font_dejavu_16, 0);
        lv_obj_add_event_cb(b, [](lv_event_t* e) {
            lv_obj_t* btn = lv_event_get_target(e);
            lv_textarea_set_text(g_wifi.ssid, lv_list_get_btn_text(g_wifi.list, btn));
            lv_textarea_set_text(g_wifi.pass, "");
            lv_obj_add_state(g_wifi.pass, LV_STATE_FOCUSED);
            lv_obj_clear_state(g_wifi.ssid, LV_STATE_FOCUSED);
            lv_keyboard_set_textarea(g_wifi.kb, g_wifi.pass);
            lv_obj_add_flag(g_wifi.list, LV_OBJ_FLAG_HIDDEN);
            lv_obj_clear_flag(g_wifi.kb, LV_OBJ_FLAG_HIDDEN);
        }, LV_EVENT_CLICKED, nullptr);
    }
}

static void wifi_tick(lv_timer_t*)
{
    if (!g_wifi.back) return;
    char b[96];
    const char* sta = GCodeWiFi_GetStaSsid();
    if (GCodeWiFi_IsConnected() && !GCodeWiFi_IsAP() && sta[0])
        snprintf(b, sizeof(b), "\xD0\x9F\xD0\xBE\xD0\xB4\xD0\xBA\xD0\xBB\xD1\x8E\xD1\x87\xD0\xB5\xD0\xBD\xD0\xBE \xD0\xBA %s: http://%s", sta, GCodeWiFi_GetIP());
    else if (sta[0] && GCodeWiFi_IsAP())
        snprintf(b, sizeof(b), "%s %s %s", "\xD0\xA0\xD0\xBE\xD1\x83\xD1\x82\xD0\xB5\xD1\x80", sta, "\xD0\xBD\xD0\xB5\xD0\xB4\xD0\xBE\xD1\x81\xD1\x82\xD1\x83\xD0\xBF\xD0\xB5\xD0\xBD, \xD1\x80\xD0\xB0\xD0\xB1\xD0\xBE\xD1\x82\xD0\xB0\xD0\xB5\xD1\x82 \xD1\x82\xD0\xBE\xD1\x87\xD0\xBA\xD0\xB0 \xD0\xB4\xD0\xBE\xD1\x81\xD1\x82\xD1\x83\xD0\xBF\xD0\xB0");
    else if (sta[0])
        snprintf(b, sizeof(b), "\xD0\x9F\xD0\xBE\xD0\xB4\xD0\xBA\xD0\xBB\xD1\x8E\xD1\x87\xD0\xB5\xD0\xBD\xD0\xB8\xD0\xB5 \xD0\xBA %s...", sta);
    else
        snprintf(b, sizeof(b), "\xD0\xA0\xD0\xBE\xD1\x83\xD1\x82\xD0\xB5\xD1\x80 \xD0\xBD\xD0\xB5 \xD0\xB7\xD0\xB0\xD0\xB4\xD0\xB0\xD0\xBD: \xD1\x80\xD0\xB0\xD0\xB1\xD0\xBE\xD1\x82\xD0\xB0\xD0\xB5\xD1\x82 \xD1\x82\xD0\xBE\xD0\xBB\xD1\x8C\xD0\xBA\xD0\xBE \xD1\x82\xD0\xBE\xD1\x87\xD0\xBA\xD0\xB0 \xD0\xB4\xD0\xBE\xD1\x81\xD1\x82\xD1\x83\xD0\xBF\xD0\xB0");
    lv_label_set_text(g_wifi.status, b);
    if (GCodeWiFi_ScanCount() != g_wifi.shown_scan) wifi_list_fill();
}

static lv_obj_t* wifi_ta(lv_obj_t* parent, int y, bool password)
{
    lv_obj_t* ta = lv_textarea_create(parent);
    lv_textarea_set_one_line(ta, true);
    lv_textarea_set_password_mode(ta, password);
    lv_textarea_set_max_length(ta, password ? 64 : 32);
    lv_obj_set_size(ta, UX(236), UY(30));
    lv_obj_set_pos(ta, UX(96), y);
    lv_obj_set_style_text_font(ta, &font_dejavu_16, 0);
    lv_obj_set_style_bg_color(ta, lv_color_hex(0x10202c), 0);
    lv_obj_set_style_text_color(ta, lv_color_hex(0xe0e0e0), 0);
    lv_obj_set_style_border_color(ta, lv_color_hex(0x3a5a6a), 0);
    lv_obj_add_event_cb(ta, [](lv_event_t* e) {
        lv_obj_t* t = lv_event_get_target(e);
        lv_keyboard_set_textarea(g_wifi.kb, t);
        lv_obj_add_flag(g_wifi.list, LV_OBJ_FLAG_HIDDEN);
        lv_obj_clear_flag(g_wifi.kb, LV_OBJ_FLAG_HIDDEN);
    }, LV_EVENT_FOCUSED, nullptr);
    return ta;
}

static void wifi_show()
{
    wifi_close();
    lv_obj_t* back = lv_obj_create(lv_layer_top());
    g_wifi.back = back;
    lv_obj_set_size(back, SCREEN_WIDTH, SCREEN_HEIGHT);
    lv_obj_set_pos(back, 0, 0);
    lv_obj_set_style_bg_color(back, lv_color_hex(0x000814), 0);
    lv_obj_set_style_bg_opa(back, LV_OPA_COVER, 0);
    lv_obj_set_style_border_width(back, 0, 0);
    lv_obj_set_style_radius(back, 0, 0);
    lv_obj_set_style_pad_all(back, 0, 0);
    lv_obj_clear_flag(back, LV_OBJ_FLAG_SCROLLABLE);

    lv_obj_t* title = lv_label_create(back);
    lv_obj_set_pos(title, UX(16), UY(6));
    lv_obj_set_style_text_color(title, lv_color_hex(0x00d4ff), 0);
    lv_obj_set_style_text_font(title, &font_tahoma_bold_22, 0);
    lv_label_set_text(title, "WI-FI: \xD0\xA1\xD0\x95\xD0\xA2\xD0\xAC \xD0\xA0\xD0\x9E\xD0\xA3\xD0\xA2\xD0\x95\xD0\xA0\xD0\x90");

    lv_obj_t* close_btn = cfg_button(back, "\xD0\x97\xD0\x90\xD0\x9A\xD0\xA0\xD0\xAB\xD0\xA2\xD0\xAC", 0x2a1a1a, 0xa08080);
    lv_obj_set_size(close_btn, UX(110), UY(28)); lv_obj_set_pos(close_btn, UX(354), UY(4));
    lv_obj_add_event_cb(close_btn, [](lv_event_t*) { wifi_close(); }, LV_EVENT_CLICKED, nullptr);

    g_wifi.status = lv_label_create(back);
    lv_obj_set_width(g_wifi.status, UX(448));
    lv_obj_set_pos(g_wifi.status, UX(16), UY(36));
    lv_obj_set_style_text_font(g_wifi.status, &font_dejavu_14, 0);
    lv_obj_set_style_text_color(g_wifi.status, lv_color_hex(0x6a9fb5), 0);
    lv_label_set_long_mode(g_wifi.status, LV_LABEL_LONG_DOT);

    const char* names[2] = { "\xD0\xA1\xD0\xB5\xD1\x82\xD1\x8C", "\xD0\x9F\xD0\xB0\xD1\x80\xD0\xBE\xD0\xBB\xD1\x8C" };
    for (int i = 0; i < 2; i++) {
        lv_obj_t* n = lv_label_create(back);
        lv_obj_set_style_text_font(n, &font_dejavu_16, 0);
        lv_obj_set_style_text_color(n, lv_color_hex(0x9ab8c8), 0);
        lv_label_set_text(n, names[i]);
        lv_obj_set_pos(n, UX(16), UY(60) + i * UY(34) + UY(6));
    }
    g_wifi.ssid = wifi_ta(back, UY(60), false);
    g_wifi.pass = wifi_ta(back, UY(94), true);
    lv_textarea_set_text(g_wifi.ssid, GCodeWiFi_GetStaSsid());

    lv_obj_t* scan = cfg_button(back, "\xD0\x9F\xD0\x9E\xD0\x98\xD0\xA1\xD0\x9A", 0x1a2a3a, 0x00d4ff);
    lv_obj_set_size(scan, UX(124), UY(30)); lv_obj_set_pos(scan, UX(340), UY(60));
    lv_obj_add_event_cb(scan, [](lv_event_t*) {
        GCodeWiFi_Scan();
        lv_obj_add_flag(g_wifi.kb, LV_OBJ_FLAG_HIDDEN);
        lv_obj_clear_flag(g_wifi.list, LV_OBJ_FLAG_HIDDEN);
        wifi_list_fill();
    }, LV_EVENT_CLICKED, nullptr);

    lv_obj_t* conn = cfg_button(back, "\xD0\x9F\xD0\x9E\xD0\x94\xD0\x9A\xD0\x9B\xD0\xAE\xD0\xA7\xD0\x98\xD0\xA2\xD0\xAC", 0x0a3a2a, 0x00ff88);
    lv_obj_set_size(conn, UX(124), UY(30)); lv_obj_set_pos(conn, UX(340), UY(94));
    lv_obj_set_style_text_font(lv_obj_get_child(conn, 0), &font_dejavu_14, 0);   // ПОДКЛЮЧИТЬ — длинное слово
    lv_obj_add_event_cb(conn, [](lv_event_t*) {
        GCodeWiFi_SetSta(lv_textarea_get_text(g_wifi.ssid), lv_textarea_get_text(g_wifi.pass));
        lv_obj_add_flag(g_wifi.kb, LV_OBJ_FLAG_HIDDEN);
    }, LV_EVENT_CLICKED, nullptr);

    // ЗАБЫТЬ — раньше клавиатуры: открытая клавиатура её закрывает
    lv_obj_t* forget = cfg_button(back, "\xD0\x97\xD0\x90\xD0\x91\xD0\xAB\xD0\xA2\xD0\xAC (\xD0\xB4\xD0\xB5\xD1\x80\xD0\xB6\xD0\xB0\xD1\x82\xD1\x8C)", 0x2a1a1a, 0xa08080);
    lv_obj_set_size(forget, UX(220), UY(28)); lv_obj_set_pos(forget, UX(16), UY(238));
    lv_obj_add_event_cb(forget, [](lv_event_t*) {               // держать — только точка доступа
        GCodeWiFi_SetSta("", "");
        lv_textarea_set_text(g_wifi.ssid, "");
        lv_textarea_set_text(g_wifi.pass, "");
    }, LV_EVENT_LONG_PRESSED, nullptr);

    // Нижняя часть: список найденных сетей или клавиатура (пока поле в фокусе)
    g_wifi.list = lv_list_create(back);
    lv_obj_set_size(g_wifi.list, UX(448), UY(100));
    lv_obj_set_pos(g_wifi.list, UX(16), UY(132));
    lv_obj_set_style_bg_color(g_wifi.list, lv_color_hex(0x0a1622), 0);
    lv_obj_set_style_text_font(g_wifi.list, &font_dejavu_16, 0);
    g_wifi.kb = lv_keyboard_create(back);
    lv_obj_set_size(g_wifi.kb, SCREEN_WIDTH, UY(136));
    lv_obj_align(g_wifi.kb, LV_ALIGN_BOTTOM_MID, 0, 0);
    lv_obj_set_style_text_font(g_wifi.kb, &lv_font_montserrat_20, 0);
    lv_obj_add_flag(g_wifi.kb, LV_OBJ_FLAG_HIDDEN);
    lv_obj_add_event_cb(g_wifi.kb, [](lv_event_t*) {          // ✓ или ✕ на клавиатуре — спрятать
        lv_obj_add_flag(g_wifi.kb, LV_OBJ_FLAG_HIDDEN);
        lv_obj_clear_flag(g_wifi.list, LV_OBJ_FLAG_HIDDEN);
    }, LV_EVENT_READY, nullptr);
    lv_obj_add_event_cb(g_wifi.kb, [](lv_event_t*) {
        lv_obj_add_flag(g_wifi.kb, LV_OBJ_FLAG_HIDDEN);
        lv_obj_clear_flag(g_wifi.list, LV_OBJ_FLAG_HIDDEN);
    }, LV_EVENT_CANCEL, nullptr);


    g_wifi.shown_scan = -2;
    wifi_tick(nullptr);
    if (GCodeWiFi_ScanCount() < 0) GCodeWiFi_Scan();   // первый поиск — сразу
}

// ── Линейки: источник координат, тип, разрешение, направление (BACKLOG-028) ──
// Сохранение — POS_SET: STM32 пишет во флеш и перезапускается (прерывания линеек настраиваются при старте).
struct ScalesUi { lv_obj_t* back; lv_obj_t* src[3]; lv_obj_t* val[8]; lv_obj_t* opt[2]; lv_obj_t* status; int32_t edit[12]; bool dirty; uint8_t seen_seq; };
static ScalesUi g_sc = {};
static const char* const SCALE_TYPES[6] = { "\xD0\x9D\xD0\x95\xD0\xA2", "\xD0\x9A\xD0\xB2\xD0\xB0\xD0\xB4\xD1\x80\xD0\xB0\xD1\x82\xD1\x83\xD1\x80\xD0\xB0", "Sylvac 48", "BIN6", "iGaging 21", "Digimatic" };

static void scales_close() { if (g_sc.back) { lv_obj_del(g_sc.back); g_sc.back = nullptr; } }

static void scales_refresh()
{
    const LatheData& d = uart_protocol.getData();
    for (int i = 0; i < 3; i++) {
        bool on = g_sc.edit[0] == i;
        lv_obj_set_style_bg_color(g_sc.src[i], lv_color_hex(on ? 0x0a3a2a : 0x10202c), 0);
        lv_obj_set_style_text_color(lv_obj_get_child(g_sc.src[i], 0), lv_color_hex(on ? 0x00ff88 : 0x6a9fb5), 0);
    }
    for (int ax = 0; ax < 2; ax++) {
        const int32_t* e = &g_sc.edit[1 + ax * 4];
        char b[24];
        lv_label_set_text(g_sc.val[ax * 4 + 0], SCALE_TYPES[e[0] >= 0 && e[0] < 6 ? e[0] : 0]);
        snprintf(b, sizeof(b), "%ld.%03ld", (long)(e[1] / 1000), (long)(e[1] % 1000));       // мкм на импульс
        lv_label_set_text(g_sc.val[ax * 4 + 1], b);
        lv_label_set_text(g_sc.val[ax * 4 + 2], e[2] ? "\xD0\x9E\xD0\x91\xD0\xA0\xD0\x90\xD0\xA2\xD0\x9D\xD0\x9E\xD0\x95" : "\xD0\x9F\xD0\xA0\xD0\xAF\xD0\x9C\xD0\x9E\xD0\x95");
        lv_label_set_text(g_sc.val[ax * 4 + 3], e[3] ? "\xD0\x98\xD0\x9D\xD0\x92\xD0\x95\xD0\xA0\xD0\xA1\xD0\x9D\xD0\xAB\xD0\x99" : "\xD0\x9F\xD0\xA0\xD0\xAF\xD0\x9C\xD0\x9E\xD0\x99");
        for (int k = 0; k < 4; k++)
            lv_obj_set_style_text_color(g_sc.val[ax * 4 + k], lv_color_hex(
                (d.pos_valid && e[k] != d.pos_cfg[1 + ax * 4 + k]) ? 0xffcc00 :
                g_sc.edit[0] == 2 ? 0xe0e0e0 : 0x5a6a7a), 0);
    }
    // ДОВОДКА X / КОНТРОЛЬ ШАГОВ (BACKLOG-025) — работают с блоком DRO и с линейками
    static const char* OPT[2] = { "\xD0\x94\xD0\x9E\xD0\x92\xD0\x9E\xD0\x94\xD0\x9A\xD0\x90 X", "\xD0\x9A\xD0\x9E\xD0\x9D\xD0\xA2\xD0\xA0\xD0\x9E\xD0\x9B\xD0\xAC \xD0\xA8\xD0\x90\xD0\x93\xD0\x9E\xD0\x92" };
    for (int i = 0; i < 2; i++) {
        char b[48];
        bool on = g_sc.edit[9 + i] != 0;
        snprintf(b, sizeof(b), "%s: %s", OPT[i], on ? "\xD0\x92\xD0\x9A\xD0\x9B" : "\xD0\x92\xD0\xAB\xD0\x9A\xD0\x9B");
        lv_obj_t* l = lv_obj_get_child(g_sc.opt[i], 0);
        lv_label_set_text(l, b);
        bool changed = d.pos_valid && g_sc.edit[9 + i] != d.pos_cfg[9 + i];
        lv_obj_set_style_text_color(l, lv_color_hex(changed ? 0xffcc00 : g_sc.edit[0] == 0 ? 0x5a6a7a : on ? 0x00ff88 : 0x9ab8c8), 0);
    }
}

static void scales_tick(lv_timer_t*)
{
    if (!g_sc.back) return;
    const LatheData& d = uart_protocol.getData();
    if (d.cfg_res_seq != g_sc.seen_seq) {
        g_sc.seen_seq = d.cfg_res_seq;
        bool ok = !strcmp(d.cfg_res, "OK");
        lv_label_set_text(g_sc.status, ok ? "\xD0\xA1\xD0\x9E\xD0\xA5\xD0\xA0\xD0\x90\xD0\x9D\xD0\x95\xD0\x9D\xD0\x9E, \xD0\x9F\xD0\x95\xD0\xA0\xD0\x95\xD0\x97\xD0\x90\xD0\x9F\xD0\xA3\xD0\xA1\xD0\x9A" : d.cfg_res);
        lv_obj_set_style_text_color(g_sc.status, lv_color_hex(ok ? 0x00ff88 : 0xff5555), 0);
        if (ok) g_sc.dirty = false;
    }
    if (!g_sc.dirty && d.pos_valid) memcpy(g_sc.edit, d.pos_cfg, sizeof(g_sc.edit));
    scales_refresh();
}

static void scales_changed() { g_sc.dirty = true; lv_label_set_text(g_sc.status, "\xD0\x9D\xD0\x95 \xD0\xA1\xD0\x9E\xD0\xA5\xD0\xA0\xD0\x90\xD0\x9D\xD0\x95\xD0\x9D\xD0\x9E");
                               lv_obj_set_style_text_color(g_sc.status, lv_color_hex(0xffcc00), 0); scales_refresh(); }
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
void loop()
{
    // Process UART commands
    uart_protocol.process();
    GCodeWiFi_Process();
    GCodeExec_Process();

    // Авто-выход из режима редактирования через 5 секунд бездействия
    // Пока открыт барабан — не выходить: его закрывают только его кнопки (иначе барабан оставался висеть
    // поверх экрана без режима правки)
    if (g_edit_param.active && !g_roller.active && (millis() - g_edit_param.last_ms > 5000)) {
        exit_edit_mode();
    }
    // Авто-выход из sub-edit (редактирование строки правой панели) через 5 секунд
    if (g_sub_edit.active && !g_roller.active && (millis() - g_sub_edit.last_ms > 5000)) {
        exit_sub_edit();
    }

    // Авто-скрытие алерта через 5 секунд (кроме флагов ошибки ядра — их закрывает STM32)
    if (g_alert.active && !g_alert.sticky && (millis() - g_alert.show_ms > 5000)) {
        dismiss_alert();
    }

    // Авто-закрытие джойстик-оверлея через 30 секунд бездействия (US-013)
    if (g_joystick.active && (millis() - g_joystick.last_ms > 30000)) {
        hide_joystick_overlay();
    }

    // Update LVGL tick — use actual elapsed time so LVGL refresh runs at real-time rate.
    // Fixed lv_tick_inc(5) caused ~1-2 sec display lag: if lv_timer_handler() takes
    // ~200ms, LVGL only advanced 5ms per 200ms real time → 30ms refresh needed 6 iters
    // × 200ms = 1.2 s between renders.
    {
        static uint32_t lv_last_tick_ms = 0;
        uint32_t lv_now = millis();
        lv_tick_inc(lv_now - lv_last_tick_ms);
        lv_last_tick_ms = lv_now;
    }

    // Process LVGL (timing measured for diagnosis)
    {
        static uint32_t dbg_last = 0, dbg_max = 0, dbg_loops = 0;
        uint32_t t0 = millis();
        lv_timer_handler();
        uint32_t dt = millis() - t0;
        if (dt > dbg_max) dbg_max = dt;
        dbg_loops++;
        if (t0 - dbg_last >= 2000) {
            // lv_mem_free — только для встроенного пула LVGL (4.3"); на 10.1" память LVGL в PSRAM
            lv_mem_monitor_t mon;
            lv_mem_monitor(&mon);
            Serial.printf("[DBG] loops/2s=%lu lv_max=%lums lv_mem_free=%u heap=%u psram=%u\n",
                          (unsigned long)dbg_loops, (unsigned long)dbg_max,
                          (unsigned)mon.free_size, (unsigned)ESP.getFreeHeap(),
                          (unsigned)ESP.getFreePsram());
            dbg_last = t0; dbg_max = 0; dbg_loops = 0;
        }
    }

#if defined(DISPLAY_JC4827W543) || defined(DISPLAY_JC8012P4A1C) || defined(DISPLAY_JC1060P470)
#ifdef DISPLAY_JC4827W543
    // Проверяем HTTP screenshot сервер
    handle_screenshot_server();
#endif

    // USB CDC Screenshot state machine
    // Протокол: PC шлёт 'S' → ESP32 отвечает {0xDE,0xAD,0xBE,0xEF} + 4-byte LE size + JPEG
    {
        static uint8_t  usb_ss_state = 0;

        if (usb_ss_state == 0) {
            // USB CDC (закрой Serial Monitor перед использованием!):
            //   'S'          → скриншот
            //   <BTN:name>   → <TOUCH:name> в STM32 (как нажатие на экране)
            //   <TAP:x,y[,мс]> → имитация касания, x/y в координатах базы 480×272
            //   <UIDUMP>     → тексты виджетов в [UI]-строку (автотесты)
            //   <RXMUTE:0|1> → игнорировать данные от STM32 (автотесты)
            //   <UIRESET>    → закрыть барабан, правку, проверку тача, сообщение (автотесты)
            //   <TOUCHTEST:1|0> → экран проверки тача (9 мишеней, промахи — в USB)
            //   <CMD:val>    → обработать как команду от STM32
            static char    usb_inj_buf[128];
            static uint8_t usb_inj_len = 0;
            while (Serial.available() >= 1) {
                char c = (char)Serial.read();
                if (usb_inj_len > 0) {
                    if (usb_inj_len < sizeof(usb_inj_buf) - 1) usb_inj_buf[usb_inj_len++] = c;
                    if (c == '>') {
                        usb_inj_buf[usb_inj_len - 1] = '\0';  // без '>'
                        int tx, ty, tms = 120;
                        if (strncmp(usb_inj_buf, "<GCLINE:", 8) == 0) {      // стенд: строка G-кода в STM32
                            uart_protocol.sendGCodeLine(usb_inj_buf + 8);
                            Serial.printf("[GCLINE→STM32] %s\n", usb_inj_buf + 8);
                        } else if (strncmp(usb_inj_buf, "<BTN:", 5) == 0) {
                            uart_protocol.sendButtonPress(usb_inj_buf + 5);
                            Serial.printf("[BTN→STM32] TOUCH:%s\n", usb_inj_buf + 5);
                        } else if (sscanf(usb_inj_buf, "<TAP:%d,%d,%d", &tx, &ty, &tms) >= 2) {
                            sim_tap(UX(tx), UY(ty), tms);
                            Serial.printf("[TAP] %d,%d %d мс\n", tx, ty, tms);
                        } else if (strcmp(usb_inj_buf, "<UIDUMP") == 0) {
                            ui_dump();
                        } else if (strcmp(usb_inj_buf, "<UIRESET") == 0) {      // автотесты: закрыть всё временное
                            close_roller(false);
                            if (g_edit_param.active) exit_edit_mode();
                            exit_sub_edit();
                            if (g_tt) touchtest_close();
                            if (g_alert.active) dismiss_alert();
                            Serial.println("[UIRESET]");
                        } else if (sscanf(usb_inj_buf, "<TOUCHTEST:%d", &tx) == 1) {
                            if (tx) touchtest_open(); else touchtest_close();
                        } else if (sscanf(usb_inj_buf, "<RXMUTE:%d", &tx) == 1) {
                            uart_protocol.setRxMute(tx != 0);
                            Serial.printf("[RXMUTE] %d\n", tx);
                        } else {
                            usb_inj_buf[usb_inj_len - 1] = '>';
                            usb_inj_buf[usb_inj_len] = '\0';
                            uart_protocol.injectCmd(usb_inj_buf);
                            Serial.printf("[INJ] %s\n", usb_inj_buf);
                        }
                        usb_inj_len = 0;
                    } else if (c == '\n' || c == '\r') {
                        usb_inj_len = 0;
                    }
                } else if (c == 'S') {
                    if (sem_requested) { xSemaphoreGive(sem_requested); usb_ss_state = 1; }
                    break;
                } else if (c == '<') {
                    usb_inj_buf[0] = c; usb_inj_len = 1;
                }
            }
        } else if (usb_ss_state == 1) {
            // Ждём завершения захвата (неблокирующе)
            if (sem_done && xSemaphoreTake(sem_done, 0) == pdTRUE) {
                if (jpeg_size > 0) {
                    uint8_t hdr[8] = {
                        0xDE, 0xAD, 0xBE, 0xEF,
                        (uint8_t)(jpeg_size),
                        (uint8_t)(jpeg_size >> 8),
                        (uint8_t)(jpeg_size >> 16),
                        (uint8_t)(jpeg_size >> 24)
                    };
                    // Весь кадр одной операцией: иначе между кусками в поток USB
                    // вклиниваются [STATE]/[DBG] из следующих итераций loop() и JPEG ломается
                    Serial.write(hdr, 8);
                    Serial.write(jpeg_buf, jpeg_size);
                    Serial.flush();  // сбросить USB CDC буфер (иначе последние ~64 байта теряются)
                }
                usb_ss_state = 0;
            }
        }
    }
#endif  // DISPLAY_JC4827W543 || DISPLAY_JC8012P4A1C

#if !defined(DISPLAY_JC8012P4A1C) && !defined(DISPLAY_JC1060P470)
    delay(5);
#endif
}
