tepmehatop/Lathe-cnc-controller-stm32/Core/els_control.cpp

/**
 * @file  els_control.cpp
 * @brief Замкнутый контур ELS — Этап 8
 *
 * Читает шпиндельный RPM и режим из els_state, вычисляет требуемую
 * скорость шагового двигателя и управляет drv_stepper.
 *
 * Режимы:
 *   MODE_FEED    — подача мм/об: step_hz = RPM × feed_mm × steps/mm / 60
 *   MODE_AFEED   — асинхронная подача мм/мин: step_hz = afeed_mm × steps/mm / 60
 *   MODE_THREAD  — нарезка резьбы: step_hz = RPM × pitch_mm × steps/mm / 60
 *   MODE_CONE    — конус (Y+X пропорционально) — TODO Этап 8.2
 *
 * Единицы ELS:
 *   feed        = мм/об × 100   (10 = 0.10 мм/об)
 *   afeed       = мм/мин × 100  (100 = 1.00 мм/мин)
 *   thread_pitch = 0.001 мм     (1000 = 1.000 мм)
 *   pos_y, pos_x = 0.001 мм
 *
 * Масштаб шагового: steps/mm
 *   Y: (MOTOR_Y_STEP_PER_REV × MICROSTEP_Y × 100) / SCREW_Y
 *   X: (MOTOR_X_STEP_PER_REV × MICROSTEP_X × 100) / SCREW_X
 */

#include "els_control.h"
#include "els_state.h"
#include "els_config.h"
#include "els_tables.h"
#include "../Drivers/drv_stepper.h"
#include "../Drivers/drv_encoder.h"
#include "../Drivers/drv_display.h"
#include "../Drivers/drv_beeper.h"
#include <Arduino.h>
#include <stdlib.h>
#include <math.h>

// Шагов на 1 тик энкодера: STEP_PER_REV × MICROSTEP / SCREW (SCREW в 0.01мм)
// Y: 200 × 4 / 200 = 4  (целое)
// X: 200 × 4 / 125 = 6.4 → дробная часть компенсируется аккумулятором × 10
#define HC_STEPS_PER_TICK_Y   ((MOTOR_Y_STEP_PER_REV * MICROSTEP_Y) / SCREW_Y)
#define HC_STEPS10_PER_TICK_Y (HC_STEPS_PER_TICK_Y * 10)   // для X: ×10 фиксированная точка
#define HC_STEPS10_PER_TICK_X ((MOTOR_X_STEP_PER_REV * MICROSTEP_X * 10) / SCREW_X)

// ============================================================
// Константы масштабирования
// ============================================================
// steps/mm × 1000 для избежания float
// = (STEP_PER_REV × MICROSTEP × 100) / SCREW
#define STEPS_PER_MM_Y  \
    ((uint32_t)(MOTOR_Y_STEP_PER_REV) * MICROSTEP_Y * 100UL / SCREW_Y)
#define STEPS_PER_MM_X  \
    ((uint32_t)(MOTOR_X_STEP_PER_REV) * MICROSTEP_X * 100UL / SCREW_X)

// Минимальный RPM для начала движения
#define MIN_RPM_FOR_SYNC    10

// Гистерезис: пересчитывать speed_hz если изменилась более чем на N%
#define SPEED_HYSTERESIS_PCT 3

// Скорость подачи по джойстику (RAPID нажат):
// hz = Feed_mm × STEPS_PER_MM / 100  (= Feed_mm/rev × 60rpm × steps/mm / 60)
// Минимум 10 Гц чтобы мотор не стоял на месте
#define JOY_FEED_HZ_MIN     10

// ============================================================
// Внутреннее состояние
// ============================================================
static uint32_t s_last_speed_y = 0;
static uint32_t s_last_speed_x = 0;
static int8_t   s_last_dir_y   = 0;
static int8_t   s_last_dir_x   = 0;

// Ручной энкодер: накопленные шаги (целые) + дробная часть для X (× 10)
static int32_t s_hc_acc_y   = 0;
static int32_t s_hc_acc_x   = 0;
static int32_t s_hc_frac_x  = 0;  // дробный остаток × 10

// ============================================================
// Вспомогательные
// ============================================================

// Обновить скорость оси: запустить если не движется, сменить скорость если движется
static void _apply_speed(Axis_t axis, uint32_t speed_hz, int8_t dir,
                         uint32_t *last_speed, int8_t *last_dir) {
    if (speed_hz == 0) {
        if (DRV_Stepper_IsMoving(axis)) DRV_Stepper_Stop(axis);
        *last_speed = 0;
        return;
    }

    // Смена направления → перезапуск
    if (dir != *last_dir && DRV_Stepper_IsMoving(axis)) {
        DRV_Stepper_Stop(axis);
        *last_speed = 0;
    }

    if (!DRV_Stepper_IsMoving(axis)) {
        DRV_Stepper_SetContinuous(axis, speed_hz, dir);
        *last_speed = speed_hz;
        *last_dir   = dir;
        return;
    }

    // Уже движемся: обновляем скорость если изменилась больше гистерезиса
    if (*last_speed > 0) {
        uint32_t delta = (speed_hz > *last_speed) ?
                          speed_hz - *last_speed : *last_speed - speed_hz;
        uint32_t thresh = *last_speed * SPEED_HYSTERESIS_PCT / 100u;
        if (delta > thresh) {
            DRV_Stepper_SetSpeed(axis, speed_hz);
            *last_speed = speed_hz;
        }
    }
}

// Проверить лимиты: если позиция вышла за лимит → Stop
static void _check_limits(void) {
    if (!els.limits_enabled) return;

    if (els.pos_y <= els.limit_y_left  && DRV_Stepper_IsMoving(AXIS_Y) && s_last_dir_y < 0) {
        ELS_Control_Stop();
    }
    if (els.pos_y >= els.limit_y_right && DRV_Stepper_IsMoving(AXIS_Y) && s_last_dir_y > 0) {
        ELS_Control_Stop();
    }
    if (els.pos_x <= els.limit_x_front && DRV_Stepper_IsMoving(AXIS_X) && s_last_dir_x < 0) {
        ELS_Control_Stop();
    }
    if (els.pos_x >= els.limit_x_rear  && DRV_Stepper_IsMoving(AXIS_X) && s_last_dir_x > 0) {
        ELS_Control_Stop();
    }
}

// ============================================================
// Вычисление step_hz по режиму
// ============================================================

// MODE_FEED / MODE_THREAD: step_hz = RPM × pitch_mm × steps/mm / 60
// feed в мм/об × 100 → pitch_mm = feed / 100.0
// thread_pitch в 0.001мм → pitch_mm = thread_pitch / 1000.0
// Используем integer math: × 1000 / 1000
static uint32_t _calc_sync_hz(int32_t rpm, int32_t pitch_001mm, uint32_t steps_per_mm) {
    if (rpm <= 0 || pitch_001mm <= 0) return 0;
    // step_hz = rpm × pitch_mm × steps_per_mm / 60
    //         = rpm × pitch_001mm × steps_per_mm / (1000 × 60)
    // Используем int64 чтобы не переполниться
    int64_t hz = (int64_t)rpm * (int64_t)pitch_001mm * (int64_t)steps_per_mm / 60000LL;
    if (hz < 1)      return 0;
    if (hz > 50000)  return 50000; // Аппаратный предел: 50 кГц
    return (uint32_t)hz;
}

// MODE_AFEED: step_hz = afeed_mm_per_min × steps_per_mm / 60
// afeed в мм/мин × 100
static uint32_t _calc_afeed_hz(int32_t afeed_100, uint32_t steps_per_mm) {
    if (afeed_100 <= 0) return 0;
    // step_hz = (afeed_100 / 100) × steps_per_mm / 60
    //         = afeed_100 × steps_per_mm / 6000
    int64_t hz = (int64_t)afeed_100 * (int64_t)steps_per_mm / 6000LL;
    if (hz < 1)      return 0;
    if (hz > 50000)  return 50000;
    return (uint32_t)hz;
}

// ============================================================
// Вычисление Hz для ручного движения по джойстику
// ============================================================

// Быстрый ход Y (RAPID кнопка НЕ нажата)
static inline uint32_t _joy_rapid_hz_y(void) {
    return RAPID_TRAVERSE_HZ;
}

// Быстрый ход X
static inline uint32_t _joy_rapid_hz_x(void) {
    return RAPID_TRAVERSE_HZ;
}

// Подача Y (RAPID кнопка нажата): скорость пропорциональна Feed_mm
// hz = Feed_mm × STEPS_PER_MM_Y / 100  (эквивалент подачи при 60 об/мин)
static uint32_t _joy_feed_hz_y(void) {
    int64_t hz = (int64_t)els.Feed_mm * (int64_t)STEPS_PER_MM_Y / 100LL;
    if (hz < JOY_FEED_HZ_MIN) hz = JOY_FEED_HZ_MIN;
    if (hz > 50000)            hz = 50000;
    return (uint32_t)hz;
}

// Подача X
static uint32_t _joy_feed_hz_x(void) {
    int64_t hz = (int64_t)els.Feed_mm * (int64_t)STEPS_PER_MM_X / 100LL;
    if (hz < JOY_FEED_HZ_MIN) hz = JOY_FEED_HZ_MIN;
    if (hz > 50000)            hz = 50000;
    return (uint32_t)hz;
}

// ============================================================
// Ручной энкодер — обработка тиков, запуск мотора
// ============================================================
static void _update_hand_encoder(void) {
    int32_t delta = DRV_Encoder_Hand_GetDelta();

    if (delta != 0) {
        bool scale_10 = (digitalRead(PD_3) == LOW);
        int32_t scale  = scale_10 ? 10 : 1;

        bool axis_z = (digitalRead(PD_0) == LOW);
        bool axis_x = (digitalRead(PD_1) == LOW);

        if (axis_z && !axis_x) {
            s_hc_acc_y += delta * scale * HC_STEPS_PER_TICK_Y;
        } else if (axis_x && !axis_z) {
            s_hc_frac_x += delta * scale * HC_STEPS10_PER_TICK_X;
            s_hc_acc_x  += s_hc_frac_x / 10;
            s_hc_frac_x %= 10;
        }
    }

    // Запустить Y если мотор свободен и есть накопленные шаги
    if (s_hc_acc_y != 0 && !DRV_Stepper_IsMoving(AXIS_Y)) {
        bool scale_10 = (digitalRead(PD_3) == LOW);
        uint32_t hz = scale_10 ? HAND_HC_SPEED_10 : HAND_HC_SPEED_1;
        int8_t  dir = (s_hc_acc_y > 0) ? +1 : -1;
        int32_t steps = (s_hc_acc_y > 0) ? s_hc_acc_y : -s_hc_acc_y;
        s_hc_acc_y = 0;
        DRV_Stepper_MoveSteps(AXIS_Y, steps, hz, dir);
    }

    // Запустить X если мотор свободен и есть накопленные шаги
    if (s_hc_acc_x != 0 && !DRV_Stepper_IsMoving(AXIS_X)) {
        bool scale_10 = (digitalRead(PD_3) == LOW);
        uint32_t hz = scale_10 ? HAND_HC_SPEED_10 : HAND_HC_SPEED_1;
        int8_t  dir = (s_hc_acc_x > 0) ? +1 : -1;
        int32_t steps = (s_hc_acc_x > 0) ? s_hc_acc_x : -s_hc_acc_x;
        s_hc_acc_x = 0;
        DRV_Stepper_MoveSteps(AXIS_X, steps, hz, dir);
    }
}

// ============================================================
// Sphere (шароточка) — state machine  [Этап 19]
// ============================================================
// Алгоритм: порт Sphere_Ext_Left из Arduino Sphere.ino
// Режим: SUBMODE_EXTERNAL, движение от вершины шара к экватору (верхняя полусфера),
//        затем от экватора к ножке (нижняя полусфера).
// Z: dir -1 = к передней бабке (к вершине шара)
// X: dir +1 = углубление в заготовку, dir -1 = отвод
// ============================================================
typedef enum {
    SPH_IDLE         = 0,
    SPH_INIT         = 1,
    SPH_MOVE_Z       = 2,
    SPH_WAIT_Z       = 3,
    SPH_MOVE_X       = 4,
    SPH_WAIT_X       = 5,
    SPH_RETRACT      = 6,
    SPH_WAIT_RETRACT = 7,
    SPH_COMPLETE     = 8,
} SphState_t;

static SphState_t s_sph_state    = SPH_IDLE;
static int32_t    s_sph_pass_nr  = 1;
static int32_t    s_sph_pass_tot = 0;
static int32_t    s_sph_cut_w    = 0;   // Cutting_Width в 0.01мм
static int32_t    s_sph_cutr_w   = 0;   // Cutter_Width в 0.01мм
static float      s_sph_r_steps  = 0.0f; // Sph_R в шагах X
static float      s_sph_bar_steps= 0.0f; // SphBar = (Sph_R - Bar_R) в шагах X
static int32_t    s_sph_z_cur    = 0;   // накопленных шагов Z от null (>0 = к вершине)
static int32_t    s_sph_x_cur    = 0;   // текущая глубина X в шагах (0 = отведён)

// Шагов на единицу 0.01мм для каждой оси
#define SPH_SPM_Y   ((float)MOTOR_Y_STEP_PER_REV * MICROSTEP_Y / SCREW_Y)
#define SPH_SPM_X   ((float)MOTOR_X_STEP_PER_REV * MICROSTEP_X / SCREW_X)

static void _update_sphere(void) {
    if (els.submode != SUBMODE_EXTERNAL) return;

    uint32_t hz_y = _calc_afeed_hz(els.aFeed_mm, STEPS_PER_MM_Y);
    uint32_t hz_x = _calc_afeed_hz(els.aFeed_mm, STEPS_PER_MM_X);
    if (hz_y < 50) hz_y = 50;
    if (hz_x < 50) hz_x = 50;

    switch (s_sph_state) {

    case SPH_IDLE:
        s_sph_state = SPH_INIT;
        /* fall-through */

    case SPH_INIT: {
        s_sph_cut_w  = Cutting_Width_array[els.Cutting_Step];
        s_sph_cutr_w = Cutter_Width_array[els.Cutter_Step];
        if (s_sph_cut_w < 1) s_sph_cut_w = 1;

        s_sph_pass_tot = (els.Sph_R_mm * 2) / s_sph_cut_w;
        if (s_sph_pass_tot < 2) s_sph_pass_tot = 2;
        els.Pass_Total_Sphr = s_sph_pass_tot;

        float R = (float)els.Sph_R_mm;
        float B = (float)els.Bar_R_mm;
        s_sph_r_steps   = R * SPH_SPM_X;
        s_sph_bar_steps = (R - B) * SPH_SPM_X;
        if (s_sph_bar_steps < 0.0f) s_sph_bar_steps = 0.0f;

        s_sph_pass_nr = 1;
        s_sph_z_cur   = 0;
        s_sph_x_cur   = 0;

        s_sph_state = SPH_MOVE_Z;
        break;
    }

    case SPH_MOVE_Z: {
        if (s_sph_pass_nr > s_sph_pass_tot + 1) {
            s_sph_state = SPH_COMPLETE;
            break;
        }

        int32_t nr  = s_sph_pass_nr;
        int32_t tot = s_sph_pass_tot;
        float   cw  = (float)s_sph_cut_w;
        float   cwr = (float)s_sph_cutr_w;

        float z_target_f;
        if (nr <= tot / 2)
            z_target_f = SPH_SPM_Y * cw * (float)nr + 0.5f;
        else
            z_target_f = SPH_SPM_Y * (cw * (float)(nr - 1) + cwr) + 0.5f;

        int32_t z_target = (int32_t)z_target_f;
        int32_t z_delta  = z_target - s_sph_z_cur;
        s_sph_z_cur = z_target;

        DRV_Beeper_Tone(1200, 30);

        if (z_delta > 0) {
            DRV_Stepper_MoveSteps(AXIS_Y, z_delta, hz_y, -1);
            s_sph_state = SPH_WAIT_Z;
        } else {
            s_sph_state = SPH_MOVE_X;
        }
        break;
    }

    case SPH_WAIT_Z:
        if (!DRV_Stepper_IsMoving(AXIS_Y))
            s_sph_state = SPH_MOVE_X;
        break;

    case SPH_MOVE_X: {
        int32_t nr  = s_sph_pass_nr;
        int32_t tot = s_sph_pass_tot;
        float   cw  = (float)s_sph_cut_w;
        float   R   = (float)els.Sph_R_mm;

        float x_depth_01mm;
        if (nr <= tot / 2) {
            float h  = R - cw * (float)nr;
            float sq = R * R - h * h;
            if (sq < 0.0f) sq = 0.0f;
            x_depth_01mm = R - sqrtf(sq);
        } else {
            float past = (float)(nr - (tot / 2 + 1));
            float h  = cw * past;
            float sq = R * R - h * h;
            if (sq < 0.0f) sq = 0.0f;
            x_depth_01mm = R - sqrtf(sq);
        }

        int32_t x_target = (int32_t)(x_depth_01mm * SPH_SPM_X + 0.5f);
        if (nr > tot / 2 && x_target > (int32_t)s_sph_bar_steps)
            x_target = (int32_t)s_sph_bar_steps;

        int32_t x_delta = x_target - s_sph_x_cur;
        s_sph_x_cur = x_target;

        if (x_delta > 0) {
            DRV_Stepper_MoveSteps(AXIS_X, x_delta, hz_x, +1);
            s_sph_state = SPH_WAIT_X;
        } else if (x_delta < 0) {
            DRV_Stepper_MoveSteps(AXIS_X, -x_delta, hz_x, -1);
            s_sph_state = SPH_WAIT_X;
        } else {
            s_sph_state = SPH_RETRACT;
        }
        break;
    }

    case SPH_WAIT_X:
        if (!DRV_Stepper_IsMoving(AXIS_X))
            s_sph_state = SPH_RETRACT;
        break;

    case SPH_RETRACT: {
        s_sph_pass_nr++;
        if (s_sph_x_cur > 0) {
            DRV_Stepper_MoveSteps(AXIS_X, s_sph_x_cur, RAPID_TRAVERSE_HZ, -1);
            s_sph_x_cur = 0;
            s_sph_state = SPH_WAIT_RETRACT;
        } else {
            s_sph_state = SPH_MOVE_Z;
        }
        break;
    }

    case SPH_WAIT_RETRACT:
        if (!DRV_Stepper_IsMoving(AXIS_X))
            s_sph_state = SPH_MOVE_Z;
        break;

    case SPH_COMPLETE:
        els.Complete_flag = true;
        els.running = 0;
        DRV_Stepper_StopAll();
        DRV_Beeper_Tone(800, 500);
        s_sph_state = SPH_IDLE;
        break;
    }
}

// ============================================================
// Публичный API
// ============================================================
void ELS_Control_Init(void) {
    s_last_speed_y = 0;
    s_last_speed_x = 0;
    s_last_dir_y   = 0;
    s_last_dir_x   = 0;
    s_hc_acc_y     = 0;
    s_hc_acc_x     = 0;
    s_hc_frac_x    = 0;
}

void ELS_Control_Start(void) {
    els.running = 1;
}

void ELS_Control_Stop(void) {
    els.running = 0;
    DRV_Stepper_ClearCone();
    DRV_Stepper_StopAll();
    s_last_speed_y = 0;
    s_last_speed_x = 0;
    s_sph_state    = SPH_IDLE;
}

void ELS_GCode_Process(void) {
    if (!els.gcode_motion) return;
    bool y_done = !els.gcode_has_y || !DRV_Stepper_IsMoving(AXIS_Y);
    bool x_done = !els.gcode_has_x || !DRV_Stepper_IsMoving(AXIS_X);
    if (y_done && x_done) {
        els.gcode_motion = false;
        DRV_Display_SendGCodeAck(true, nullptr);
    }
}

void ELS_Control_Update(void) {
    // GCode-движение активно — не трогаем оси
    if (els.gcode_motion) return;

    // Блокировка пока джойстик не в нейтрали при старте (как в Arduino)
    if (els.err_0_flag) {
        if (els.running) ELS_Control_Stop();
        return;
    }

    // Обновляем RPM из энкодера шпинделя
    int32_t rpm = DRV_Encoder_Spindle_GetRPM();
    if (rpm < 0) rpm = -rpm;  // Используем абсолютное значение RPM
    els.spindle_rpm = rpm;

    // Проверить лимиты
    _check_limits();

    // ── Управление джойстиком (Manual submode) ──────────────────────────────
    // Обрабатывается ДО els.running: джойстик работает независимо от цикла.
    // Только для ручного подрежима; в Ext/Int джойстик запускает циклы (TODO).
    if (els.submode == SUBMODE_MANUAL && (els.joy_y != 0 || els.joy_x != 0)) {
        // Остановить любой активный автоцикл
        if (els.running) {
            els.running = 0;
        }

        // Ось Y
        if (els.joy_y != 0) {
            uint32_t hz = (els.joy_rapid == 0) ? _joy_rapid_hz_y() : _joy_feed_hz_y();
            _apply_speed(AXIS_Y, hz, els.joy_y, &s_last_speed_y, &s_last_dir_y);
        } else {
            if (DRV_Stepper_IsMoving(AXIS_Y)) {
                DRV_Stepper_Stop(AXIS_Y);
                s_last_speed_y = 0;
            }
        }

        // Ось X
        if (els.joy_x != 0) {
            uint32_t hz = (els.joy_rapid == 0) ? _joy_rapid_hz_x() : _joy_feed_hz_x();
            _apply_speed(AXIS_X, hz, els.joy_x, &s_last_speed_x, &s_last_dir_x);
        } else {
            if (DRV_Stepper_IsMoving(AXIS_X)) {
                DRV_Stepper_Stop(AXIS_X);
                s_last_speed_x = 0;
            }
        }

        return; // Не продолжать в автоматический режим пока джойстик активен
    }

    // Джойстик нейтрален — остановить только непрерывные (joystick) движения.
    // Конечные движения от ручного энкодера (steps_left != INT32_MAX) не трогаем.
    if (!els.running) {
        if (DRV_Stepper_IsContinuous(AXIS_Y)) {
            DRV_Stepper_Stop(AXIS_Y);
            s_last_speed_y = 0;
        }
        if (DRV_Stepper_IsContinuous(AXIS_X)) {
            DRV_Stepper_Stop(AXIS_X);
            s_last_speed_x = 0;
        }
        // Обработать ручной энкодер: добавить тики и запустить мотор
        _update_hand_encoder();
        return;
    }

    // Направление движения в автоцикле: +1 = к задней бабке (стандарт), -1 = обратно
    int8_t dir_y = (els.submode == SUBMODE_EXTERNAL) ? +1 : -1;

    uint32_t hz_y = 0;

    switch (els.mode) {

    case MODE_FEED:
        // Синхронная подача мм/об (ось Y)
        if (rpm < MIN_RPM_FOR_SYNC) {
            hz_y = 0;
        } else {
            // feed = мм/об × 100 → pitch_001mm = feed × 10
            hz_y = _calc_sync_hz(rpm, els.feed * 10L, STEPS_PER_MM_Y);
        }
        _apply_speed(AXIS_Y, hz_y, dir_y, &s_last_speed_y, &s_last_dir_y);
        break;

    case MODE_AFEED:
        // Асинхронная подача мм/мин (ось Y), не зависит от шпинделя
        hz_y = _calc_afeed_hz(els.afeed, STEPS_PER_MM_Y);
        _apply_speed(AXIS_Y, hz_y, dir_y, &s_last_speed_y, &s_last_dir_y);
        break;

    case MODE_THREAD:
        // Нарезка резьбы (ось Y)
        // При многозаходной резьбе (Ph > 1) эффективный шаг = pitch × Ph:
        // за 1 оборот шпинделя мотор должен пройти Ph × pitch_mm.
        if (rpm < MIN_RPM_FOR_SYNC) {
            hz_y = 0;
        } else {
            int32_t ph = (els.Ph > 0) ? (int32_t)els.Ph : 1;
            hz_y = _calc_sync_hz(rpm, els.thread_pitch * ph, STEPS_PER_MM_Y);
        }
        _apply_speed(AXIS_Y, hz_y, dir_y, &s_last_speed_y, &s_last_dir_y);
        break;

    case MODE_CONE_L:
    case MODE_CONE_R: {
        // Конус: Y движется со скоростью подачи, X следует по Bresenham
        // (Cs_Div, Cm_Div из таблицы конусов)
        if (rpm >= MIN_RPM_FOR_SYNC) {
            hz_y = _calc_sync_hz(rpm, els.feed * 10L, STEPS_PER_MM_Y);
        }
        if (hz_y > 0) {
            // Если конус ещё не инициализирован — установить Bresenham-параметры
            if (!DRV_Stepper_IsMoving(AXIS_Y)) {
                const cone_info_t& ci = Cone_Info[els.Cone_Step];
                int8_t cx = (els.mode == MODE_CONE_L) ? +1 : -1;
                DRV_Stepper_SetConeRatio(ci.Cs_Div, ci.Cm_Div, cx);
            }
            _apply_speed(AXIS_Y, hz_y, dir_y, &s_last_speed_y, &s_last_dir_y);
        } else {
            if (DRV_Stepper_IsMoving(AXIS_Y)) {
                DRV_Stepper_Stop(AXIS_Y);
                DRV_Stepper_ClearCone();
                s_last_speed_y = 0;
            }
        }
        break;
    }

    case MODE_SPHERE:
        _update_sphere();
        break;

    case MODE_DIVIDER:
    case MODE_RESERVE:
    default:
        break;
    }

}
