tepmehatop/Lathe-cnc-controller-stm32/Drivers/drv_stepper.h

#pragma once
#include <stdint.h>

// Оси
typedef enum {
    AXIS_Y = 0,  // Продольная (каретка)
    AXIS_X = 1,  // Поперечная (суппорт)
} Axis_t;

void DRV_Stepper_Init(void);

// Запустить движение к target_pos (0.001 мм) с заданной скоростью (шаги/сек)
void DRV_Stepper_MoveTo(Axis_t axis, int32_t target_pos, uint32_t speed_hz);

// Остановить немедленно
void DRV_Stepper_Stop(Axis_t axis);

// Остановить оба
void DRV_Stepper_StopAll(void);

// Включить/выключить драйвер (EN пин)
void DRV_Stepper_Enable(Axis_t axis, uint8_t en);

// Текущая позиция в шагах
int32_t DRV_Stepper_GetPos(Axis_t axis);

// В движении?
uint8_t DRV_Stepper_IsMoving(Axis_t axis);

// Вызывать из loop() — обслуживает шаговые импульсы
void DRV_Stepper_Update(void);

// Непрерывное движение (до Stop или лимита); dir = +1 или -1
void DRV_Stepper_SetContinuous(Axis_t axis, uint32_t speed_hz, int8_t dir);

// Изменить скорость текущего движения (не меняет позицию назначения)
void DRV_Stepper_SetSpeed(Axis_t axis, uint32_t speed_hz);

// Конус: Bresenham-слейв X к Y (cs_div/cm_div из Cone_Info[], dir_x = ±1)
void DRV_Stepper_SetConeRatio(uint8_t cs_div, int16_t cm_div, int8_t dir_x);
void DRV_Stepper_ClearCone(void);

// Ручной энкодер: движение ровно N шагов
void    DRV_Stepper_MoveSteps(Axis_t axis, int32_t steps, uint32_t hz, int8_t dir);
// Движение непрерывное (steps_left = INT32_MAX)?
uint8_t DRV_Stepper_IsContinuous(Axis_t axis);
