tepmehatop/Lathe-cnc-controller-stm32/Core/e2/orig/Feed.ino

//////////////////////////////////////////////////////////////////////////////////////////////////////////////////////////////////////
//////////////////////////////////////////////////////////////////////////////////////////////////////////////////////////////////////
// ********** Режим "Подача" ********** //////////////////////////////////////////////////////////////////////////////////////////////
//////////////////////////////////////////////////////////////////////////////////////////////////////////////////////////////////////
//////////////////////////////////////////////////////////////////////////////////////////////////////////////////////////////////////
void Feed_Left(bool & a_flag, bool & b_flag)  
{
   if (b_flag == true) return;
   a_flag = false;
   b_flag = true;

   Joy_X_flag = OFF;
   feed_X_flag = OFF;
   Start_Speed = ENC_LINE_PER_REV / ((float)MOTOR_Z_STEP_PER_REV * McSTEP_Z * MIN_FEED / SCREW_Z) / FEED_ACCEL /2 +0.5;
   if (Motor_Z_Pos < Limit_Pos_Left - Start_Speed * 2)
   {
      Feed_Divisor = ENC_LINE_PER_REV / ((float)MOTOR_Z_STEP_PER_REV * McSTEP_Z * Feed_mm / SCREW_Z) /2 +0.5 - FEED_EXACT;   // [STM32] BACKLOG-020: таймер считает Feed_Divisor + 1 линий
      if (Feed_Divisor < Start_Speed)
      {
         max_OCR5A = Start_Speed;
         if (Step_Z_flag == OFF)
         {
            OCR5A = Start_Speed;
         }
      }
      else
      {
         max_OCR5A = Feed_Divisor;
         OCR5A = Feed_Divisor;
      }
   }
   else
   {
      Feed_Divisor = Start_Speed;
      max_OCR5A = Start_Speed;
      OCR5A = Start_Speed;
   }
   
   Brake_Compens = max_OCR5A - Feed_Divisor + 1;
   Limit_Pos = Limit_Pos_Left - Brake_Compens;

   Motor_Z_Dir = CW;
   Motor_Z_CW();
   if (Read_Z_Ena_State == false) Motor_Z_Enable();
   
   feed_Z_flag = ON;
   Joy_Z_flag = ON;
   Ena_INT_Z_Feed();
}

void Feed_Right(bool & a_flag, bool & b_flag)
{
   if (b_flag == true) return;
   a_flag = false;
   b_flag = true;

   Joy_X_flag = OFF;
   feed_X_flag = OFF;
   Start_Speed = ENC_LINE_PER_REV / ((float)MOTOR_Z_STEP_PER_REV * McSTEP_Z * MIN_FEED / SCREW_Z) / FEED_ACCEL /2 +0.5;
   if (Motor_Z_Pos > Limit_Pos_Right + Start_Speed * 2)
   {
      Feed_Divisor = ENC_LINE_PER_REV / ((float)MOTOR_Z_STEP_PER_REV * McSTEP_Z * Feed_mm / SCREW_Z) /2 +0.5 - FEED_EXACT;   // [STM32] BACKLOG-020: таймер считает Feed_Divisor + 1 линий
      if (Feed_Divisor < Start_Speed)
      {
         max_OCR5A = Start_Speed;
         if (Step_Z_flag == OFF)
         {
            OCR5A = Start_Speed;
         }
      }
      else
      {
         max_OCR5A = Feed_Divisor;
         OCR5A = Feed_Divisor;
      }
   }
   else
   {
      Feed_Divisor = Start_Speed;
      max_OCR5A = Start_Speed;
      OCR5A = Start_Speed;
   }
   
   Brake_Compens = (max_OCR5A - Feed_Divisor) + 1;
   Limit_Pos = Limit_Pos_Right + Brake_Compens;

   Motor_Z_Dir = CCW;
   Motor_Z_CCW();
   if (Read_Z_Ena_State == false) Motor_Z_Enable();
   
   feed_Z_flag = ON;
   Joy_Z_flag = ON;
   Ena_INT_Z_Feed();
}

void Feed_Front(bool & a_flag, bool & b_flag)
{  
   if (b_flag == true) return;
   a_flag = false;
   b_flag = true;

   Joy_Z_flag = OFF;
   feed_Z_flag = OFF;
   Start_Speed = ENC_LINE_PER_REV / ((float)MOTOR_X_STEP_PER_REV * McSTEP_X * MIN_FEED / SCREW_X) / FEED_ACCEL /2 +0.5;
   if (Motor_X_Pos < Limit_Pos_Front - Start_Speed * 2)
   {
      Feed_Divisor = ENC_LINE_PER_REV / ((float)MOTOR_X_STEP_PER_REV * McSTEP_X * Feed_mm / SCREW_X) /2 +0.5 - FEED_EXACT;   // [STM32] BACKLOG-020: таймер считает Feed_Divisor + 1 линий
      if (Feed_Divisor < Start_Speed)
      {
         max_OCR5A = Start_Speed;
         if (Step_X_flag == OFF)
         {
            OCR5A = Start_Speed;
         }
      }
      else
      {
         max_OCR5A = Feed_Divisor;
         OCR5A = Feed_Divisor;
      }
   }
   else
   {
      Feed_Divisor = Start_Speed;
      max_OCR5A = Start_Speed;
      OCR5A = Start_Speed;
   }
   
   Brake_Compens = max_OCR5A - Feed_Divisor + 1;
   Limit_Pos = Limit_Pos_Front - Brake_Compens;

   Motor_X_Dir = CW;
   Motor_X_CW();
   if (Read_X_Ena_State == false) Motor_X_Enable();
   
   feed_X_flag = ON;
   Joy_X_flag = ON;
   Ena_INT_X_Feed();
   
}

void Feed_Rear(bool & a_flag, bool & b_flag)
{
   if (b_flag == true) return;
   a_flag = false;
   b_flag = true;

   Joy_Z_flag = OFF;
   feed_Z_flag = OFF;
   Start_Speed = ENC_LINE_PER_REV / ((float)MOTOR_X_STEP_PER_REV * McSTEP_X * MIN_FEED / SCREW_X) / FEED_ACCEL /2 +0.5;
   if (Motor_X_Pos > Limit_Pos_Rear + Start_Speed * 2)
   {
      Feed_Divisor = ENC_LINE_PER_REV / ((float)MOTOR_X_STEP_PER_REV * McSTEP_X * Feed_mm / SCREW_X) /2 +0.5 - FEED_EXACT;   // [STM32] BACKLOG-020: таймер считает Feed_Divisor + 1 линий
      if (Feed_Divisor < Start_Speed)
      {
         max_OCR5A = Start_Speed;
         if (Step_X_flag == OFF)
         {
            OCR5A = Start_Speed;
         }
      }
      else
      {
         max_OCR5A = Feed_Divisor;
         OCR5A = Feed_Divisor;
      }
   }
   else
   {
      Feed_Divisor = Start_Speed;
      max_OCR5A = Start_Speed;
      OCR5A = Start_Speed;
   }

   Brake_Compens = max_OCR5A - Feed_Divisor + 1;
   Limit_Pos = Limit_Pos_Rear + Brake_Compens;

   Motor_X_Dir = CCW;
   Motor_X_CCW();
   if (Read_X_Ena_State == false) Motor_X_Enable();
   
   feed_X_flag = ON;
   Joy_X_flag = ON;
   Ena_INT_X_Feed();
}


//////////////////////////////////////////////////////////////////////////////////////////////////////////////////////////////////////
//////////////////////////////////////////////////////////////////////////////////////////////////////////////////////////////////////
// ********** Режим "Быстрая Подача" ********** //////////////////////////////////////////////////////////////////////////////////////
//////////////////////////////////////////////////////////////////////////////////////////////////////////////////////////////////////
//////////////////////////////////////////////////////////////////////////////////////////////////////////////////////////////////////
void Rapid_Feed_Left(bool & a_flag, bool & b_flag)
{
   if (a_flag == true) return;
   b_flag = false;
   a_flag = true;

   Joy_X_flag = OFF;
   feed_X_flag = OFF;
   rapid_X_flag = OFF;
   Brake_Compens = (MIN_RAPID_MOTION - MAX_RAPID_MOTION) * REPEAt + 1;
   Limit_Pos = Limit_Pos_Left - Brake_Compens;

   Motor_Z_Dir = CW;
   Motor_Z_CW();
   if (Read_Z_Ena_State == false) Motor_Z_Enable();
   
   Joy_Z_flag = ON;             
   rapid_Z_flag = ON;
   Ena_INT_Z_Rapid();
}

void Rapid_Feed_Right(bool & a_flag, bool & b_flag)
{
   if (a_flag == true) return;
   b_flag = false;
   a_flag = true;

   Joy_X_flag = OFF;
   feed_X_flag = OFF;
   rapid_X_flag = OFF;
   Brake_Compens = (MIN_RAPID_MOTION - MAX_RAPID_MOTION) * REPEAt + 1;
   Limit_Pos = Limit_Pos_Right + Brake_Compens;

   Motor_Z_Dir = CCW;
   Motor_Z_CCW();
   if (Read_Z_Ena_State == false) Motor_Z_Enable();
   
   Joy_Z_flag = ON;
   rapid_Z_flag = ON;
   Ena_INT_Z_Rapid();
}

void Rapid_Feed_Front(bool & a_flag, bool & b_flag)
{
   if (a_flag == true) return;
   b_flag = false;
   a_flag = true;

   Joy_Z_flag = OFF;
   feed_Z_flag = OFF;
   rapid_Z_flag = OFF;
   Brake_Compens = (MIN_RAPID_MOTION - MAX_RAPID_MOTION) * REPEAt + 1;
   Limit_Pos = Limit_Pos_Front - Brake_Compens;

   Motor_X_Dir = CW;
   Motor_X_CW();
   if (Read_X_Ena_State == false) Motor_X_Enable();
   
   Joy_X_flag = ON;
   rapid_X_flag = ON;
   Ena_INT_X_Rapid();
}

void Rapid_Feed_Rear(bool & a_flag, bool & b_flag)
{
   if (a_flag == true) return;
   b_flag = false;
   a_flag = true;

   Joy_Z_flag = OFF;
   feed_Z_flag = OFF;
   rapid_Z_flag = OFF;
   Brake_Compens = (MIN_RAPID_MOTION - MAX_RAPID_MOTION) * REPEAt + 1;
   Limit_Pos = Limit_Pos_Rear + Brake_Compens;

   Motor_X_Dir = CCW;
   Motor_X_CCW();
   if (Read_X_Ena_State == false) Motor_X_Enable();
   
   Joy_X_flag = ON;
   rapid_X_flag = ON;
   Ena_INT_X_Rapid();
}


//////////////////////////////////////////////////////////////////////////////////////////////////////////////////////////////////////
//////////////////////////////////////////////////////////////////////////////////////////////////////////////////////////////////////
// ********** Режим "Многопроходная Подача" ********** /////////////////////////////////////////////////////////////////////////////////////////
//////////////////////////////////////////////////////////////////////////////////////////////////////////////////////////////////////
//////////////////////////////////////////////////////////////////////////////////////////////////////////////////////////////////////
void Feed_Ext_Left()
{
   if ((Motor_Z_Pos == Limit_Pos_Right && Motor_X_Pos == Limit_Pos_Rear && Step_Z_flag == OFF) ||
       (Motor_Z_Pos == Limit_Pos_Right && Motor_X_Pos == Null_X_Pos && Step_Z_flag == OFF))
   {  
      if (cycle_flag == false && Pass_Nr <= Pass_Total)
      {
         cycle_flag = true;
         a_flag = false;
         b_flag = false;

         long Infeed_Value = (int)((float)MOTOR_X_STEP_PER_REV * (Ap / 2) / SCREW_X +0.5) * McSTEP_X;
         if (Infeed_Value == 0)
         {
            if (Pass_Nr == 1) Limit_Pos_Front = (Null_X_Pos + 1);
            else              Limit_Pos_Front = (Limit_Pos_Rear + REBOUND_X);
         }
         else
         {
            if (Pass_Nr == 1) Limit_Pos_Front = (Null_X_Pos + Infeed_Value);
            else              Limit_Pos_Front = (Limit_Pos_Rear + REBOUND_X + Infeed_Value);
         }
         Limit_Front_LED_On();
         BeepBeep();
         Feed_Front(a_flag, b_flag);
      }
      
      else if (cycle_flag == false && Pass_Nr > Pass_Total)
      {
         a_flag = false;
         b_flag = false;

         Limit_Pos_Front = Limit_Pos_Rear + REBOUND_X ;
         Feed_Front(a_flag, b_flag);

         Limit_Front_LED_Off();
         Limit_Rear_LED_Off();
         Limit_Pos_Front = Limit_Pos_Max;
         Limit_Pos_Rear = Limit_Pos_Min;
         Pass_Total = 1;
         Pass_Nr = 1;
         Print();
         BeepComplete();
         
      }
   }

   else if (Motor_Z_Pos == Limit_Pos_Right && Motor_X_Pos == Limit_Pos_Front && Step_X_flag == OFF)
   {
      if (Pass_Nr <= Pass_Total)
      {
         a_flag = false;
         b_flag = false;

         Feed_Left(a_flag, b_flag);
      }
   }

   else if (Motor_Z_Pos == Limit_Pos_Left && Motor_X_Pos == Limit_Pos_Front && Step_Z_flag == OFF)
   {
      cycle_flag = false;
      a_flag = false;
      b_flag = false;
      
      Limit_Pos_Rear = (Limit_Pos_Front - REBOUND_X);
      Limit_Rear_LED_On();
      Feed_Rear(a_flag, b_flag);
   }

   else if (Motor_Z_Pos == Limit_Pos_Left && Motor_X_Pos == Limit_Pos_Rear && Step_X_flag == OFF)
   {
      a_flag = false;
      b_flag = false;

      Pass_Nr++;
      Print();
      Rapid_Feed_Right(a_flag, b_flag);
   }
}

////////////////////////////////////////////////////////////////////////////////////////////////
void Feed_Ext_Right()
{
   if ((Motor_Z_Pos == Limit_Pos_Left && Motor_X_Pos == Limit_Pos_Rear && Step_Z_flag == OFF) ||
       (Motor_Z_Pos == Limit_Pos_Left && Motor_X_Pos == Null_X_Pos && Step_Z_flag == OFF))
   {  
      if (cycle_flag == false && Pass_Nr <= Pass_Total)
      {
         cycle_flag = true;
         a_flag = false;
         b_flag = false;
         
         long Infeed_Value = (int)((float)MOTOR_X_STEP_PER_REV * (Ap / 2) / SCREW_X +0.5) * McSTEP_X;
         if (Infeed_Value == 0)
         {
            if (Pass_Nr == 1) Limit_Pos_Front = (Null_X_Pos + 1);
            else              Limit_Pos_Front = (Limit_Pos_Rear + REBOUND_X);
         }
         else
         {
            if (Pass_Nr == 1) Limit_Pos_Front = (Null_X_Pos + Infeed_Value);
            else              Limit_Pos_Front = (Limit_Pos_Rear + REBOUND_X + Infeed_Value);
         }
         Limit_Front_LED_On();
         BeepBeep();
         Feed_Front(a_flag, b_flag);
      }

      else if (cycle_flag == false && Pass_Nr > Pass_Total)
      {
         a_flag = false;
         b_flag = false;
         
         Limit_Pos_Front = Limit_Pos_Rear + REBOUND_X;
         Feed_Front(a_flag, b_flag);

         Limit_Front_LED_Off();
         Limit_Rear_LED_Off();
         Limit_Pos_Front = Limit_Pos_Max;
         Limit_Pos_Rear = Limit_Pos_Min;
         Pass_Total = 1;
         Pass_Nr = 1;
         Print();
         BeepComplete();
      }
   }

   else if (Motor_Z_Pos == Limit_Pos_Left && Motor_X_Pos == Limit_Pos_Front && Step_X_flag == OFF)  
   {
      if (Pass_Nr <= Pass_Total)
      {
         a_flag = false;
         b_flag = false;

         Feed_Right(a_flag, b_flag);
      }
   }

   else if (Motor_Z_Pos == Limit_Pos_Right && Motor_X_Pos == Limit_Pos_Front && Step_Z_flag == OFF)
   {
      cycle_flag = false;
      a_flag = false;
      b_flag = false;
      
      Limit_Pos_Rear = (Limit_Pos_Front - REBOUND_X);
      Limit_Rear_LED_On();
      Feed_Rear(a_flag, b_flag);
   }

   else if (Motor_Z_Pos == Limit_Pos_Right && Motor_X_Pos == Limit_Pos_Rear && Step_X_flag == OFF)
   {
      a_flag = false;
      b_flag = false;

      Pass_Nr++;
      Print();
      Rapid_Feed_Left(a_flag, b_flag);
   }
}

/////////////////////////////////////////////////////////////////////////////////////////////////
void Feed_Int_Left()
{
   if ((Motor_Z_Pos == Limit_Pos_Right && Motor_X_Pos == Limit_Pos_Front && Step_Z_flag == OFF) ||
       (Motor_Z_Pos == Limit_Pos_Right && Motor_X_Pos == Null_X_Pos && Step_Z_flag == OFF))
   {  
      if (cycle_flag == false && Pass_Nr <= Pass_Total)
      {
         cycle_flag = true;
         a_flag = false;
         b_flag = false;

         unsigned long Infeed_Value = (int)((float)MOTOR_X_STEP_PER_REV * (Ap / 2) / SCREW_X +0.5) * McSTEP_X;
         if (Infeed_Value == 0)
         {
            if (Pass_Nr == 1) Limit_Pos_Rear = (Null_X_Pos - 1);
            else              Limit_Pos_Rear = (Limit_Pos_Front - REBOUND_X);
         }
         else
         {
            if (Pass_Nr == 1) Limit_Pos_Rear = (Null_X_Pos - Infeed_Value);
            else              Limit_Pos_Rear = (Limit_Pos_Front - REBOUND_X - Infeed_Value);
         }
         Limit_Rear_LED_On();
         BeepBeep();
         Feed_Rear(a_flag, b_flag);
      }
      
      else if (cycle_flag == false && Pass_Nr > Pass_Total)
      {
         a_flag = false;
         b_flag = false;
         
         Limit_Pos_Rear = Limit_Pos_Front - REBOUND_X;
         Feed_Rear(a_flag, b_flag);

         Limit_Front_LED_Off();
         Limit_Rear_LED_Off();
         Limit_Pos_Front = Limit_Pos_Max;
         Limit_Pos_Rear = Limit_Pos_Min;
         Pass_Total = 1;
         Pass_Nr = 1;
         Print();
         BeepComplete();
      }
   }

   else if (Motor_Z_Pos == Limit_Pos_Right && Motor_X_Pos == Limit_Pos_Rear && Step_X_flag == OFF)
   {
      if (Pass_Nr <= Pass_Total)
      {
         a_flag = false;
         b_flag = false;

         Feed_Left(a_flag, b_flag);
      }
   }

   else if (Motor_Z_Pos == Limit_Pos_Left && Motor_X_Pos == Limit_Pos_Rear && Step_Z_flag == OFF)
   {
      cycle_flag = false;
      a_flag = false;
      b_flag = false;
      
      Limit_Pos_Front = (Limit_Pos_Rear + REBOUND_X);
      Limit_Front_LED_On();
      Feed_Front(a_flag, b_flag);
   }

   else if (Motor_Z_Pos == Limit_Pos_Left && Motor_X_Pos == Limit_Pos_Front && Step_X_flag == OFF)
   {
      a_flag = false;
      b_flag = false;

      Pass_Nr++;
      Print();
      Rapid_Feed_Right(a_flag, b_flag);
   }
}

/////////////////////////////////////////////////////////////////////////////////////////////////
void Feed_Int_Right()
{
   if ((Motor_Z_Pos == Limit_Pos_Left && Motor_X_Pos == Limit_Pos_Front && Step_Z_flag == OFF) ||
       (Motor_Z_Pos == Limit_Pos_Left && Motor_X_Pos == Null_X_Pos && Step_Z_flag == OFF))
   {  
      if (cycle_flag == false && Pass_Nr <= Pass_Total)
      {
         cycle_flag = true;
         a_flag = false;
         b_flag = false;
         
         long Infeed_Value = (int)((float)MOTOR_X_STEP_PER_REV * (Ap / 2) / SCREW_X +0.5) * McSTEP_X;
         if (Infeed_Value == 0)
         {
            if (Pass_Nr == 1) Limit_Pos_Rear = (Null_X_Pos - 1);
            else              Limit_Pos_Rear = (Limit_Pos_Front - REBOUND_X);
         }
         else
         {
            if (Pass_Nr == 1) Limit_Pos_Rear = (Null_X_Pos - Infeed_Value);
            else              Limit_Pos_Rear = (Limit_Pos_Front - REBOUND_X - Infeed_Value);
         }
         Limit_Rear_LED_On();
         BeepBeep();
         Feed_Rear(a_flag, b_flag);
      }

      else if (cycle_flag == false && Pass_Nr > Pass_Total)
      {
         a_flag = false;
         b_flag = false;
         
         Limit_Pos_Rear = Limit_Pos_Front - REBOUND_X;
         Feed_Rear(a_flag, b_flag);

         Limit_Front_LED_Off();
         Limit_Rear_LED_Off();
         Limit_Pos_Front = Limit_Pos_Max;
         Limit_Pos_Rear = Limit_Pos_Min;
         Pass_Total = 1;
         Pass_Nr = 1;
         Print();
         BeepComplete();
      }
   }

   else if (Motor_Z_Pos == Limit_Pos_Left && Motor_X_Pos == Limit_Pos_Rear && Step_X_flag == OFF)
   {
      if (Pass_Nr <= Pass_Total)
      {
         a_flag = false;
         b_flag = false;

         Feed_Right(a_flag, b_flag);
      }
   }

   else if (Motor_Z_Pos == Limit_Pos_Right && Motor_X_Pos == Limit_Pos_Rear && Step_Z_flag == OFF)
   {
      cycle_flag = false;
      a_flag = false;
      b_flag = false;
      
      Limit_Pos_Front = (Limit_Pos_Rear + REBOUND_X);
      Limit_Front_LED_On();
      Feed_Front(a_flag, b_flag);
   }

   else if (Motor_Z_Pos == Limit_Pos_Right && Motor_X_Pos == Limit_Pos_Front && Step_X_flag == OFF)
   {
      a_flag = false;
      b_flag = false;

      Pass_Nr++;
      Print();
      Rapid_Feed_Left(a_flag, b_flag);
   }
}

///////////////////////////////////////////////////////////////////////////////////////////////
void Feed_Ext_Front()
{  
  if (TENSION_Z > 0 || OTSKOK_Z < REBOUND_Z){ ///если натяг больше нуля или если отскок отключен
  if ((Motor_X_Pos == Limit_Pos_Rear && Step == 0 && Motor_Z_Pos == Limit_Pos_Right && Step_X_flag == OFF) ||
      (Motor_X_Pos == Limit_Pos_Rear && Step == 0 && Motor_Z_Pos == Null_Z_Pos && Step_X_flag == OFF))
   {  
      if (cycle_flag == false && Pass_Nr <= Pass_Total)
      {
         cycle_flag = true;
         a_flag = false;
         b_flag = false;

         long Infeed_Value = (int)((float)MOTOR_Z_STEP_PER_REV * Ap / SCREW_Z +0.5) * McSTEP_Z;
         
         if  (OTSKOK_Z < REBOUND_Z){ ///////если отскок отключен
          
         if (Infeed_Value == 0)
         {
            if (Pass_Nr == 1) Limit_Pos_Left = (Null_Z_Pos + 1);
            else              Limit_Pos_Left = (Limit_Pos_Right + TENSION_Z);
         }
         else
         {
            if (Pass_Nr == 1) Limit_Pos_Left = (Null_Z_Pos + 1);
            else              Limit_Pos_Left = (Limit_Pos_Right + Infeed_Value + TENSION_Z);
         }
         }
         else {
         if (Infeed_Value == 0)
         {
            if (Pass_Nr == 1) Limit_Pos_Left = (Null_Z_Pos + 1);
            else              Limit_Pos_Left = (Limit_Pos_Right + OTSKOK_Z);
         }
         else
         {
            if (Pass_Nr == 1) Limit_Pos_Left = (Null_Z_Pos + 1);
            else              Limit_Pos_Left = (Limit_Pos_Right + OTSKOK_Z + Infeed_Value);
         }
         }
         Limit_Left_LED_On();
         BeepBeep();
         Feed_Left(a_flag, b_flag);
      }
           
      else if (cycle_flag == false && Pass_Nr > Pass_Total)
      {
         if  (OTSKOK_Z < REBOUND_Z){ ///////если отскок отключен
         a_flag = false;
         b_flag = false; 
         Limit_Pos_Left = Limit_Pos_Right + TENSION_Z;
         Feed_Left(a_flag, b_flag);
         }
         else {
         a_flag = false;
         b_flag = false; 
         Limit_Pos_Left = Limit_Pos_Right + OTSKOK_Z;
         Feed_Left(a_flag, b_flag);
         }
         Limit_Left_LED_Off();
         Limit_Right_LED_Off();
         Limit_Pos_Left = Limit_Pos_Max;
         Limit_Pos_Right = Limit_Pos_Min;
         Pass_Total = 1;
         Pass_Nr = 1;
         Step = 0;
         Print();
         BeepComplete();
      }
   }
   else if (Motor_X_Pos == Limit_Pos_Rear && Motor_Z_Pos == Limit_Pos_Left && Step_X_flag == OFF)
   {
      a_flag = false;
      b_flag = false;
      
      Limit_Pos_Right = (Limit_Pos_Left - TENSION_Z);
      Feed_Right(a_flag, b_flag);
      Step = 1;
   }
   else if (Motor_X_Pos == Limit_Pos_Rear && Step == 1 && Motor_Z_Pos == Limit_Pos_Right && Step_Z_flag == OFF)
   {
      if (Pass_Nr <= Pass_Total)
      {
         a_flag = false;
         b_flag = false;
         Feed_Front(a_flag, b_flag);
         Step = 2;
      }
   }

   else if (Motor_X_Pos == Limit_Pos_Front && Step == 2 && Motor_Z_Pos == Limit_Pos_Right && Step_X_flag == OFF)
   {
      cycle_flag = false;
      Step = 3;
      if  (OTSKOK_Z < REBOUND_Z){ ///////если отскок отключен
      Limit_Right_LED_On();  
      }
      else {
      a_flag = false;
      b_flag = false;
      Limit_Pos_Right = (Limit_Pos_Left - OTSKOK_Z);
      Limit_Right_LED_On();
      Feed_Right(a_flag, b_flag);
      } 
   }

   else if (Motor_X_Pos == Limit_Pos_Front && Step == 3 && Motor_Z_Pos == Limit_Pos_Right && Step_Z_flag == OFF)
   {  
      a_flag = false;
      b_flag = false;

      Pass_Nr++;
      Print();
      Rapid_Feed_Rear(a_flag, b_flag);
      Step = 0;
   }
 }
   else {

    ///////////////////////////////////////////////////////////////////////////////////////
    ///////////////////////////////////////////////////////////////////////////////////////
    ///////////////////////////////////////////////////////////////////////////////////////
     if ((Motor_X_Pos == Limit_Pos_Rear && Motor_Z_Pos == Limit_Pos_Right && Step_X_flag == OFF) ||
        (Motor_X_Pos == Limit_Pos_Rear && Motor_Z_Pos == Null_Z_Pos && Step_X_flag == OFF))
   {  
      if (cycle_flag == false && Pass_Nr <= Pass_Total)
      {
         cycle_flag = true;
         a_flag = false;
         b_flag = false;

         long Infeed_Value = (int)((float)MOTOR_Z_STEP_PER_REV * Ap / SCREW_Z +0.5) * McSTEP_Z;
         if (Infeed_Value == 0)
         {
            if (Pass_Nr == 1) Limit_Pos_Left = (Null_Z_Pos + 1);
            else              Limit_Pos_Left = (Limit_Pos_Right + REBOUND_Z);
         }
         else
         {
            if (Pass_Nr == 1) Limit_Pos_Left = (Null_Z_Pos + Infeed_Value);
            else              Limit_Pos_Left = (Limit_Pos_Right + REBOUND_Z + Infeed_Value);
         }
         Limit_Left_LED_On();
         BeepBeep();
         Feed_Left(a_flag, b_flag);
      }
      
      else if (cycle_flag == false && Pass_Nr > Pass_Total)
      {
         a_flag = false;
         b_flag = false;
         
         Limit_Pos_Left = Limit_Pos_Right + REBOUND_Z;
         Feed_Left(a_flag, b_flag);

         Limit_Left_LED_Off();
         Limit_Right_LED_Off();
         Limit_Pos_Left = Limit_Pos_Max;
         Limit_Pos_Right = Limit_Pos_Min;
         Pass_Total = 1;
         Pass_Nr = 1;
         Print();
         BeepComplete();
      }

   }


   else if (Motor_X_Pos == Limit_Pos_Rear && Motor_Z_Pos == Limit_Pos_Left && Step_Z_flag == OFF)
   {
      if (Pass_Nr <= Pass_Total)
      {
         a_flag = false;
         b_flag = false;

         Feed_Front(a_flag, b_flag);
      }
   }

   else if (Motor_X_Pos == Limit_Pos_Front && Motor_Z_Pos == Limit_Pos_Left && Step_X_flag == OFF)
   {
      cycle_flag = false;
      a_flag = false;
      b_flag = false;
      
      Limit_Pos_Right = (Limit_Pos_Left - REBOUND_Z);
      Limit_Right_LED_On();
      Feed_Right(a_flag, b_flag);
   }

   else if (Motor_X_Pos == Limit_Pos_Front && Motor_Z_Pos == Limit_Pos_Right && Step_Z_flag == OFF)
   {
      a_flag = false;
      b_flag = false;

      Pass_Nr++;
      Print();
      Rapid_Feed_Rear(a_flag, b_flag);
   }
  }
}

//////////////////////////////////////////////////////////////////////////////
void Feed_Ext_Rear()
{
   if ((Motor_X_Pos == Limit_Pos_Front && Motor_Z_Pos == Limit_Pos_Right && Step_X_flag == OFF) ||
       (Motor_X_Pos == Limit_Pos_Front && Motor_Z_Pos == Null_Z_Pos && Step_X_flag == OFF))
   {  
      if (cycle_flag == false && Pass_Nr <= Pass_Total)
      {
         cycle_flag = true;
         a_flag = false;
         b_flag = false;

         long Infeed_Value = (int)((float)MOTOR_Z_STEP_PER_REV * Ap / SCREW_Z +0.5) * McSTEP_Z;
         if (Infeed_Value == 0)
         {
            if (Pass_Nr == 1) Limit_Pos_Left = (Null_Z_Pos + 1);
            else              Limit_Pos_Left = (Limit_Pos_Right + REBOUND_Z);
         }
         else
         {
            if (Pass_Nr == 1) Limit_Pos_Left = (Null_Z_Pos + Infeed_Value);
            else              Limit_Pos_Left = (Limit_Pos_Right + REBOUND_Z + Infeed_Value);
         }
         Limit_Left_LED_On();
         BeepBeep();
         Feed_Left(a_flag, b_flag);
      }
      
      else if (cycle_flag == false && Pass_Nr > Pass_Total)
      {
         a_flag = false;
         b_flag = false;
         
         Limit_Pos_Left = Limit_Pos_Right + REBOUND_Z;
         Feed_Left(a_flag, b_flag);

         Limit_Left_LED_Off();
         Limit_Right_LED_Off();
         Limit_Pos_Left = Limit_Pos_Max;
         Limit_Pos_Right = Limit_Pos_Min;
         Pass_Total = 1;
         Pass_Nr = 1;
         Print();
         BeepComplete();
      }
   }

   else if (Motor_X_Pos == Limit_Pos_Front && Motor_Z_Pos == Limit_Pos_Left && Step_Z_flag == OFF)
   {
      if (Pass_Nr <= Pass_Total)
      {
         a_flag = false;
         b_flag = false;

         Feed_Rear(a_flag, b_flag);
      }
   }

   else if (Motor_X_Pos == Limit_Pos_Rear && Motor_Z_Pos == Limit_Pos_Left && Step_X_flag == OFF)
   {
      cycle_flag = false;
      a_flag = false;
      b_flag = false;
      
      Limit_Pos_Right = (Limit_Pos_Left - REBOUND_Z);
      Limit_Right_LED_On();
      Feed_Right(a_flag, b_flag);
   }

   else if (Motor_X_Pos == Limit_Pos_Rear && Motor_Z_Pos == Limit_Pos_Right && Step_Z_flag == OFF)
   {
      a_flag = false;
      b_flag = false;

      Pass_Nr++;
      Print();
      Rapid_Feed_Front(a_flag, b_flag);
   }
}

/////////////////////////////////////////////////////////////////////////////////////////////////
void Feed_Int_Front()
{              
//
}

////////////////////////////////////////////////////////////////////////////////////////////////
void Feed_Int_Rear() 
{
//
}
