tepmehatop/Lathe-cnc-controller-stm32/ELS_Display/src/uart_protocol.cpp

/**
 * @file uart_protocol.cpp
 * @brief Реализация UART протокола для связи с Arduino Mega
 */

#include "uart_protocol.h"
#include "display_config.h"
#include <string.h>

// ============================================================================
// UartProtocol Implementation
// ============================================================================

UartProtocol::UartProtocol()
    : serial_(nullptr)
    , rx_index_(0)
    , data_update_callback_(nullptr)
    , screen_change_callback_(nullptr)
    , alert_callback_(nullptr)
    , alert_dismiss_callback_(nullptr)
    , gcode_response_callback_(nullptr)
{
    memset(&data_, 0, sizeof(data_));
    memset(rx_buffer_, 0, sizeof(rx_buffer_));
    data_dirty_ = false;

    // Значения по умолчанию
    data_.mode = MODE_FEED;        // Arduino boots in M1 (Feed/Manual)
    data_.submode = SUBMODE_MANUAL;
    data_.thread_mm = 150;  // 1.50 мм
    data_.rpm = 1500;
    data_.sphere_radius = 1000;    // 10mm radius = 20mm diameter
}

void UartProtocol::begin(HardwareSerial& serial, uint32_t baud_rate)
{
    serial_ = &serial;
    serial_->begin(baud_rate, SERIAL_8N1, UART_RX_PIN, UART_TX_PIN);

    Serial.println("UART Protocol initialized");
    Serial.printf("RX: GPIO%d, TX: GPIO%d, Baud: %d\n", UART_RX_PIN, UART_TX_PIN, baud_rate);

    // Отправляем READY
    sendReady();
}

void UartProtocol::process()
{
    if (!serial_) return;

    while (serial_->available()) {
        char c = serial_->read();
        if (rx_mute_) continue;

        if (c == '\n' || c == '\r') {
            if (rx_index_ > 0) {
                rx_buffer_[rx_index_] = '\0';
                parseCommand(rx_buffer_);
                rx_index_ = 0;
            }
        }
        else if (rx_index_ < sizeof(rx_buffer_) - 1) {
            rx_buffer_[rx_index_++] = c;
        }
    }
    // Вызвать callback один раз после обработки всех доступных байт.
    // Это предотвращает N перерисовок UI при пачке из N команд (например SendAll).
    if (data_dirty_ && data_update_callback_) {
        data_dirty_ = false;
        // Дамп состояния для автотестов (tools/run_all_tests.py) — одна строка
        Serial.printf("[STATE] mode=%d sub=%d sm=%d feed=%d afeed=%d ap=%d "
                      "pass=%d/%d rpm=%d lim=%d%d%d%d run=%d\n",
                      (int)data_.mode, (int)data_.submode, (int)data_.select_menu,
                      (int)data_.feed_mm, (int)data_.afeed_mm, (int)data_.ap,
                      (int)data_.pass_nr, (int)data_.pass_total, (int)data_.rpm,
                      (int)data_.limits.left, (int)data_.limits.right,
                      (int)data_.limits.front, (int)data_.limits.rear,
                      (int)data_.is_running);
        data_update_callback_(data_);
    }
}

void UartProtocol::parseCommand(const char* cmd)
{
    // Команды имеют формат <CMD:PARAMS>
    if (cmd[0] != '<') return;

    char buffer[128];
    strncpy(buffer, cmd + 1, sizeof(buffer) - 1);
    buffer[sizeof(buffer) - 1] = '\0';

    // Убрать закрывающую скобку
    char* end = strchr(buffer, '>');
    if (end) *end = '\0';

    // Обработка команд без параметров (нет ':')
    char* colon = strchr(buffer, ':');
    if (!colon) {
        if (strcmp(buffer, "OK") == 0) {
            if (gcode_response_callback_) gcode_response_callback_(true, nullptr);
        }
        return;
    }

    *colon = '\0';
    const char* command = buffer;
    const char* params = colon + 1;

    // Обработка команд
    if (strcmp(command, "MODE") == 0) {
        parseMode(params);
    }
    else if (strcmp(command, "SUBMODE") == 0) {
        parseSubMode(params);
    }
    else if (strcmp(command, "FEED") == 0) {
        parseFeed(params);
    }
    else if (strcmp(command, "AFEED") == 0) {
        parseAFeed(params);
    }
    else if (strcmp(command, "THREAD") == 0) {
        parseThread(params);
    }
    else if (strcmp(command, "POS_Z") == 0) {
        parsePosZ(params);
    }
    else if (strcmp(command, "POS_X") == 0) {
        parsePosX(params);
    }
    else if (strcmp(command, "RPM") == 0) {
        parseRPM(params);
    }
    else if (strcmp(command, "LIMITS") == 0) {
        parseLimits(params);
    }
    else if (strcmp(command, "SEL") == 0) {
        parseSel(params);
    }
    else if (strcmp(command, "SCREEN") == 0) {
        parseScreen(params);
    }
    else if (strcmp(command, "PING") == 0) {
        sendReady();  // Отвечаем READY, чтобы Arduino прислал полное состояние
    }
    else if (strcmp(command, "PASS") == 0) {
        parsePass(params);
    }
    else if (strcmp(command, "AP") == 0) {
        parseAp(params);
    }
    else if (strcmp(command, "PH") == 0) {
        parsePh(params);
    }
    else if (strcmp(command, "ANGLE") == 0) {
        parseAngle(params);
    }
    else if (strcmp(command, "CONE") == 0) {
        parseCone(params);
    }
    else if (strcmp(command, "CONE_ANGLE") == 0) {
        parseConeAngle(params);
    }
    else if (strcmp(command, "DIVN") == 0) {
        parseDivN(params);
    }
    else if (strcmp(command, "DIVM") == 0) {
        parseDivM(params);
    }
    else if (strcmp(command, "BAR") == 0) {
        parseBar(params);
    }
    else if (strcmp(command, "PASS_SPHR") == 0) {
        parsePassSphr(params);
    }
    else if (strcmp(command, "SPHERE") == 0) {
        parseSphere(params);
    }
    else if (strcmp(command, "STATE") == 0) {
        parseState(params);
    }
    else if (strcmp(command, "ALERT") == 0) {
        parseAlert(params);
    }
    else if (strcmp(command, "THREAD_NAME") == 0) {
        parseThreadName(params);
    }
    else if (strcmp(command, "RPM_LIM") == 0) {
        parseRpmLim(params);
    }
    else if (strcmp(command, "THREAD_CYCL") == 0) {
        parseThreadCycl(params);
    }
    else if (strcmp(command, "THREAD_TRAVEL") == 0) {
        parseThreadTravel(params);
    }
    else if (strcmp(command, "SELECTMENU") == 0) {
        parseSelectMenu(params);
    }
    else if (strcmp(command, "OTSKOK_Z") == 0) {
        parseOtskokZ(params);
    }
    else if (strcmp(command, "TENSION_Z") == 0) {
        parseTensionZ(params);
    }
    else if (strcmp(command, "DIAM_X") == 0) {
        parseDiamX(params);
    }
    else if (strcmp(command, "PASS_FIN") == 0) {
        parsePassFin(params);
    }
    else if (strcmp(command, "CONE_THR") == 0) {
        parseConeThr(params);
    }
    else if (strcmp(command, "CUTTER_W") == 0) {
        parseCutterW(params);
    }
    else if (strcmp(command, "CUTTING_W") == 0) {
        parseCuttingW(params);
    }
    else if (strcmp(command, "AXIS_EDIT") == 0) {
        data_.axis_edit = (uint8_t)atoi(params);
    }
    else if (strcmp(command, "POS") == 0) {
        long v[12] = {0, 0, 0, 0, 0, 0, 0, 0, 0, 0, 0, 150};
        int n = sscanf(params, "%ld,%ld,%ld,%ld,%ld,%ld,%ld,%ld,%ld,%ld,%ld,%ld", &v[0], &v[1], &v[2], &v[3],
                       &v[4], &v[5], &v[6], &v[7], &v[8], &v[9], &v[10], &v[11]);
        if (n == 9 || n == 12) {                        // 9 — STM32 без доводки/контроля шагов
            for (int i = 0; i < 12; i++) data_.pos_cfg[i] = (int32_t)v[i];
            data_.pos_valid = 1;
        }
    }
    else if (strcmp(command, "CFG") == 0) {
        long v[9];
        if (sscanf(params, "%ld,%ld,%ld,%ld,%ld,%ld,%ld,%ld,%ld",
                   &v[0], &v[1], &v[2], &v[3], &v[4], &v[5], &v[6], &v[7], &v[8]) == 9) {
            for (int i = 0; i < 9; i++) data_.cfg[i] = (int32_t)v[i];
            data_.cfg_valid = 1;
        }
    }
    else if (strncmp(command, "CAL_", 4) == 0) {
        if (!strcmp(command, "CAL_RES")) {
            long s = 0, b = 0, k = 0; char ax = 0;
            if (sscanf(params, "%c,%ld,%ld,%ld", &ax, &s, &b, &k) == 4) {
                data_.cal_ax = ax; data_.cal_screw_um = s; data_.cal_bl_um = b; data_.cal_k_nm = k;
                data_.cal_state = 2;
            }
        } else {
            // CAL_RUN — идёт, CAL_STEP:<фаза> — фаза калибровки по индикатору выполнена, CAL_ERR — ошибка
            data_.cal_state = !strcmp(command, "CAL_RUN") ? 1 : !strcmp(command, "CAL_STEP") ? 4 : 3;
            if (data_.cal_state == 1) data_.cal_ax = params[0];
            strncpy(data_.cal_text, params, sizeof(data_.cal_text) - 1);
            data_.cal_text[sizeof(data_.cal_text) - 1] = 0;
        }
        data_.cal_seq++;
    }
    else if (strcmp(command, "CFG_RES") == 0) {
        strncpy(data_.cfg_res, params, sizeof(data_.cfg_res) - 1);
        data_.cfg_res[sizeof(data_.cfg_res) - 1] = 0;
        data_.cfg_res_seq++;
    }
    else if (strcmp(command, "ERR") == 0) {
        if (gcode_response_callback_) gcode_response_callback_(false, params);
    }
    else if (strcmp(command, "LCD2004") == 0) {
        parseLCD2004(params);
    }
}

// <LCD2004:...> — копия состояния, которое STM32 выводит на LCD2004.
// Только печать в USB для автотестов (сверка старого и нового дисплея).
void UartProtocol::parseLCD2004(const char* params)
{
    int mode, sub, sm, feed, afeed, ap, pass_nr, pass_total, ph, pass_fin, thr, tooth_n, tooth_c;
    int n = sscanf(params, "%d,%d,%d,%d,%d,%d,%d,%d,%d,%d,%d,%d,%d",
                   &mode, &sub, &sm, &feed, &afeed, &ap, &pass_nr, &pass_total,
                   &ph, &pass_fin, &thr, &tooth_n, &tooth_c);
    if (n == 13) {
        Serial.printf("[LCD2004] mode=%d sub=%d sm=%d feed=%d afeed=%d ap=%d "
                      "pass=%d/%d ph=%d fin=%d thr=%d tooth=%d/%d\n",
                      mode, sub, sm, feed, afeed, ap, pass_nr, pass_total,
                      ph, pass_fin, thr, tooth_n, tooth_c);
    }
}

void UartProtocol::parseMode(const char* params)
{
    int mode = atoi(params);
    Serial.printf("[MODE] recv=%d prev=%d\n", mode, (int)data_.mode);
    if (mode >= MODE_FEED && mode <= MODE_RESERVE) {
        data_.mode = (LatheMode)mode;
        data_dirty_ = true;
    }
}

void UartProtocol::parseSubMode(const char* params)
{
    int submode = atoi(params);
    if (submode >= SUBMODE_INTERNAL && submode <= SUBMODE_EXTERNAL) {
        data_.submode = (LatheSubMode)submode;
        data_dirty_ = true;
    }
}

void UartProtocol::parseFeed(const char* params)
{
    data_.feed_mm = atoi(params);
    data_dirty_ = true;
}

void UartProtocol::parseAFeed(const char* params)
{
    data_.afeed_mm = atoi(params);
    data_dirty_ = true;
}

void UartProtocol::parseThread(const char* params)
{
    data_.thread_mm = atoi(params);
    data_dirty_ = true;
}

void UartProtocol::parsePosZ(const char* params)
{
    data_.pos_z = atol(params);
    data_dirty_ = true;
    // DBG: считаем сколько раз приходит POS_Z
    static uint32_t dbg_pos_cnt = 0;
    static uint32_t dbg_pos_t   = 0;
    dbg_pos_cnt++;
    uint32_t now = millis();
    if (now - dbg_pos_t >= 3000) {
        Serial.printf("[POS_Z] %lu times in 3s, last=%ld\n",
                      (unsigned long)dbg_pos_cnt, (long)data_.pos_z);
        dbg_pos_t = now; dbg_pos_cnt = 0;
    }
}

void UartProtocol::parsePosX(const char* params)
{
    data_.pos_x = atol(params);
    data_dirty_ = true;
}

void UartProtocol::parseRPM(const char* params)
{
    data_.rpm = atoi(params);
    data_dirty_ = true;
}

void UartProtocol::parseLimits(const char* params)
{
    // Формат: "1,0,0,1" (L,R,F,B)
    int values[4] = {0};
    sscanf(params, "%d,%d,%d,%d", &values[0], &values[1], &values[2], &values[3]);

    data_.limits.left = values[0];
    data_.limits.right = values[1];
    data_.limits.front = values[2];
    data_.limits.rear = values[3];

    data_dirty_ = true;
}

void UartProtocol::parseSel(const char* params)
{
    int m = 0, sub = 0;
    sscanf(params, "%d,%d", &m, &sub);
    data_.sel_mode = (m >= 1 && m <= 8) ? m : 0;
    data_.sel_sub  = (sub >= 1 && sub <= 3) ? sub : 0;
    data_dirty_ = true;
}

void UartProtocol::parseScreen(const char* params)
{
    int screen = atoi(params);
    if (screen_change_callback_) {
        screen_change_callback_(screen);
    }
}

void UartProtocol::sendCommand(const char* cmd, const char* params)
{
    if (!serial_) return;

    serial_->print('<');
    serial_->print(cmd);
    if (params) {
        serial_->print(':');
        serial_->print(params);
    }
    serial_->println('>');

    Serial.printf("UART TX: <%s%s%s>\n", cmd, params ? ":" : "", params ? params : "");
}

void UartProtocol::sendButtonPress(const char* button_name)
{
    sendCommand("TOUCH", button_name);
}

void UartProtocol::sendReady()
{
    sendCommand("READY");
    // Тип дисплея: STM32 сверяет его с ELS_DISPLAY_TYPE в els_config.h
    char code[8];
    snprintf(code, sizeof(code), "%d", DISPLAY_TYPE_CODE);
    sendCommand("DISP", code);
}

void UartProtocol::sendError(const char* message)
{
    sendCommand("ERROR", message);
}

void UartProtocol::sendPong()
{
    sendCommand("PONG");
}

void UartProtocol::sendGCodeLine(const char* line)
{
    sendCommand("GCODE", line);
}

void UartProtocol::parsePass(const char* params)
{
    // Формат: "nr,total", e.g. "3,10"
    sscanf(params, "%hu,%hu", &data_.pass_nr, &data_.pass_total);
    data_dirty_ = true;
}

void UartProtocol::parseAp(const char* params)
{
    data_.ap = atoi(params);
    Serial.printf("[AP] recv=%d\n", data_.ap);
    data_dirty_ = true;
}

void UartProtocol::parsePh(const char* params)
{
    data_.ph = (uint8_t)atoi(params);
    data_dirty_ = true;
}

void UartProtocol::parseAngle(const char* params)
{
    data_.spindle_angle = atoi(params);
    data_dirty_ = true;
}

void UartProtocol::parseCone(const char* params)
{
    data_.cone_idx = (uint8_t)atoi(params);
    data_dirty_ = true;
}

void UartProtocol::parseConeAngle(const char* params)
{
    data_.cone_angle = (int16_t)atoi(params);
    data_dirty_ = true;
}

void UartProtocol::parseDivN(const char* params)
{
    data_.total_tooth = (uint16_t)atoi(params);
    data_dirty_ = true;
}

void UartProtocol::parseDivM(const char* params)
{
    data_.current_tooth = (uint16_t)atoi(params);
    data_dirty_ = true;
}

void UartProtocol::parseBar(const char* params)
{
    data_.bar_r = atoi(params);
    data_dirty_ = true;
}

void UartProtocol::parsePassSphr(const char* params)
{
    data_.pass_total_sphr = (uint16_t)atoi(params);
    data_dirty_ = true;
}

void UartProtocol::parseSphere(const char* params)
{
    data_.sphere_radius = (int16_t)atoi(params);
    data_dirty_ = true;
}

void UartProtocol::parseState(const char* params)
{
    // STATE:run  → is_running=true
    // STATE:stop → is_running=false
    // STATE:N    → bit 0 = running
    if (strcmp(params, "run") == 0) {
        data_.is_running = true;
    } else if (strcmp(params, "stop") == 0) {
        data_.is_running = false;
    } else {
        int bits = atoi(params);
        data_.is_running = (bits & 1) != 0;
    }
    data_dirty_ = true;
}

void UartProtocol::parseAlert(const char* params)
{
    // Типы алертов от Arduino:
    // 1 = УСТАНОВИТЕ УПОРЫ (err_1_flag)
    // 2 = УСТАНОВИТЕ СУППОРТ В ИСХОДНУЮ ПОЗИЦИЮ (err_2_flag)
    // 3 = ОПЕРАЦИЯ ЗАВЕРШЕНА (Complete_flag)
    // 4 = Установите джойстик в нейтральное положение (err_0_flag)
    if (!alert_callback_) return;

    // If params is not purely numeric, treat as literal alert string
    bool is_numeric = (params[0] != '\0') && (params[0] == '-' || (params[0] >= '0' && params[0] <= '9'));
    if (!is_numeric) {
        alert_callback_(params);
        return;
    }

    int type = atoi(params);
    alert_from_core_ = (type >= 1 && type <= 4);
    switch (type) {
        case 0: // Скрыть алерт (Arduino сбросил флаги ошибки)
                if (alert_dismiss_callback_) alert_dismiss_callback_();
                break;
        case 1: if (alert_callback_) alert_callback_("\xD0\xA3\xD0\xA1\xD0\xA2\xD0\x90\xD0\x9D\xD0\x9E\xD0\x92\xD0\x98\xD0\xA2\xD0\x95\n\xD0\xA3\xD0\x9F\xD0\x9E\xD0\xA0\xD0\xAB!");
                // УСТАНОВИТЕ УПОРЫ!
                break;
        case 2: if (alert_callback_) alert_callback_("УСТАНОВИТЕ СУППОРТ\nВ ИСХОДНУЮ ПОЗИЦИЮ!");
                // УСТАНОВИТЕ СУППОРТ В ИСХОДНУЮ ПОЗИЦИЮ!
                break;
        case 3: if (alert_callback_) alert_callback_("\xD0\x9E\xD0\x9F\xD0\x95\xD0\xA0\xD0\x90\xD0\xA6\xD0\x98\xD0\xAF\n\xD0\x97\xD0\x90\xD0\x92\xD0\x95\xD0\xA0\xD0\xA8\xD0\x95\xD0\x9D\xD0\x90!");
                // ОПЕРАЦИЯ ЗАВЕРШЕНА!
                break;
        case 4: if (alert_callback_) alert_callback_("Установите джойстик\nв нейтральное положение");  // 2 строки — поле алерта на 2 строки
                // Установите джойстик в нейтральное положение
                break;
        default:
            Serial.printf("Unknown alert type: %d\n", type);
            break;
    }
    alert_from_core_ = false;
}

void UartProtocol::parseThreadName(const char* params)
{
    strncpy(data_.thread_name, params, sizeof(data_.thread_name) - 1);
    data_.thread_name[sizeof(data_.thread_name) - 1] = '\0';
    data_dirty_ = true;
}

void UartProtocol::parseRpmLim(const char* params)
{
    data_.rpm_limit = (int16_t)atoi(params);
    data_dirty_ = true;
}

void UartProtocol::parseThreadCycl(const char* params)
{
    data_.thread_cycles = (int16_t)atoi(params);
    data_dirty_ = true;
}

void UartProtocol::parseThreadTravel(const char* params)
{
    data_.thread_travel = (int16_t)atoi(params);
    data_dirty_ = true;
}

void UartProtocol::parseSelectMenu(const char* params)
{
    int sm = atoi(params);
    if (sm >= 1 && sm <= 3) {
        data_.select_menu = (uint8_t)sm;
        data_dirty_ = true;
    }
}

void UartProtocol::parseOtskokZ(const char* params)
{
    data_.otskok_z = (int32_t)atol(params);
    data_dirty_ = true;
}

void UartProtocol::parseTensionZ(const char* params)
{
    data_.tension_z = (int32_t)atol(params);
    data_dirty_ = true;
}

void UartProtocol::parseDiamX(const char* params)
{
    data_.diam_x = (int32_t)atol(params);
    data_dirty_ = true;
}

void UartProtocol::parsePassFin(const char* params)
{
    data_.pass_fin = (uint8_t)atoi(params);
    data_dirty_ = true;
}

void UartProtocol::parseConeThr(const char* params)
{
    data_.cone_thr = (atoi(params) != 0);
    data_dirty_ = true;
}

void UartProtocol::parseCutterW(const char* params)
{
    data_.cutter_w = (int16_t)atoi(params);
    data_dirty_ = true;
}

void UartProtocol::parseCuttingW(const char* params)
{
    data_.cutting_w = (int16_t)atoi(params);
    data_dirty_ = true;
}

// ============================================================================
// DisplayFormatter Implementation
// ============================================================================

void DisplayFormatter::formatFeed(char* buffer, int16_t feed_mm_x100)
{
    snprintf(buffer, 16, "%d.%02d", feed_mm_x100 / 100, abs(feed_mm_x100 % 100));
}

void DisplayFormatter::formatThread(char* buffer, int16_t thread_mm_x100)
{
    snprintf(buffer, 16, "%d.%02d", thread_mm_x100 / 100, abs(thread_mm_x100 % 100));
}

void DisplayFormatter::formatPosition(char* buffer, int32_t pos_um)
{
    int32_t mm = pos_um / 1000;
    int32_t frac = abs(pos_um % 1000);

    if (pos_um < 0 && mm == 0) {
        snprintf(buffer, 16, "-%ld.%02ld", abs(mm), frac / 10);
    } else if (pos_um > 0) {
        snprintf(buffer, 16, "+%ld.%02ld", mm, frac / 10);
    } else {
        snprintf(buffer, 16, "%ld.%02ld", mm, frac / 10);
    }
}

void DisplayFormatter::formatRPM(char* buffer, uint16_t rpm)
{
    snprintf(buffer, 16, "%d", rpm);
}

const char* DisplayFormatter::getModeName(LatheMode mode)
{
    switch (mode) {
        case MODE_FEED:    return "Синхронная";
        case MODE_AFEED:   return "Асинхронная";
        case MODE_THREAD:  return "Резьба";
        case MODE_CONE_L:  return "Конус <";
        case MODE_CONE_R:  return "Конус >";
        case MODE_SPHERE:  return "Шар";
        case MODE_DIVIDER: return "Делитель";
        case MODE_RESERVE: return "Резерв";
        default:           return "???";
    }
}

const char* DisplayFormatter::getModeShortName(LatheMode mode)
{
    static char buffer[8];
    snprintf(buffer, sizeof(buffer), "M%d", (int)mode);
    return buffer;
}

const char* DisplayFormatter::getSubModeName(LatheSubMode submode)
{
    switch (submode) {
        case SUBMODE_INTERNAL: return "Внутренняя";
        case SUBMODE_MANUAL:   return "Ручная";
        case SUBMODE_EXTERNAL: return "Наружная";
        default:               return "???";
    }
}

const char* DisplayFormatter::getSubModeShortName(LatheSubMode submode)
{
    static char buffer[8];
    snprintf(buffer, sizeof(buffer), "S%d", (int)submode);
    return buffer;
}
