tepmehatop/Lathe-cnc-controller-stm32/Drivers/drv_inputs.cpp

/**
 * @file  drv_inputs.cpp
 * @brief Драйвер GPIO входов — Этап 5
 *
 * Дебаунс 12мс (4 выборки по 3мс): только устойчивый сигнал принимается.
 *
 * Все входы: INPUT_PULLUP (внутренняя подтяжка ~40кОм к 3.3В).
 * Без подключённого железа пины держатся HIGH → нет ложных нажатий.
 * При подключении внешней подтяжки 1-10кОм к 3.3В она работает параллельно
 * с внутренней ~40кОм — итоговое сопротивление сохраняет корректную работу.
 *
 * Джойстик    PC4-PC8:    Active LOW, INPUT_PULLUP
 * Кнопки меню PG0-PG4:    Active LOW, INPUT_PULLUP
 * Лимиты BTN  PF0,2,4,6:  Active LOW, INPUT_PULLUP
 * Лимиты LED  PF1,3,5,7:  Active HIGH output
 * Submode SW  PG5-PG7:    Active LOW, INPUT_PULLUP
 * Mode SW     PG8-PG15:   Active LOW, INPUT_PULLUP — байт через IDR
 */

#include "drv_inputs.h"
#include "../Core/els_config.h"
#include <Arduino.h>

// ============================================================
// Дебаунс: 4 выборки по 3мс = 12мс стабилизация
// ============================================================
#define DEBOUNCE_MS         3
#define DEBOUNCE_PRESSED    0xFFu   // все 8 выборок (24мс) = нажато; фильтрует плавающие пины

// Сдвиговые регистры (младшие 4 бита = 4 последних выборки)
static uint8_t s_joy_raw[5];   // LEFT RIGHT UP DOWN RAPID
static uint8_t s_btn_raw[5];   // LEFT RIGHT UP DOWN SELECT
static uint8_t s_lim_raw[4];   // LEFT RIGHT FRONT REAR
static uint8_t s_sub_raw[3];   // INT MAN EXT

// Дебаунсированные состояния
static JoyState_t  s_joy     = JOY_NONE;
static BtnState_t  s_btn     = BTN_NONE;
static LimState_t  s_lim     = LIM_NONE;
static uint8_t     s_submode = 0;
static uint8_t     s_mode    = 0;

static uint32_t s_last_sample = 0;
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
