tepmehatop/Lathe-cnc-controller-stm32/(commit log)

2026-04-05 init: скелет проекта ELS на STM32F407
    - platformio.ini: окружения для STM32F4DISCOVERY и ESP32-S3 JC4827W543
    - Core/els_config.h: единый конфиг файл (все пины, флаги, параметры механики)
    - docs/pinout.html: интерактивная схема подключения (3 стиля: блок-диаграмма,
    chip view, таблица пинов с поиском и сортировкой)
    - .gitignore: build артефакты, AGREEMENTS.md (не публикуется)
    Платформа: STM32F407VGT6 @ 168МГц, STM32duino Arduino Core
2026-04-05 docs: визуальная схема подключения и рекомендации по шилду
    - docs/schematic.html — canvas-схема в стиле ELS_V7.jpg: плата STM32F4DISCOVERY
    в центре, вся периферия по бокам, компоненты (резисторы, конденсаторы, LED)
    на линиях подключения, pan/zoom/touch, предупреждения о конфликтах пинов
    - docs/shield_recommendations.md — руководство для разработчика шилда:
    уровни логики, таблицы резисторов и конденсаторов, TVS защита, BJT для зумм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
2026-04-06 docs: добавить визуальную схему подключения первым табом в pinout.html
    Полная интерактивная схема в стиле ELS_V7.jpg:
    - STM32F4DISCOVERY в центре со всеми пинами и подписями
    - Периферия слева/справа: DRO, LCD, энкодеры, джойстик, зуммер,
    ESP32, драйверы моторов, тахометр, лимиты, переключатели
    - Компоненты на линиях: резисторы (100Ω/33Ω/470Ω/1кΩ/4.7кΩ/10кΩ),
    конденсаторы (100нФ/10нФ), светодиоды, транзистор BC547 (зуммер)
    -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
2026-04-06 fix(docs): устранить наложения и добавить HiDPI рендеринг в canvas-схеме
    - devicePixelRatio: canvas.width/height умножаются на dpr, ctx.scale(dpr)
    → текст чёткий на Retina/HiDPI при любом zoom
    - Уникальные x-lane для каждого провода (объекты T/TR):
    Left: PA3=1220, PA9=1175, PA10=1140, PB6=1080, PB7=1040,
    PA0=990, PA1=950, PC2=900, PC3=860, PD0=820... и т.д.
    Right: PE0=1720, PE1=1756, PE8=1720, PE9-PE11=1720/56/92...
    Компоненты (pullup, резисторы, LED) на своих колонках — без пересечений
    - routeL/routeR хелпер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
2026-04-06 feat(etap1): скелет проекта STM32 — компилируется
    - src/main.cpp: точка входа setup()/loop() → ELS_Init()/ELS_Loop()
    - Core/els_main.cpp/h: инициализация и главный цикл
    - Core/els_state.cpp/h: глобальное состояние станка (режимы, позиции, параметры)
    - Drivers/drv_dro.cpp/h: заглушка DRO HS800-2 (Этап 2)
    - Drivers/drv_display.cpp/h: заглушка ESP32 дисплея (Этап 3)
    - Drivers/drv_lcd2004.cpp/h: заглушка LCD2004 I2C (Этап 4)
    - Drivers/drv_encoder.cpp/h: заглушки энкодеров шпинделя и ручного (Этапы 5,6)
    - D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
2026-04-06 feat(etap2): драйвер DRO HS800-2 — парсер пакетов + CRC16/MODBUS
    - HardwareSerial(PA3, PA2) = USART2 RX, 57600/8N1
    - Interrupt-driven приём (HardwareSerial STM32duino) — CPU не блокируется
    - Парсер: поиск SOF(0xFE), накопление 29 байт, проверка EOF(0xEF)
    - CRC16/MODBUS: bytes[1..25], сверка с bytes[26..27]
    - Ресинхронизация при потере пакета (поиск SOF в буфере)
    - X = bytes[6..9] int32 LE, Y = bytes[10..13] int32 LE
    - Кнопки: bytes[18], bytes[19]
    - Счётчики pkt_ok / pkt_err для диагностики
    - els_main: знак инвертирован (как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
2026-04-06 feat(etap3): драйвер ESP32 дисплея — UART8 + полный протокол
    - HardwareSerial(PE1, PE0) = UART8 RX/TX, 115200/8N1
    - TX: SendCmd/SendInt/SendInt2 → формат <CMD:val>\n
    - Все команды протокола: POS_Z/POS_X, MODE, SUBMODE, FEED, AFEED,
    RPM, OTSKOK_Z, TENSION_Z, LIMITS, ALERT, SELECTMENU, ANGLE, DIAM_X
    - SendAll(): полное состояние при READY/PONG от ESP32
    - RX парсер: <TOUCH:*>, <READY>, <PONG> → DispRxCmd_t
    - DispRxCallback_t: регистрация обработчика входящих команд (Этап 7)
    - Знак позиций: els.pos уже инвертирован → отправляем -pos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
2026-04-06 feat(etap4): драйвер LCD2004 — I2C1/PCF8574 HD44780 4-bit протокол
2026-04-06 feat(etap5): GPIO входы — джойстик, кнопки меню, лимиты, переключатели режима, дебаунс 12мс
2026-04-06 feat(etap6): энкодеры — TIM5 квадратурный счётчик шпинделя (×4, RPM), EXTI ручной энкодер
2026-04-06 feat(etap7): шаговые двигатели — TIM1 HardwareTimer PWM, STEP/DIR/EN, позиция в ISR callback
2026-04-06 feat(etap8-9): замкнутый контур ELS (FEED/AFEED/THREAD/CONE) + Serial Monitor команды
2026-04-06 feat(etap10): README.md + симулятор DRO HS800-2 (Arduino sketch, 4 режима)
2026-04-13 feat(etap10-14): физ. кнопки, меню, таблицы резьб/конусов, Serial Monitor, fix LCD white screen
    Этап 10-11: физические кнопки и меню
    - els_menu.cpp/h: ELS_Menu_Process() — ротарный переключатель режимов M1-M8
    (PG8-PG15), переключатель подрежимов (PG5-PG7), навигация UP/DOWN/SELECT с авто-повтором
    - Смена режима: сброс Ap=0, Pass_Nr=1, select_menu=1, ELS_Control_Stop()
    - _key_up/_key_down: редактирование Thread_Step, Cone_Step, Ap, Ph, Sph_R_mm, Total_Tooth
    Этап 12: таблицы резьб и конусов
    - els_tables.cpp/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
    [drv_display.cpp, drv_display.h, drv_lcd2004.cpp, drv_lcd2004.h, els_config.h, els_control.cpp, els_main.cpp, els_menu.cpp]
2026-04-13 fix(display): приоритетная отправка MODE/SUBMODE/SELECTMENU на ESP32
    DRV_Display_SendCmd() дропал команды если TX буфер занят (< 32 байт).
    При высокочастотных POS обновлениях буфер мог быть занят в момент
    ответа на touch команду → ESP32 не получал MODE/SUBMODE → режим
    не переключался на новом дисплее хотя на LCD2004 уже был новый.
    Добавлена _SendCmdPriority() — ждёт освобождения буфера до 10мс.
    Используется для MODE, SUBMODE, SELECTMENU.
    [drv_display.cpp]
2026-04-13 Fix: TOUCH_PARAM_OK обработка + интервал 250мс для ESP32
    - els_menu.cpp: добавлен case TOUCH_PARAM_OK → _key_select()
    Двойной тач row6 теперь переключает select_menu (саб-режим).
    Ранее команда игнорировалась → подрежим никогда не менялся.
    - els_main.cpp: интервал отправки позиций/RPM на ESP32 100→250мс
    (совпадает с оригинальным Arduino, снижает нагрузку на ESP32)
    [els_main.cpp, els_menu.cpp]
2026-04-14 fix: отправлять AP:0 на ESP32 при смене режима через переключатель
    _switch_mode_hw сбрасывал els.Ap=0 но не уведомлял ESP32.
    Стало: DRV_Display_SendInt("AP", 0) после смены режима —
    устраняет мигание Съёма в row3 (режимы 1-2) и row5 (Конус).
    [els_menu.cpp]
2026-04-14 fix: _set_mode (touch) теперь тоже сбрасывает Ap=0 и шлёт AP:0
    [els_menu.cpp]
2026-04-21 fix(display): все отправки приоритетные + ось Y + залипание режимов ESP32
    STM32 (drv_display.cpp):
    - DRV_Display_SendCmd/SendInt/SendInt2 теперь приоритетные (ждут буфер до 10мс)
    вместо дропа → AP, FEED и все остальные данные гарантированно доходят до ESP32
    ESP32 (uart_protocol.h/.cpp, main.cpp):
    - setModeOptimistic(): при нажатии кнопки режима сразу обновляет data_.mode,
    иначе POS_Z callbacks откатывали s_last_mode к устаревшему значению
    - Метки оси Z → Y во всех layout-фу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
    [drv_display.cpp]
2026-04-22 fix(inputs/menu): фикс дребезга Row3 AP — DEBOUNCE 8 выборок + UP⊕DOWN взаимное исключение
    Плавающие пины PG_2/PG_3 (BTN_UP/BTN_DOWN без подключённого железа) регистрировали
    одновременные нажатия → AP шагал вверх-вниз каждые ~3мс.
    - drv_inputs.cpp: DEBOUNCE_PRESSED 0x0Fu→0xFFu (4→8 выборок = 24мс стабилизации)
    - els_menu.cpp: если BTN_UP и BTN_DOWN одновременно → обнуляем btn (взаимное исключение)
    [drv_inputs.cpp, els_menu.cpp]
2026-04-22 feat(cone): Bresenham X-slave для конусного режима
    - drv_stepper: PE13 переключается в GPIO OUTPUT при входе в конус;
    X STEP-импульсы генерируются вручную в ISR по Bresenham-счётчику
    (Cs_Div/Cm_Div из Cone_Info[Cone_Step])
    - els_control: SetConeRatio вызывается при старте конуса; убран TODO-плейсхолдер
    - ELS_Control_Stop() теперь вызывает DRV_Stepper_ClearCone()
2026-04-22 fix(cone): обработка CONE:N от ESP32 + подтверждение обратно
    Параметрическая команда CONE:N приходила с ESP32 (sub_edit/double-tap),
    но STM32 не имел handler'а → Cone_Step не менялся → display возвращался
    на старое значение.
    - els_menu.cpp: добавлен handler CONE:N → обновляет els.Cone_Step,
    отправляет CONE и CONE_ANGLE обратно на ESP32
    [els_menu.cpp]
2026-04-22 fix(menu): подтверждения FEED/AFEED/AP/THREAD_STEP обратно на ESP32
    При получении команд от ESP32 STM32 сохранял значения, но не отправлял
    подтверждение → ESP32 data_ оставалась старой → при выходе из edit mode
    отображение откатывалось на старое значение.
    - FEED:N, AFEED:N, AP:N → сохранить + немедленно отправить обратно на ESP32
    - THREAD_STEP:N → новый handler: обновить Thread_Step + отправить
    THREAD_NAME, THREAD, RPM_LIM, THREAD_TRAVEL, THREAD_CYCL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
    [els_menu.cpp]
2026-04-27 fix(thread): send THREAD_NAME/THREAD/RPM_LIM/THREAD_CYCL on mode switch + key navigation
    - _set_mode(MODE_THREAD) and _switch_mode_hw(MODE_THREAD) now send all thread
    data fields to ESP32 on mode switch (was missing, ESP32 showed default 1.50mm)
    - _key_up/_key_down send thread data after Thread_Step or Ph change
    - TOUCH_KEY_UP/DN handlers in _on_display_rx send thread data after Thread_Step change
    - Added CLAUDE.md with project rules (always commit+push, axis mapping, protocol units)
    - Copied ELS_Display ESP32 sources into ELS_Display/src + ELS_Display/include
    [display_config.h, els_menu.cpp, main.cpp, uart_protocol.cpp, uart_protocol.h, ui_common.h, ui_design_3_industrial.cpp]
2026-04-28 feat: bidirectional sync test suite (400 cases + BTN injection)
    Direction A (200 cases): PC sends commands to STM32 VCP → STM32 drives ESP32 display.
    Direction B (200 cases): PC sends <BTN:X> to ESP32 → ESP32 forwards <TOUCH:X> to STM32 → STM32 responds.
    ESP32 firmware changes (7e2_Mod_LCD4.3_v1.3):
    - <BTN:name> injection: PC → ESP32 USB CDC → TOUCH forwarded to STM32
    - Debug traces: parseAFeed prints raw/int/int16, mode tap prints afeed_mm_before
    - test_bidir.py: full 400-case runner, takes screenshots, logs to JSONL
    Test docs: TEST_SYNC_STM32_TO_ESP32.md, TEST_SYNC_ESP32_TO_STM32.md
    B-119..B-123: dedicated regression tests for the aFeed -32512 bug
    STM32 VCP connection: Discove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
    [test_bidir.py]
2026-04-28 fix(settings): validate aFeed_mm range on flash load to prevent -32512 display bug
    Corrupted flash sector can store aFeed_mm=33024 (outside valid 15-300 range).
    When sent to ESP32 as AFEED:33024, the int16_t cast produces -32512.
    Now clamp to default 100 mm/min if value is outside [MIN_AFEED, MAX_AFEED].
    [els_settings.cpp, els_settings.h]
2026-04-28 fix(display): синхронизация параметров между старым и новым дисплеем
    Исправлены расхождения между LCD2004 и ESP32 при смене режима и перезагрузке:
    1. drv_display.cpp: DRV_Display_Init устанавливает s_need_sendall=1 — полное
    состояние всегда отправляется на ESP32 при старте STM32, даже если ESP32
    не перезагружался и не пришлёт READY.
    2. els_menu.cpp: _switch_mode_hw добавлен guard (если режим не изменился —
    возврат без сброса Ap и счётчи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
    [drv_display.cpp, drv_inputs.cpp, drv_lcd2004.cpp, drv_stepper.cpp, drv_stepper.h, els_config.h, els_control.cpp, els_main.cpp]
2026-04-28 fix(menu): _set_mode ресинхронизирует ESP32 когда режим уже совпадает
    При нажатии кнопки режима STM32 защита `if (els.mode == mode) return`
    предотвращала отправку MODE/SELECTMENU/FEED/AP/PASS на ESP32 если STM32
    уже находился в этом режиме. Это ломало Cat B тесты (81 из 110): inject_state
    ставил ESP32 в один режим, затем STM32 оставался в другом — при следующем
    нажатии той же кнопки ресинха не было.
    Теперь при совпадении режима отправляем пол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
    [els_menu.cpp]
2026-04-29 feat(sync): полный ресинх ESP32 после любого touch-события
    Проблема: ESP32 дрейфовал после инжекции состояния в тестах (и при
    перезагрузке ESP32 на реальном станке). STM32 отправлял только то поле,
    которое изменилось (submode, selectmenu и т.д.), не ресинхронизируя
    mode/feed/afeed/ap/pass.
    Изменения:
    - els_menu.cpp: добавлена _send_basic_state() — отправляет MODE+SUBMODE+
    SELECTMENU+FEED+AFEED+AP+PASS; вызывается из _set_mode (same-mode),
    _set_submode, _set_select_menu, TOUCH_KEY_UP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
2026-04-29 fix: валидация Feed_mm/Ap из Flash + корректный буфер для AP на LCD2004
    1. els_settings.cpp: Feed_mm и Ap теперь валидируются при загрузке
    из Flash (как aFeed_mm). Некорректные значения сбрасываются в
    дефолт (Feed=0.10, Ap=0) вместо загрузки мусора.
    2. drv_lcd2004.cpp: буфер для snprintf AP увеличен 5→6, убран
    лишний модификатор ширины %1d → %d. AP=2403 теперь отображается
    как "24.03" вместо усечённого "24.0".
    [drv_lcd2004.cpp, els_settings.cpp]
2026-04-29 fix(ap): ограничение Ap <= 990 вместо 9900 во всех обработчиках
    Максимум 9.90 мм совпадает с ограничением ESP32 sub-edit constrain(0,990).
    - els_menu.cpp: 3 места физических кнопок + TOUCH:AP валидация
    - els_settings.cpp: валидация при загрузке из Flash (Ap=2403 теперь сбросится в 0)
    [els_menu.cpp, els_settings.cpp]
2026-04-29 feat(esp32): roller-пикер для поля Подача в режиме M1 (pilot)
    Тап на значение Подача → полупрозрачный оверлей с lv_roller (0.05..25.00 мм/об,
    шаг 0.05). Скролл и кнопки UP/DN меняют только локальное значение без UART.
    UART FEED:val отправляется только при подтверждении: OK или тап вне панели.
    Тап вне = отмена (без отправки). Авто-выход через 5с без активности = отмена.
2026-04-29 build(esp32): добавить platformio.ini и шрифты для сборки ESP32 из текущего проекта
    Шрифты скопированы из 7e2_Mod_LCD4.3_v1.3. lv_conf.h добавлен в корень ELS_Display
    (нужен для LVGL чтобы видеть настройки шрифтов при компиляции библиотеки).
2026-04-29 feat(display): заменить lv_roller на кастомный drum picker
    - FeedRollerState: roller → labels[5] + entry_val + touch_accum
    - Backdrop только 416px (не 480) — правые кнопки UP/OK/DN доступны
    - 5 lv_label вместо lv_roller — плавный swipe без лагов
    - Swipe: PRESSING event + lv_indev_get_vect(), 15px per шаг 0.05мм
    - Cancel: восстанавливает entry_val, исключает desync с STM32
2026-04-29 fix(display): drum picker — тап мимо, размер +30%, выравнивание sel_rect
    1. Backdrop CLICKABLE: тап мимо панели = confirm если скроллили,
    cancel если значение не изменялось; вызывает exit_edit_mode()
    2. Панель 200→260px, ROW_H 30→40, шрифты outer 22→28, center 28→40
    3. sel_rect выровнен по сетке строк без смещений;
    outer-строки центрированы вертикально в слоте (ROW_H-28)/2
    [main.cpp]
2026-04-30 fix(display): drum picker — точное выравнивание sel_rect по метрикам шрифта
    - sel_rect y: -1 → -4 (глиф tahoma_bold_40: top=label+3, height=28; 7px отступ сверху)
    - sel_rect width: PW-8 → PW-12 (симметрия: 4px с обеих сторон в content area)
    - labels width: PW → lv_pct(100) (fit content area PW-4, убирает смещение 2px вправо)
    - outer row y offset: (ROW_H-28)/2=6 → 2px (по метрикам tahoma_bold_28 line_height=35)
    [main.cpp]
2026-04-30 feat(display): инерционный скролл барабана подачи (iOS-style fling)
    - FeedRollerState: +inertia_timer, +velocity, +vel_accum
    - _feed_roller_inertia_cb: таймер 16мс, DECAY=0.92, MIN_VEL=0.35
    - PRESSED: отменяет летящий барабан (поймать рукой)
    - PRESSING: сглаживает скорость (EMA α=0.3)
    - RELEASED: запускает инерцию если |vel| ≥ 2 px/тик
    - close_feed_roller: всегда останавливает таймер
2026-04-30 feat(roller): обобщить барабан выбора на все редактируемые параметры
    Единый RollerState g_roller / open_roller() / close_roller() вместо feed-only.
    Поддерживаемые цели: RT_FEED, RT_AFEED, RT_THREAD, RT_AP, RT_CONE,
    RT_SPH_R, RT_BAR_R, RT_TOOTH_TOTAL, RT_TOOTH_CUR.
    - enter_edit_mode: roller для M1/M2/M3/M5/M6 (Feed, aFeed, Thread, Cone, Sphere)
    - enter_sub_edit: roller для Ap, Конус, Шар, Ножка, Делений, Метка
    - OK / exit_edit_mode / mode_menu: используют g_roller вместо g_feed_roller
    - roller_label_text(): форматирование под каждый тип (др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
2026-04-30 fix(roller): 5 исправлений после обобщения drum picker
    1. Заголовок 'Съем мм': Ё → е (квадратик исчез)
    2. MODE_THREAD: тап на 'ТИП' открывает меню выбора типа резьбы
    3. Roller резьбы: шрифт_40/28 как у числовых полей (было: 22/16)
    4+5. Откат значений после OK устранён: в close_roller(true) добавлены
    оптимистичные обновления uart_protocol.data_ для RT_AP/CONE/SPH_R/BAR_R/
    TOOTH_TOTAL/TOOTH_CUR — update_ui_values теперь читает новое значение
    сразу после сбро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
    [main.cpp, uart_protocol.h]
2026-05-01 fix(roller): grace period 800мс после подтверждения sub-edit параметров
    Корневая причина откатов: после close_roller(true) g_sub_edit.active сразу
    сбрасывался в false → защита в update_ui_values отключалась → входящие
    старые данные STM32 перезаписывали только что подтверждённое значение.
    Исправление: close_roller(true) для sub-edit целей (RT_AP/CONE/SPH_R/BAR_R/
    TOOTH_TOTAL/TOOTH_CUR) визуально убирает подсветку строки немедленно, но
    держит g_sub_edit.active=true ч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
    [main.cpp]
2026-05-01 fix(display): roller резьбы открывается на правильной позиции после смены типа
    jump_to_thread_type: local_step устанавливается ДО enter_edit_mode(),
    чтобы roller открылся на первой записи выбранного типа, а не на старой.
    [main.cpp]
2026-05-01 feat(BACKLOG-001): GCode WiFi веб-интерфейс — фаза 1 (файловый менеджер)
    - gcode_wifi.cpp/h: неблокирующий WiFi (STA → AP fallback), LittleFS /gcode,
    AsyncWebServer порт 80, REST API (/api/status, /api/files, /api/upload,
    /api/file GET/DELETE, /api/wifi), HTML веб-UI в PROGMEM
    - Удалён хардкод WiFi из main.cpp; GCodeWiFi_Init/Process интегрированы
    - Скриншот-сервер перенесён с порта 80 на 8081
    - partitions_8mb.csv: 4MB app + 4MB LittleFS для 8MB flash JC4827W543
    - platformio.ini: AsyncWebServer@3.3.8, новая таблица разделов
    [partitions_8mb.csv]
2026-05-01 feat(BACKLOG-001): WiFi настройки через wifi_config.h + IP в меню настроек
    - wifi_config.h: пользователь задаёт WIFI_STA_SSID/PASS для роутера,
    или оставляет пустым → ESP32 поднимает AP "ELS-WiFi" / "12345678"
    - gcode_wifi: убраны Preferences для WiFi, только compile-time defines;
    добавлен GCodeWiFi_SetConnectedCallback для уведомления об IP
    - settings_menu: секция WIFI показывает режим (STA/AP) и IP адрес;
    обновляется каждые 5 сек из loop()
    - При подключении — всплывает алерт с IP дл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
2026-05-01 fix(display): GCodeWiFi_Init после create_dark_pro_ui — убрать чёрный экран
    LittleFS.begin(formatOnFail) и WiFi.softAP вызывались до LVGL init и
    create_dark_pro_ui(), поэтому экран оставался чёрным на время инициализации.
    Переставлено: сначала UI отрисовывается (lv_timer_handler), потом WiFi/LittleFS.
    [main.cpp]
2026-05-02 fix(display): httpd_start перенесён после GCodeWiFi_Init — убрать крах lwIP
    httpd_start() вызывался до инициализации WiFi стека (до GCodeWiFi_Init),
    что приводило к краху lwIP socket() и чёрному экрану. Теперь httpd
    запускается строго после GCodeWiFi_Init() когда стек готов.
    [main.cpp]
2026-05-02 fix(display): revert to huge_app.csv + lazy AsyncWebServer init to fix black screen
    - platformio.ini: revert partition table huge_app.csv (was partitions_8mb.csv);
    custom partition table likely caused boot issues when flashed alongside new firmware
    - gcode_wifi.cpp: change AsyncWebServer from global static to heap-allocated pointer
    (new AsyncWebServer(80) inside _start_server) — avoids global constructor running
    before WiFi/lwIP stack is initialized, which could crash early boot
    - gcode_wifi.cpp: LittleFS.begin(false) — don't auto-format on first mount
    [gcode_wifi.cpp]
2026-05-03 feat(BACKLOG-001): GCode WiFi на ESP-IDF httpd — без внешних библиотек
    - gcode_wifi.cpp: переписан на esp_http_server.h (убрана ESPAsyncWebServer,
    которая вызывала чёрный экран из-за глобальных конструкторов до setup())
    - Веб-сервер на порту 80: GET /, /api/status, /api/files, /api/file,
    DELETE /api/file, PUT /api/file (загрузка без multipart)
    - LittleFS /gcode для хранения файлов
    - STA-режим как основной (wifi_config.h, не коммитится), AP fallback через 12с
    - main.cpp: убран хардкод WiFi.begin("VIRUS932")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
2026-05-03 fix(BACKLOG-001): заменить ESP-IDF httpd на WiFiServer — сайт теперь доступен
    ESP-IDF httpd запускался без ошибок, но не принимал TCP соединения (причина
    неизвестна, возможно конфликт задач). Переписан на простой WiFiServer
    (Arduino-стиль), который работает прямо в loop() без отдельных FreeRTOS задач.
    Все эндпоинты сохранены: GET /, /api/status, /api/files, /api/file,
    DELETE /api/file, PUT /api/file. Порт 8080.
    [gcode_wifi.cpp, main.cpp]
2026-05-03 feat(backlog-p3p4): GCode executor + 2D trajectory visualizer
    Phase 3 (GCode executor):
    - gcode_exec.cpp: state machine IDLE→RUNNING→WAITING_ACK→DONE
    reads LittleFS file line by line, strips comments, sends via callback
    handles G4 dwell, M0 pause, M2/M30 end; 5-sec ACK timeout for testing
    - gcode_exec.h: public API (Run/Stop/TogglePause/OnAck/Process/GetState...)
    - uart_protocol: sendGCodeLine() → <GCODE:line>\n to STM32
    parse <OK> (no-colon) and <ERR:reason> → GCodeResponseCallback
    Phase 4 (Web UI runner + visualizer):
    - gcode_wifi: new endpoints POST /api/run, /api/stop, /api/pause, GET /api/exec
    - HTML_PAGE: GCode Runner section (dropdown, Start/Pause/Stop, progress bar)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
2026-05-03 fix(gcode_exec): заменить static File на File* — убрать глобальный конструктор FS::File до setup()
    [gcode_exec.cpp]
2026-05-04 fix(wifi): STA таймаут 30с + повтор STA из AP-режима каждые 60с
    - WIFI_STA_TIMEOUT_MS увеличен с 20 → 30 секунд
    - В AP-режиме каждые 60 сек пробует снова подключиться к STA-роутеру;
    если успешно — переключается в STA и рестартует сервер на роутерном IP
    [gcode_wifi.cpp]
2026-05-04 debug(wifi): логировать клиентов + null-check WiFiServer + delay 500ms перед bind
2026-05-04 feat(backlog-p5): STM32 обрабатывает <GCODE:line> и отвечает <OK>/<ERR:...>
    - drv_display.h: TOUCH_GCODE, поле gcode_line[80] в DispRxCmd_t,
    объявление DRV_Display_SendGCodeAck()
    - drv_display.cpp: RX буфер 64→128 байт, парсинг GCODE в _parse_rx,
    реализация DRV_Display_SendGCodeAck (приоритетная отправка OK/ERR)
    - els_menu.cpp: _exec_gcode() — разбор G0/G1/G28/M*, логирование
    координат, ответ OK (движение — Phase 6-7 TODO)
2026-05-04 feat(phase6+mdns): G0/G1 реальное движение моторов + mDNS els.local + fix ESP32 build
    Phase 6 — реальное движение на STM32:
    - ELS_GCode_Process() мониторит завершение шаговых моторов и шлёт <OK>
    - ELS_Control_Update() блокируется пока gcode_motion активен
    - _exec_gcode() G0/G1: вычисляет шаги, запускает DRV_Stepper_MoveSteps()
    - Новые поля в ELS_State_t: gcode_motion, gcode_target_y/x, gcode_has_y/x
    mDNS (ESP32): http://els.local:8080/ доступен с Mac/iOS/Chrome
    platformio.ini: build_src_filter для jc4827w543 — исправлена сборка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
    [els_control.cpp, els_control.h, els_main.cpp, els_menu.cpp, els_state.h, gcode_wifi.cpp, main.cpp]
2026-05-04 fix(wifi): задержка 500→2000мс + watchdog перезапуска сервера через 30с
    Проблема: WiFiServer::begin() на ESP32-S3 иногда не начинает принимать
    соединения если вызывается слишком рано после ассоциации с AP.
    Решение: увеличена задержка до 2000мс + watchdog перезапускает сервер
    если через 30с после запуска не поступило ни одного HTTP-клиента.
    [gcode_wifi.cpp]
2026-05-05 fix(wifi): порт 80 вместо 8080, MDNS.begin() один раз, URL http://els.local/
    - HTTP порт 8080 → 80: доступен без указания порта, роутеры не блокируют
    - MDNS.begin("els") вызывается один раз при первом запуске сервера
    - URL в алерте обновлён: "http://els.local/ (IP)"
    [gcode_wifi.cpp, main.cpp]
2026-05-15 feat(jc8012p4a1c): поддержка ESP32-P4 10.1" дисплея
    - Добавлена папка ELS_Display_P4/ с драйверами JD9365 (MIPI-DSI) и GSL3680 (touch)
    - display_config.h: новая секция для JC8012P4A1C (1280x800, scale 2.67/2.94)
    - main.cpp: #ifdef DISPLAY_JC8012P4A1C для инициализации дисплея, тача, UART, LVGL
    - platformio.ini: новый env jc8012p4a1c (pioarduino 55.03.38, board esp32-p4)
    - DISPLAYS.md: документация по обоим дисплеям и архитектуре проекта
2026-05-15 fix(jc8012p4a1c): исправить сборку для ESP32-P4
    - platformio.ini: memory_type opi_opi → qio_qspi (единственный доступный вариант для P4)
    - main.cpp: include "jd9365_lcd.h" и "gsl3680_touch.h" без подпапок (пути уже в -I флагах)
    [main.cpp]
2026-05-15 fix(jc8012p4a1c): sw_rotate=1 — применять LVGL поворот программно
    Без disp_drv.sw_rotate=1 LVGL v8 игнорирует lv_disp_set_rotation() и
    рендерит UI в физических координатах 800×1280 (портрет) вместо
    логических 1280×800 (ландшафт). Добавление флага включает software
    rotation transform.
    [main.cpp]
2026-05-17 feat(jc8012p4a1c): ручной поворот 90° CCW в flush + USB CDC скриншот
    - my_disp_flush: LVGL работает в логическом 1280×800, поворот на 90° CCW
    делается вручную (logical→physical через screen_fb), убран sw_rotate=1
    - screen_fb (800×1280 физ.) используется и как rotation buffer, и для скриншота
    - capture_task_fn вынесен в общую секцию (shared для jc4827w543 и jc8012p4a1c)
    - Тач: физ. (tx,ty) → логич. (ty, 799-tx) для 90° CCW поворота
    - platformio.ini: добавлен env:jc8012p4a1c (esp32-p4-evboard, pioarduino 53.03.10)
    с includ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
    [partitions_8mb.csv]
2026-05-18 fix(jc8012p4a1c): исправить ротацию 90° CW в flush + скриншот
    Ошибка: формула CCW давала зеркальный и сдвинутый в угол UI.
    Трассировка: logical(lx,ly) → screen_fb[lx*800+(799-ly)]
    → glass hardware mirror → CW landscape(lx,ly) = logical(lx,ly) ✓
    - my_disp_flush: CCW→CW: screen_fb[(1279-lx)*800+ly] → screen_fb[lx*800+(799-ly)]
    - Тач-маппинг (data->point.x=ty, y=799-tx) — уже верен для CW + mirror_x/y
    - screenshot_usb.py: PIL rotate(90)→rotate(-90) для правильного ландшафта
2026-05-18 build(jc8012p4a1c): переключить platform на espressif32 (55.03.38)
    53.03.10 требовал скачать esp32-arduino-libs с GitHub (timeout).
    Локально установлен espressif32@55.03.38 (pioarduino) со всеми нужными
    пакетами в кэше — сборка за 31 сек без интернет-доступа.
2026-05-18 fix(jc8012p4a1c): LVGL 480×272 + CW rotate+scale в flush, тач масштаб
    Проблема: UI хардкодирован на 480×272, а LVGL был 1280×800 → контент
    в левом верхнем углу. Ротация CCW → экран перевёрнут.
    Решение:
    - display_config.h: SCREEN_WIDTH=480, SCREEN_HEIGHT=272 для P4
    (LVGL совпадает с jc4827w543 → весь UI без изменений)
    - flush: итерация по screen_fb (800×1280), reverse-map с CW-ротацией
    + билинейным масштабом (nearest-neighbor):
    fb[row,col] ← lvgl[ col*272/800, (1279-row)*480/1280 ]
    - touch: масштаб ty*480/1280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
2026-05-18 feat(jc8012p4a1c): bilinear interpolation при upscale 480×272 → 1280×800
    Nearest-neighbor давал видимые пиксели при увеличении ×2.67.
    Bilinear interpolation устраняет ступенчатость и даёт плавную картинку.
    LUT (lut_row0/row1/ty) инициализируется при первом flush → без накладных расходов.
    Inner loop: 4 PSRAM reads + RGB565 channel blend per pixel.
2026-05-18 feat(jc8012p4a1c): нативное LVGL 1280×800 вместо 480×272 + bilinear upscale
    - display_config.h: SCREEN_WIDTH/HEIGHT P4 → 1280×800
    - flush callback: удалён bilinear upscale, только CW-поворот (ly*1280+lx → lx*800+(799-ly))
    - touch: прямой маппинг ty/799-tx без масштабирования
    - UI layout (K, I): панели и константы через SCALE_X/Y/W/H макросы
    - Statusbar, overlays, roller, font demo, tap zone — все размеры через SCALE_*
2026-05-18 feat(jc8012p4a1c): WiFi инфо по тапу, watchdog без повторного алерта
    - gcode_wifi: start_server(bool notify=true) — watchdog передаёт false,
    исключая повторный алерт каждые 30с
    - main: одиночный тап на иконку ⚠ в statusbar показывает IP/URL WiFi;
    двойной тап дополнительно открывает меню настроек
2026-05-18 fix(jc8012p4a1c): Serial.flush() после JPEG — USB CDC не терял последние 64 байта
    Без явного flush() USB CDC буфер (64 байта) не отправляется после
    последнего Serial.write(), что приводило к обрезанному JPEG файлу.
    Это вызывало ошибку "Could not process image" при открытии скриншотов.
2026-05-18 fix(jc8012p4a1c): CCW поворот в flush + PWM яркость подсветки
    1. Flush: CW→CCW поворот (fb[(1279-lx)*800+ly]).
    Модуль смонтирован CCW, поэтому формула CW давала изображение
    перевёрнутым на 180°. CCW исправляет ориентацию, полное заполнение
    экрана и соответствие тача видимым элементам.
    2. Яркость: GPIO→LEDC PWM на GPIO23 (BL_LEDC_FREQ=20kHz, 8-bit).
    level=1 → duty=255 (100% яркость). Совместим с прежним API.
2026-05-18 fix(jc8012p4a1c): touch CCW-маппинг, кнопки SCALE_H, GPIO подсветка
    - Touch: исправлен маппинг CCW (1279-ty, tx) с учётом mirror_x/y в GSL3680
    - Кнопки UP/OK/DN: SCALE_H(64/88/64) вместо хардкода → заполняют весь экран
    - Подсветка: LEDC → простой GPIO (надёжнее на ESP32-P4)
2026-05-18 fix(jc8012p4a1c): touch формула (1279-ty, 799-tx), оптимизация rotation loop
    - Touch: исправлена формула на (1279-ty, 799-tx) на основе официального Espressif
    ROTATION_270 демо — raw_y→lx, raw_x→ly с учётом mirror_x/y в конфиге
    - Rotation loop: перестроен на sequential write (row-major access к screen_fb)
    вместо strided write, что устраняет cache miss на каждый пиксель
    - Убран delay(5) в P4-ветке loop() чтобы не блокировать LVGL
2026-10-26 docs(backlog): дорожная карта дисплеев/DRO, history.md, защита ПД
    - BACKLOG-010..016: поддержка 4.3"/10.1"/7" дисплеев, доводка 10.1" (текущая задача),
    выбор дисплея и источника координат (DRO UART / линейки напрямую) в els_config.h,
    дублирование тачскрина физическими кнопками, правило защиты персональных данных
    - history.md: журнал разработки
    - wifi_config.h и CLAUDE.md убраны из отслеживания и добавлены в .gitignore,
    шаблон wifi_config.example.h
    - to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
2026-10-31 fix(jc8012p4a1c): UART на GPIO38/37, частичная перерисовка, алерт WiFi без повторов
    - UART до STM32: разъём CN2 = UART0 (RX GPIO38, TX GPIO37) по схеме модуля.
    GPIO16/17 — линии SDIO до ESP32-C6, данные от STM32 не доходили
    - Отрисовка: вместо full_refresh 1280x800 в PSRAM + поворот всего кадра + копия 2 МБ —
    частичная перерисовка в буфер 64 строки во внутренней SRAM, поворот области
    прямо во framebuffer панели. lv_timer_handler: 864 мс → 11 мс на кадр
    - WiFi: алерт тол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
2026-10-31 feat(jc8012p4a1c): пропорциональный UI 1280×800, устранение зависаний, автотесты
    Пропорциональность (общий код, 4.3" не меняется):
    - UI задаётся в пикселях базы 480×272; макросы UX/UY/US (на 4.3" тождественны)
    вместо SCALE_* с разной базой, которые искажали и 4.3"
    - шрифты 10.1" ×8/3 под теми же именами (ELS_Display_P4/fonts, tools/gen_p4_fonts.sh),
    встроенные Montserrat заменены в lv_conf P4
    Зависания и задержки на 10.1":
    - память LVGL в PSRAM (пул 48 КБ и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
2026-10-31 diag(jc8012p4a1c): лог WiFi через C6 — версии esp_hosted, скан, причина отключения
    Ожидание готовности C6 перед WiFi.begin. Выяснено: связь P4↔C6 есть, сеть роутера видна,
    но C6 (слейв 2.1.10) не начинает подключение по команде хоста 2.12.3.
2026-11-01 feat: выбор дисплея в конфиге (BACKLOG-013), линейки напрямую без блока DRO (BACKLOG-014)
    BACKLOG-013:
    - ELS_DISPLAY_TYPE (NONE / 4.3" / 10.1", 7" зарезервирован) вместо USE_ESP32_DISPLAY
    - дисплей сообщает тип <DISP:43|101> (с READY и в ответ на PING от STM32),
    STM32 при несовпадении пишет в отладку и показывает алерт
    BACKLOG-014:
    - ELS_POS_SOURCE: блок DRO по UART / линейки напрямую / шаги мотора (режим по шагам
    раньше давал 0)
    - drv_scales: квадратура TTL/RS-422 (стекло, магн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
2026-11-02 feat(stm32): ядро 7e2 перенесено дословно, аппаратный слой STM32, симуляция
    Сверка с оригиналом (docs/PORT_AUDIT.md) показала, что прежний порт был
    упрощённой переделкой: резьба без привязки к углу шпинделя, подачи без
    разгона, одна частота шагов на обе оси, нет автоциклов и ускоренных ходов.
    - Core/e2/orig: файлы скетча 7e2 без изменений; e2_core.cpp — основной
    скетч, заменена только AVR-специфика (помечено [STM32]).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
2026-11-02 feat(e2): защита длительности импульса STEP, таблицы резьб под механику, симуляция циклов
    - STEP: уровень держится не меньше STEP_PULSE_MIN_US (3 мкс, DWT). В 7e2
    импульс X на конусе снимается и ставится в одном прерывании — на STM32
    пауза сжималась до 0.1 мкс, драйвер терял бы шаги.
    - Таблицы Thread_Info/Cone_Info рассчитаны под энкодер 1800 и винты 2/1 мм:
    при другой механике сборка останавливается (static_assert),
    tools/gen_e2_tabl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
2026-11-02 feat(e2): подключение драйверов напрямую или через ключ, монитор входов
    - DRIVER_SIGNALS_DIRECT: 0 — STEP/DIR/ENA через NPN-ключ, как на схеме 7e2;
    1 — вывод STM32 прямо на «−» входа драйвера (уровни инвертируются,
    логика 7e2 та же). Симуляция проходит в обоих вариантах.
    - IO_MONITOR: каждое изменение кнопок, переключателей, упоров, джойстика,
    обороты энкодера шпинделя и щелчки РГИ — в отладочный порт. Для проверк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
2026-11-02 docs: руководство по сборке и подключению (HTML + MD), схемы по блокам
    - docs/index.html (наглядно) и docs/README.md (кратко): что купить, что куда
    прошить, настройки, карта разъёмов P1/P2, схемы по блокам, макетка без
    шилда с монитором входов, стенд-эмулятор на Mega, линейки, дисплеи.
    - tools/docs_gen: генераторы схем и таблицы выводов из e2_pins.h;
    генератор схем линеек перенесён в репозиторий.
    - REQ Digimatic перенесён на PC6/PC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
2026-11-02 feat(shield): шилд под Discovery в KiCad — схема, BOM, размещение
    - hardware/shield/design.py — единое описание деталей и цепей (выводы
    STM32 берутся из e2_pins.h); gen_sch.py — схема KiCad 8 (ERC 0, цепи
    сверены 1:1), gen_pcb.py — плата 180×146 мм: гнёзда Discovery по
    чертежу UM1472, клеммники по краям, ключи драйверов, подтяжки,
    полигоны GND; gen_bom.py — список деталей; build.sh — полный цикл.
    - Гнёзда J1/J2: посадочное место штыревого 2×25 (у библиотечног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
2026-11-02 docs(backlog): BACKLOG-019 шилд компактный через KiCad MCP, 020 подача 7e2, 021 механика, 022 упоры и переключатель подрежима
2026-11-02 docs: README — выводы STM32 по группам, подключение эмулятора, скриншоты дисплея; DISPLAYS — подключение к STM32
2026-11-02 docs: чеклист сверки с оригиналом 7e2, симуляция всех автоциклов
    - docs/CHECKLIST_7e2.md: режимы, расчёты, управление, меню, индикация, связь,
    настройки, отличия и порядок проверки на железе.
    - Автосверка исходников: 119/124 функции (5 — DRO_HS800, заменён drv_dro),
    152/152 #define, 163/163 глобальных переменных, таблицы без изменений.
    - Симуляция: внутренние автоциклы резьбы и подачи, асинхронный и конусный
    автоциклы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
2026-11-02 docs(backlog): счётчик проверок симуляции
2026-11-02 fix(display): STM32 не отвечал на READY после загрузки ESP32-P4
    ESP32-P4 выводит лог ROM в UART0 (GPIO37/38), тот же UART, что идёт к STM32,
    и на другой скорости. Мусор без перевода строки приклеивался к <READY>, и строка
    отбрасывалась. Теперь '<' начинает новую команду, буфер приёма ограничен 128 байтами.
    Проверено на железе: после сброса дисплей сразу получает полное состояние.
2026-11-02 fix(pins): джойстик Вверх PB2 → PE3; эмулятор DRO качает позицию через ноль
    PB2 на Discovery — BOOT1, стянут резистором к GND: вход с подтяжкой читался
    как «нажат», ядро постоянно показывало «джойстик в нейтраль» и тормозило цикл
    (позиция на дисплее шла рывками ~9 раз/с вместо 50). PE3 (CS акселерометра,
    для платы только вход) проверен через SWD: с подтяжкой читается 1.
    Документация, карта выводов и черновик ши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
2026-11-02 feat(display): диаметр (Ø LCD2004) на новом дисплее, обновляется вместе с X
    STM32 шлёт DIAM_X при каждом изменении позиции (у автора — только в полной
    рассылке, поэтому значение на новом дисплее не менялось). Новый дисплей
    показывает ДИАМЕТР во всех режимах, кроме делилки и резерва — как LCD2004.
2026-11-02 feat(display): ряд ПОЗИЦИЯ Y / ПОЗИЦИЯ X / ДИАМЕТР, цвета осей
    Раскладка K: ДИАМЕТР — постоянная плитка в одном ряду с позициями Y и X
    (двойной тап по ней = PARAM_OK, как у прежней пустой плитки). Параметр режима,
    счётчик и тип сдвинуты во второй ряд, индикатор SM — в верхнюю панель.
    Буквы осей в заголовках окрашены: Y синий, X сиреневый (красный/зелёный
    заняты знаком значения), слово ДИАМЕТР — цветом ос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
2026-11-02 feat(tests): стенд сверки LCD2004 и нового дисплея; исправления по его находкам
    tools/compare_displays.py: старый экран читается из памяти STM32 по ST-Link,
    новый — <UIDUMP>; перебор режимов, подрежимов, экранов меню и кнопок; каждое
    число со старого экрана должно быть на новом; отчёт с парами экранов.
    Исправлено по первому прогону (155/164 без расхождений):
    - шар: заходов Pass_Total_Sphr+1 (было +2), STM32 шлёт PASS_SPHR при изменении;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
2026-11-03 fix: сообщения и подача на новом дисплее синхронны с LCD2004
    - «УСТАНОВИТЕ УПОРЫ» и другие сообщения-флаги ядра (джойстик, суппорт,
    операция завершена): STM32 шлёт ALERT по изменению err_0/1/2 и Complete_flag
    (у автора — не во всех местах), после READY — повторно. Дисплей не скрывает
    их сам через 5 с и при смене режима — гаснут вместе с LCD2004.
    - После перезапуска одного STM32 дисплей показывал подачу 0.00: Display_Send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
2026-11-03 feat: дисплеи синхронны с LCD2004, ⌀ в подписях, сверка по подписям, матрица автоциклов
    STM32:
    - Display_Watch: всё, что UartDisplay шлёт только в Display_Send_All, уходит по
    изменению (натяг/отскок, заходы шара, угол делилки, проходы, упоры и др.)
    Новый дисплей:
    - экран «Ввод/Сброс осей»: ОСЬ Y / ОСЬ X / ⌀ ДИАМЕТР в ряд, без дубля диаметра
    - раскладка I удалена (решение владельца)
    - знак ⌀ в шрифтах (gen_p4_fonts.sh, новый gen_43_fo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
2026-11-03 fix(display): барабан шага резьбы листает только текущую категорию
    После смены типа резьбы (метрическая/дюймовая/G/K) барабан и ▲/▼ показывали
    общий список: рядом с первой дюймовой — последние метрические и наоборот,
    нужную приходилось искать прокруткой. Теперь диапазон — категория выбранной
    резьбы; при смене типа через меню ТИП барабан переключается на её диапазон.
    Проверено на 10.1".
    C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
2026-11-03 test(hil): автоциклы на железе с эмуляцией шпинделя; README — скриншоты в работе
    tools/hil_cycles.py: TIM5 CH2 выводится на PA1 (канал A энкодера) по SWD — меандр
    с частотой оборотов; упоры с отгоном, параметры, подрежим, джойстик до
    «ОПЕРАЦИЯ ЗАВЕРШЕНА». По ходу цикла сверяются счётчики «осталось» LCD2004 и
    нового дисплея (совпадают, не растут), выход за упоры, возврат, сообщение о
    завершении на обоих экранах.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
2026-11-03 test(scales): все 6 источников координат проверены на железе; эмулятор квадратуры и iGaging исправлен
    scales_hil_test.py, Mega → STM32 → новый дисплей: HS800, квадратура, Sylvac 48,
    BIN6, iGaging 21, Digimatic — 6/6 позиций каждый. STM32 не менялся.
    Эмулятор:
    - квадратура: рост счёта — A опережает B (как у линеек и TIM в режиме энкодера);
    было наоборот, показания шли с обратным знаком
    - iGaging: такт STM32 20 мкс не успевал опрос digitalRead и 64-би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
2026-11-03 feat(display): счётчик везде «ПРОХОДЫ» (решение владельца)
    Резьба («ЦИКЛОВ») и шар («ЗАХОДОВ» — на LCD2004 это число проходов шара) —
    теперь «ПРОХОДЫ», как в подаче и конусах. «ЗАХОДОВ» многозаходной резьбы
    (экран 2) — другое понятие, оставлено. Правила сверки обновлены.
    Собирается для 10.1" и 4.3"; на железе не проверено — платы отключены.
2026-11-03 docs(backlog): 024 решено (как у автора), 025 линейки в автоциклах, 026 стенд с DRO по моторам
2026-11-03 test(sim): модель люфта поперечного винта — реальная глубина в автоциклах 7e2
    SIM_BACKLASH=1: каретка отстаёт от гайки на люфт при смене направления; подача
    3 × ⌀1.00 и резьба 1.25 при люфте 0 / 0.10 / 0.20 мм. Ноль, взятый движением к
    детали, — недорез 0.001 мм (люфт в цикле вычитается); от детали — недорез ровно на
    люфт. Выводы и варианты решения — в BACKLOG-025.
2026-11-05 feat: компенсация люфта винтов, упоры без переключателя подрежима; эмулятор следует за моторами
    - BACKLASH_Z_UM / BACKLASH_X_UM (els_config.h, 0 — как у автора): на первом шаге
    после смены направления позиция мотора сдвигается на люфт, ядро само делает
    лишние шаги (со своим разгоном, в резьбе — в такт шпинделю); счётчики = каретка.
    Сдвиг на шаге, а не при установке DIR: ноль цикла запоминается стоя на мест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
2026-11-06 feat: без линеек по умолчанию, env с DRO и линейками; ноль и ввод осей при линейках напрямую
    - ELS_POS_SOURCE по умолчанию POS_SOURCE_STEPS (как исходная 7e2); env stm32f407_dro и
    stm32f407_scales. Стенд сверки дисплеев — прошивка stm32f407_dro.
    - При линейках напрямую «Сброс» осей автора не обнулял показания: добавлены смещения линеек,
    e2_axis_set() и команда экрана AXIS:<Z|X|D>:<мкм>; флаг AXIS_EDIT (0 при блоке DRO).
    - Симуляция test_axis_set для всех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
2026-11-06 feat(display): ноль оси двойным тапом, ввод Y/X/⌀ с клавиатуры; джойстик — по ⚡
    - Двойной тап по ПОЗИЦИИ Y / X — ноль, долгое нажатие на Y / X / ⌀ — клавиатура со знаком
    (до 0.001 мм), команда AXIS:<Z|X|D>:<мкм>. С блоком DRO (AXIS_EDIT:0) — подсказка.
    - Скрытые двойные тапы на плитках позиций убраны: категория резьбы — плиткой ТИП,
    экранный джойстик — тап по ⚡.
    - UIDUMP: axis_kb, axis_edit.
2026-11-06 ci: сборка релиза — STM32 с блоком DRO и оба дисплея, по тегу v*
    - tools/make_release.sh: dist/ с els-stm32-dro.bin и els-display-<env>.bin (загрузчик + разделы +
    программа, прошивка с 0x0), SHA256SUMS.
    - .github/workflows/release.yml: тег v* — релиз на GitHub; вручную — только сборка.
    - docs/RELEASE.md: что внутри, под какую механику, как прошить.
    - ELS_RELEASE: в релиз идёт только шаблон Wi-Fi.
2026-11-06 build: закрепить ststm32@19.5.0 — с 20.0.0 (STM32duino 3.0) ядро не собирается
2026-11-06 ci: склейка образа дисплея — esptool из pip (в CI) или из PlatformIO (локально)
2026-11-06 feat: механика станка во флеше и с экрана (BACKLOG-028)
    - e2_mech.h: ENC_LINE_PER_REV, SCREW_*, McSTEP_*, MOTOR_*_STEP_PER_REV, BACKLASH_*_UM — поля
    e2_mech; текст ядра 7e2 не меняется. Исходные значения — els_config.h.
    - e2_mech_apply(): проверки как static_assert автора + делители таблиц; таблицы резьб и конусов
    пересчитываются по формулам gen_e2_tables.py (при механике автора — его таблицы как есть);
    разгон и люфт пересчитываются.
    - Флеш: сектор 11 (e2_store.cpp), м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
2026-11-06 test(hil): стенд «эмулятор следует за моторами», люфт и настройки с экрана на железе
    - tools/follow_hil.py: шаги STM32 = Mega, люфт на Mega, компенсация через CFG_SET.
    - Экран настроек: непрозрачный фон; подсказка Wi-Fi от первого тапа по ⚠ закрывается.
    - <TAP:x,y,мс> — долгое нажатие в автотестах.
    - Документы: настройки переживают перепрошивку (проверено).
2026-11-06 docs(history): регресс на железе — сверка 305/305, автоциклы
2026-11-06 feat: калибровка шага винта и люфта по линейкам (BACKLOG-029)
    - e2_calib.inc: ось 3 раза туда-обратно с возвратом на место; шаг винта — по ходу без разворота,
    люфт — по разворотам; прервать джойстиком или СТОП; команда CAL, ответы CAL_RUN/CAL_RES/CAL_ERR.
    - Экран: «МЕХАНИКА СТАНКА» → «КАЛИБРОВКА», ход по осям, ПРИМЕНИТЬ → в настройки.
    - Тексты без символов, которых нет в шрифтах экрана; нижние кнопки подняты.
    - Ст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
2026-11-06 docs: релиз v0.1.0
2026-11-06 fix: синхронная подача равна заданной (BACKLOG-020, FEED_EXACT)
    У автора таймер делает шаг раз в (делитель + 1) импульсов — подача на 6–10 % меньше.
    Лишний период вычитается в Feed.ino и Cone.ino; FEED_EXACT 0 — как у автора.
    BACKLOG-016 закрыт владельцем.
2026-11-06 feat: раздел НАСТРОЙКИ по ⚠ — механика, калибровка, Wi-Fi, линейки; источник координат с экрана
    - Тап по ⚠ — «НАСТРОЙКИ»: МЕХАНИКА, КАЛИБРОВКА, WI-FI, ЛИНЕЙКИ; внизу крупно адрес.
    - WI-FI: сеть роутера в NVS дисплея (главнее wifi_config.h), поиск сетей, «забыть».
    - Источник координат и линейки — настройки STM32 (запись v2): оба драйвера в прошивке всегда,
    POS_SET → флеш → перезапуск. Одна прошивка STM32 для всех в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
2026-11-06 wip: линейки в автоциклах — доводка X и контроль пропуска шагов (выключено, не проверено)
    e2_scalefix.inc, ворота в Joy_*Pressed, флаги в настройках (POS — 12 чисел, POS_SET — 9 или 12).
    По умолчанию выключено: SCALE_FIX_X 0, STEP_LOSS_CHECK 0. Регресс симуляции без изменений.
2026-11-07 feat: линейки в автоциклах — доводка X и контроль пропуска шагов (BACKLOG-025), включено
    - Доводка X перед проходом по линейке от нуля цикла (физические шаги, счётчик ядра не меняется).
    - Контроль пропуска шагов на остановках; разворот — по направлению выданных шагов; без заданного
    люфта отрезки с разворотом не сверяются.
    - Исправлено: опорная точка до первого пакета DRO, чтение после доводки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
2026-11-07 fix: сдвиг захода многозаходной резьбы — точно (ошибка ядра при дробном «шагов на 0.01 мм»)
    У автора сдвиг старта следующего захода — (TENS * Step) * 100, где TENS — целое «шагов на 0.01 мм».
    При винте 1.5 мм и 800 шагах/об второй заход смещался на 1.41 мм вместо 1.50. Теперь точно,
    с округлением до полного шага. С механикой автора (ровно 4) результат прежний.
    Тесты симуляции учитывают механику (упоры по расс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
2026-11-07 feat: калибровка без линеек — по индикатору или штангенциркулю (BACKLOG-029)
    - STM32: CAL_STEP — фазы движения (выбрать люфт, ход вперёд, возврат), счётчики не меняются.
    - Экран: вкладки «ПО ЛИНЕЙКАМ» / «ПО ИНДИКАТОРУ», мастер с ДАЛЕЕ и вводом показаний;
    шаг винта и люфт считает экран, ПРИМЕНИТЬ — в настройки.
    - Стенд: винт 1.039 мм / люфт 80 мкм при заданных на Mega 1.04 / 80.
2026-11-07 feat: физические дубли экранных функций и таблица «экран ↔ кнопки» (BACKLOG-015)
    - Категория резьбы: ▲/▼ с кнопкой ускоренного хода — к следующей/предыдущей категории.
    - Ввод диаметра ◀/▶ в «Ввод * Сброс осей» — и при линейках напрямую (на ноль диаметра линейки).
    - docs/CONTROLS.md: что делается на экране и чем на станке; настройки — только экран.
2026-11-07 fix: категория резьбы кнопками — не чаще раза в 0.6 с (у автора удержанная кнопка повторяется)
    Проверено на железе: ▲▲▼▼ с ускоренным ходом — 20 → 47 → 20 → 0.
2026-11-07 feat: G-код на новом ядре — исполнитель на STM32, режим M8 «G-КОД» (BACKLOG-001)
    - e2_gcode.inc: G0/G1/G2/G3/G7/G8/G20/G21/G28/G90/G91/G94, X — диаметр; цели по шагам от опорной
    точки, X и Z одновременно, разгон/торможение, люфт, упоры, стоп (джойстик / <GCODE:STOP>).
    - Дисплей: M8 «G-КОД» — строка, процент, позиции; ожидание ответа 10 мин; «Стоп» шлёт STOP.
    - Исправлено: окно приёма СТОП из нулей; скачок DRO портил направление линейки.
    - docs/GCODE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
2026-11-07 test(hil): автоциклы с Mega «следует за моторами» — как настоящий DRO; 10/10, сверка 305/305
2026-11-07 fix: G-код по Wi-Fi целиком — страница, Fanuc-кадры, шрифт M8; Wi-Fi 10.1" подключается после перезагрузки
    - Веб-страница обращалась на :8080 (сервер на 80) — адреса относительные; .ngc.
    - G98/G99/G95 (подача на оборот — по оборотам шпинделя), G50 S, G96/G97, O-номер.
    - M8: основное поле — шрифт с кириллицей; ошибка — в сообщении, не в узкой ячейке.
    - Wi-Fi P4+C6: поиск сетей перед подключением и повтор через 10 с — 5/5 перезагруз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
2026-11-07 feat(web): страница G-кода заново — вид станка, размеры, дуги, курсор, код с подсветкой; понятные ошибки
    - Траектория: Z слева направо, ось шпинделя, деталь зеркально, сетка в мм, легенда; пройденное и резец;
    строки считаются как у исполнителя; чётко на ретине и телефоне.
    - Ошибка: «Строка N: …», буфер 200 байт (кириллица обрезалась); понятный текст про шпиндель (G99/G95).
    - Пауза: итоги дня, замечани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
2026-11-08 fix: G-код — опорная точка заново в начале каждой программы и при смене режима
    Опорная точка (шаги ↔ координаты экрана) снималась один раз и не сбрасывалась, если между
    программами вышли из M8, подвели ось и обнулили её на блоке DRO — новая программа шла со
    сдвигом. Теперь дисплей шлёт «%» перед первой строкой, а смена режима сбрасывает точку.
    Стенд: .nc .gcode .ngc .tap .txt подряд через Wi-Fi — карет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
2026-11-08 fix(display): ошибка G-кода — окно по размеру текста, висит до OK; ячейка «ВЫПОЛНЕНО»
    Окно сообщения было фиксированной высоты — длинная ошибка обрезалась и наезжала на OK, и
    закрывалось само через 5 с. Теперь высота по тексту, ошибка G-кода закрывается только OK
    (или сменой режима). «ОШИБКА» и «10 100%» не помещались в ячейку — там процент, при ошибке
    номер строки. Сообщение про шпиндель короче.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
2026-11-08 feat: циклы G71/G70 и шахматная пешка; G28 U0 W0, U/W
    Черновая обдирка по контуру (слоями, шейки и поднутрения — заходом сверху, получистовой проход с
    припуском) и чистовой проход G70. Разворачивает дисплей — ему виден весь контур; STM32 получает
    обычные G0/G1/G2/G3, экран и страница показывают строку исходной программы. Страница рисует все
    проходы (/api/plan) и закрашивает их по ходу (step). G28 U0 W0 — на месте: р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
2026-11-08 feat: ноль детали перед стартом, оси Z/X везде, расчёт и остаток времени G-кода
    - Продольная ось на дисплее — Z (было Y, как у автора 7e2 и на блоке DRO): так в G-коде и ISO 841;
    рисунок станка с осями и точками касания (docs/img/lathe_zero.svg), разделы «Оси» и «Ноль детали».
    - M8: ячейка X — диаметр, как X в программе (было радиус), долгое нажатие — ввод диаметра заготовки;
    подсказка о нуле на экране; имя файла с м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
2026-11-08 docs(backlog): отмечены сделанные пункты BACKLOG-015
2026-11-08 docs(backlog): уточнение про ввод диаметра в G-КОД
2026-11-08 feat: G-КОД с теми же ячейками, что в других режимах; X программы — от плитки ⌀
    ПОЗИЦИЯ Z, ПОЗИЦИЯ X и плитка «⌀ ДИАМЕТР» — как везде; X программы берётся из плитки диаметра,
    поэтому ноль ставится так же, как в обычной работе (Z у торца, касание и ввод ⌀), а «ПОЗИЦИЯ X»
    на программу не влияет. Симуляция 215/215, стенд — в цель.
2026-11-08 feat(shield): rev 2 — компактный шилд 96×126 мм, SMD 0805 под Discovery, разъёмы KK-254
    По образцу Shield3.0 под Mega: Discovery сверху в гнёздах, мелочь SMD 0805 и MMBT3904 под ней,
    штыревые разъёмы 2.54 с защёлкой по трём краям со стороны своих выводов, режимы — IDC 2×5 (M1…M8),
    на шелкографии номиналы и назначение выводов, BOM — понятные названия. ERC 0, DRC 0 (без трассировки).
2026-11-08 feat(shield): rev 2 разведён через KiCad MCP — DRC 0, Gerber для заказа
    Трассировка KiCad MCP (autoroute, Freerouting 2.1.0), переходы к земле; fix_zones.py доводит землю:
    сплошное подключение площадок, переходы с малым зазором — прочь, переход в каждый оторванный кусок
    верхней земли. DRC — 0 нарушений и 0 неразведённых, сверка со схемой — цепи 1:1.
    Gerber + сверловка — hardware/shield/els_shield_gerbers.zip; сборочный вид — preview_top.svg.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
2026-11-08 fix(shield): перепроверка перед заказом — диод питания, режимы M1…M8, +5V 1 мм, земля дорожками
    Сверка с UM1472 (таблица P1/P2, чертёж, схемы Discovery) и старым Shield3.0. Исправлено: +5V шилда шло
    на 5V Discovery напрямую (USB питал бы дисплей) — диод D1; J7: вывод N = режим M N; +5V — 1.0 мм где можно;
    GND разводится дорожками (полигоны оставляли эмиттеры ключей без земли). verify.py → CHECK.md: каждый
    контакт от подписи на плате до фун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
2026-11-08 fix(display): окно сообщения — высота по переносу строк, третья строка не уходит под OK
    Нашлось при съёмке руководства: «ПРОВЕДИТЕ ОСИ ДЖОЙСТИКОМ НА 2 ММ (НАПРАВЛЕНИЕ ЛИНЕЕК)» —
    lv_obj_update_layout ещё не знал о переносе, высота окна считалась по двум строкам.
    Высота текста — lv_txt_get_size по ширине и шрифту, плюс запас под кнопку.
2026-11-08 docs: руководство пользователя — экран, пульт, режимы с примерами, все сообщения и что делать
    docs/manual/README.md: оси, пульт, экран, ноль, упоры и автоцикл (как у автора 7e2), каждый режим,
    примеры шаг за шагом (проточка ⌀30→⌀28 на 50 мм, резьба M20×1.5 длиной 80 мм), настройки, таблица всех
    сообщений со снимками. 34 снимка с дисплея 10.1" со стрелками-номерами (tools/docs_gen: съёмка на стенде
    и разметка; имя сети W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
2026-11-08 docs(manual): G-код от файла до детали с веб-снимками, калибровка по шагам (линейки, DRO, индикатор)
    Дисплей: ссылка #file=имя на веб-странице; окно калибровки — ось Z вместо Y.
2026-11-08 docs(assembly): что купить, заказ и пайка шилда, схема на каждый разъём, первое включение (BACKLOG-033)
    Генератор tools/docs_gen/shield_docs.py: карта разъёмов шилда по плате KiCad и 11 схем
    «вывод шилда → провод → клемма модуля» из design.TERMINALS. pins.md — колонка «Шилд».
2026-11-08 docs: релиз v0.2.0 — что нового
2026-11-12 docs: интерактивная схема подключения docs/wiring.html — каждая нога Discovery до клеммы модуля
    Взамен удалённых pinout.html/schematic.html (там были несуществующие порты F/G): генератор
    tools/docs_gen/wiring_html.py из e2_pins.h, design.py и платы KiCad. Плата со всеми 100 выводами,
    модули со значками, детали шилда на линии, подсветка цепи, поиск, масштаб; карта шилда; таблица.
2026-11-12 fix(shield): медь у крепёжных отверстий — только земля; ручная перепроверка перед заказом
    DRO_RX у H3 (дорожка и переход в 2.4 мм от центра, под головкой винта) и LED_LEFT_K/LED_RIGHT_K
    у H2 (3.3–3.9 мм, под шайбой) переложены — сигнальная медь не ближе 4.8 мм. DRC 0, Gerber пересобраны.
    Документация: кнопка USER не ставит задний упор; ENA драйвера — проверка при первом включении.
2026-11-12 feat(shield): сброс и резервные разъёмы J24–J27 на верхнем крае, разводка не тронута
    J24 СБРОС (NRST), J25 ДАТЧИК (РЕЗЕРВ) PA2, J26 РЕЗЕРВ ВЫХОДЫ PD13 PD15, J27 РЕЗЕРВ PA5 PA7.
    Добавлены в разведённую плату: старые 1425 дорожек закреплены, новые цепи — Freerouting + свой
    волновой трассировщик по картам меди, в плату — только новое. PD12/PD14 не выведены (внутренний
    ряд P1, путь ~150 мм с 9–10 переходами). DRC 0, ERC 0, CHECK.md 0 замечаний,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
2026-11-12 feat(display): 7" JC1060P470 — три прошивки в релизе; режим с экрана во время подачи — отказ, как у галетника
    - ELS_Display_P7: JD9165 (Espressif), таблицы панелей V1/V2 из ESPHome, тач GT911, поворот 180°, шрифты ×32/15
    - env jc1060p470 / _v2 / _v3 (ESP32-P4 rev 3), make_release — пять файлов дисплеев
    - STM32: тип дисплея 70 разрешён; в релизе несовпадение типа — без алерта
    - TOUCH:M*/S* при Joy_Z_flag/Joy_X_flag — отказ и возврат текущего режима (BACKLOG-038)
    - BACKLOG-036: DRO после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
2026-11-12 docs(windows): прошивка и сборка под Windows по шагам с картинками; дисплей собирается без wifi_config.h
    - docs/windows/README.md: готовая прошивка с GitHub (STM32CubeProgrammer, esptool-js), своя сборка в VS Code +
    PlatformIO, 9 примеров настроек els_config.h / wifi_config.h, какой файл для 7"
    - tools/docs_gen/windows_shots.py: схемы окон, настоящие строки кода, снимки esptool-js
    - gcode_wifi.cpp: без локального wifi_config.h берётся шаблон (свежая копия исходников не собиралась)
    Co-Auth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
2026-11-12 feat(display): подсказка «галетник: …», когда переключатель стоит не там, где режим с экрана; AFEED int32
2026-11-12 tools: монитор входов через ST-Link — на Discovery PA9 занят VBUS, USB-UART может молчать
2026-11-12 feat(display): плитка «УПОРЫ» на большом экране, проверка тача; fix: барабан при таймауте правки; TEST_CASES актуальны
2026-11-13 docs(manual): конус и шар по шагам со снимками автоцикла; заметки про 4.3" и 7"
2026-11-13 release: v0.3.0 — 7" JC1060P470, инструкция под Windows, галетник и экран
2026-11-13 docs(windows): настройки станка задаются на экране и сохраняются — пересборка не нужна; без Full chip erase
2026-11-13 fix(display): убран демо-режим (тройное «ОК») — работал плохо и мог включиться случайно
2026-11-13 docs(readme): два GIF дисплея 10.1" в работе — режимы и настройки
